paulforrester/horloge-astronomique/docs/decisions.md

# Decisions

Phase 0 deliverable. One record per decision Paul needs to make. Each record gives the options,
the trade-offs and a recommendation. Status is **Proposed** until Paul approves; then it becomes
**Accepted** with the date, and the record is kept, never deleted. Tags as in
`docs/reference-notes.md`.

**As of 31 Oct 2026 every decision D1–D11 is Accepted.** D2, D5 and D11 were decided point by point;
the rest were approved as recommended. **D12** (wooden case) was accepted on 1 Nov 2026.
**D13** (steel springs) was accepted on 3 Nov 2026. **D14** (the shows on legal time) and **D15**
(the procession: astronomy and time, with Urania) were accepted on 4 Nov 2026. **D16** (motors plug in
from behind) was accepted on 5 Nov 2026.

## Summary

| ID | Decision | Recommendation / decision | Status | Needed before |
|---|---|---|---|---|
| D1 | CAD toolchain | **build123d** (Python, pinned), own gear library; OpenSCAD + BOSL2 as fallback | **Accepted** 31 Oct 2026 | Phase 2 |
| D2 | Strasbourg-faithful vs Bordeaux-localized | **Accepted: Strasbourg time** (noon show at 12:29 CET / 13:29 CEST) **plus Bordeaux sky** (horizon 44.83° N, globe on Bordeaux sidereal time). One sub-question on the horizon offset. | **Accepted** 31 Oct 2026 | v1.5 (sky parts) |
| D3 | Controller, drivers, RTC, event motors | **ESP32-S3 + TMC2209 (UART)** for the clock *and* the test rig, all bought new; DC gearmotors for events | **Accepted** 31 Oct 2026 | Phase 2 test rig / Phase 3 |
| D4 | Tooth profile, module, arbors, tubes, bearings | **Involute 20°**, module 1.0 / 0.8 as parameters; Ø3/5/8 ground rod; 0.45 mm-wall brass tubes in 1 mm steps; small standard bearing set | **Accepted** 31 Oct 2026 | Phase 1 |
| D5 | Scope of v1 vs deferred | **Accepted (b)**: v1 has steady-speed Sun and Moon, full Gregorian calendar, planets, Moon globe, sidereal globe and all automata; **v1.5** equations, eclipses, sunrise/sunset; **v2** computus. **Upgrade path required** (architecture §13). | **Accepted** 31 Oct 2026 | Phase 1 |
| D6 | Case construction and mounting | **Aluminium-extrusion module rack inside a birch-ply/MDF case**, printed ornament, hinged glazing; **floor-bearing plinth plus wall restraint** | **Accepted** 31 Oct 2026 | Phase 2 |
| D7 | Computus: faithful vs own design | Defer to v2. **Faithful now looks feasible**: Ungerer (ELS i4–i5) describes the epact snail and the great rack | **Accepted** 31 Oct 2026 | v2 |
| D8 | Sound | **Real small bells struck mechanically**; **rooster: copy Schwilgué's bellows and paper-reed crow** (fully described by Ungerer), with a speaker as fallback | **Accepted** 31 Oct 2026 | Phase 2 (E-modules) |
| D9 | Legal-time hands and summer time | **Separately driven legal-time hands that follow CET/CEST** (M1b) | **Accepted** 31 Oct 2026 | Phase 2 (M1) |
| D10 | Night silence | **Quiet hours in firmware** (skip sound shows). The original already silences the four ages at night [S: DA]. | **Accepted** 31 Oct 2026 | Phase 3 |
| D12 | Case and frame in wood (fine woodworking); revises D6's structure | **Option B**: plywood carcass + hardwood framing; joinery for the table saw, track saw and drill press (no router); MDF for painted surfaces; one species from the low or moderate class (tulipier, sapelli or sipo preferred); metal hidden except the computus frame | **Accepted** 1 Nov 2026 | Phase 2 (case) |
| D11 | Case width (7.70 vs 8.60 m) and wall space | **1:8 accepted (PR #1)**. **Width resolved: 7.70 m → 962.5 mm** [S: ELS, Ungerer 1920]. Wall dimensions to follow from Paul | **Accepted** 31 Oct 2026 | Phase 2 (case) |
| D13 | Springs: steel or printed; catalogue springs in inch-based sizes | **Steel for every spring**; Sodemann's stainless catalogue springs accepted although their sizes are inch-based | **Accepted** 3 Nov 2026 (PR #8) | Phase 2 (M2 purchase) |
| D14 | When the shows run: mean time or legal time (revises D2 item 2) | **Legal time**: the quarters at :15, :30, :45 and :00 of CET/CEST, the noon show at 12:00 | **Accepted** 4 Nov 2026 (Paul, PR #11) | Phase 2 (M1) |
| D15 | The noon procession: Christ and the Apostles, or a personal set | **Astronomy and time**: twelve figures from Pythagoras to Einstein pass **Urania**, on the original's mechanism | **Accepted** 4 Nov 2026 (Paul, PR #11) | Phase 2 (E3) |
| D16 | How a stepper is reached for service | **Plug-in from behind**: each motor on a printed adapter plate, held by 2 × M3 into heat-set inserts; its drive part slides on the D-shaft and is held by stops | **Accepted** 5 Nov 2026 (Paul, PR #13) | every stepper module (M1 and M2 done) |
| D-next (firmware) | Controller and firmware, Phase 3 gate (F1–F10 in `docs/firmware-design.md` §14) | **F2–F10 as recommended**: PCA9685 + DRV8833 event drive (E2 walk on native PWM), RV-3028-C7, phase restored at power-up, separate 6 V motor rail, quiet hours 22:00–07:00 (ages, genie, Death), Arduino IDE / `arduino-cli`, faulted shows off until acknowledged, `sensors:`/`events:` in `spec/clock.yaml`, the simulator plan. F1: a carrier PCB drawn in KiCad, after a bench prototype | **Accepted** 8 Nov 2026 (Paul, PR #19 and chat) | Phase 3 |
| D-next (E1) | The genies: motors, selector, link | **One forward-only gearmotor with a count wheel** (10 strokes, then 10 silent turns that turn the glass); a rigid cross shaft behind M1; the sceptre arm strikes the hand bell; a Scotch yoke, rack and pinion turn the forearms and glass; make-up strokes alone before the next show after a fault | **Accepted** 8 Nov 2026 (Paul, PR #18 and chat) | Phase 2 (E1) |
| D-next (M5–M7) | Mean time: Strasbourg or Bordeaux (revises D2 items 1 and 5) | **Bordeaux mean time**, "the sky over this house"; the shows stay on legal time (D14) | **Accepted** 8 Nov 2026 (Paul, PR #20) | Phase 3 (firmware constant) |

Plus **Blockers** at the end: the network allowlist and the documents to obtain.

---

## D1 — CAD toolchain

**Status: Accepted** (Paul, chat, 31 Oct 2026: "I approve D1, D3, D4 and D6–D10"). The recommendation below is the decision.

**Context.** CAD must be code-based and parametric, run headless in the cloud, export STL/3MF for
Bambu Studio, and produce something SketchUp can open (Paul's trimesh/pycollada → `.dae`
pipeline). Each was verified in this environment on 31 Oct 2026; full results are in
`tools/toolchain-check/README.md`.

| Criterion | A. OpenSCAD + BOSL2 | B. CadQuery | C. build123d |
|---|---|---|---|
| Installs and runs headless here | ✔ apt 2021.01; BOSL2 via git | ✔ pip (CadQuery 2.8) | ✔ pip (0.13, OCP 8.0.1) |
| Installs on an Apple Silicon Mac | ✔ (official macOS builds) | probably: `cadquery-ocp` 8.0.1 has arm64 wheels, but the OCP version CadQuery 2.8 pins was not checked | ✔: `cadquery-ocp-novtk` arm64 wheels on PyPI for Python 3.11–3.14 (checked) |
| STL / 3MF | ✔ / ✔ | ✔ / single shape only | ✔ / ✔ (several named parts) |
| STEP (for CNC or laser-cut case parts, sharing) | ✘ | ✔ | ✔ |
| Exact interference check (rule: "report intersecting volumes") | mesh only | ✔ B-rep | ✔ B-rep: 0.0000 mm³ when correct, 19.78 mm³ when the centre distance is 1 mm short |
| `.dae` with named nodes | via STL + Python | ✔ Python | ✔ Python (verified) |
| Gear library | **BOSL2 gears: mature; backlash, profile shift, racks, worms, bevels, ring gears** | none in core (`cq_gears` is not on PyPI) | `bd_warehouse` spur gears, **no backlash parameter**, so we write our own |
| Speed (60/15 gear pair) | 7.8 s (CGAL) | — | 1.6 s |
| Speed (269 teeth + 6 holes) | 16 s | — | 27 s |
| Same language as the ratio tool, simulator and DAE pipeline | ✘ | ✔ | ✔ |
| Paul's experience | ✔ (word clock) | Python ✔ | Python ✔ |
| Maturity | stable but slow release cycle | stable | active; 0.x API still changes, so pin versions |

**Recommendation: C (build123d)**, pinned in `requirements.txt`, Python 3.12+.

- **Why.** One Python codebase reads `spec/clock.yaml`, generates the parts, runs the exact
  interference and bed-fit checks, and writes STL, 3MF, STEP and DAE. The ratio tool and simulator
  live in the same language.
- **The cost.** We write `cad/lib/gears.py`: involute with backlash as tooth thinning, profile
  shift, internal and rack forms; about a day's work in Phase 2. It is validated tooth-by-tooth
  against BOSL2's output, which is installed here for exactly that.
- **Never install CadQuery and build123d in the same environment.** Their OCP builds conflict
  (`ImportError: TColgp_HArray1OfPnt`, verified).
- **Fallback: A.** OpenSCAD + BOSL2 is the quickest route to good gears and Paul knows it. It loses
  STEP and exact interference volumes and splits the codebase in two languages.

---

## D2 — Strasbourg-faithful vs Bordeaux-localized

**Context.** The gear trains are identical either way. Localization changes only:

1. **The mean-time offset.** A firmware constant (the stepper phase). Strasbourg: LMT = UT +
   31.00 min, so mean noon is 12:29 CET. Bordeaux: UT − 2.28 min, so mean noon is 13:02 CET /
   14:02 CEST [D].
2. **When the automata run.** They follow mean time, so this follows (1). The original runs on
   Strasbourg mean time [Sn: CATH].
3. **The sunrise/sunset cam profile.** A printed part made from latitude φ: Strasbourg about
   48.58° N, Bordeaux 44.83° N.
4. **The celestial globe's horizon ring tilt.** A printed part, or an adjustable one.
5. **The legal-time offset.** Mean time to CET is 29.0 min for Strasbourg, 62.3 min for Bordeaux
   [D].

| Option | For | Against |
|---|---|---|
| A. Faithful Strasbourg | The famous "12:30" noon show; replica in the strict sense | Sunrise/sunset and globe are wrong for the room; the local sky is the point of the instrument |
| **B. Bordeaux-localized** | Shows the truth where it hangs. Precedent: R. B. Smith localized his 1:5 model to Sydney [S: WIKI, PH]. | Noon show at 13:02 CET / 14:02 CEST, not 12:30 |
| C. Mixed (Strasbourg times, Bordeaux sky) | — | Inconsistent; not recommended |

**Recommendation: B.**

**Revised by D14 (4 Nov 2026):** item 2 no longer applies. The automata follow legal time, and the
noon show is at 12:00 CET/CEST.

- The dial lettering and appearance follow the original.
- Items 3 and 4 are swappable printed parts generated from φ, so a Strasbourg set can be printed
  later.
- Item 1 is a single firmware constant.

**Question for Paul:** is the 12:30-ish noon show important to you? If so, choose A for time and
consider B for the sky (which is C).

**Paul's input (PR #1 comment, 31 Oct 2026):** "The noon show is important."

Read as: keep the show at Strasbourg's time. **Items 1, 2 and 5 are therefore Strasbourg.**

- Mean time = UT + 31.00 min.
- Noon show at 12:29 CET / 13:29 CEST.
- Legal-time offset 29.0 min [D].

**Revised recommendation for items 3 and 4: A (fully Strasbourg).** Once the dials run on
Strasbourg mean time, sunrise/sunset times and a globe horizon for Bordeaux on those dials would be
a mixture (option C). That is harder to read and to validate.

**Paul's decision (chat, 31 Oct 2026):** "I'd prefer to use the Bordeaux sky as the reference
point."

**Status: Accepted, option C.** Time is Strasbourg (items 1, 2, 5); the sky is Bordeaux (items 3, 4).

**What "Bordeaux sky" means in the design:**

- **Sunrise/sunset (I7).** The mobile horizon (Schwilgué's own device [S: DA p. 31]) is computed for
  φ = 44.83° N, with refraction, as the original does for Strasbourg.
- **Celestial globe (I16).** The horizon ring is tilted for 44.83° N. The globe's rotation phase is
  set to **Bordeaux local sidereal time**, which is Strasbourg's minus 33.3 min [D: longitude
  difference 8.32°]. This is only M6's setting offset: no gear changes. The globe then shows the
  sky actually above the house.
- **Sub-question for Paul.** The main dial runs on Strasbourg apparent time. Do you want the mobile
  horizon:
  - **(i)** symmetric about the dial's noon, so it reads Bordeaux day length in local solar time;
    or
  - **(ii)** turned by the 33.3 min longitude difference, so the Sun hand crosses it at the moment
    the Sun really rises and sets in Bordeaux?

  **Recommendation: (ii)**, because the Sun hand above the horizon then means "the Sun is up
  outside". It is one fixed angle in the linkage, so the choice can wait until v1.5.

  **Paul's decision (chat, 31 Oct 2026): (ii).** The horizon is offset by the longitude
  difference of 33.3 min [D]. **Accepted.**

---

## D3 — Controller platform, stepper drivers, RTC, event motors

**Status: Accepted** (Paul, chat, 31 Oct 2026: "I approve D1, D3, D4 and D6–D10"). The recommendation below is the decision.

**Context.**

- 4 steppers in v1, up to 6 later (architecture §3).
- 5–6 one-direction event motors.
- About 27 digital inputs.
- RTC, FRAM, Wi-Fi/NTP, and MQTT for Home Assistant.

Step rates are very low (about 1 Hz running, a few kHz catching up).

| Option | For | Against |
|---|---|---|
| **A. ESP32-S3 + TMC2209 stepsticks (UART) on a carrier**, with 2 × MCP23017 I/O expanders | One MCU; Wi-Fi, NTP and MQTT built in; Paul knows ESP32; plenty of capacity; low power | Needs a carrier board: off-the-shelf or a custom PCB (Phase 3). TMC2209 UART has 4 addresses per bus, so 6 drivers need 2 buses. |
| B. Raspberry Pi + motion board (BTT SKR Pico: RP2040, 4 × TMC2209; or Octopus: 8 drivers) with custom firmware | Robust 24 V power stages, connectors, MOSFET outputs; Linux for UI and logging | Two computers to maintain; SD-card wear; STM32duino has no stock Octopus variant, so a custom one is needed [Sn] |
| C. Arduino Mega + RAMPS 1.4 + TMC2209 | 5 driver sockets; endstop inputs; 3 MOSFETs | No network (no NTP or Home Assistant); 8-bit; awkward TMC2209 UART wiring on RAMPS; only 5 drivers. Its only advantage, reusing parts Paul already owns, is dropped: the BOM buys everything new (PR #1). |
| D. Printer board standalone (Octopus / Spider / Manta, 8 drivers) + ESP32 for the network | 8 drivers and a power stage on one board | Same two-MCU complexity as B; firmware support for a non-printer use is DIY |

**Recommendation.**

- **A for the clock.** Firmware has a board-independent motion core (P1 time law, events, FRAM
  state) plus a thin board layer.
- **The Phase 2 test rig uses the same platform.** An ESP32-S3 dev board and one or two TMC2209s
  from Batch 1 of the BOM. Those parts later move into the clock, so the firmware is exercised on
  the real target from the first print.
  - The earlier "Mega + RAMPS for the test rig" recommendation is withdrawn after Paul's PR #1
    comment: no parts from other projects.
- **Drivers:** TMC2209 in StealthChop, with low hold current (quiet in a living space).
- **RTC:** RV-3028-C7 with a supercapacitor (about ±1 ppm [Sn]), or a DS3231 (±2 ppm [Sn]). If a
  DS3231 module is used, remove or disable its charging diode when fitting a non-rechargeable
  CR2032 [Sn].
- **FRAM:** I²C, 32–256 kbit.
- **Event motors:** small DC gearmotors (Pololu micro-metal class, e.g. 100:1 [Sn]), each with a
  locking-cam microswitch and a DRV8833-class H-bridge. This is the electrical analogue of a
  striking train.
  - Alternative: 28BYJ-48 steppers on TMC2209. They are smoother and quieter but use 6 more
    drivers.
  - Decide per show in Phase 2 after a noise test.

---

## D4 — Gear tooth profile, default module, arbors, coaxial tubes, bearings

**Status: Accepted** (Paul, chat, 31 Oct 2026: "I approve D1, D3, D4 and D6–D10"). The recommendation below is the decision.

**Tooth profile.**

| Option | For | Against |
|---|---|---|
| **Involute 20° (ISO 53 basic rack)** | Tolerant to centre-distance error (printed plates); standard; BOSL2 reference for validation; works in both driving directions | Undercut below 17 teeth without profile shift |
| Cycloidal (horological, e.g. NIHS / BS 978) | Traditional; good for wheel-drives-pinion step-ups with low-count pinions | Sensitive to centre distance; little printed-gear precedent; harder to validate |

**Faithfulness note:** Schwilgué's teeth are **epicycloidal**. He built "une machine servant à
déterminer automatiquement la forme épicycloïdale des courbes des dents" [S: ELS i5]. The replica
still uses involute, for the printing and centre-distance reasons above. This is a deliberate
deviation, invisible behind the dials.

**Recommendation: involute 20°**, with these parameters:

- profile shift for z < 17;
- minimum pinion 10–12 teeth (shifted);
- backlash 0.15 mm as a parameter, applied as tooth thinning split between the mates;
- face width 4 mm by default and 6 mm in the motor stages, as parameters.

**Default module.** Use `CLAUDE.md`'s working defaults as parameters: **1.0** with the 0.4 mm nozzle,
**0.8** with the 0.2 mm nozzle.

- Use 0.8 where density demands it (main dial, planetary coaxials) and 1.0–1.25 in the motor
  reductions.
- The real minimum comes from the local tolerance test.
- Largest wheel that fits the bed [D], before brim margin:

| Bed axis | Module 1.0 | Module 0.8 |
|---|---|---|
| 320 mm (single nozzle) | 318 teeth | 398 teeth |
| 300 mm (dual nozzle) | 298 teeth | 373 teeth |

- Schwilgué's 269- and 270-tooth wheels fit at 1.0: 271–272 mm tip.
- 382- and 420-tooth wheels need module ≤ 0.8 or a segmented rim.

**Arbors** (metric ground rod; few sizes, to consolidate purchases).

- **Ø3** for light and dial trains, **Ø5** general, **Ø8** for motor reductions and large outputs.
- Silver steel to DIN 175 is ground to **h9** [Sn: DIN]; that is fine for plain bearings and
  printed hubs.
- Where a tighter fit is needed, use linear shafting: g6 below 6 mm, h6 from 6 mm [Sn: MISUMI].
- EU source: Ameco (CZ) [Sn]. The UK sellers (Thomas Graham) add post-Brexit customs.

**Coaxial tubes.** Brass tube with **0.45 mm wall in 1 mm OD steps** (e.g. Albion Alloys BT3M…BT10M
[Sn]; Conrad 6, 7 and 9 mm [Sn]). Each tube's ID is n − 0.9 mm, so the next size down slides inside
with **0.10 mm diametral clearance** [D].

- So a Ø3 arbor carries up to 7 coaxial tubes, out to Ø10 mm.
- Brass on brass with clock oil at these speeds is the traditional clockmaking practice.
- Larger coaxial groups (calendar ring, planet arms beyond 7) run on thin-section bearings with
  printed hubs.
- Albion has no French stockist yet, only UK and one DE eBay seller [Sn]. Confirm EU supply before
  Phase 2.

**Bearings** (standard set).

| Use | Bearings |
|---|---|
| Ø3 arbors | MR63ZZ, 3×6×2.5 |
| Ø5 arbors | MR85ZZ (5×8×2.5) or 685ZZ (5×11×5) |
| Ø8 arbors | 688ZZ, 8×16×5 |
| Large coaxial outputs | 6700-series (10×15×4 … 20×27×4) or thin-section 61806 (30×42×7) and 61808 (40×52×7) [Sn] |
| Slow arbors | Plain bearings: sintered bronze to ISO 2795 [Sn], igus iglidur sleeves [Sn], or brass tube on steel |

- Design bearing seats from **measured** parts: cheap MR85s have measured 7.93 mm OD rather than
  8.00 [Sn]. This goes into the local tolerance phase.

**Fasteners.**

- Stainless A2, M3 by default; M2 and M2.5 for small parts; M4 and M5 for structure.
- Screws to ISO 4762, 14580 and 7380.
- Brass heat-set inserts (ruthex M2–M5 [Sn]).
- Hubs on rods: clamping hubs with an insert and screw. Press-fit and retaining-compound variants
  go into the tolerance test.

---

## D5 — Scope: v1 vs deferred

| Version | Contents | Why |
|---|---|---|
| **v1** | M1 time and releases (I1, I2); M2 main dial with **mean** Sun and Moon, shadow disc, calendar ring with automatic leap day (4-year rule), weekday carousel; M5 planets and Moon globe; M6 sidereal globe; all automata E1–E4 | A complete, running clock with every visible motion |
| **v1.5** | M3 equations vitrine → apparent Sun and true Moon; eclipse arm (I5); sunrise/sunset (I7) | They depend on M3 and the main-dial feasibility study. The v1 main dial *provisions* them: differentials locked, tubes reserved, cam positions free. |
| **v2** | M4 computus + E5; movable feasts arc (I9); dominical-letter drive (I10); Gregorian century leap exception (next one in 2100); precession drive (I17) | The computus mechanism is undocumented (D7) and is the biggest single design task. The precession is nearly static (about 1.4° per century [D]). |

**Recommendation:** as above, with one change after research pass 3. **The Gregorian century
rule moves into v1.** Schwilgué's calendar applies it with a small, self-contained wheel C (1/100 turn
per year, 24 projections, plus a satellite wheel for the 400-year case) [S: ELS i4]. It costs little
and keeps the calendar correct beyond 2100 without the computus.

- The **main-dial feasibility study** (Phase 2) must still include every v1.5 and v2 element, so
  nothing is designed out.
- **Question for Paul (rephrased after PR #1):**

  **Background.** The real Sun and Moon do not move across the sky at a steady speed. A sundial
  runs up to about 16 minutes fast or 14 minutes slow over the year (the "equation of time"). The
  real Moon can be about 6° ahead of or behind its average position. Schwilgué corrects both with
  the cams in the "equations" vitrine, so his main dial shows the *true* Sun and Moon.

  **The choice:**
  - **(a) Corrections in the first working version.** The main dial is right from day one, but
    the first working clock arrives later, because the equations vitrine (M3) must be designed and
    printed first.
  - **(b) Steady (average) speeds first.** The first working version has the Sun and Moon hands
    moving at steady speeds. The main dial is built from the start with the slots for the
    corrections, and the equations vitrine is added in v1.5 without rebuilding anything. The
    first working clock comes sooner.

  **Recommendation: (b).** Which do you prefer?

**Paul's decision (chat, 31 Oct 2026): (b), steady speeds first,** "but ensure that the design
allows for the module to be adapted without scrapping too much to add more precision later".

**Status: Accepted, with a binding upgrade-path requirement.** The v1 design must meet the
provisions in `architecture.md` §13. In short:

1. Both main-dial hands are driven through their **differentials from day one**. In v1 the
   correction input is locked at zero by a removable key.
2. The **correction-input interface is fixed now**: shaft size, coupling, location and gain. M3 can
   then be designed or redesigned later without touching M2.
3. The **space, rails, wiring and driver channel for M3 are reserved** in the case and the
   electronics.
4. M3 is designed as **stacks with spare cam positions**, so more terms can be added later without
   rebuilding.
5. **Internal gear trains are swappable cassettes** behind fixed module interfaces, so any train
   can later be replaced by a more precise one without rebuilding the module.

---

## D6 — Case construction and mounting

**Status: Accepted** (Paul, chat, 31 Oct 2026: "I approve D1, D3, D4 and D6–D10"). The recommendation below is the decision. Wall material and dimensions are still to come from Paul; the fixing design follows them.

**Revision proposed (1 Nov 2026):** Paul wants the frame built in wood (fine woodworking), so the
*structure* part of this decision (option B, the aluminium-extrusion rack) is reopened in **D12**.
The *mounting* part (floor plinth plus wall restraint) and the glazing stand until D12 is decided.

**Context.**

- Estimated envelope 2.25 × ~1.0 × ~0.25 m. Depth TBD: at least 200 mm interior planned
  (envelope §1).
- Mass about 78–103 kg [E, envelope §5].
- Stone wall; enclosed, climate-controlled room; glazed front.

**Structure.**

| Option | For | Against |
|---|---|---|
| A. Birch-ply box, modules screwed to shelves | Cheap, classic woodwork | Module alignment depends on the woodwork; less serviceable |
| **B. Aluminium-extrusion module rack (20 × 20 / 20 × 40 metric profile) inside a birch-ply / MDF case**, with printed ornament | Precise, square, adjustable mounting for modules (P4); the wood is decorative and can be built later; wiring clips onto the slots | Two structures; extrusion cost |
| C. Fully printed case tiles | All in-house | Hundreds of print-hours, weaker, joint lines; wasteful for flat panels |

**Mounting.**

| Option | For | Against |
|---|---|---|
| (i) Wall-hung on a French cleat with chemical anchors in stone | "Wall art"; floor free | About 100 kg in shear and pull-out on anchors in stone of unknown quality; needs a fixing-design check |
| **(ii) Floor-bearing plinth + wall restraint brackets** | The floor carries the weight; the anchors only prevent tipping; easy to level | Uses floor space (a plinth about the case footprint) |

**Recommendation: B + (ii).**

- MDF for painted flat surfaces, birch ply for structure.
- Printed PLA ornament; PETG for clamped or structural printed parts.
- Hinged glazed doors per stage. Acrylic (about 8 kg) rather than glass (about 22.5 kg) for the
  front [D], with brush or foam dust seals.
- **Question for Paul:** what is the wall made of (e.g. Bordeaux limestone, rubble), and is a
  plinth acceptable?

---

## D7 — Computus: faithful reconstruction vs our own mechanical design

**Status: Accepted** (Paul, chat, 31 Oct 2026: "I approve D1, D3, D4 and D6–D10"). The recommendation below is the decision.

**Context.**

- Schwilgué's computus is an enlarged version of his 1821 prototype [S: RGL]. The prototype is
  about 300 parts [Sn: EXO].
- Its full study is unpublished [S: RGL].
- How it makes the Gregorian corrections and finds Easter is undocumented in every source reached
  so far.

| Option | For | Against |
|---|---|---|
| A. Faithful reconstruction | Authentic | Needs sources not yet available (Roegel's study, Flores 2007, Bach/Rieb); may never be complete |
| B. Our own mechanical Gregorian computus (count wheels, century wheels, rack-and-snail Easter finder), same displays | Can start any time; validated against a standard algorithm over 400 years in the simulator; still fully mechanical (rule 2) | Not Schwilgué's mechanism |

**Recommendation:** defer to v2 (D5) and buy or borrow the Flores 2007 book in the meantime.

**Update (research pass 3):** Ungerer's 1920 lecture (ELS i4–i5) describes the computus in some
depth:

- the epact disc with a stepped snail, 4 mm per step, covering 21 March–18 April;
- piece N and cam x, on the golden-number arbor, for the epact XXV/25 rule;
- the great rack R that reads the snail;
- the Easter-dependent feasts carried on an iron circle on rollers.

So **option A (faithful) is now realistic for v2**, filling any gaps from Flores (2007) and Bach/Rieb.

- If, when v2 starts, the mechanism is still undocumented, choose **B**, with the same displays
  and the same once-a-year New Year's Eve operation.
- In both cases, design the v1 calendar ring with the feasts-arc groove and the leap gate
  (inventory I8, I9).

---

## D8 — Sound

**Status: Accepted** (Paul, chat, 31 Oct 2026: "I approve D1, D3, D4 and D6–D10"). The recommendation below is the decision.

**Context.** The original strikes real bells, and the rooster is mechanical and pneumatic
[S: CLEA]. The replica is in a living space.

| Option | For | Against |
|---|---|---|
| **Real small bells, cam-lifted hammers (bell angel, ages, Death)** | Faithful; mechanical; pleasant | Bell sourcing and tuning; volume set by the hammer |
| Bells via solenoids | Simple | Not a mechanical event train; clicky |
| Rooster: bellows and reed driven by the E4 train | Faithful in spirit | Hard to make sound like a rooster; development time |
| **Rooster: speaker plus a recording (DFPlayer-class), cued by the E4 train switch** | Convincing, volume-controllable | Not mechanical |
| No sound | Silent | Loses much of the charm |

**Update (research pass 3):** the original crow is fully described [S: ELS i5]. It sits under the
crown:

- a weighted bellows, inflated by a wire and released suddenly;
- a **paper-strip reed**, kept taut by a spring;
- a trumpet aimed at the rooster;
- a cam-controlled exhaust valve that makes the crow fall from strident to low.

All of it is mechanical and small.

**Revised recommendation:** mechanical bells; **build Schwilgué's bellows-and-reed crow** in v1,
driven by the E4 event train (a good local-phase prototype). Keep a speaker only as a fallback if
the 1:8 bellows cannot make a convincing sound.
Quiet hours apply to both (D10).

---

## D9 — Legal-time hands and summer time

**Status: Accepted** (Paul, chat, 31 Oct 2026: "I approve D1, D3, D4 and D6–D10"). The recommendation below is the decision.

**Context.** The original's silver hands show CET [S: WIKI]. Whether they follow summer time is
unresolved [?]. A forward-only drive can still follow summer time: +1 h in spring, +11 h in autumn
on a 12 h dial, run at catch-up speed in seconds.

| Option | For | Against |
|---|---|---|
| A. Fixed CET (offset hands on M1) | Simplest; no extra motor | Wrong by 1 h for 7 months a year |
| **B. Own stepper M1b following CET/CEST** | Always right; useful as the house clock | One more stepper and a coaxial drive on the mean-time dial |
| C. No legal-time hands | Simplest | Less useful; less faithful |

**Recommendation: B.** The automata stay on mean time regardless.

**Faithfulness note:** the original's legal-time (silver) hands were "ajoutées en Mars 1919"
[S: ELS i1]. They are not Schwilgué's, so adding a summer-time drive does not depart from his
design.

---

## D10 — Night silence

**Status: Accepted** (Paul, chat, 31 Oct 2026: "I approve D1, D3, D4 and D6–D10"). The recommendation below is the decision.

| Option | For | Against |
|---|---|---|
| A. Always strike | Faithful | Quarter strikes all night in a living space |
| **B. Configurable quiet hours: the controller skips sound shows** | Simple. P2 (state lives in the trains) makes skipping safe. | Figures do not move at night |
| C. Mechanical strike/silent levers (figures move, hammers held off) | Figures still move | One actuator per bell train |

**Recommendation: B**, configurable from Home Assistant, with C as a later option.

**Supporting evidence:** this is original behaviour. Schwilgué's central motor produces "la
suspension des fonctions des quatre âges pendant la nuit et la reprise de leur marche durant le
jour", while Death strikes the hours day and night [S: DA p. 58, 65]. So the minimal faithful setting
is to silence the four ages at night. The firmware option extends that to the other bells.

---

## D11 — Case width and wall space

**Context.** `CLAUDE.md` targets 0.96 m (7.70 m ÷ 8). New evidence [Sn: WIKI] suggests 7.70 m may
be the *first* clock's width. ODY's 8.60 m is given for the second clock, whose case is the
current one (reference-notes, Phase 0 additions).

| Option | Size |
|---|---|
| A. 1:8, 7.70 m | 2250 × 962.5 mm |
| B. 1:8, 8.60 m | 2250 × 1075 mm |
| C. Keep the width at 0.96 m by changing the scale to 1:9 (if 8.60 m is right) | 2000 × 956 mm; main dial 255.6 mm |

**Recommendation.**

1. Resolve the source first: read ELS and check Bach/Rieb.
2. Make **scale a parameter** in `spec/clock.yaml`, so no module design depends on it.
3. **Paul gives the available wall width, height and ceiling height.**

The choice can then wait until case design (Phase 2) without blocking anything.

**Paul's input (PR #1 comment, 31 Oct 2026):** "1:8th scale is not a problem." Wall dimensions
to follow.

**Source resolved (research pass 3):** "l'ancien édifice, construit en pierres de taille, de 7m,70
de largeur à la base, et de 18 mètres de hauteur, le couronnement gothique compris" [S: ELS i1,
Ungerer]. **The width is 962.5 mm at 1:8**, as `CLAUDE.md` assumed.

- **Status: Accepted. The scale is fixed at 1:8.** Option C (1:9) is dropped.
- The case width will be 962.5 mm or 1075 mm, whichever the primary source supports.
- Scale stays a parameter in `spec/clock.yaml` for tidiness, but no module needs to allow for
  another scale.

---

## D12 — Case and frame in wood (fine woodworking)

**Status: Accepted, option B** (Paul, PR #2 comment, 1 Nov 2026). It revises the structure part of D6. The answers to the questions and the resulting refinements are in "Decision and refinements" at the end of this record.

**Context.**

- Paul (1 Nov 2026): "I like the idea of 3d printing parts internally and for some visible parts,
  but I'd like to also look at building the frame out of wood (both sheet goods and hardwood are
  acceptable materials for this)."
- The original case is dressed stone: "l'ancien édifice, construit en pierres de taille"
  [S: ELS i1]. It is decorated with Tobias Stimmer's paintings and carved figures [S: DA p. 29,
  48, 61]. A wooden case is therefore an interpretation, chosen for the room and the maker.
- The gear meshes must stay precise. The wood must never set gear centre distances.

**Options.**

| Option | For | Against |
|---|---|---|
| A. Keep D6 as accepted: aluminium-extrusion module rack inside a decorative wooden case | Most precise and adjustable; wood purely decorative | Two structures; metal where Paul wants wood; least "fine woodworking" |
| **B. Plywood carcass as the structure, with hardwood framing, mouldings and doors** | Birch plywood is cross-laminated and stays flat and square, so it carries the modules. Hardwood goes where it shows: face frame, pilasters, cornices, frame-and-panel sides, door frames. A real woodworking project with predictable behaviour. | Module mounts must be adjustable (see design rules). More design work than A. |
| C. Solid-hardwood post-and-beam frame and panels throughout | The most "fine furniture" | Solid wood moves with humidity across its width. The most work and the most care needed to keep module mounts true. Heavier. |

**Recommendation: B.** Design rules:

1. **Precision stays inside the modules** (P4, P6). Each module is self-contained between its own
   printed or metal plates. The wood only *holds* modules; it never forms part of a gear train.
2. **Three-point adjustable mounts.** Each module sits on two locating pins, one round and one
   slotted, plus a third clamped fixing in a slot. The fixings go into threaded inserts set in the
   plywood shelves. So:
   - a module drops back into exactly the same place after servicing;
   - seasonal wood movement cannot strain it.
3. **Couplings between modules tolerate misalignment.** The shafts that cross module boundaries
   (M3→M2, M2→M7, M1→E2; architecture §4) use keyed, single-position couplings that also allow
   radial and angular float. Phase 2 sets the float, with a design target of about ±1 mm.
4. **Wood-movement rules for the hardwood parts.**
   - Frame-and-panel construction for every wide surface, with the panels floating in grooves.
   - No hardwood glued cross-grain to plywood over a wide span.
   - Quarter-sawn or rift-sawn stock where width matters.
   - The climate-controlled room helps, but these rules still apply.
5. **Sheet goods.** Birch plywood for the carcass, shelves and torsion-box plinth; MDF only for
   painted flat parts or routed profiles.
6. **Serviceability** (`CLAUDE.md`):
   - removable back panels on every stage;
   - hinged glazed front doors;
   - the wiring riser in the staircase tower, with channels routed in the carcass;
   - the electronics bay in the weight tower, ventilated, with a removable door.
7. **Ornament.**
   - **Routed or moulded hardwood** for cornices, pilasters and mouldings.
   - **3D-printed** (then painted or gilded) for Gothic tracery, pinnacles, finials, crockets and
     small figures.
   - Carved or CNC wood is optional for larger ornaments, depending on the tools available (see
     questions).
8. **Mounting.** D6 (ii) stands: a floor-bearing plinth plus a wall restraint. The mass will be
   re-estimated from the case model, since hardwood is heavier than the earlier ply-only estimate.
9. **Deliverables (cloud sessions).** A parametric case model in build123d (`cad/case/`), with:
   - joinery details;
   - cut lists and plywood sheet layouts;
   - DXF/SVG profiles for templates or CNC;
   - STEP files.

   The physical woodworking is done locally.

**Questions for Paul.**

1. **Workshop.** Which tools do you have? For example: table saw or track saw, router and router
   table, planer-thicknesser, jointer, bandsaw, CNC router, lathe for finials. The answer sets the
   joinery, and how much ornament is wood versus printed.
2. **Finish.** Natural hardwood (a cabinetmaker's interpretation), or painted to evoke the
   original's stone and painted panels, or a mix such as a natural frame with painted panels?
3. **Species.** Any preference among hardwoods readily found in France? For example oak (chêne),
   walnut (noyer), cherry (merisier), beech (hêtre), ash (frêne). The answer affects colour,
   weight and how well fine detail can be routed.
4. Under B the aluminium rack disappears entirely. Is that what you want, or would you keep a
   hidden metal sub-frame behind the main dial only?

### Decision and refinements (Paul, PR #2 comment, 1 Nov 2026)

Paul's answers (quoted, with typos corrected):

1. "I accept the D12 recommendation for option B."
2. Workshop: "tablesaw, tracksaw, drill press, planer, drum sander, miter saw and hand tools and
   chisels".
3. Finish: "painted and finished to resemble original".
4. Species: "any of the species are acceptable so long as they have similar expansion qualities.
   I'll be sourcing hardwoods in Bordeaux, so species should be available from local vendors."
5. Metal: "keep the metal frame elements hidden where possible. The exception being the Easter
   calculator."

**Revised rules.** They replace rules 4 and 7 above where the two differ; the other rules stand.

**R1 — Joinery for the workshop as it is.** There is no router, jointer, bandsaw, CNC or lathe.

| Task | How |
|---|---|
| Stock | Buy planed all round ("raboté 4 faces"), or straighten edges with a track-saw or table-saw jig and then thickness on the planer. The drum sander handles stock thinner than the planer allows. |
| Carcass | Birch plywood broken down with the track saw; dadoes and rabbets cut on the table saw in several passes. Check whether the saw takes a dado stack (many European saws do not). Glue and screw. |
| Frames | Mortise-and-tenon: tenons on the table saw; mortises bored on the drill press with Forstner bits and squared with chisels. Dowelled joints using printed drilling jigs are an alternative. Bridle joints on the table saw. Mitres on the mitre saw. |
| Frame-and-panel | Grooves on the table saw. Panels are flat MDF or plywood (painted), or table-saw-bevelled raised panels where one is wanted. |
| Mouldings (no router) | Built up from simple table-saw profiles (rips, bevels, coves cut by passing across the blade at an angle), laminated and stacked. Supplemented by stock mouldings from the merchant. Complex Gothic profiles are 3D-printed and painted. |
| Ornament | 3D-printed and painted or gilded: tracery, crockets, pinnacles, finials (no lathe), figures. Chisel carving is optional for a few details, in lime (see R3). |
| Precision holes | The module mounts (rule 2) are drilled on the drill press through **3D-printed drilling templates generated from the case CAD**, so every insert and locating pin lands where the model says. |

**R2 — Finish: painted to resemble the original.** The original case is dressed stone with painted
panels [S: ELS i1; DA].

- Use **MDF for most flat painted surfaces**: it is stable and paints well.
- Use hardwood where edges and joints need strength, and where moving parts or doors bear on the
  wood.
- Prime every surface. Open-grained or tannin-rich woods such as oak need grain filling and a
  stain-blocking primer before a smooth painted finish.
- The decorative painting itself (faux stone, Stimmer-style panels) is local work and outside the
  cloud sessions (`CLAUDE.md`).

**R3 — Species: one movement class, from local stock.** Movement across the width is driven
mostly by tangential shrinkage (T), and distortion by the T/R ratio.

Sourced values, green to oven-dry, from The Wood Database, which compiles them from cited
references [S, secondary]. Retrieved 1 Nov 2026 from `https://www.wood-database.com/<species>/`.

| Class | Species (French name) | Radial % | Tangential % | T/R | Density at 12 % MC, kg/m³ |
|---|---|---|---|---|---|
| **Low movement** | utile / sipo (*Entandrophragma utile*) | 4.9 | 6.9 | 1.4 | 635 |
| | sapele / sapelli (*E. cylindricum*) | 5.2 | 7.2 | 1.4 | 665 |
| | lime / tilleul (*Tilia* spp.) | 5.0 | 7.5 | 1.5 | 535 |
| | walnut / noyer (*Juglans regia*) | 5.5 | 7.5 | 1.4 | 640 |
| **Moderate** | yellow-poplar / tulipier (*Liriodendron tulipifera*) | 4.6 | 8.2 | 1.8 | 455 |
| | aspen / tremble (*Populus tremula*) | 4.8 | 8.3 | 1.7 | 450 |
| | pedunculate oak / chêne pédonculé (*Quercus robur*) | 4.7 | 8.4 | 1.8 | 675 |
| **Higher, or uneven** | black poplar / peuplier noir (*Populus nigra*) | 4.0 | 9.3 | 2.3 | 385 |
| | ash / frêne (*Fraxinus excelsior*) | 5.7 | 9.6 | 1.7 | 680 |
| | sessile oak / chêne rouvre (*Quercus petraea*) | 4.5 | 9.7 | 2.2 | 710 |
| | hornbeam / charme (*Carpinus betulus*) | 6.8 | 11.5 | 1.7 | 735 |
| | beech / hêtre (*Fagus sylvatica*) | 5.8 | 11.7 | 2.0 | 710 |

**Rule.**

- Use **one species** for all structural hardwood. If two species are glued together, take both
  from the same class.
- **First choice (paint-grade, low or moderate movement, machines well): tulipier, sapelli or sipo,
  whichever a Bordeaux merchant stocks planed.**
- Oak (chêne) is acceptable if that is what is available, but needs the grain and tannin
  preparation in R2.
- **Avoid beech, hornbeam, ash and black poplar** for frames and wide parts.
- Lime is the carving wood, for any chisel-carved details.
- Local availability is **TBD** (Paul sourcing in Bordeaux). An initial search found Gironde
  merchants but no confirmed stock list for any species [Sn].

**In-service movement estimate [E].** Width change ≈ W × T × ΔMC / FSP, where FSP ≈ 28 % is the
fibre saturation point. This is the standard linear approximation; verify against the Wood
Handbook (USDA FPL GTR-282, ch. 4).

- Assume moisture content varies by ±2 % in the climate-controlled room (an estimate, to be
  confirmed with a hygrometer in the room).
- Then a 100 mm flat-sawn board moves about ±0.5 mm in sapelli, ±0.6 mm in tulipier or pedunculate
  oak, and ±0.8 mm in beech.
- Hence the floating panels, and the slotted third fixing on every module mount (rule 2).

**R4 — Metal: hidden where possible; the computus is the exception.**

- Hidden metal is allowed where wood or print is not enough: for example a flat-bar stiffener
  behind the main dial, inserts, pins and brackets.
- **The computus (M4) gets a visible metal frame**, brass or steel plates and pillars, displayed in
  its vitrine. The original's computus train is on view: "Dans celle de gauche, on aperçoit le
  rouage du comput ecclésiastique" [S: ELS i1].
- Its gears remain printed (rule 1 in `CLAUDE.md`). Their finish, for example brass-toned, is a v2
  choice.
- The aluminium-extrusion rack of D6 option B is **not used**.

### Refinement R5: the clock works are printed and independent of the case (Paul, PR #5, 3 Nov 2026)

Paul: "I'd prefer to have the clock works printed where possible, even if that means connecting
multiple plastic pieces. I'm okay using model grade plywood internally as well if size and/or
strength would prohibit the use of 3d printed parts. The point is that I want the clock works to be
independent of the external decorative case. Bottom line. Print if possible, otherwise use model
grade plywood."

- **The works form their own structure.** That covers every module's plates, carriers, brackets and
  the internal frame that holds the modules together. It is printed, from several pieces bolted or
  spliced where one print is too large.
- **Model-grade plywood is only the fallback**, where size or strength rules out a print. Each such
  part is named, with the reason, in its module's design note.
- **The decorative case surrounds the works and never carries them.** Rules 1–3 still apply between
  the works and whatever finally bears the load (the plinth and wall restraint of rule 8): located,
  three-point, slotted.
- **First use: M2.** Its calendar carrier is a printed frame of 4 PETG segments with an L-section
  rim, bolted to the M2 front plate. It has mounting tabs for the works' frame and needs no plywood
  (`docs/m2-design.md` §6).
- **Files.** Every printed part gets an STL or 3MF that Bambu Studio imports, in its print pose
  (`cad/export_print.py`, `export/print/`). Every SketchUp model also gets an exploded copy where
  that is meaningful (`cad/export_sketchup.py`).

## D13 — Springs: steel, and an exception to the metric rule for catalogue springs

**Status: Accepted, 3 Nov 2026** (Paul, PR #8).

**Context.** The M2 setter and year counter need several small springs (`docs/m2-design.md` §6,
*Steel springs*). The first design printed some of them as plastic leaves: the rocker detent, wheel
C's jumper and the ring jumper. Printed plastic relaxes under a constant load over the years.

**Decision 1: every spring is steel.** Paul: "I'd rather go with steel springs. Please source and
spec the springs that you recommend."
- Catalogue springs where a coil spring fits: the set-ramp plunger and the counting-lever return.
- Straight spring wire (EN 10270-1 DH, Ø0.4 and Ø0.5) for the detents and the click, glued into
  printed blocks.
- A flexure that is unloaded at rest may stay printed: the counting lever's hook flexes once a
  year and is free the rest of the time.

**Decision 2: inch-based catalogue springs accepted.** Paul: "accept the sodemann springs".
- The two catalogue springs are Sodemann stock (Denmark, sold and shipped to France). They are
  listed in mm, but their sizes are inch-based (for example De 4.57 mm = 0.180").
- `CLAUDE.md` asks for metric sizes. Paul accepts this exception because no standard part mates
  with a spring, so nothing else in the design depends on its size.
- The metric alternatives, Gutekunst VD-011Y and RZ-020I, could not be verified from the cloud
  session.
- **Scope:** springs only. Rods, tubes, bearings and fasteners stay metric.

---

## D14 — When the shows run: legal time

**Status: Accepted, 4 Nov 2026** (Paul, PR #11). It revises D2 item 2.

**Context.**
- In D2 the automata follow the dial's Strasbourg mean time, so the noon show runs at 12:29 CET
  (13:29 CEST), as in Strasbourg today.
- Paul: "I'd like the show to happen at noon, not 12:30. Lets set P1 = 15 minutes past the hour,
  P2 to the 30 minutes past, P3 to 45 minutes past, and P4 to be on the hour. I think that's closer
  to the original design intent."
- In 1842 local mean time was the town's civil time, so Schwilgué's shows ran at civil noon.

**Decision.**
- Every show follows **legal time (CET/CEST)**:
  - the four quarters at :15, :30, :45 and :00;
  - Death's count is the legal hour;
  - the noon show is at 12:00.
- The gold hands still show Strasbourg mean time, and the silver hands legal time (D9).

**Consequences.**
- The quarter, hour and noon releases sit on the legal-time train, M1b, not on M1
  (`docs/m1-design.md`; architecture §5).
- Whatever holds E2's state (M1 concept gate, decision 1) follows legal time too.
- **The autumn change runs +23 h, not +11 h.**
  - The 24 h noon wheel is on the legal train. +11 h would leave it 12 h out.
  - +23 h is −1 h on the 24 h wheel and on the 12 h dial.
  - The spring change stays +1 h. Both are forward-only, at catch-up speed, with the shows
    suppressed.
- Quiet hours (D10) are in legal time, the house's time.

## D15 — The noon procession: a personal set of figures

**Status: Accepted, 4 Nov 2026** (Paul, PR #11): "I like your suggestion of astronomy and time, with
Urania in the centre. Time and the stars have a nice synergy with this clock. I also agree that
death and the ages still belong, as do the angels." So theme A below, with Urania. The twelve are
the recommended list; any can be swapped from the alternates before E3 is designed. Death, the
four ages and the genies stay as on the original.

**Context.**
- The original's noon show is the twelve Apostles passing Christ, who blesses each
  (`docs/mechanism-inventory.md` A5).
- Paul: "I'd like to change Jesus and the Apostles. I'm not religious and I think we can do
  something here to personalize the clock … famous figures through history (Plato, Copernicus,
  Newton, Pythagoras, Einstein, etc.). Or famous composers … I think we can remove the Jesus figure
  completely unless you can think of something to insert there."

**What stays.**
- E3's mechanism is unchanged: twelve figures on a track, each turning to the central figure and
  facing forward again, and the central figure's arm gesture.
- The rooster crows after the 4th, 8th and 12th figure, so the twelve fall naturally into three
  groups of four.

**Options** (for the PR #11 discussion; the figures need no numbers, so no tags):

| Theme | Central figure | The twelve, in three groups of four |
|---|---|---|
| **A. Astronomy and time** (recommended) | **Urania**, muse of astronomy, already painted on the original's weight tower; she lowers a star or laurel to each figure | *Antiquity:* Pythagoras, Plato, Hipparchus (precession, the globe's slowest motion), Hypatia. *The new astronomy:* Copernicus (the planetary dial is Copernican; his portrait is on the original), Tycho Brahe, Kepler (the equation of centre the cams compute), Galileo. *Time and the modern era:* Huygens (the pendulum clock), Newton, Schwilgué (the clock's maker), Einstein. |
| B. Composers | Euterpe, muse of music; or none | Paul's Mozart, Beethoven and Saint-Saëns, with others in three periods of four |
| C. No central figure | — | Either set; each figure turns to the audience instead |

**Recommendation: A, with Urania.** It suits an astronomical clock: most of its figures stand for
something the clock itself shows. It keeps the original's gesture, and both Urania and Copernicus
already appear on the original's painted panels. Alternates for any slot include Ptolemy, Ulugh
Beg, Harrison (the marine chronometer), Caroline Herschel and Hubble. Each figure carries an
attribute (a telescope, a pendulum, an armillary sphere), so it reads at 57 mm.

## D16 — Motors plug in from behind

**Status: Accepted, 5 Nov 2026** (Paul, PR #13: "Lets go with option A for the motors").

**Context.**
- Architecture §11: "Motors are reachable without removing gears".
- The first M1 model did not meet that. Each motor was screwed to the back plate from inside the
  cassette, and its drive gear was pressed on its shaft between the plates. M2 is built the same
  way. Changing a motor meant pulling the hands, lifting the dial and opening the cassette.
- The options are in `docs/m1-design.md` §10:
  - A, plug-in motor (+4 mm depth);
  - B, arbor and coupling (≈ +30 mm);
  - C, keep as modelled.

**Decision: A.**
- **Adapter.** Each stepper is screwed to a small printed adapter plate at the bench (4 × M3 × 6,
  heads in counterbores).
  - A boss on the adapter's face locates it in a pocket in the back plate.
  - Two M3 × 8 screws from behind hold it, into heat-set inserts in the plate.
- **Drive part.** It slides on the motor's D-shaft and stays in the cassette when the motor is out.
  - Its spigot passes through the back plate and stops on the adapter's boss.
  - A post on the front plate stops it from the front.
  - Both stops have the endshake `E` (0.3 mm [E]).
- **To change a motor:** undo two screws from behind and draw the motor and adapter straight out.
  To refit it, turn the shaft until its flat finds the drive part's D-bore.

**Consequences.**
- The motors sit 4 mm further back.
- The drive is a slip fit on the D-flat, so it has a little backlash. It stays taken up, because
  the steppers turn forwards only (CLAUDE.md rule 3).
- M1 has this from PR #13.
- M2 has it too. Its 12-tooth motor pinion is small enough to come back through the back plate's
  Ø22.5 hole, so it stays pressed on the shaft and leaves with the motor. M2 needs no stops in the
  module (`docs/m2-design.md` §2, `cad/lib/motor_mount.py`).
- New modules (E2's state stepper, M5, M6) start with it.

## D-next (firmware) — Controller and firmware: the Phase 3 gate

**Status: Accepted, 8 Nov 2026** (Paul, PR #19: "F2-F10. approve your recommendations."; F1 in chat: "Lets plan for your approach of you drawing the board in KiCad").
The options and trade-offs are in `docs/firmware-design.md` §14; this record lists the outcome.

| # | Decision | Outcome |
|---|---|---|
| F1 | How the controller is built | A bench prototype first, then a carrier PCB with plug-in modules, drawn in KiCad in the cloud. Hobby perfboard stays the fallback. Maker to choose at order time (Aisler recommended) |
| F2 | Event-motor drive | One PCA9685 switching DRV8833 bridges, one channel per motor (on or brake, no audible PWM); E2's walk on a native PWM pin at ≥ 20 kHz |
| F3 | RTC | RV-3028-C7 with a supercapacitor, trimmed from NTP |
| F4 | Motor phase through a power cut | Restore it at power-up (TMC2209 datasheet method: step with ENN high until MSCNT matches), confirmed on the rig; hold-up capacitor footprint kept as a fallback |
| F5 | Power rails | 24 → 5 V for logic; a separate 24 → 6 V rail for the event motors |
| F6 | Quiet hours | 22:00–07:00 legal time; the ages, the genie and Death silent; settable from Home Assistant. Since E2's racks are released by the walk train (PR #21), Death is silent whenever the ages are |
| F7 | Toolchain | Arduino IDE 2 with the Arduino-ESP32 core; `arduino-cli` for headless builds. This supersedes "PlatformIO project" in architecture §12 |
| F8 | Faults and the door | A faulted show stays off until acknowledged; an open door skips the shows (E5 and E6 still run) |
| F9 | Sensor and event data | New `sensors:` and `events:` sections in `spec/clock.yaml`, append-only |
| F10 | Simulator | The plan and error budgets of `docs/firmware-design.md` §11, with Skyfield and DE440s as the reference |
## D-next (M5–M7) — Mean time: Strasbourg or Bordeaux (revises D2)

**Status: Accepted, 8 Nov 2026** (Paul, PR #20: "We are basing the localtime on Bordeaux, not
Strasbourg", then "I'd prefer to use the 'the sky over this house' approach"). The number is
assigned when the PR merges.

**Context.**
- D2 set the dials' time to **Strasbourg** mean time (items 1, 2 and 5) because "the noon show is
  important", and only the sky (sunrise/sunset, the globe) to Bordeaux.
- D14 has since moved every show to legal time, so the noon show no longer depends on mean time.
- The mean-time offset is one firmware constant (architecture P1). No gear, cam or printed part
  depends on it [D: a search of `cad/`, `spec/`, `firmware/` and `sim/` finds it only in a
  comment in `cad/modules/m1_time/mechanism.py`].

**Decision: Bordeaux mean time for the whole clock.**
- Mean time = **UT − 2.28 min** [D: D2, Bordeaux longitude]. Mean noon is 13:02 CET / 14:02 CEST.
- So the gilt mean-time hands (M1), the main dial's apparent time, Sun and Moon hands (M2), the
  calendar ring's midnight and the weekday carousel (M7) all refer to Bordeaux.
- The globe (M6) was already on Bordeaux sidereal time; unchanged.
- **D2's sub-question (ii) falls away.** The mobile horizon no longer needs the fixed 33.3 min
  longitude offset: dial and sky are now on the same meridian, so it is symmetric about the dial's
  noon and still means "the Sun is up outside".
- The shows stay on legal time (D14): quarters on the quarter, noon show at 12:00 CET/CEST.

**Consequences.**
- The gilt hands read 1 h 02 min behind legal time in winter and 2 h 02 min in summer
  (Strasbourg's would be 29 min and 1 h 29 min). The silver legal-time hands (M1b) are unchanged.
- The calendar ring and the carousel change over at Bordeaux mean midnight: 01:02 CET, 02:02 CEST.
- The replica's gilt hands read 33.3 min behind the cathedral's. Accepted for consistency.
- Documents that still say "Strasbourg mean time" or "12:29" (D2, `docs/m1-design.md`,
  `docs/e2-design.md`, the inventory, the reference notes) are left as their owners wrote them;
  this record supersedes them. The firmware's mean-time constant is set from this record in
  Phase 3. M7's 33.3 min setting offset becomes zero (`docs/m7-design.md` §9).
- **Firmware (merged from PR #19 after this record was drafted).** `docs/firmware-design.md` sets
  the mean-time modules to τ = UTC + 1860 s (Strasbourg). Under this decision it becomes
  **τ = UTC − 137 s** [D: −0.57° × 240 s/° = −136.8 s; Bordeaux house at 0.57° W,
  `docs/reference-notes.md` and `tools/phase0/derivations.py`]. The longitude should be refined to
  the house's own coordinates. That edit belongs to the firmware track; it is flagged on PR #20.

## D-next (E1) — The genies: one motor and a count wheel

**Status: Accepted, 8 Nov 2026** (Paul, PR #18 and chat). The options and trade-offs are in `docs/e1-design.md`
§5–8 and §13–15; this record lists the outcome.

| # | Decision | Outcome |
|---|---|---|
| 1 | Motors | One event motor for both genies ("truer to the original design") |
| 2 | Selector | A count wheel, 1:20 on the bell shaft: ten strokes, then ten silent turns (a silencing cam) in which a mutilated gear turns the glass. The motor runs forward only |
| 3 | Link to the glass | A rigid Ø5 cross shaft behind M1, below M1's motor adapters |
| 4 | The strike | The genie's arm holding the striker moves and strikes the real bell in its hand |
| 5 | The glass | Scotch yoke, rack and pinion; the forearms turn with the glass, in the facade plane, in about 3 s |
| 6 | Sizes and parts | Figures 78 mm; E1's bell a little lower than E2's (sized or chosen by ear); a bought miniature hourglass |
| 7 | Night | The glass turns when Death strikes; since PR #21 that is when the ages run |
| 8 | After a fault in mid-cycle | The missing strokes run alone a minute before the next quarter (at E2's resync) |

**Consequences.** The event-motor count drops to 7 + 1 (BOM). Quiet hours must skip whole cycles (:15 … :00) to
keep E1's count; the firmware's F6 window should start after a :00 show and end before a :15 show.

## Blockers (not decisions, but they need Paul)

**1. Network access for research.** This session could reach only package registries and GitHub.
Only Paul can change this, in the environment settings; a PR comment or chat message cannot.

**Update, 31 Oct 2026:** Paul widened access. The shell can now reach most hosts. Read in full
since then: Schwilgué's *Description abrégée* (1844, archive.org). Still not obtainable
automatically:

| Host | Problem |
|---|---|
| `bibnum.publimath.fr` (LEF) | Answers 403 to automated clients |
| `clea-astro.eu` (CLEA) | Does not resolve |
| `www.elsolieltemps.com` (ELS), `gallica.bnf.fr`, `www.cathedrale-strasbourg.fr` | Bot protection (403) |
| `upload.wikimedia.org` (photos) | Rate-limited (429) during this session; retry later |

Circumventing bot protection is not acceptable, so **Paul, please download LEF, CLEA and ELS by
hand** (links in reference-notes, Sources).
The fix is in the cloud environment settings: environment menu → Edit → Network access, either a
broader level or these hosts added under *Allowed domains*, with "Allow package managers" left
ticked. Docs: https://code.claude.com/docs/en/cloud-environments#network-access.

| Purpose | Hosts |
|---|---|
| Key PDFs | `clea-astro.eu`, `bibnum.publimath.fr`, `www.elsolieltemps.com` |
| Primary books and prints | `books.google.com`, `play.google.com`, `gallica.bnf.fr`, `numistral.fr`, `archive.org`, `web.archive.org`, `babel.hathitrust.org`, `www.digitale-sammlungen.de` |
| Photos for envelope scaling | `commons.wikimedia.org`, `upload.wikimedia.org`, `en.wikipedia.org`, `fr.wikipedia.org`, `de.wikipedia.org` |
| Official data | `www.cathedrale-strasbourg.fr`, `pop.culture.gouv.fr` (Palissy PM67000355) |
| Computus study | `comput1821.github.io`, `roegeld.github.io` |
| Purchasing checks | `fr.rs-online.com`, `www.gotronic.fr`, `www.3djake.fr`, `fr.misumi-ec.com`, `www.123roulement.com`, `www.chronos.ltd.uk`, `eshop.ameco.cz` |

**2. Documents to obtain, in priority order.**

1. Ch. Schwilgué, *Description abrégée…* (public domain; Google Books id `LGYEyPW9ZWQC`).
2. The full ELS, CLEA and LEF PDFs. Paul could download them on the Mac and commit them under
   `docs/sources/`, if their licences allow.
3. Flores 2007 (Klinghammer computus).
4. Bach, Rieb & Wilhelm 1992.
5. Ungerer (1920s–1954 editions).
