paulforrester/horloge-astronomique/docs/reference-notes.md

# Reference notes — Schwilgué's Strasbourg astronomical clock

Facts gathered before the repo existed (31 Oct 2026). Each entry gives a source. Tags:
**[S]** sourced, **[D]** derived (calculation shown), **[E]** estimate, **[?]** conflicting or
unclear. Add to this file as research continues; never remove a source.

**[Sn]** (added in Phase 0) means *search-snippet only*. The wording came back from a web-search
tool, but the page itself could not be opened because the cloud session's network policy blocked
the host. Treat [Sn] facts as leads: confirm them on the page before any design depends on them.
Phase 0 additions are in the section "Phase 0 additions" at the end of this file.

## Sources

| Key | Source |
|---|---|
| ELS | Description of the current clock, early 1920s lecture to the Société astronomique de France — https://www.elsolieltemps.com/pdf/gnomonica/157.pdf (site blocks automated fetch; facts below are from search snippets only — **read the full PDF**) |
| CLEA | Paturel & Dubois, "L'horloge astronomique de la cathédrale de Strasbourg revisitée", Cahiers Clairaut n°102 (2003), based on Bach & Rieb — http://clea-astro.eu/archives/cahiers-clairaut/CLEA_CahiersClairaut_102_02.pdf |
| LEF | Jean Lefort, "L'horloge astronomique de la cathédrale de Strasbourg" (gear mathematics, after Ungerer 1922) — https://bibnum.publimath.fr/IST/IST93039.pdf |
| WIKI | https://en.wikipedia.org/wiki/Strasbourg_astronomical_clock |
| TS | https://www.techno-science.net/fr/definitions/horloge-astronomique-de-strasbourg (mirror of French Wikipedia) |
| LOC | https://local-fr-public.s3.eu-west-3.amazonaws.com/prod/webtool/userfiles/27520/Horloge_astronomique.pdf |
| ENS | https://www.ens-lyon.fr/RELIE/Cadrans/Musee/HorlogesAstro/General/PagesGr/StrasbourgGr.htm |
| AMIS | https://www.amis-cathedrale-strasbourg.eu/2023/03/04/gunther-oestmann-lhorloge-astronomique-de-la-cathedrale-de-strasbourg/ |
| ODY | https://odysseum.eduscol.education.fr/lhorloge-de-strasbourg-decrite-par-frischlin |
| MERP | https://aulavirtual.cui.edu.ar/blog/merpmonde/754105609878700032-the-best-timepiece-in-the-world-imo-strasbourg (visitor blog) |
| PH | Powerhouse Museum Strasburg Clock model — https://artsandculture.google.com/story/EQVhvcQV07ffKQ |
| TELL | Fully printed tellurium — https://www.printables.com/model/288152-mechanical-orrery |
| H2D | https://bambulab.com/es/h2d/tech-specs |

## Overall dimensions

- Case kept from the 16th-century clock: **18 m tall, 7.70 m wide at the base** [S: ELS]. The case
  is three storeys with a spiral staircase, 18 m tall [S: AMIS].
- **[?]** ODY gives 18 m × **8.60 m** for the second clock. Using 7.70 m (ELS describes the current
  clock specifically). Resolve with Bach/Rieb if possible.
- Main apparent-time dial: the Sun hand travels on a dial **2.30 m** in diameter [S: ELS].
- Apostle figures about **18 inches** (~46 cm) tall [S: WIKI, citing an 1896 source].
- Second clock's celestial globe (now in a museum, *not* the current one): 83 cm [S: ODY]. The
  current globe's diameter is **unknown**.
- At 1:8 [D]: height 2.25 m; width 0.9625 m; main dial 287.5 mm; Apostles 57 mm. Day-of-year ring
  on the main dial ≈ π × 287.5 / 365 ≈ 2.5 mm per day.

## Layout, bottom to top [S: CLEA unless noted]

- **Left tower:** contains the drive weights — five weights of 50 kg each. Topped by the rooster
  automaton, which crows at noon while flapping its wings, using a mechanical and pneumatic system.
  It crows and flaps at the passage of the 4th, 8th and 12th Apostles [S: LOC].
- **Celestial globe**, at floor level in front of the case: positions of constellations and main
  stars; includes precession of the equinoxes (one turn in about 26,000 years); sidereal time is
  shown [S: CLEA].
- **Computus** mechanism at the bottom left of the clock [S: TS]; the **solar and lunar equations**
  vitrine is on the other side of the base [S: MERP says the two modules are on either side of the
  base; CLEA names the "Equations solaires et lunaires" vitrine].
- **Main (lower) dial:** apparent motion of the Sun and Moon around the Earth at the centre; sunrise
  and sunset times; solar and lunar eclipses; days of the week; the date of Easter. A black disc
  opposite the Sun represents Earth's shadow. The Moon's rod has variable length so the Moon can
  eclipse the Sun or enter the shadow only when appropriate. Around the edge: every day of the
  year, each preceded by its dominical letter. A dial on the left shows the current year's
  dominical letter. A mechanism behind the dial inserts the day marked "Pâques" in the right place
  and adds a day in leap years.
- **Computus displays:** epact, dominical letter, indiction, solar cycle (28 years), golden number
  (19 years).
- **Weekday carousel** above the main dial: Apollo (Sunday), Diana (Monday), Mars, Mercury,
  Jupiter, Venus, Saturn (Saturday).
- **Mean solar time dial** for Strasbourg (about 30 min different from legal time). Beside it, one
  cherub turns an hourglass **[?]** "every hour (or every quarter)", and the other rings a bell
  every quarter. TS: one angel rings a bell while the second turns an hourglass.
- **Heliocentric planetary dial:** Mercury, Venus, Earth (with Moon), Mars, Jupiter, Saturn.
- **Moon-phase globe** above the planetary dial.
- **Top stages:** the four ages (child, adolescent, adult, old man) pass before Death every quarter
  hour; ENS assigns quarter→child, half→adolescent, three-quarters→man, hour→old man. At noon the
  twelve Apostles pass before Christ and the rooster crows three times.
- Gold hands show mean solar time; silver hands show Central European Time [S: WIKI]. The automata
  run on the clock's own (local mean) time, so the noon show happens at 12:30 legal winter time
  [S: TS, LOC]. Strasbourg mean time is about 31 min ahead of Greenwich [S: ELS snippet].
- A meridian line inside the cathedral, lit through an opening in a side door, is used to check the
  clock against true solar noon [S: CLEA].

## Drive and regulation [S: CLEA]

- Seconds-beating pendulum; drift claimed not to exceed 40 s per year.
- Temperature-compensated pendulum; a compensating spring mechanism keeps torque at the escape
  wheel almost constant.
- Tooth profiles designed to roll rather than rub.

## Schwilgué's gear data

### Yearly motion and planets [S: CLEA; D: arithmetic verified in Python]

- Year: P = (156 × 188 × 269) / (9 × 10 × 10) — source states 365.2422.
  **Note [D]:** as printed, the expression evaluates to 8,765.813, which is 365.2422 × 24. So it
  appears to count turns of an arbor turning once per hour, or a factor of 24 is missing in the
  source. Verify.
- Planet periods = P × factor:

| Planet | Factor | Period [D] | Accepted (CLEA) |
|---|---|---|---|
| Mercury | (44×134)/(240×102) | 87.97 d | 87.97 d |
| Venus | (17×221)/(197×31) | 224.70 d | 224.70 d |
| Mars | (95×213)/(203×53) | 686.93 d | 686.98 d |
| Jupiter | (157×232)/(96×32) | 11.857 yr | 11.86 yr |
| Saturn | (161×212)/(58×20) | 29.424 yr | 29.46 yr |

### Moon [S: CLEA; D: verified]

- Lunar turns per year = (312/24) × [1 − (83×14)/(122×196)] = 12.368267, via a differential.
  Synodic month = P / 12.368267 = 29.53059 d.
- The tilt of the lunar orbit is handled by an inclined toothed wheel [S: CLEA].

### Sidereal motion [S: LEF; D: verified]

- Schwilgué's tropical year: 365 d 5 h 48 min 48 s = 31,556,928 s. Required ratio
  R = 164,359 / 164,809 (164,359 = 13 × 47 × 269; 164,809 is prime-heavy and awkward).
- **Exact method (celestial sphere):** epicyclic train with a/A = 45/72, b/B = 18/270,
  c/C = 18/269, d/D = 26/100, e/E = 18/94. Output per turn of B =
  1 + (100/26)(18/94)[(270/18)(18/269) − 1] = 1 + 450/164,359 = 1/R exactly.
  (Reconstructed from garbled PDF text; arithmetic checks exactly.)
- **Approximate method (Moon motion):** 271,375 / 272,118 ≈ R (error ~1 s per century per LEF),
  realised ×12 because the driving arbor turns once in 2 h:
  (334/28) × (65/341) × (300/57) = 11.96723 = 12 × 271,375/272,118 (verified exactly).

### Solar and lunar equations [S: LEF, CLEA]

- Each periodic correction is a cylinder carrying its curve traced over two periods; a horizontal
  crossbar rides on it. The cylinders are stacked, each resting on the crossbar below, so the top
  crossbar's height equals the sum of all corrections. Largest corrections at the top. Pinions get
  longer the higher their cylinder sits, to allow for the vertical movement [S: LEF].
- The summed movement reaches the Sun or Moon motion through pulleys/rods to a pivoting frame
  (a differential arrangement) [S: LEF], or by raising/lowering a pinion with oblique teeth that
  speeds up or slows the wheel [S: CLEA].
- The Sun needs three corrections; the Moon uses five [S: LEF]. Lunar terms, driven by an arbor
  turning once per mean day (86,400 s):

| Term | Target period | Ratio used | Period obtained [D verified] |
|---|---|---|---|
| Anomaly | 27 d 13 h 18 m 34 s | 70209/2548 | 27 d 13 h 18 m 33.3 s |
| Evection | 31 d 19 h 29 m 11.453 s | 74090/2329 | 31 d 19 h 29 m 11.3 s |
| Variation | 29 d 12 h 44 m 3 s | 51649/1749 | 29 d 12 h 44 m 2.9 s |
| Annual equation | 365 d 6 h 13 m 57 s | 226461/620 | 365 d 6 h 13 m 56.1 s |
| Nodes (draconitic) | 27 d 5 h 5 m 35.8 s | 49880/1833 | 27 d 5 h 5 m 35.8 s |

- **Eclipses:** a cam turning in about 18.6 years lengthens or shortens the Moon hand so it passes
  in front of the Sun disc or not; a similar mechanism handles lunar eclipses [S: LEF].

### Tooth-count practice [S: LEF]

- Wheels limited to about 500 teeth for weight and strength; largest found 420. Largest prime tooth
  count 281 (also 269); composites such as 382, 341, 334, 327, 318. Minimum 6 teeth; smallest prime
  used alone 17.
- Schwilgué chose rational approximations whose factors are small primes (≤ 269), using continued
  fractions and Farey sequences.

## Computus [S: TS, LEF, WIKI]

- Probably the first mechanical Gregorian computus: designed 1816, model presented 1821.
- At the end of each year it determines the movable feasts for the coming year.
- Frédéric Klinghammer built a reduced replica of the computus in the 1970s.
- **Detailed mechanism not yet documented here** — research needed.

## Precedents

- Richard Bartholomew Smith built a working 1:5 model (1887–1889), now at the Powerhouse Museum,
  Sydney; he worked from a postcard and a book and localized dials to Sydney [S: WIKI, PH].
- A fully printed, crank-driven tellurium on Printables shows date with a mechanical year counter,
  Moon phases, apogee/perigee and the lunar nodes. Synodic month 29.5313 d vs 29.5306 d; nodal and
  apsidal cycles (18.5 and 8.8 yr modelled) from near-equal tooth pairs 39/37 and 39/44. Its
  instructions say to approach any date from the same direction to cancel play [S: TELL].

## Printing constraints

- H2D build volume 325×320×325 mm single nozzle; 300×320×325 dual; nozzles 0.2–0.8 mm [S: H2D].
- FDM with 0.4 mm nozzle struggles below module 1.0
  [S: https://www.sovol3d.com/blogs/news/3d-printing-gears-that-actually-work-backlash-orientation-and-material-tips].
- Rule of thumb: module ≈ 4 × nozzle diameter; backlash 0.1–0.3 mm, 0.15 mm a good first guess
  [S: https://makerworld.com/en/models/3276583-parametric-internal-ring-gear-generator].
- Gear tolerance test card, modules 0.5–1.5, 0.4 and 0.2 mm nozzle versions
  [S: https://makerworld.com/models/2221699].
- PLA clock gears reported running ~10 months (~40 M ticks) without noticeable wear
  [S: https://forum.prusa3d.com/forum/original-prusa-i3-mk3s-mk3-how-do-i-print-this-printing-help/printing-tiny-gears-3mm-1cm-from-nylon].

## Location data

- Bordeaux house ≈ 44.83° N, 0.57° W. Local mean time ≈ 2.3 min behind UTC [D], so local mean noon
  is about 13:02 CET in winter and 14:02 CEST in summer.

## Open items / unknowns (research before designing the related module)

- Current celestial globe diameter; planetary dial diameter; Moon-phase globe diameter; diameters
  of the mean-time and other dials.
- Size and layout of the computus and equations vitrines.
- Case depth and the globe's projection in front of it.
- Heights of the other figures (Christ, Death, the four ages, angels, weekday deities); rooster
  size.
- How sunrise and sunset are displayed mechanically on the main dial.
- How the day-of-year ring, Easter insertion and leap-year day work mechanically.
- The computus mechanism in detail.
- Rooster mechanism (mechanical + pneumatic) in detail.
- Resolve: hourglass turned hourly or quarter-hourly.
- Resolve: case width 7.70 m vs 8.60 m.
- Whether the full ELS PDF and the Ungerer / Bach-Rieb books are obtainable (BnF lists the Ungerer
  work; editions of 1949 and 1954 exist).

---

## Phase 0 additions (31 Oct 2026)

### How this research was done (read first)

The cloud session's network policy allowed only package registries and GitHub. Every other
source host was refused, both from the shell and from the fetch tool:

- the three key PDFs (`clea-astro.eu`, `bibnum.publimath.fr`, `www.elsolieltemps.com`);
- Wikipedia and Wikimedia Commons;
- `gallica.bnf.fr`, `archive.org`, `books.google.com`, `numistral.fr`;
- `pop.culture.gouv.fr`, `cathedrale-strasbourg.fr`;
- retailer sites.

So, apart from **RGL** below (read in full through its GitHub repository), every new fact in this
section is **[Sn]**. The hosts to allow for a follow-up research session are listed in
`docs/decisions.md` → "Blockers".

### New sources

| Key | Source |
|---|---|
| RGL | Denis Roegel, "Le comput ecclésiastique de Schwilgué (1821) — Étude et description complète", web page dated 21 Mar 2025 — https://comput1821.github.io/ (read in full from its source repo https://github.com/comput1821/comput1821.github.io, commit `45171af`) |
| CATH | Cathedral official site — https://www.cathedrale-strasbourg.fr/horloge-astronomique [Sn] |
| WCC | Wikipedia "Computus clock" — https://en.wikipedia.org/wiki/Computus_clock [Sn] |
| WSC | Wikipedia FR "Modèle de comput de Schwilgué" — https://fr.wikipedia.org/wiki/Mod%C3%A8le_de_comput_de_Schwilgu%C3%A9 [Sn] |
| KLH | Wikipedia "Klinghammer's computus" — https://en.wikipedia.org/wiki/Klinghammer's_computus [Sn] |
| EXO | Page on the 1821 computus model — https://exopuce.fr/comput/ [Sn] |
| BDM | Travel description — http://www.bouts-du-monde.com/1eu/htm/france/grand-est/horloge-astro.htm [Sn] |
| VDK | VdK Bayern trip programme (German) — https://bayern.vdk.de/uploads/user_uploads/events/5/2/698c35f53cd29-1770796533/Programm%204%20Tage%20Schwarzwald.pdf [Sn] |
| BFA | *Das Buch für Alle*, 1867, "Die astronomische Uhr in Straßburg" — https://epilog.de/die-astronomische-uhr-in-strassburg.buch-fuer-alle.1867 [Sn] |
| EQX | Review of G. Oestmann, *The Astronomical Clock of Strasbourg Cathedral*, J. Skyscape Archaeology 7(1), 2021, pp. 157–160 — https://journal.equinoxpub.com/JSA/article/view/19440 [Sn] |
| AHN | Astronomical Heritage entry — https://web.astronomicalheritage.net/show-entity?identity=33&idsubentity=1 [Sn] |
| PH-H | patrimoine-horloge.fr — https://www.patrimoine-horloge.fr/as-strasbourgcathedrale.html [Sn] |
| ASP | astroaspach PDF "Les trois horloges astronomiques de la Cathédrale de Strasbourg" — http://astroaspach.fr/astroaspachV2/wp-content/uploads/2015/12/les-trois-horloges-astronomiques-de-la-Cathedrale-de-Strasbourg.pdf [Sn] |
| MEEUS | J. Meeus, *Astronomical Algorithms*, 2nd ed., Willmann-Bell, 1998, ISBN 0-943396-61-1. Standard reference, used only for textbook formulae (equation of time, eq. 28.3). |

Bibliographic leads to obtain (not yet read):

- **Charles Schwilgué (son), *Description abrégée de l'horloge astronomique de la cathédrale de
  Strasbourg*.** This is the primary description.
  - First edition 1842; German edition 1844 [Sn: https://www.deutsche-biographie.de/sfz79786.html].
  - 5th edition 1852, held by the History of Science Museum, Oxford [Sn].
  - 7th edition, Dannbach 1854, 66 pp, on Google Books:
    https://books.google.com/books/about/Description_abr%C3%A9g%C3%A9e_de_l_horloge_astro.html?id=LGYEyPW9ZWQC [Sn].
  - 1844 edition: https://play.google.com/store/books/details?id=moADAAAAQAAJ [Sn].
  - **Highest-value document to read next. The 19th-century editions are public domain.**
- Th. Schweighaeuser, *Historische Notizen über die Astronomische Münsteruhr zu Strassburg nebst
  einer ausführlichen Beschreibung des mechanischen Werkes*, Strassburg, Hubert & Haberer, 1876,
  64 pp [Sn: antiquarian listing]. Its title promises a detailed description of the mechanism.
- F.-G. Edel, *Die astronomische Münsteruhr in Strassburg*, 1843 [Sn].
- Ungerer, *L'horloge astronomique de la cathédrale de Strasbourg*: BnF lists 1920 and 1926
  [Sn: https://data.bnf.fr/10380008/alfred_ungerer/de.pdf]. Oxford holds a 1949 printing and a 7th
  edition of 1954, revised by Ch. Ungerer and L. Leclerc
  [Sn: https://www.mhs.ox.ac.uk/collections/library/catalogue-simple/titles/?id=1937257].
  **[?]** The "1922" date in this file is so far supported only by a Scribd upload.
- Bach, Rieb & Wilhelm (1992), on Google Books (probably snippet view only):
  https://books.google.com/books/about/Les_trois_horloges_astronomiques_de_la_C.html?id=uu4fAQAAIAAJ [Sn].
- J. Flores, *Le comput ecclésiastique de Frédéric Klinghammer*, AFAHA, Besançon, 2007, 160 pp
  plus a CD, with contributions by D. Kleinknecht and M. Augereau (gear ratios). Reviewed by
  D. Roegel, *NAWCC Bulletin* 50/4, no. 375, Aug 2008 [Sn: KLH].
- Lefort's article (LEF) appeared in *L'Ouvert* n°70 (1993), pp. 27–47
  [Sn: https://wp.publimath.fr/auteur/lefort-jean].
- 1842 lithograph by Grieshaber from the Schwilgué workshop, 52 × 34.5 cm, Nancy municipal
  archives (Bach collection): https://recherche-archives.nancy.fr/printDoc/FRAC054395_2-3-102-103Fi_de-310 [Sn].
  - Michel Grieshaber reportedly made the detailed drawings for Schwilgué's clock
    [Sn: Roegel 2025, https://roegeld.github.io/stimmer/roegel2025stimmer-astronomy.pdf]. Archive lead.
- Period frontal prints: https://gallica.bnf.fr/ark:/12148/btv1b10202446r ("construite par J.B.
  Schwilgué. 1838 à 1842"), https://www.numistral.fr/ark:/12148/btv1b10202448n.item (1845) [Sn].
- Notes from a 2008 visit guided by J.-P. Rieb:
  https://association-philomathique.u-strasbg.fr/utilisateur/pages/references/sorties%202008/Horloge%20astronomique.pdf [Sn].
- https://cadranssolaires.com/wp-content/uploads/2025/10/horloge-astronomique-strasbourg.pdf (2025) [Sn].

### Dimensions

- **[?] The 7.70 m width may belong to the first clock, not the current case.** English Wikipedia
  (snippet), on the first clock (1352–54): "on the wall opposite the current clock … Supports for
  former balconies can still be seen today, and suggest that the height of the clock was about
  18 m (59'), with a width of about 7.70 m (25') at the base" [Sn: WIKI].
  - The current case is the second (Dasypodius, 1547–74) clock's case, which Schwilgué reused
    [S: ELS, per the "Overall dimensions" entry above].
  - ODY gives 18 m × **8.60 m** for that second clock.
  - So 8.60 m may be the relevant width for the current case. At 1:8 that is 1075 mm, not 962.5 mm [D].
  - **Unresolved.** Read ELS in full and check against Bach/Rieb.
  - Consequence: the 0.96 m envelope width in `CLAUDE.md` is at risk.
- LEF (snippet), on the early clock: "D'une hauteur totale de 11,70 m, l'horloge était installée
  dans une grande cage en bois scellée au mur. La partie inférieure présentait une façade carrée
  d'environ 4 m. de côté" [Sn: LEF]. This conflicts with Wikipedia's 18 m for the first clock [?].
- Wikidata Q2716513 gives the height as 28 m [Sn]. Probably an error. The same record gives the
  clock's Palissy ID **PM67000355**; that Monuments Historiques record may hold official
  dimensions (not yet opened).
- Second clock's globe:
  - 86 cm [Sn: WIKI];
  - "860 mm in diameter and set for the meridian of Strasbourg" [Sn: EQX];
  - enlarged to 83 cm [Sn: Roegel 2025].
  - **The current (Schwilgué) globe's diameter is still unknown.**
- Precession: "one of its gears completes a turn in 25,806 years" [Sn: CATH, tool paraphrase].
  CLEA says about 26,000 years.
- Celestial globe: "more than 5000 stars, extending down to faint sixth magnitude ones" [Sn: AHN].
- Figures: "18-inch high figures of Christ and Apostles process; a life-size rooster crows three
  times" [Sn: WIKI]. So Christ is also about 18 in, which is about 57 mm at 1:8 [D].
- **Old calendar ring (probably the second clock).**
  - About 2.92 m outer diameter, 30 cm wide, 366 sectors; the leap-year sector was moved by hand
    every four years [Sn: PH-H].
  - A "secular disc" about 2.32 m across, with 100 annual sectors [Sn: ASP].
  - The current ring's diameter is unknown. If it is as large as 2.92 m, its 1:8 size is 365 mm,
    which exceeds the H2D bed [D].
- 1821 computus model: "La cage du comput fait 15 cm de large sur 20 cm de haut pour une épaisseur
  de 6 cm. Il comporte environ 300 pièces dont la plupart sont des rouages dentés et des cames aux
  découpes complexes" (the frame is 15 × 20 × 6 cm, with about 300 parts, mostly toothed wheels
  and complex cams) [Sn: EXO].
- **Still not found:**
  - case depth and how far the globe projects;
  - diameters of the planetary dial, the Moon-phase globe, the mean-time dial and the computus and
    equation displays;
  - size of the weekday carousel;
  - heights of Death, the four ages, the angels and the weekday deities;
  - rooster size in centimetres.

### Automata

- **Hourglass: hourly (provisionally resolved).**
  - "L'un, avec un sceptre et une clochette, sonne le premier coup des quarts de l'heure ;
    l'autre, son vis-à-vis, retourne le sablier au dernier coup du quatrième quart" (one angel,
    with a sceptre and a hand bell, strikes the first stroke of each quarter; the other turns the
    hourglass at the last stroke of the fourth quarter) [Sn: BDM].
  - Agrees: "Jede Viertelstunde wird von einem Engel angeläutet, zur vollen Stunde dreht der
    Engel rechts neben ihm ein Stundenglas um" [Sn: VDK]; also [Sn: BFA].
  - Only tourist pages say "every quarter".
  - Confirm in Schwilgué's *Description abrégée*.
- **Four ages:** "un enfant au 1er quart d'heure, un jeune homme à la demi, un adulte au 3e quart
  d'heure et un vieillard à l'heure juste" (child at the first quarter, youth at the half, adult at
  the third quarter, old man on the hour) [Sn: TS]. This agrees with ENS.
  - Strokes per age of 1, 2, 3 and 4 are documented only for the 16th-century clock [Sn: Cambridge
    print PR-M-00005-00049-00014].
  - **TBD for the current clock:** strokes per age and which bells are used.
- **Death strikes the hours with a bone** [Sn: low-grade blog, https://ljgolden.substack.com/p/strasbourgs-astronomical-clock].
  Confirm.
- **Noon show.**
  - "le chant du coq rappelle, par trois fois le reniement de l'apôtre saint Pierre" (the cock
    crows three times, recalling St Peter's denial); the Apostles pass before Christ, who blesses
    them [Sn: CATH].
  - **[?]** The rooster crows at the 4th, 8th and 12th Apostle [S: LOC; Sn: TS], but one blog says
    "au passage de St Pierre" [Sn].
  - The rooster's pneumatic mechanism is not found. The only rooster mechanism described is the
    *medieval* rooster's, now in the Musée des Arts décoratifs. A hollow wooden body; one rod
    lifts the head, opens the beak, pushes out the tongue and lowers the tail; a second rod spreads
    the wings [Sn: https://www.fg-art.org/users_uploads/oeuvre_oeuvre_documents/60a630522eebc.pdf].
  - Show duration: no authoritative figure. The Commons video
    `File:Animation_of_the_astronomical_clock_of_Strasbourg.ogv` could be timed.
- **Weekday carousel [?, unconfirmed]:** "le carrousel tourne de façon continue et laisse
  apparaître devant, à midi, le char de la planète du jour courant" (the carousel turns
  continuously, bringing the current day's chariot to the front at noon) [Sn: source not
  identified].
- **Local mean time vs legal time.**
  - "All astronomical indications and chimes are set to local time"; in 1842 the dial showed only
    Strasbourg mean time [Sn: CATH, tool paraphrase].
  - **[?] Summer-time behaviour unresolved.** French Wikipedia says the noon show is "12 h 30 en
    heure d'hiver", but CATH says "tous les jours, à 12 h 30 précises".

### Computus

- **[S: RGL, read]** "l'horloge astronomique de la cathédrale de Strasbourg comporte aussi un
  comput ecclésiastique construit par Jean-Baptiste Schwilgué entre 1838 et 1842. Ce mécanisme
  ingénieux permet de déterminer les éléments du comput ecclésiastique (nombre d'or, cycle solaire,
  indiction, lettre dominicale et épacte) ainsi que la date de Pâques d'année en année. Ce mécanisme
  est en fait une version agrandie d'un prototype que Schwilgué avait construit en 1821". In
  English: the clock's computus (1838–42) determines the golden number, solar cycle, indiction,
  dominical letter, epact and the Easter date year by year, and is an enlarged version of
  Schwilgué's 1821 prototype.
- **[S: RGL] The 1821 prototype and its study.**
  - It was lost about 1945 and given to the cathedral's Fabrique at the end of 2021.
  - It was dismantled, measured, drawn, photographed and XRF-surveyed between December 2022 and
    April 2023 (Roegel, with J.-P. Rieb and L. Faullimmel).
  - Roegel's full documentation is **unfinished and unpublished**.
  - The page shows a 3D-model excerpt of one part, a large rack ("grand râteau"; repo files
    `xxx.gltf` and `img/comput1821-grand-rateau.jpg`).
- **When it runs: 31 December.**
  - The central calendar is perpetual, "automatically incorporating the leap day and all moveable
    feasts, including the complex calculation of Easter's date, which is performed on New Year's
    Eve by the ecclesiastical computus on the left" [Sn: CATH, tool translation].
  - "chaque année au 31 décembre, ... les dates de Pâques et des autres fêtes qui lui sont liées
    (Ascension, Pentecôte...) se placent sur le calendrier" (each 31 December, Easter and its
    dependent feasts take their places on the calendar) [Sn: AFP-type press story, attribution
    unclear].
- **What it shows.** Five ecclesiastical functions plus a four-digit year indicator [Sn: WCC]. The
  indiction is the Roman indiction [Sn: CATH].
- **The 1821 model** is advanced one year per turn of a hand crank at the back. Its seven dials
  are: Easter date (22 March–25 April), year, solar cycle 1–28, golden number 1–19, indiction 1–15,
  dominical letter and epact [Sn: EXO].
- The 1821 model lacks the parts that transfer the result to the clock's calendar. On the clock
  the Easter date is transferred to the central calendar ring [Sn: WSC]. This gives a natural
  split: core computus plus transfer train.
- **Klinghammer replica (1970s):** "nearly a reduced model of the computus found on the Strasbourg
  cathedral astronomical clock", restored by J. Flores in 2006–07 [Sn: KLH].
- **Not found:**
  - how the Gregorian solar and lunar equations (metemptosis, proemptosis) and the century
    leap-year rule are made mechanically;
  - the Easter-finding logic;
  - gear counts;
  - the drive from the computus to the calendar ring;
  - how the dominical-letter dial is set.

### Main dial

- **Calendar ring [?].** "Le calendrier est un anneau extérieur doré qui fait un tour par an.
  Apollon pointe avec sa lance le jour en cours … gradué en 366 secteurs" (a gilded outer ring
  turning once a year; Apollo points to the current day with his spear; 366 sectors) [Sn,
  attribution unclear].
  - Some sources have Diana pointing instead [?].
  - Unknown: whether the ring moves continuously or jumps at midnight.
- **Sunrise and sunset.** A photo record's metadata reads "Apparent Time; Sunrise; Sunset" and
  shows a pointer labelled "COUCHER DU SOLEIL" (sunset) [Sn: https://sourcelibrary.org/book/cathedrale-de-strasbourg-img-1241].
  This suggests labelled hands or sectors.
  - **Mechanism unknown.** Also unknown: which latitude it is set for.
- **Equations.** They "parfois accélèrent, ou parfois ralentissent la marche des aiguilles du
  soleil et de la lune" (sometimes speed up, sometimes slow down the Sun and Moon hands); they are
  in the right-hand case [Sn: ASP].
- **[?] An eclipse the clock reportedly showed.** "a, par exemple, indiqué clairement une éclipse
  de lune le 28 mars 2006" (the clock clearly showed a lunar eclipse on 28 March 2006) [Sn].
  Check this against the NASA/Espenak eclipse catalogue before using it as a validation case:
  there was a total *solar* eclipse on 29 Mar 2006 and a penumbral *lunar* eclipse on
  14 Mar 2006, so the snippet may be garbled.

### Location

- **Strasbourg Cathedral: about 48°34′55″ N, 7°45′02″ E (48.582° N, 7.7506° E).** These are the
  standard published coordinates (Wikipedia infobox), recalled rather than re-opened in this
  session, so verify them.
  - They give LMT − UT = +31.00 min [D], which agrees with ELS's "about 31 min" [S: ELS, snippet].
  - Used in `tools/phase0/derivations.py`.

### Open items — status after Phase 0

Status of each item in "Open items / unknowns" above, in the same order:

| Item | Status |
|---|---|
| Globe, planetary dial, Moon-globe and other dial diameters | Open. The 83/86 cm figure is the second clock's globe. Needs photo scaling (hosts blocked) or a primary source. |
| Computus and equations vitrine size and layout | Open. |
| Case depth; how far the globe projects | Open. |
| Figure heights; rooster size | Partly answered: Christ is also 18 in [Sn]; the rooster is "life-size" [Sn], no number found. |
| Sunrise/sunset display mechanism | Open. Labelled hands are likely [Sn]. |
| Day-of-year ring, Easter insertion, leap day | Partly answered: 366 sectors, one turn a year [Sn]; set by the computus on 31 Dec [Sn]. Mechanism open. |
| Computus mechanism in detail | Open. Best lead is RGL (unpublished), then the Klinghammer book and Bach/Rieb. |
| Rooster mechanism | Open. |
| Hourglass hourly or quarter-hourly | **Provisionally hourly** [Sn ×4]. |
| Case width 7.70 vs 8.60 m | **Worse than thought**: 7.70 m may be the first clock's width [Sn: WIKI]. Open. |
| ELS PDF and the Ungerer / Bach-Rieb books | ELS host blocked. Schwilgué's *Description abrégée* (public domain, Google Books) is now the top target. |

---

## Phase 0 research pass 2 (31 Oct 2026, after Paul widened network access)

### New primary sources

| Key | Source |
|---|---|
| **DA** | Charles Schwilgué (the builder's son), *Description abrégée de l'horloge astronomique de la cathédrale de Strasbourg*, 2nd edition, Strasbourg, Ph.-Alb. Dannbach, 1844, 70 pp. Public domain (archive.org: NOT_IN_COPYRIGHT; Google scan). https://archive.org/details/descriptionabrg00schwgoog. **Read in full** from the OCR text. Numbers that matter were checked against the page images (PDF page = printed page + 11). Page numbers below are the printed ones. |
| SCH | Charles Schmidt, *Bericht über das astronomische Uhrwerk des Straßburger Münsters, verfaßt bei Gelegenheit das Hrn. Schwilgué, Vater, durch seine Mitbürger gegebenen Feste*, Strasbourg, Dannbach, 1842, 27 pp. https://archive.org/details/bub_gb_cSlBAAAAcAAJ. The Fraktur OCR is unreadable; it needs proper OCR or a human reader. **Not yet used.** |

DA announces "une description complète, qui sera enrichie de dix planches" (a complete
description with ten plates) [S: DA p. 5]. **Lead:** find it.

### Facts from DA (verbatim; page)

**Case and history**

- First clock (1352–54): in the south transept "en face de l'horloge actuelle; on voit encore
  aujourd'hui, dans le mur, les consoles en pierre, qui ont servi à la soutenir" [p. 7–8]. This
  agrees with WIKI on where the first clock stood. DA gives no dimensions.
- Second clock: in 1547 the stonecutters were finishing "le cabinet qui sert encore à l'horloge
  actuelle" [p. 9]. So the current case is the 16th-century stone cabinet. DA gives no case
  dimensions.
- New clock begun 24 June 1838; first ran Sunday 2 October 1842; inaugurated 31 December 1842
  [p. 22]. "Entièrement de l'invention de mon père", reusing only some statuettes [p. 23].
- **"Il n'entre dans la construction de l'horloge aucune pièce de bois"** (no wooden parts) [p. 67].

**Celestial sphere** [p. 24–26]

- Sidereal time on a dial; copper sphere on four metal columns; "disposée pour la latitude de
  Strasbourg".
- More than 5000 stars of the first six magnitudes in **110** constellations (page image; the OCR
  reads "1 1").
- Turns east to west in a sidereal day, about 3 min 56 s shorter than the mean solar day.
- Equator, ecliptic and colures turn with it. Meridian and horizon stay fixed.
- **Precession: "environ 25,804 années"** (page image; the OCR reads 26,804). Footnote: periods are
  given only to their main units.
- The second clock's globe: papier-mâché, about 50 kg, 1020 stars, 48 constellations [p. 14].

**Calendar** [p. 27–29]

- "Une bande métallique, en forme d'anneau, n'ayant que **25 centimètres** de largeur sur une
  circonférence de **passé 9 mètres**" (page image; the OCR reads 26).
- "Avance chaque jour d'une division, le passage d'un jour à un autre s'effectuant
  instantanément à minuit".
- "Une statue représentant Apollon se tient **à la droite du calendrier**, en montrant avec une flèche … le
  jour de l'année"; Diana "est placée de l'autre côté et seulement pour servir de pendant".
  - **Side (corrected 3 Nov 2026).** "À la droite du calendrier" is the calendar's own right, so it is on
    the **viewer's left**. DA says "à la droite du spectateur" when it means the viewer's right (the
    equations case, p. 44). ELS i4 confirms the day is read on the left (Calendar [i4] below).
    The earlier note "Apollo, on the right" was a misreading.
- Turns in 365 or 366 days and suppresses 3 days in 400 years by itself.
- "Commencement de l'année commune" between 31 Dec and 1 Jan; in leap years "commune" disappears
  and a day is inserted between 28 Feb and 1 Mar.
- Movable feasts placed at midnight on 31 Dec. Advent and St Arbogast have their own mechanisms.

**Apparent-time dial** [p. 30–36]

- Azure dial, silver ring with 1–12 twice.
- Shows: sunrise and sunset by a **"horizon mobile"**; true time; the Moon's true right ascension
  and meridian passage; the Moon's phases (Moon globe silver and black); eclipses.
- Sunrise and sunset in apparent time, for the Strasbourg meridian, with refraction.
- Northern hemisphere at the centre.
- Lunar eclipses shown by a disc representing a section of the Earth's shadow cone.
- The Moon's latitude is shown by its radial position relative to the Sun.

**Computus** [p. 36–43]

- Shows: millésime (four digit circles), solar cycle, golden number, Roman indiction, dominical
  letter, epacts, Easter.
- Contains all the Gregorian modifications and the lunar equations.
- Released by the clock at midnight on 31 Dec. It first determines the cycles, which then set "le
  mécanisme principal" to fix Easter. Easter is transmitted to the calendar as the "véhicule" of
  the dependent feasts.

**Equations** [p. 43–46]

- Sun: mean time to true time, "par l'anomalie pour obtenir la longitude vraie, laquelle à son tour
  est convertie en ascension droite vraie".
- Moon: centre, evection, variation, annual equation, reduction, plus the equation of the nodes
  (for latitude).
- Visible behind glass. The Moon's longitude-to-right-ascension converter is inside the clock.

**Weekday** [p. 46–48]

- Chariots "roulent sur un chemin de fer circulaire, en suivant un mouvement continu".

**Mean time** [p. 49–50]

- Small dial in the "galerie aux lions" (the two lions are from the old clock and never moved).
- Driven directly by the single central motor, which is wound every 8 days.

**Genies** [p. 50–51]

- The left genie (sceptre and bell) strikes the first stroke of each quarter and signals the ages.
- The right genie turns the red-sand glass **each hour**, alternately half a turn right and half a
  turn left, at the last stroke of the four quarters, just before Death strikes.

**Planetary** [p. 51–53]

- Copernican, on a large azure dial. The Sun disc has no visible support; twelve rays lead to the
  zodiac.
- Seven small gilded spheres.
- Periods: ~88 d, ~225 d, Earth 365 d 5 h 48 min 48 s, ~687 d, ~4330 d, 10747 d.
- The Moon goes round the Earth in a lunar month.

**Moon globe** [p. 53–55]

- An inclined globe turning on its axis.

**Automata** [p. 56–60]

- Two halls with ogival arcades: ages and Death below, Christ above.
- The ages strike only the second stroke of each quarter: child (thyrsus), youth (hunter, arrow),
  man (warrior, sword), old man (crutch).
- Each steps two paces out of its lodge to a bell.
- **The ages work only by day.**
- Death with a scythe on a central pedestal drops a bone on the bell to its right, day and night.
- At Death's last stroke of noon the twelve Apostles pass (named, in order). Each turns, bows and
  receives the blessing. After the last, Christ blesses with the sign of the cross.
- Rooster: during the Apostles' march it flaps its wings, moves its head and tail and swells its
  neck. It is "d'après nature", the same size as the earlier clocks' rooster, and crows three times
  daily at noon.

**Motors** [p. 64–66]

- One central motor, with a seconds regulator, compensated pendulum and jewelled escapement, wound
  weekly. It drives:
  - the mean-time dial;
  - the exterior dial;
  - the planetary dial;
  - the Moon phases;
  - the weekday figures;
  - the apparent-time dial;
  - the equations;
  - the sphere.
- It also suspends the ages at night.
- "Les autres moteurs, au nombre de cinq" drive the automata and striking, chained in order: ages
  → quarters → ages → hours; at noon, Apostles and rooster from the hour train. **[?]** Five
  motors are counted but only four trains are named.

**Other** [p. 62–64]

- Exterior Gothic dial over the portal, circumference about 16 m, showing mean time and the
  weekday.
- A meridian line inside the church, lit through a gnomon over the door, for checking the clock.

### Resolved by DA (supersedes the [Sn] entries above)

| Item | Resolution |
|---|---|
| Hourglass hourly or quarter-hourly | **Hourly**, alternating direction [S: DA p. 51] |
| Apollo or Diana points to the day | **Apollo**, on the viewer's left [S: DA p. 27, "à la droite du calendrier"; ELS i4, "sur la gauche de l'anneau"] |
| Calendar ring continuous or jumping | **Jumps at midnight** [S: DA p. 27] |
| Calendar ring size | **25 cm wide, circumference over 9 m** [S: DA p. 27] |
| Sunrise/sunset display | **Mobile horizon** [S: DA p. 31]. Its drive is still TBD. |
| Weekday carousel motion | **Continuous**, on a circular rail [S: DA p. 47] |
| Precession period | **25,804 years** [S: DA p. 26] (CATH's 25,806 [Sn] is close) |
| Rooster size | **Life-size** [S: DA p. 59–60]. Still no number. |
| Night behaviour | **The ages are silent at night; Death strikes day and night** [S: DA p. 58, 65] |

### Still open after pass 2

- Case width (7.70 vs 8.60 m) and depth, and every dial diameter except the calendar ring. DA gives
  none.
- The drive of the mobile horizon; the mechanisms for leap-day insertion and Easter transfer; the
  computus internals.
- LEF, CLEA and ELS: not downloadable automatically (403 or no DNS). **Paul to download them.**
- Photos: Wikimedia rate-limited this session.

---

## Phase 0 research pass 3 (31 Oct 2026): the documents Paul shared privately via Google Drive

These are copyrighted (LEF, CLEA) or of unknown status (ELS), so they are **not** in this public
repo. They were read in full from Paul's Drive. Key quotes were checked against the extracted text,
and the Lefort gear table against its page image.

### Sources identified

| Key | Identification |
|---|---|
| **ELS** | **Alfred Ungerer** ("Fabricant d'Horloges à Strasbourg, Successeur de SCHWILGUÉ"), with A. Danjon and G. Rougier [?] (Strasbourg Observatory), "L'horloge astronomique de la cathédrale de Strasbourg". Lecture to the Société astronomique de France, 15 Dec 1920, published in ***L'Astronomie*** 1921 in five instalments: **i1** March, pp. 89–102; **i2** April, from p. 147; **i3** May, from p. 196; **i4** June, from p. 250; **i5** later in 1921. The Drive text has no page breaks, so facts are cited by instalment. The instalment is inferred from each passage's position between the footnotes that open each instalment, so allow for an error of one either way. |
| **LEF** | J. Lefort, "L'horloge astronomique de la cathédrale de Strasbourg", 17 pp. Its single source is A. & Th. Ungerer, *L'horloge astronomique de la cathédrale de Strasbourg*, Imprimerie alsacienne, 1922. Its figures are reproduced from Ungerer (one carries Ungerer's caption "Fig. 49"). |
| **CLEA** | G. Paturel (Observatoire de Lyon) & P. Dubois (Observatoire de Strasbourg), *Cahiers Clairaut* n°102, summer 2003, pp. 6–11, "largement inspiré" of Bach & Rieb. **It gives no dimensions.** |
| DA 7th ed. | 1854, Veuve Dannbach. The same text as the 1844 edition; nothing new for the replica. It contains the same workshop lithograph of the clock (used in `envelope.md` §4a). |

### Corrections to earlier entries

- **Width resolved: 7.70 m is the current case.** "l'auteur s'est imposé de conserver l'ancien
  édifice, construit en pierres de taille, de 7m,70 de largeur à la base, et de 18 mètres de
  hauteur, le couronnement gothique compris" [S: ELS i1].
  - The [Sn: WIKI] reading that tied 7.70 m to the first clock is superseded.
  - ODY's 8.60 m is still unexplained [?].
- **Height [?].** DA says the clock's "élévation … n'est pas moindre de 20 mètres" [S: DA p. 62, page
  image; the 1844 OCR misreads it as 50]. ELS's explicit 18 m, crown included, is used.
- **Year formula explained.** LEF's gear table (Ungerer's fig. 49, page image checked) gives the
  planetarium's Earth train: "Terre: A = A′; b/B = 9/156; c/C = 10/188; d/D = 10/269" [S: LEF].
  - CLEA prints the product as "= 365,2422 tours" with no arbor named [S: CLEA p. 9].
  - The product is 8765.8133, which equals LEF's year of 31,556,928 s ÷ 3600. So **the planetarium
    input A turns once per hour** (inference [D]), and the "×24" puzzle is resolved.
- **The CLEA Moon train is the planetarium's Moon.** The same table gives "Lune: k/K = 83/122;
  l/L = 14/196; J/j = 312/24" [S: LEF]. These are exactly CLEA's differential numbers, so that train
  belongs to the planetarium and the Moon globe mechanism.
- **Lefort's 11.70 m is the 1354 clock** [S: LEF p. 2]: a wooden cage; lower front about 4 m square;
  calendar 2.80 m.
- **Precession.** "25 806 ans, période de la précession fournie par la constante de Bessel
  (50″,22)" [S: ELS i3]. DA (1844) says 25,804. Both are primary sources.
- **Apostle height [?].** On the workshop plate the figures are drawn about 0.70 m tall [E], against
  the 18 in of WIKI. Unresolved.

### Dimensions (ELS)

| Item | Value | Instalment |
|---|---|---|
| Main dial | "un cadran de 2m,30 de diamètre, divisé en 2 fois 12 heures, qui représente le plan de l'équateur" | i1 |
| Northern hemisphere, noon | "Au milieu et en avant du cadran … est disposé un **disque légèrement bombé** qui représente l'hémisphère terrestre boréal; **le méridien de Strasbourg est verticalement au-dessus du pôle Nord**, qui est figuré au centre. … **Lorsque le Soleil passe au méridien de Strasbourg, l'aiguille est verticale.**" So true noon is at the top, and the hemisphere is a shallow dome (PR #4 choice confirmed). | i1 |
| Sun hand | "exactement de 1 mètre, un degré équivaut à 17mm,45" | i2 |
| Sun / Moon / shadow discs | 9.3 / 9.1 / 24.3 mm (OCR "g" read as 9; consistent with 32′ × 17.45 mm/° [D]) | i2 |
| Eclipse (latitude) cam | mean radius 134 mm; "R = 154mm,2 et r = 113mm,8" | i2 |
| Planetary dial | "Autour d'un cercle de 2m,20 de diamètre sont peints les douze signes du Zodiaque". Planet arbors on a crown of 20 cm radius; each planet uses an intermediate wheel of at most 250 teeth [agent extraction; not re-checked]. | i2 |
| Moon globe | "un globe de 40 centimètres de diamètre, mi-partie doré, mi-partie noir"; axis tilted about 40° | i3 |
| Celestial sphere | "une sphère en cuivre de 0m,84 de diamètre, peinte en bleu"; polar axis "incliné de 48°35 sur l'horizon" | i3 |
| Calendar ring | "un anneau de 2m,73 de diamètre extérieur et de 21 centimètres de large, divisé en 368 fuseaux". The forged-iron rings are "2m,73" in diameter (i5). This conflicts with DA (1844): 25 cm × circumference > 9 m [?]. | i4 |

### Mechanisms (ELS, verbatim where quoted)

**Drive [i1].** "Le régulateur, à force constante, est muni d'un pendule compensateur à grille,
battant la seconde de temps moyen, avec échappement Graham-Schwilgué. Ce régulateur déclanche toutes
les cinq secondes un rouage moteur qui met en mouvement toute la partie astronomique de l'horloge".
(Constant-force regulator, gridiron seconds pendulum; it releases the astronomical train every 5 s.)

**Time [i1].**
- "Les aiguilles dorées donnent le temps moyen de Strasbourg; les aiguilles argentées, ajoutées en
  Mars 1919, donnent l'heure légale."
- "L'heure de Strasbourg avance d'environ 31 minutes sur celle du méridien de Greenwich".

**Sunrise and sunset [i1].** "Deux aiguilles (11) portant les inscriptions « Lever du Soleil » et
« Coucher du Soleil » sont actionnées symétriquement par une courbe décrivant un tour en une année".
(Two hands moved symmetrically by a cam turning once a year, in true time.) DA's "horizon mobile" is
this pair of hands.

**Solar equation [i1].**
- Cams use a scale of "6mm de déplacement vertical pour un degré de correction".
- The conversion to right ascension uses a helical pinion: "La pente de l'hélice … est de 12°13′",
  cut on a special machine Schwilgué built.

**Lunar equations [i2].**
- Five cams: reduction, annual equation, variation, evection, equation of the centre. "L'amplitude
  totale de la somme des cinq équations est de 102mm,7".
- Evection follows Burckhardt's tables.

**Calendar [i4].**
- The ring "est posé sur deux galets … Il avance chaque jour à minuit d'un fuseau, sous l'action d'un
  moteur spécial déclanché par le rouage de temps moyen, **le jour qui commence venant alors sur la
  gauche de l'anneau, en face de la flèche**" (it rests on two rollers and advances one division
  each midnight, driven by a special motor released by the mean-time train; the new day arrives on
  the **left** of the ring, facing the arrow).
- Letters A–G, with A on 1 January: "les lettres se succédant dans leur ordre naturel, et se
  répétant 52 fois dans l'année. Au 1er janvier correspond la lettre A."
- **29 February carries F** on the original (Paul, PR #6 comment, 3 Nov 2026). ELS does not say. It
  agrees with the traditional reckoning, in which the intercalated day is a doubled 24 February,
  letter F [D: 24 Feb is day 55 and (55 − 1) mod 7 = 5, which is F].

**Calendar ring as seen today** [S: Paul's photograph of the original, IMG_9952, taken about
1 November 2026, shared in PR #6; crop in `docs/img/m2/original_calendar_band.jpg`]
- **Direction.** Down the left side the dates run from late September (N.D. de la Merci, s. Cyprien,
  s. Michel) through OCTOBRE to mid-November (Toussaint, Les Trépassés, s. Martin, s. Elisabeth).
  Apollo's hand is at about 1 November, the day of the photograph.
  - So the year runs **counter-clockwise** round the ring, the ring **turns clockwise**, and
    tomorrow is **just below** the arrow.
  - This settles the question ELS and DA leave open.
- **Layout across the band, outside in:**
  1. the month name, along the outer edge, reading clockwise with its tops outward (OCTOBRE,
     SEPTEMBRE);
  2. the day number, reading inwards;
  3. the dominical letter, light letters in a dark column;
  4. the saint's name.
  Fixed and movable feasts are labelled in small black boxes (for example "Quatre Temps").
- **Dominical letters** read 15 Oct = A, 22 Oct = A, … This agrees with A on 1 January [ELS i4]
  [D: 15 Oct is day 288 of a common year, and (288 − 1) mod 7 = 0, which is A].
- **Main dial:** XII at the top, numerals rising clockwise; "TEMPS APPARENT" in gold near the top;
  the sunrise and sunset hands are labelled "LEVER DU SOLEIL" (left) and "COUCHER DU SOLEIL" (right).

**Leap day [i4]** (the most original part, per ELS):
- 1 January – 28 February are painted on a movable sector that can advance or retreat one division.
- Three divisions after 31 December read "COMMENCEMENT DE L'ANNÉE commune". In leap years the
  sector covers "commune" and uncovers 29 February, which is painted on the ring itself.
- The New Year advance is 4 divisions in common years and 3 in leap years.
- How the advance is extended:
  - A projection S behind the ring holds the motor's stop lever L up for the extra divisions.
  - A movable cam E lengthens S in common years.
  - E is controlled by wheel C, which "avance d'un centième de tour chaque année" through a
    6-point star struck by a fixed 3-tooth rake.
  - C carries 24 projections, for years 4, 8, … of each century.
  - "La 25e saillie … portée par une roue satellite, qui fait un quart de tour pour chaque tour de
    la roue C … vient en place seulement tous les 400 ans".
- The sector itself is moved by a connecting rod, driven by a second 6-point star meeting another
  fixed 3-tooth rake during the 31 December advance.

**Movable feasts [i4].**
- Each feast is on a strip covering one division.
- "Celles de ces fêtes qui dépendent de Pâques sont réunies par un cercle en fer qui peut glisser
  sur des galets sur le bord intérieur du calendrier" (the Easter-dependent feasts are joined by an
  iron circle sliding on rollers along the ring's inner edge).
- The two last Ember days, St Arbogast and the first Sunday of Advent are handled separately.

**Computus [i4–i5].**
- An epact disc carries "un limaçon à degrés … du 21 mars au 18 avril. D'un degré à l'autre, le
  rayon du limaçon augmente de la même quantité (4 millimètres)" (a stepped snail covering the
  possible dates of the Paschal 14th day, 21 March–18 April, with 4 mm per step).
- Piece N and cam x, on the golden-number arbor, apply the Gregorian rule for epact XXV/25: XXV is
  treated as XXIV if the golden number is ≤ 11, otherwise as XXVI.
- "Un grand rateau R … porte un bras R′ muni d'un talon qui vient s'appuyer sur le limaçon" (a great
  rack R whose heel rests on the snail). Each step moves the rack one day. In the small 1821 model
  this rack carries the Easter hand.
- Released at midnight between 31 December and 1 January [i1].
- Further details (a 14-tooth jumper wheel, a 10-tooth rack, discs turning in 2400 and 2500 years)
  are reported by the extraction agent and not re-checked.

**Rooster [i5].**
- It crows three times while flapping its wings, as Christ makes the sign of the cross.
- "L'appareil qui produit le chant du coq est placé sous le couronnement de l'horloge" (under the
  crown).
- How it works:
  - A bellows is inflated when wire a lifts weight b. When the crow is due the wire is "subitement
    lâché" (suddenly released), and the weight presses the air out.
  - The air "fait vibrer une anche g … constituée par une bandelette de papier tendu, quel que soit
    l'état hygrométrique de l'air, par le ressort l".
  - A trumpet f aimed at the rooster amplifies the sound.
  - Modulation: lever D opens the exhaust valve more or less, driven by cam d through pinion e on
    rack E, which is fixed to the bellows' moving wall. "Au début du chant, le son est clair et
    strident; mais à mesure que … la pression diminuant, le chant devient de plus en plus grave."

**Schwilgué's machine tools [i5].**
- A dividing and cutting engine for spur and bevel wheels.
- "une machine servant à déterminer automatiquement la forme épicycloïdale des courbes des dents"
  (the original's teeth are **epicycloidal**).
- A large lathe for the 2.73 m calendar rings.
- A planer for straight and helical pinions.

### Facts from LEF and CLEA beyond the above

- **LEF.** Lunar daily motion comes from "un arbre qui fait un tour en 2 h", through 334/28 × 65/341
  × 300/57 = 12 × 271,375/272,118.
  - The lunar equation cams are driven by "un arbre faisant un tour en un jour moyen".
  - Node period "587 371 310 secondes".
  - Wheels are "limitée à environ 500 dents", the largest found 420. The largest prime 281; minimum 6
    teeth; smallest prime used alone 17.
  - The three solar corrections are not named.
- **LEF sidereal train.**
  - The sphere is driven through B; the planet pinions d + e ride on B; C + D and E + F are free on
    Z.
  - The source's check line misprints 9/94 for 9/47; the result is still exactly 164,809/164,359.
- **CLEA.** Precession "un tour tous les 26000 ans ! Depuis la construction, la rotation a été de
  moins d'une dent d'engrenage" (less than one tooth since the clock was built).
  - The eclipse example: "l'éclipse du 15 Février 1961".
  - The pendulum drift claim is hedged: "Si on croit cette estimation".
  - Bach & Rieb cited as "éditions Ronald Hirlé", with no year.

### Still open after pass 3

- Case depth.
- Sizes of the computus and equations vitrines, the weekday carousel and the dominical-letter dial.
- Figure heights (18 in vs about 0.70 m [?]) and the rooster's size.
- The three solar equation terms by name.
- Positions measured from a photo, to cross-check the plate estimates (Wikimedia rate-limited).

## Phase 1 review additions (1 Nov 2026)

Added while answering Paul's PR #3 review. Used in `spec/clock.yaml` and `docs/gear-trains.md`
§4F and §5.

### Planet mean motions [S: JPL]

- **Source.** E. M. Standish, *Keplerian Elements for Approximate Positions of the Major
  Planets*, NASA/JPL Solar System Dynamics: https://ssd.jpl.nasa.gov/planets/approx_pos.html
  (retrieved 2026-11-01).
  - Table 1 is fitted to 1800–2050 AD; Table 2a to 3000 BC – 3000 AD.
  - Elements are referred to the mean ecliptic and equinox of J2000, so the mean-longitude rates
    L̇ are sidereal.
- **Table 2a L̇, degrees per Julian century:**

| Body | L̇ |
|---|---|
| Mercury | 149472.67486623 |
| Venus | 58517.81560260 |
| Earth–Moon barycentre | 35999.37306329 |
| Mars | 19140.29934243 |
| Jupiter | 3034.90371757 |
| Saturn | 1222.11494724 |

- **General precession in longitude:** 5028.796195″ per Julian century (Capitaine et al. 2003,
  adopted by the IAU in 2006), via https://en.wikipedia.org/wiki/Axial_precession
  (retrieved 2026-11-01).
- **Tropical period [D]:** P = 360 × 36525 / (L̇ + 5028.796195/3600) days.
  - Mercury 87.968434 d; Venus 224.695437 d; Mars 686.929718 d; Jupiter 4330.598880 d;
    Saturn 10746.933232 d.
  - The Earth–Moon rate gives 365.2421884 d, against the sourced mean tropical year 365.24219 d
    (a 2 × 10⁻⁶ d check).
- **Uncertainty [E]:** the difference between the Table 1 and Table 2a periods, in days.
  - Mercury 4 × 10⁻⁷; Venus 1 × 10⁻⁶; Mars 1.2 × 10⁻⁴; Jupiter 0.22; Saturn 3.3.
  - Jupiter and Saturn are large because their mutual perturbation (the "great inequality") makes
    the mean rate depend on the span fitted.

### Correction: NASA fact-sheet tropical period of Mars [?]

- The Phase 1 draft took planet targets from NASA's fact sheets and concluded that Schwilgué's Mars
  target was off by +1.18°/century. **That was wrong.**
- The Mars fact sheet gives a sidereal period of 686.980 d and a tropical period of 686.972 d. The
  tropical value is marked "\* Mean value - the tropical orbit period for Mars can vary from this
  by up to 0.004 days depending on the initial point of the orbit":
  https://nssdc.gsfc.nasa.gov/planetary/factsheet/marsfact.html (retrieved 2026-11-01).
- **Check [D].** A mean tropical period is shorter than the sidereal one by about
  P²/P_precession: 686.980² / (25,771.6 × 365.24219) = 0.050 d, giving 686.930 d.
  - The fact sheets' Mercury row passes: 87.969 → 87.968.
  - So does the Jupiter row: 4,332.589 → 4,330.595, a difference of 1.994 d.
  - The Mars row does not: its difference is 0.008 d.
- **Schwilgué's Mars** (LEF: 686 d 22 h 18 min 43.87 s = 686.929674 d) is within 0.001°/century of
  the JPL-derived 686.929718 d.

### Tooth strength and motor inputs

- **Lewis form factor Y** for 20° full-depth teeth: Shigley, *Mechanical Engineering Design*,
  Table 14-2, as reproduced in KSU lecture notes, ch. 14, p. 8:
  https://faculty.ksu.edu.sa/sites/default/files/chapter14-spur_and_helical-esam-revise-part1.pdf
  (retrieved 2026-11-01). Examples: 12 teeth 0.245, 17 teeth 0.303, 50 teeth 0.409, 150 teeth 0.460.
- **PLA strength.** Bambu Lab PLA Basic TDS v2.0, tensile strength 39 ± 2 MPa (X-Y):
  https://www.additive-x.com/shop/mpattachments/file/viewonline/id/494/product_id/2236 (retrieved
  2026-11-01).
  - The allowable root stress of 9.75 MPa is this divided by 4 [E].
  - The local strength test replaces it.
- **Motor.** 17HS19-2004S1 (NEMA 17): holding torque 0.59 N·m at 2.0 A rated current:
  https://static.maritex.eu/file/display/5sXxpHH1SP-JwnhJEZ0lhfX-xdYKZRi3/17HS19-2004S1_Full_Datasheet.pdf
  (retrieved 2026-11-01).

### Equation cylinders: rates and scale [S: ELS]

Ungerer, *L'Astronomie* 1921 (ELS; private copy). Quotes are from the OCR text, which has no page
numbers.

- **Every equation arbor makes a half turn per period**, so each cylinder carries two periods of
  its curve. This confirms LEF's "deux périodes … deux points diamétralement opposés soient à la
  même hauteur".

| Term | Arbor | Half turn in | Total travel |
|---|---|---|---|
| Sun's equation of centre | K | 365 d 6 h 13 min 56 s | 23 mm |
| Sun's reduction to the equator | L | 365 d 5 h 48 min 48 s ("répétée 4 fois sur le pourtour") | 29.6 mm |
| Moon's reduction to the ecliptic (max 7′) | R | 27 d 5 h 5 min 35.8 s | 1.4 mm |
| Moon's annual equation (max 11′) | EA | 365 d 6 h 13 min 56 s | 2.2 mm |
| Moon's variation, with the parallactic inequality | V | 29 d 12 h 44 min 2.9 s | 7.4 mm (full-Moon side), 6.8 mm (new-Moon side) |
| Moon's evection (max 1°20.5′) | Ev | 31 d 19 h 29 min 11 s | 16.1 mm |
| Moon's equation of centre, 6°18′ sin M′ + 13′ sin 2M′ | A | 27 d 13 h 18 min 33.3 s | 75.6 mm |

- **Scale:** "l'échelle adoptée par Schwilgué est de 6mm de déplacement vertical pour un degré de
  correction".
- **Slopes:** the steepest curve (the Moon's equation of centre) has a maximum slope of 30°12′,
  "notablement inférieure à 45°, limite qu'il s'était imposée".
- **Total:** the five lunar terms sum to 102.7 mm of travel.
- **Stack order:** the lunar stack runs from the bottom in increasing amplitude (reduction,
  annual equation, variation, evection, centre; the reduction's arbor R is "le mobile inférieur"), "pour que chacun des mobiles ait le plus petit
  déplacement vertical possible".

## Paul's photographs of 30 October 2026 (M1 concept gate, PR #11)

Five photographs taken by Paul in the cathedral on 30 October 2026, 10:10–10:11 CET (EXIF:
`DateTimeOriginal` with offset +01:00; iPhone 16 Pro). Files IMG_0767 to IMG_0771, shared in PR #11.
Crop of the gallery from IMG_0766 (below): `docs/img/m1/original_gallery.jpg`.

**Mean-time dial** [S: Paul's photographs IMG_0767 and IMG_0768]
- **12-hour face**, Roman numerals I–XII in gilt on a dark ground, a pearled minute ring and an
  inner pearled ring, in a gilt bezel. This settles the 12 h or 24 h question in
  `docs/mechanism-inventory.md` I1.
- **Four hands.** At 10:10 CET the dial shows one minute hand at about :10 and one at about :41,
  nearly opposite each other, and two ornate hour hands together near X.
  - That fits legal time 10:10 CET and Strasbourg mean time 9:41 [D: LMT = UT + 31 min, CET =
    UT + 60 min, so mean time = CET − 29 min, and 29 min is 174° of the minute circle].
  - So the silver hands show CET and the gold hands mean time, as ELS says.
  - A winter photograph cannot show whether the silver hands follow summer time.
  - At this resolution the hands' colours and their front-to-back order cannot be read.
- **Size** [E]. Scaled on the calendar ring's outer diameter (2.73 m [S: ELS]), the pearled minute
  ring is about 0.83 m across and the bezel about 0.98 m. Method: widths measured on IMG_0768 and
  corrected by about 1.11 for the dial's greater distance from the camera, from a ≈ 6 m stand-off
  and a ≈ 2.9 m height difference [E]. Uncertainty about ±15 % (wide-angle lens, upward view). That
  agrees with envelope §3's 0.78 m [E], so about 98–104 mm at 1:8.
- **The genies** sit either side of the dial, at about its height [E: same photographs].

**Lower hall** [S: Paul's photographs IMG_0769 and IMG_0770]
- Death stands on a pedestal holding a bone in its right hand and the scythe in its left, with
  **a bell on each side**. DA mentions "le timbre à sa droite" [S: DA p. 57–58]. Which bell the ages
  strike is for E2's design.
- These two photographs frame only the centre of the hall, so they do not show the doorways where
  the ages wait. (An earlier note here said "no age is in view"; the 2011 photograph below shows
  that two ages are in view at rest, at the doorways.)

**The lower hall at rest, 7 Dec 2011** [S: Tangopaso, Wikimedia Commons,
https://commons.wikimedia.org/wiki/File:Death_and_old_man_of_the_astronomical_clock_of_Strasbourg.jpg,
released into the public domain; original 4416 × 3312, taken 7 Dec 2011 12:24:24. Found by Paul,
6 Nov 2026. Crop: `docs/img/e2/original_lower_hall_2011.jpg`]
- 12:24 CET is 11:55 Strasbourg mean time [D: mean = CET − 29 min], between the 11:45 and 12:00
  shows. The ages' positions agree with that:
  - **the man** (third quarter) stands at the left doorway, back turned, going out;
  - **the old man** (fourth quarter, next) waits at the right, facing Death, crutch in hand.
- So **two ages are in view at rest**, and they walk **from right to left**: in from the right
  doorway, strike the bell at the viewer's right of Death, on in front of Death, out by the left
  doorway. This agrees with Paul's observation.
- **The hall.**
  - Death stands on a low pedestal in the middle.
  - The two bells hang mouth down from curved brackets on posts, either side of Death at waist
    height.
  - The back wall is arcaded, with a doorway at each end. The front is convex, a shallow bay.
- **Measured** [E] in the 2000 × 1500 copy, as fractions of the hall's width W at the vault's
  front edge (1433 px), with W = 1.46 m ±11 % (envelope §3):
  - Death: 0.349 W tall as seen. Corrected for the upward view by 1/cos θ, with θ = 30–40° from the
    bells' rim ellipses (axis ratio 0.58–0.64), that gives **≈ 0.62 m (0.52–0.74 m), ≈ 78 mm at
    1:8**.
  - Old man: as tall as Death, though stooped. The man appears about 0.8 of Death, but he is
    turned away in the doorway.
  - Bells: **0.113 W across, ≈ 0.17 m, ≈ 21 mm at 1:8**. Their centres are ±0.133 W from Death's
    axis (≈ 24 mm at 1:8).
  - Doorways at ±0.42–0.51 W. Waiting ages at +0.41 W and −0.46 W.
- This replaces the bell estimate above (25–40 mm), which had assumed Death's height.

**Upper hall** [S: Paul's photograph IMG_0771]
- Christ holds the banner of the redemption in his left hand and blesses with his right, as DA
  describes [S: DA p. 58–59].

### The second set: IMG_0759 to IMG_0766 (30 October 2026, 10:08–10:10 CET)

**Lion gallery** [S: IMG_0766, 35 mm-equivalent, the sharpest view of the dial]
- **Lettering.** The dial reads "TEMPS MOYEN" on an arc above the centre and "HEURE PUBLIQUE" below.
  A few small letters beside them are not legible.
- **Numerals and track.** Four is written IIII. A minute track carries small figures 5 … 60 outside
  the chapter ring.
- **Hands, by colour.** The **silver** minute and hour hands show 10:10, the legal time. The **gilt**
  ones show 9:41, the mean time.
  - The gilt minute hand has an ornate tip, and the gilt hour hand an openwork fleur.
  - Both silver hands are plain spears.
  - A gilt cap covers the centre.
  - **The silver hour hand lies over the gilt hour hand.** The minute hands' order is hidden by the
    cap.
- **Frame.** The dial sits in an arched, moulded stone-coloured frame on green marbling, between the
  two genies' ledges. Its top reaches the planetary dial's band.
- **Genies.** Winged children seated on the cornice: on the left one holds a bell and a striker, on
  the right one an hourglass. Seated height ≈ 0.63 of the bezel's diameter [E: scaled on the
  photograph], so ≈ 0.6 m on the original and ≈ 78 mm at 1:8.

**Main dial and its surroundings** [S: IMG_0761–0764]
- "TEMPS APPARENT" in gilt capitals on the dark field, above the centre. The chapter ring is a light
  band with black Roman numerals I–XII twice, XII at the top, and four-pointed stars between the
  numerals.
- The sunrise and sunset hands are black bars lettered in gilt: "LEVER DU SOLEIL" and "COUCHER DU
  SOLEIL".
- **The Earth hemisphere** is a coloured map disc, the northern hemisphere centred on the pole,
  lettered AFRIQUE, EUROPE, ASIE, AMÉRIQUE, OCÉAN ATLANTIQUE, GRAND OCÉAN, Tropique du Cancer.
  - **It stands on its own black iron stand in front of the dial.** The hands' hubs and the
    sunrise and sunset hands pass behind it.
  - **Its size is ≈ 0.75 m ±20 %** [E]: ≈ 0.40 of the dark field's width in IMG_0761, corrected a
    little for the disc being nearer the camera. The field is ≈ 1.97 m if the chapter ring's outer
    edge is ELS's 2.30 m.
  - That is ≈ 85–105 mm at 1:8, **about twice the 46.5 mm dome in the M2 model**, which was sized
    only to hide the latitude cam (`docs/main-dial-feasibility.md` §2).
  - **Paul chose to match it** (4 Nov 2026, option B): Ø 94 mm on the same fixed arbor
    (`docs/m2-design.md` §7). The stand is not copied.
- Weekday figures on either side of the main dial: Apollo (sun crown, arrow pointing at the
  calendar ring) on the left, Diana (crescent) on the right.

**Main dial's colours today** [S: IMG_0761–0764]
- The field is dark slate blue. The chapter ring is a light gilt band with **black** Roman numerals
  and black four-pointed stars between them. "TEMPS APPARENT" is in gilt.
- DA (1844) describes "peint en azur … cercle en argent", which the M2 dial print follows: an azure
  field, a silver ring, azure numerals (`docs/m2-design.md` §7). So today's colours differ from
  DA's.
  - **Paul (4 Nov 2026): keep DA's 1844 scheme for now.**

**Weekday chariots (M7)** [S: IMG_0766; D: 30 Oct 2026 was a Friday]
- On Friday the centre opening below the gallery shows **Venus's chariot, lettered "VENUS" and
  "VENDREDI"**, with Cupid. Saturn's (with a child) is in the left niche and Jupiter's (drawn by an
  eagle) in the right.
- The wheels face the viewer, so the chariots run across the opening, parallel to the facade.
  They follow DA's "chemin de fer circulaire" in a horizontal plane: **the carousel turns about a
  vertical axis.** This settles the open point in `docs/m2-design.md` §3 item 2 for M7. M7 needs the
  right-angle pair the architecture allowed for (§4).

**Celestial globe (M6)** [S: IMG_0762–0764]
- A dark blue globe with gilt stars and constellation lines, on four columns.
- It has a horizon ring, a graduated brass meridian ring (POLE BORÉAL, ZENITH), and a small hour
  ring at the pole. The silvered rings are graduated in degrees: 0–90 on the meridian, 0–360 around.

**Equations vitrine (M3)** [S: IMG_0762]
- Lettered "ÉQUATIONS SOLAIRES & LUNAIRES": vertical cam stacks with their followers behind glass,
  to the right of the main dial.

**Computus (M4, v2)** [S: IMG_0759, IMG_0760]
- Lettered "COMPUT ECCLÉSIASTIQUE", with an arched window "POUR L'AN DE GRÂCE" showing **2026**.
- Five dials: cycle solaire (1–28), nombre d'or, indiction (1–15), lettre dominicale and épacte.
- The indiction hand points at **4**, which is right for 2026 [D: (2026 + 3) mod 15 = 4].
- Open brass wheels and steel racks are visible behind the dials. This is a reference for M4's
  design.

## Paul's observations of the clock in action (30 October 2026)

From Paul's own video and his review of YouTube videos of the shows. Tagged [S: Paul's observation of the clock in action, 30 Oct 2026, his video and YouTube videos]
where used elsewhere.

- **Who strikes which bell.**
  - The genie left of the mean-time dial strikes his hand bell.
  - The ages strike the bell at the viewer's right of Death.
  - Death strikes the bell at the viewer's left, its own right (DA: "le timbre à sa droite").
- **The quarters.** At the n-th quarter the genie and the age strike n pairs: genie, age, and so on,
  one pair at :15 up to four pairs on the hour. The age walks out in front of Death, strikes, and
  walks on past Death.
- **The hour (the noon show).** After the fourth quarter's four pairs, Death strikes the hour on its
  bell: 12 times at noon.
- **The cadence of a pair** [S: Paul, PR #15, 6 Nov 2026]. The genie's bell sounds first. One second
  later the age beside Death strikes its bell: the old man, at the noon show. Then there is a
  two-second pause, and the pair repeats, four times for the old man.
- **Death's cadence** [S: Paul, PR #21, 8 Nov 2026]: one stroke on its bell every 3 seconds.
- **The walk and the hour** [S: Paul, PR #15, 6 Nov 2026, from his video].
  - After the old man's fourth stroke he starts walking. It takes about 10 seconds to reach the
    other side of Death, and then the next age comes into view.
  - Death starts tolling the hour immediately.
  - The next age to come into view is **the child**, who strikes at :15. That is the quarter order
    (Paul confirmed, 6 Nov 2026, after first naming the youth).
- **The ages' sizes** [E: Paul, from his video, 6 Nov 2026].
  - The child is about ¾ the height of the old man.
  - Otherwise the figures are not very different in size. They are told apart by their
    appearance.
- **The hourglass.** The right-hand genie turned it during the noon show. DA says hourly, after the
  fourth quarter and before Death [S: DA p. 51].
- **The Apostles.**
  - They pass Christ after Death's last stroke.
  - Each turns to Christ, faces forward again and moves on.
  - As each passes beneath Christ's outstretched arm, Christ lowers it slightly in blessing.
  - DA's final cross blessing after the last Apostle is not in this account [?].
- **The rooster** crows once after the 4th, 8th and 12th Apostle.
- **Timing.** The noon show runs at about 12:30 CET, because the clock shows Strasbourg mean time.
  This is already in D2: mean noon is 12:29 CET [D: LMT = UT + 31 min].

## Paul's photographs IMG_0762–0764 and IMG_0766, full resolution (added 8 Nov 2026)

Committed by Paul to `docs/img/photos/` (PR #20). Measured in `docs/m5-design.md` §14,
`docs/m6-design.md` §14 and `docs/m7-design.md` §12; the main results:

- **Planetary dial** [S: IMG_0766; E: sizes]. The six spheres stand at the planets' mean
  heliocentric longitudes for 30 Oct 2026, 09:08 UT, within 6° [D], so the dial shows mean
  motions. The zodiac is graduated 0–360 counter-clockwise, Bélier (0°) at the right. Orbit radii
  at 1:8 ≈ 15, 25, 42.5, 62, 85 and 132 mm. A raised dark central disc ≈ 0.76 m (≈ Ø 95 mm at
  1:8); the gilt Sun only ≈ 0.15 m. The field is dark slate today (DA: azure).
- **Moon globe** [S: IMG_0766]. Gilt with a dark crescent on the right, on a starry blue ground;
  the Moon was waning gibbous (19.2 days [D]).
- **Weekday chariots** [S: IMG_0766; E: sizes]. The day's chariot stands in the open between two
  arched niches in the cavity's back wall; its neighbours show through the niches. Chariot ≈
  0.50 m long, ≈ 0.48 m tall with its figure; the niche chariots ≈ 0.61 m either side; carousel
  radius ≈ 0.8 m (≈ 100 mm at 1:8).
- **Celestial globe** [S: IMG_0762–0764; E: sizes]. Four columns on a round stone plinth carry a
  wide horizon ring (≈ 1.4 m). A brass meridian ring lettered "PÔLE BORÉAL" and "ZÉNITH"; a large
  hour ring at the pole (≈ half the globe); silvered graduated circles that turn with the globe.
  Constellation figures are drawn in outline. The meridian ring runs square to the facade, the
  north pole apparently raised towards the case [E: two oblique views].
