paulforrester/horloge-astronomique/sim/report.md

# Simulator report

Generated by `python -m sim validate --write`. Do not edit by hand.
Design: `docs/firmware-design.md` §11. Train checks: set at 2027-01-01, run 100 years.

## Checks (pass or fail)

| Row | Check | Worst | Budget | When | Samples | Result | Note |
|---|---|---|---|---|---|---|---|
| 1 | Mean-time hour hand (I1), Strasbourg mean time | -0.625 s | ±1.13 s | 2090-09-21 21:28:25 UTC | 37125 | pass | drift 0.0000°/century; 1 µstep = 9.37e-03° |
| 2 | Legal-time hour hand (I2), every summer-time change | -1 s | ±1.13 s | 2027-05-13 19:36:19 UTC | 37125 | pass | drift 0.0000°/century; 1 µstep = 9.37e-03° |
| 2b | Legal 24 h wheel on M1b (noon release), every change | -1 s | ±1.13 s | 2027-02-27 18:29:07 UTC | 37125 | pass | drift 0.0000°/century; 1 µstep = 4.69e-03° |
| 3 | Calendar ring date, every day 2026-2099 | 0 wrong days | 0 |  | 27028 | pass |  |
| 3 | Calendar ring in 2100 (v1 limit; the computus fixes it in v2) | 365 wrong days | 0 | 2100-01-01 | 366 | pass | expected: v1 counts 2100 as leap |
| 4 | E6 divisions per night: 1, or 4 / 3 into 1 January | 0 wrong nights | 0 |  | 27027 | pass | 26954 × 1, 55 × 4, 18 × 3 |
| 5 | Weekday carousel drive (I11) | -0.000372 ° | ±0.000671 ° | 2102-03-08 09:52:34 UTC | 37125 | pass | drift 0.0000°/century; 1 µstep = 6.70e-04° |
| 6 | Sun hand (I3), mean | -0.625 s | ±1.13 s | 2090-09-21 21:28:25 UTC | 37125 | pass | drift 0.0000°/century; 1 µstep = 4.69e-03° |
| 7 | Year arbor (M2.year): the Sun's mean longitude | -0.0121 ° | ±0.0131 ° | 2126-12-31 05:47:28 UTC | 37125 | pass | drift 0.0116°/century; 1 µstep = 1.28e-05°; reference ±0.0015°/century |
| 8 | Moon hand (I4), mean | -0.948 ° | ±0.972 ° | 2126-12-31 05:47:28 UTC | 37125 | pass | drift 0.9429°/century; 1 µstep = 4.53e-03°; reference ±0.025°/century |
| 9 | Moon-phase globe (I15): mean elongation | +0.946 ° | ±0.968 ° | 2127-01-01 21:33:27 UTC | 37125 | pass | drift 0.9429°/century; 1 µstep = 1.59e-04°; reference ±0.025°/century |
| 10 | Planetarium Earth arm (M5.earth) | -0.0121 ° | ±0.0131 ° | 2126-12-31 05:47:28 UTC | 37125 | pass | drift 0.0116°/century; 1 µstep = 1.28e-05°; reference ±0.0015°/century |
| 10 | Mercury (I14) | -0.0961 ° | ±0.0961 ° | 2126-12-31 05:47:28 UTC | 37125 | pass | drift 0.0961°/century; 1 µstep = 5.33e-05° |
| 10 | Venus (I14) | +0.538 ° | ±0.538 ° | 2127-01-01 21:33:27 UTC | 37125 | pass | drift 0.5385°/century; 1 µstep = 2.09e-05° |
| 10 | Mars (I14) | -0.668 ° | ±0.668 ° | 2127-01-01 21:33:27 UTC | 37125 | pass | drift 0.6681°/century; 1 µstep = 6.82e-06° |
| 10 | Jupiter (I14) | -0.522 ° | ±0.522 ° | 2127-01-01 21:33:27 UTC | 37125 | pass | drift 0.5224°/century; 1 µstep = 1.08e-06° |
| 10 | Saturn (I14) | +0.514 ° | ±0.514 ° | 2127-01-01 21:33:27 UTC | 37125 | pass | drift 0.5139°/century; 1 µstep = 4.36e-07° |
| 11 | Planetarium Moon arm (M5.moon_arm): mean elongation | +0.581 ° | ±0.603 ° | 2126-12-29 16:58:42 UTC | 37125 | pass | drift 0.5780°/century; 1 µstep = 1.59e-04°; reference ±0.025°/century |
| 12 | Celestial globe (I16): mean sidereal time | +36.2 s | ±37.4 s | 2126-12-29 16:58:42 UTC | 37125 | pass | drift 0.1504°/century; 1 µstep = 4.70e-03°; reference ±0.001°/century |
| 14 | Catch-up: E6 runs = mean midnights passed; J follows the changes | 0 bad scenarios | 0 |  | 7 | pass | 1 h, 1 day, 30 days, across New Year 2028, across the autumn change 2027, across the spring change 2028, a year, 2027-2028 |

Rows 13 (the show schedule) and 1-2's law are also covered by the firmware host tests
(`firmware/tests/test_host.py`): the C++ law equals `sim/timelaw.py`, and every scheduled
quarter falls on :00/:15/:30/:45 of Europe/Paris time.

## Sky gaps (v1's mean motion against the true sky; reported, not failed)

Skyfield with JPL DE440s; 2026 onward, 6-hour steps.

| Quantity | Min | Max | Unit |
|---|---|---|---|
| Sun hand: true apparent time − mean time (equation of time) | -14.2 | +16.5 | min |
| Moon: true − mean longitude | -7.98 | +8.01 | ° |
| Moon phase: true − mean elongation | -19.4 | +19.4 | h of phase |
| Mercury: true heliocentric − mean (best-fit phase) | -23.5 | +23.9 | ° |
| Venus: true heliocentric − mean (best-fit phase) | -0.771 | +0.884 | ° |
| Earth: true heliocentric − mean (best-fit phase) | -1.92 | +1.92 | ° |
| Mars: true heliocentric − mean (best-fit phase) | -11.1 | +10.5 | ° |
| Jupiter: true heliocentric − mean (best-fit phase) | -5.05 | +6 | ° |
| Saturn: true heliocentric − mean (best-fit phase) | -7.71 | +4.76 | ° |
| Globe: apparent − mean sidereal time (nutation) | -1.16 | +1.15 | s |

## Not yet checked

- v1.5 (rows 15-18): equation of time and Moon equations with M3, sunrise/sunset for Bordeaux,
  eclipses. Their budgets wait for M3 and the mobile horizon (firmware-design §11.4).
- v2 (rows 19-20): Easter, dominical letter and epact; precession.
