paulforrester/horloge-astronomique/export/print/e1_angels/silencing_cam.stl

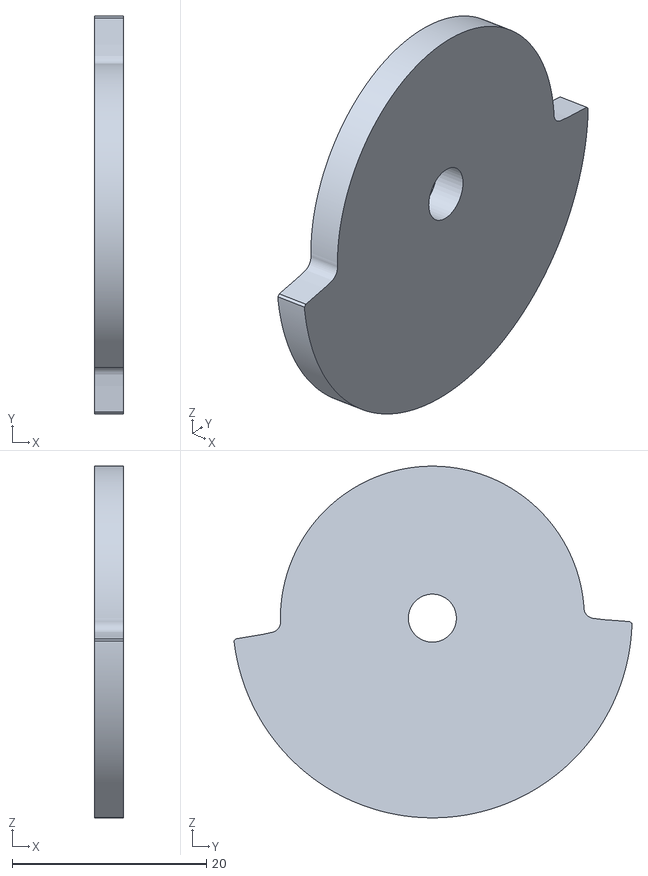
[picture p49: CAD file, 2026-11-08]
export/print/e1_angels/silencing_cam.stl
3.00 x 41.0 x 36.2
