paulforrester/horloge-astronomique/export/print/e2_ages/quarter_release_follower.stl

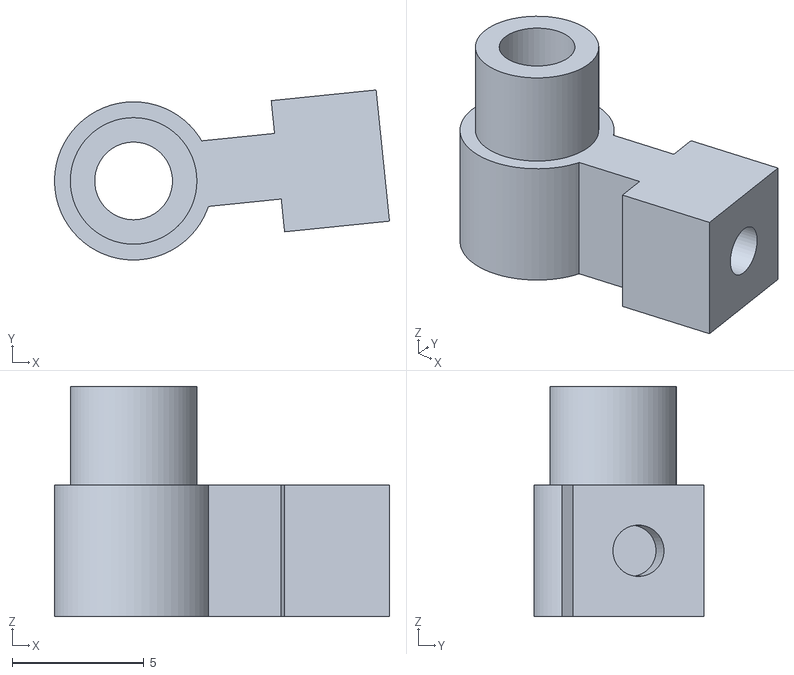
[picture p50: CAD file, 2026-11-08]
export/print/e2_ages/quarter_release_follower.stl
12.7 x 6.45 x 8.74
