paulforrester/horloge-astronomique/export/print/m1_time/hand_silver_minute.stl

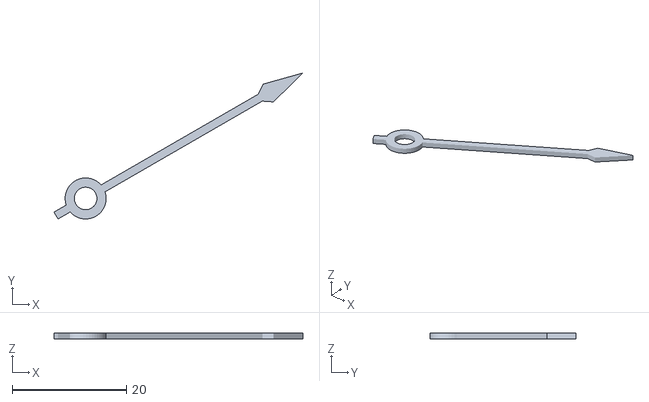
[picture p51: CAD file, 2026-11-05]
export/print/m1_time/hand_silver_minute.stl
43.7 x 25.6 x 1.00
