paulforrester/horloge-astronomique/export/print/m2_e6_fallback_pawl/e6_bracket.stl

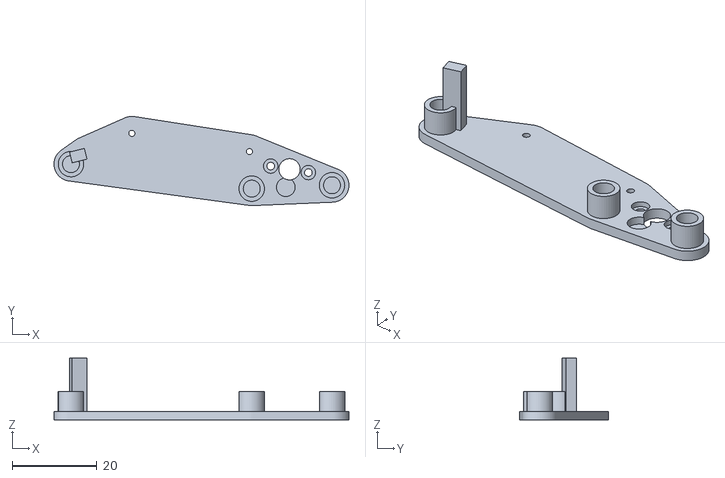
[picture p52: CAD file, 2026-11-04]
export/print/m2_e6_fallback_pawl/e6_bracket.stl
69.5 x 21.0 x 14.5
