paulforrester/horloge-astronomique/export/print/m2_main_dial/motor_adapter.stl

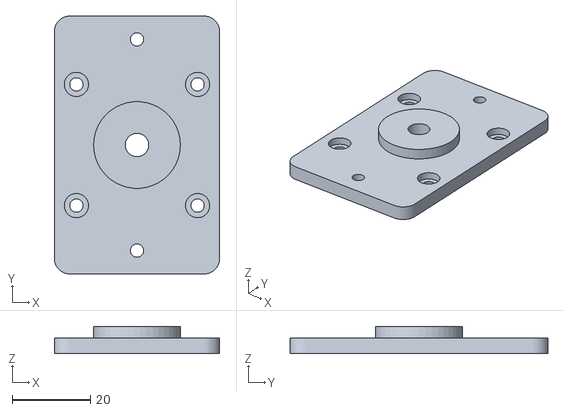
[picture p53: CAD file, 2026-11-05]
export/print/m2_main_dial/motor_adapter.stl
42.3 x 66.0 x 7.00
