paulforrester/horloge-astronomique/export/print/test_rig/sun_drive_48_B.stl

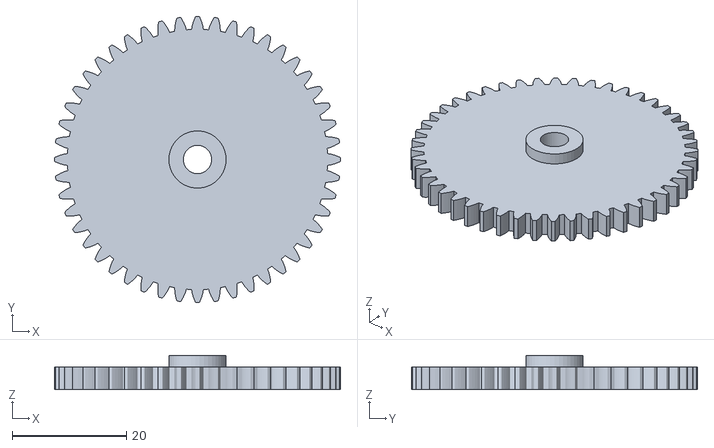
[picture p54: CAD file, 2026-11-03]
export/print/test_rig/sun_drive_48_B.stl
50.0 x 50.0 x 6.00
