paulforrester/horloge-astronomique/export/print/tolerance_coupons/gear_m0p8_b0p20_30.stl

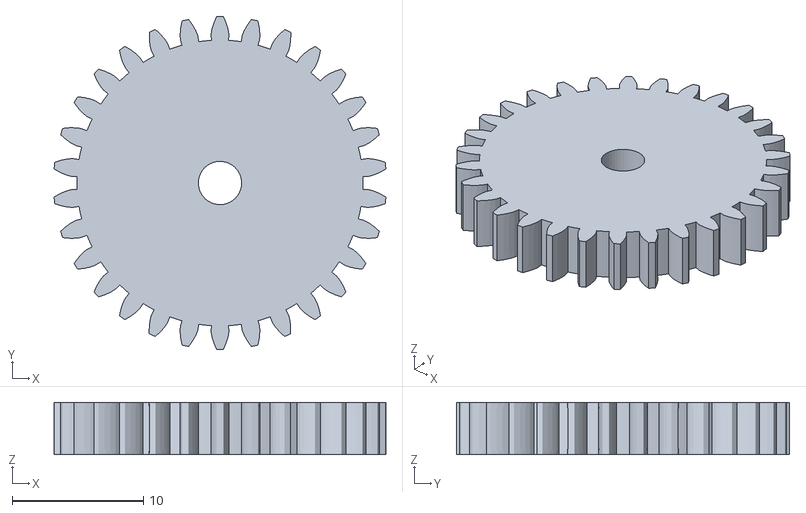
[picture p55: CAD file, 2026-11-03]
export/print/tolerance_coupons/gear_m0p8_b0p20_30.stl
25.3 x 25.4 x 4.00
