paulforrester/horloge-astronomique/export/print/e1_angels/shoulder_lever.stl

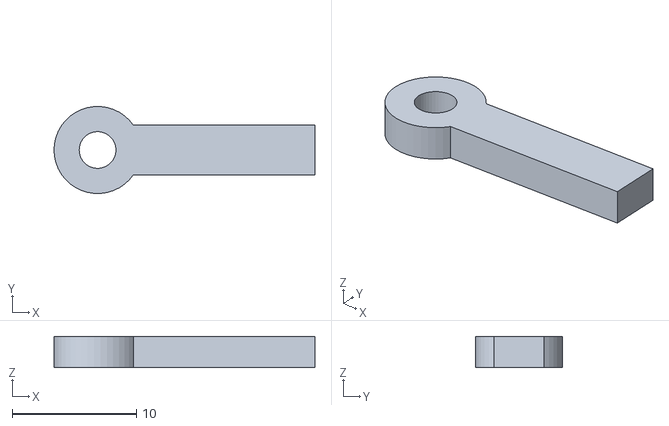
[picture p56: CAD file, 2026-11-08]
export/print/e1_angels/shoulder_lever.stl
21.0 x 6.98 x 2.50
