paulforrester/horloge-astronomique/export/print/e2_ages/hour_motor_plate.stl

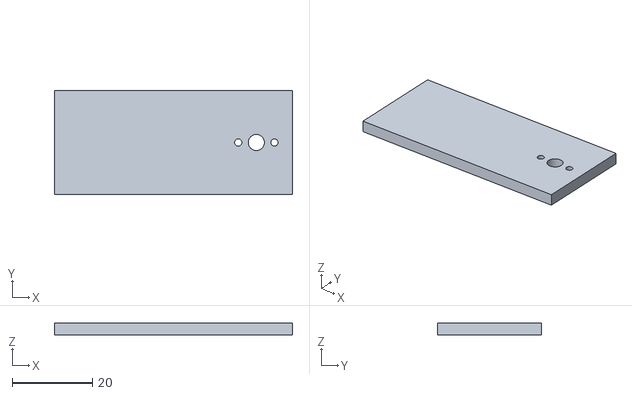
[picture p57: CAD file, 2026-11-08]
export/print/e2_ages/hour_motor_plate.stl
59.2 x 26.0 x 3.00
