paulforrester/horloge-astronomique/export/print/m1_time/stop_post_TB.stl

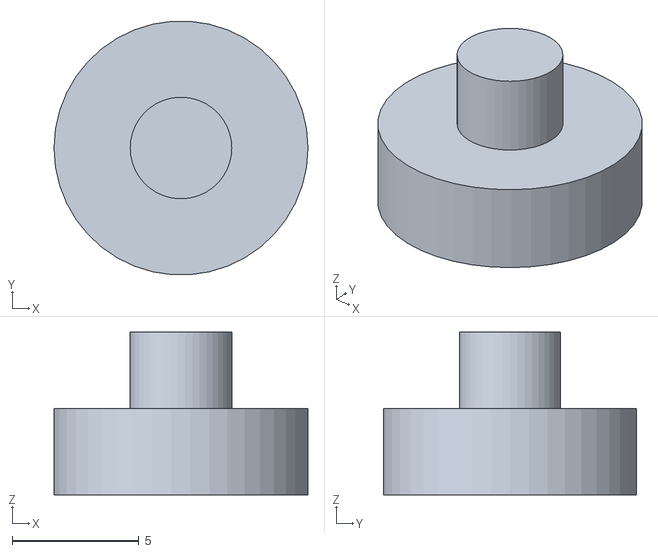
[picture p58: CAD file, 2026-11-05]
export/print/m1_time/stop_post_TB.stl
10.0 x 9.97 x 6.40
