paulforrester/horloge-astronomique/export/print/m2_e6_fallback_pawl/e6_pawl.stl

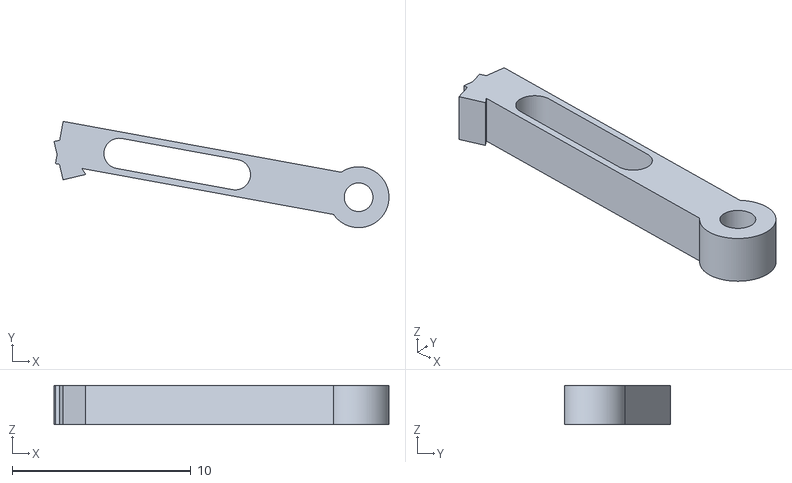
[picture p59: CAD file, 2026-11-04]
export/print/m2_e6_fallback_pawl/e6_pawl.stl
18.7 x 5.94 x 2.20
