paulforrester/horloge-astronomique/export/print/m2_main_dial/motor_pinion_12.stl

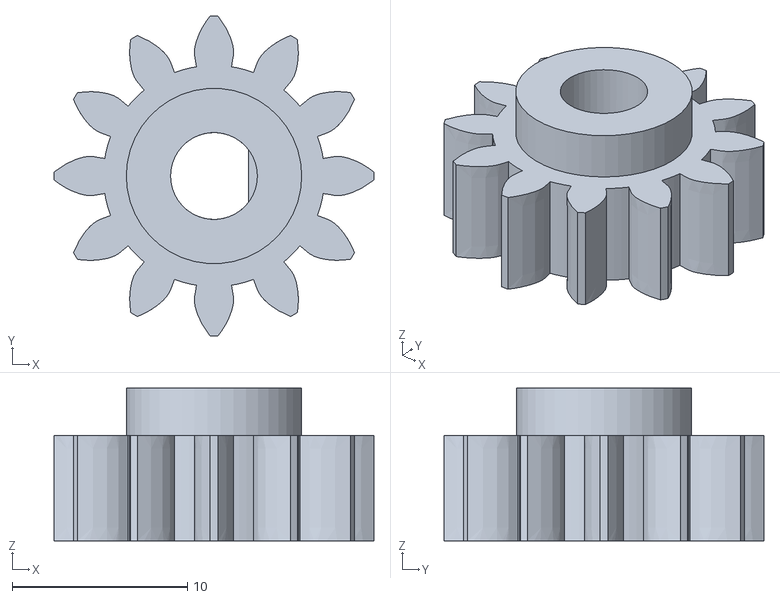
[picture p60: CAD file, 2026-11-05]
export/print/m2_main_dial/motor_pinion_12.stl
18.2 x 18.2 x 8.70
