paulforrester/horloge-astronomique/export/print/test_rig/index_flag_A.stl

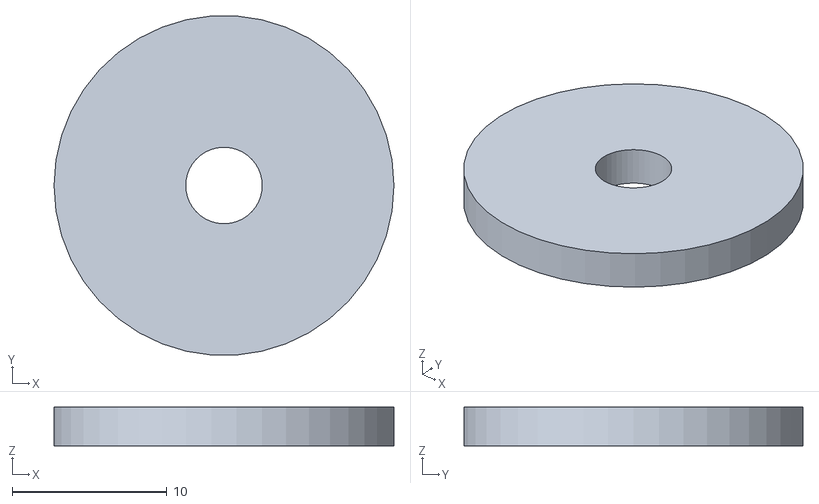
[picture p61: CAD file, 2026-11-03]
export/print/test_rig/index_flag_A.stl
22.0 x 21.9 x 2.50
