paulforrester/horloge-astronomique/export/print/tolerance_coupons/gear_m0p6_b0p15_30.stl

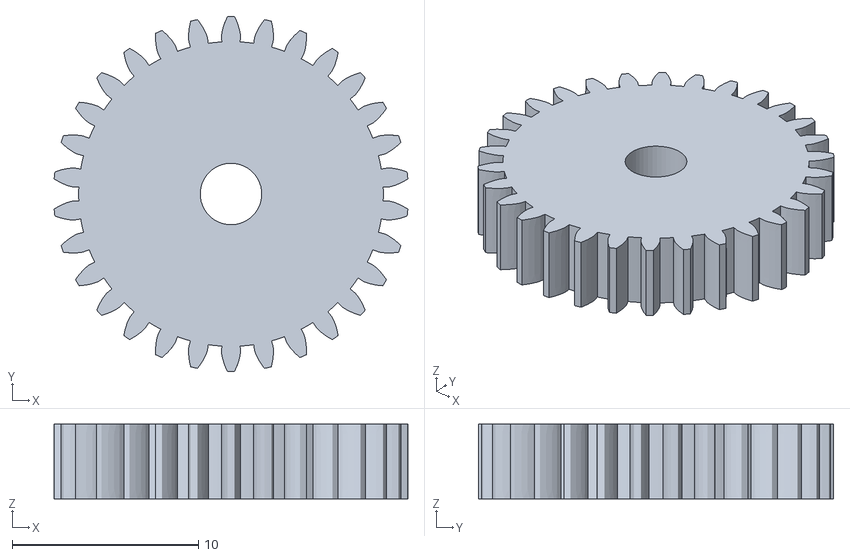
[picture p62: CAD file, 2026-11-03]
export/print/tolerance_coupons/gear_m0p6_b0p15_30.stl
19.0 x 19.1 x 4.00
