paulforrester/horloge-astronomique/export/print/e1_angels/tower_inner_plate.stl

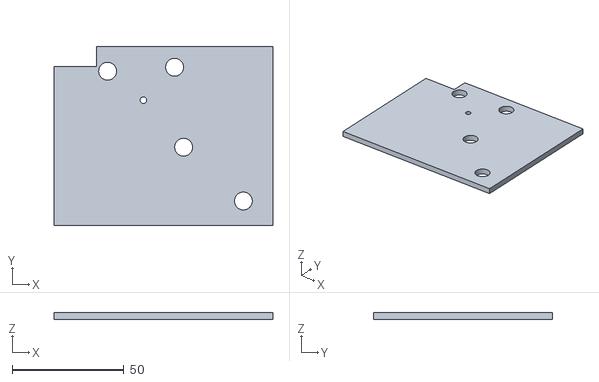
[picture p63: CAD file, 2026-11-08]
export/print/e1_angels/tower_inner_plate.stl
98.0 x 80.0 x 3.00
