paulforrester/horloge-astronomique/export/print/e2_ages/index_disc.stl

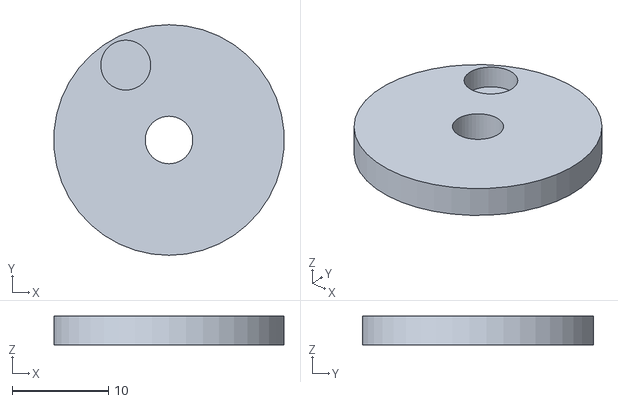
[picture p64: CAD file, 2026-11-08]
export/print/e2_ages/index_disc.stl
23.9 x 24.0 x 3.00
