paulforrester/horloge-astronomique/export/print/m1_time/M1_index_disc.stl

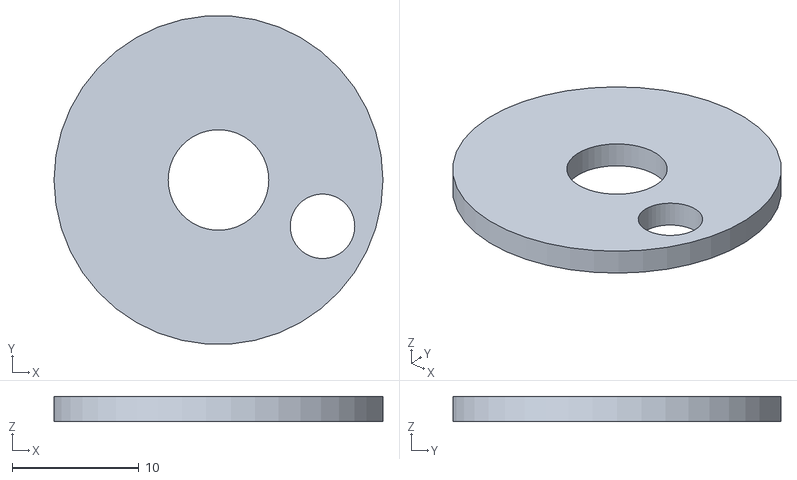
[picture p65: CAD file, 2026-11-05]
export/print/m1_time/M1_index_disc.stl
26.0 x 25.9 x 2.00
