paulforrester/horloge-astronomique/export/print/m2_e6_fallback_pawl/ring_jumper.stl

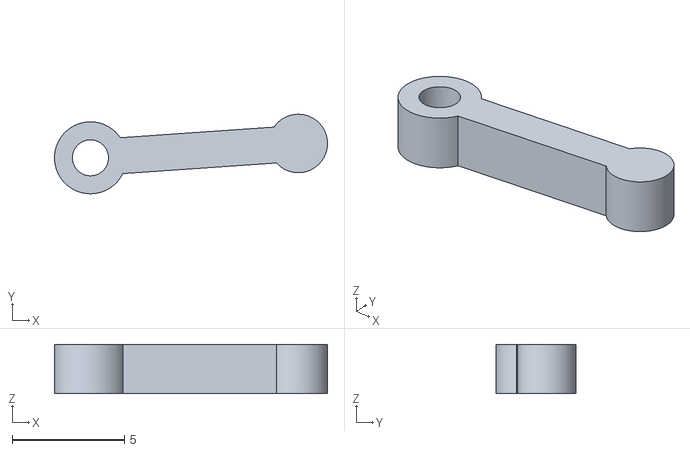
[picture p66: CAD file, 2026-11-04]
export/print/m2_e6_fallback_pawl/ring_jumper.stl
12.1 x 3.54 x 2.20
