paulforrester/horloge-astronomique/export/print/m2_main_dial/back_plate.stl

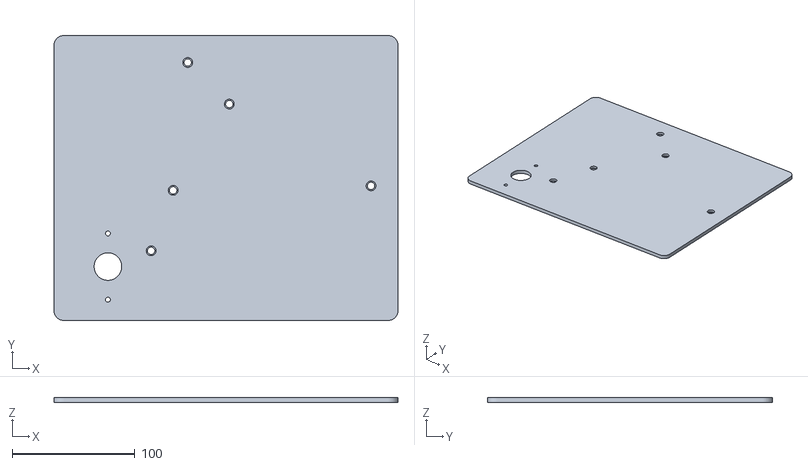
[picture p67: CAD file, 2026-11-05]
export/print/m2_main_dial/back_plate.stl
280.7 x 232.5 x 4.00
