paulforrester/horloge-astronomique/export/print/test_rig/dial_24h.stl

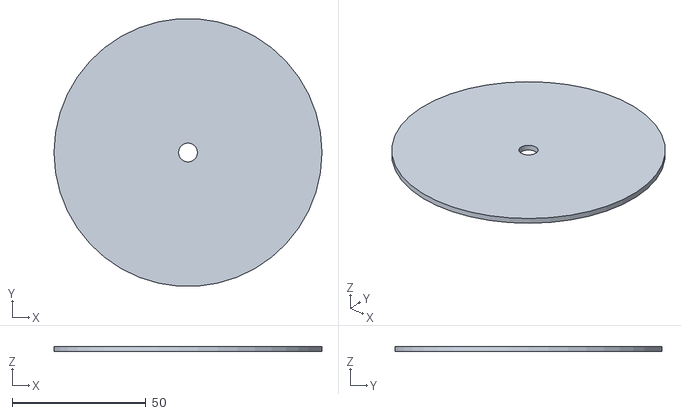
[picture p68: CAD file, 2026-11-03]
export/print/test_rig/dial_24h.stl
100.0 x 99.7 x 2.00
