paulforrester/horloge-astronomique/export/print/tolerance_coupons/gear_m1_b0p20_30.stl

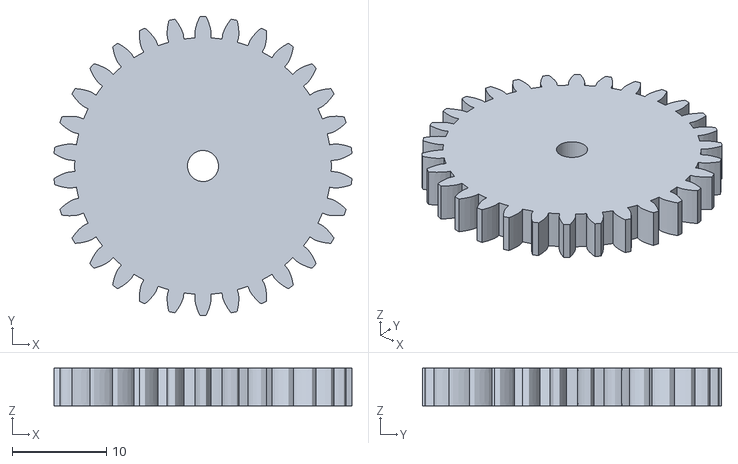
[picture p69: CAD file, 2026-11-03]
export/print/tolerance_coupons/gear_m1_b0p20_30.stl
31.6 x 31.8 x 4.00
