paulforrester/horloge-astronomique/export/print/e1_angels/guide_low.stl

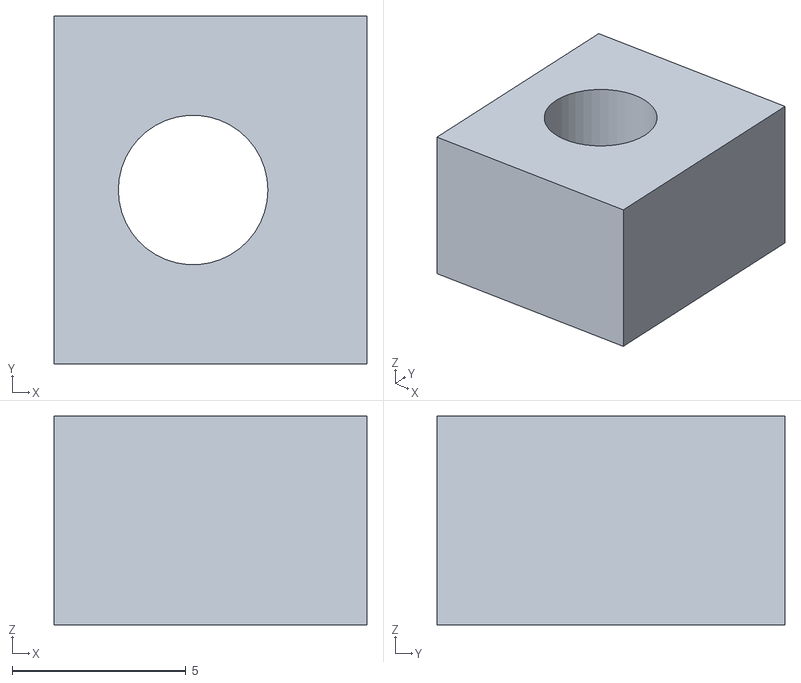
[picture p70: CAD file, 2026-11-08]
export/print/e1_angels/guide_low.stl
9.00 x 10.0 x 6.00
