paulforrester/horloge-astronomique/export/print/e2_ages/quarter_rack.stl

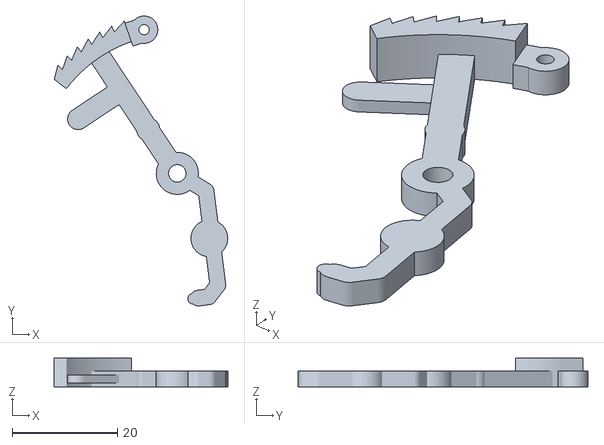
[picture p71: CAD file, 2026-11-08]
export/print/e2_ages/quarter_rack.stl
33.0 x 55.1 x 5.50
