paulforrester/horloge-astronomique/export/print/m1_time/gilt_drive_45.stl

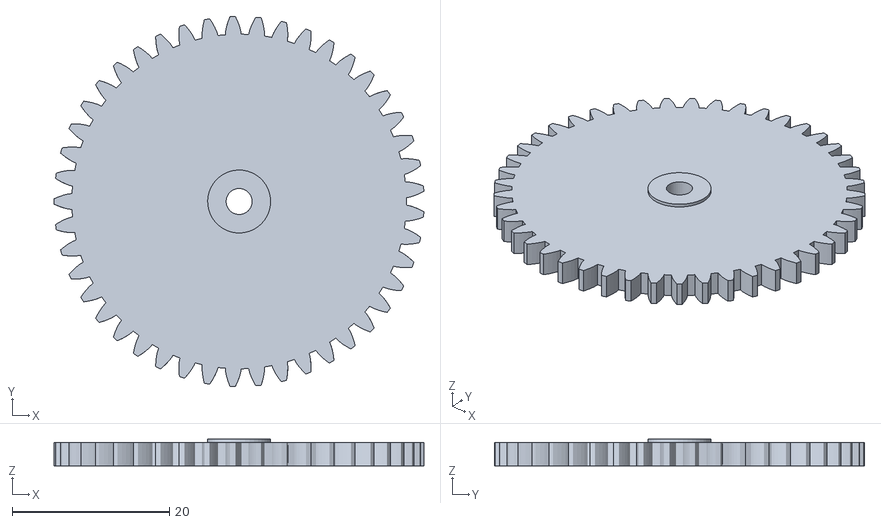
[picture p72: CAD file, 2026-11-05]
export/print/m1_time/gilt_drive_45.stl
47.0 x 47.0 x 3.40
