paulforrester/horloge-astronomique/export/print/m2_e6_fallback_pawl/e6_crank.stl

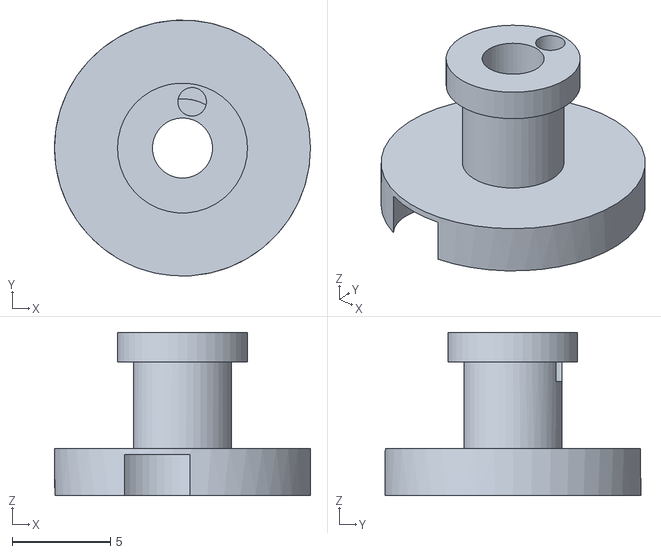
[picture p73: CAD file, 2026-11-04]
export/print/m2_e6_fallback_pawl/e6_crank.stl
13.0 x 13.0 x 8.30
