paulforrester/horloge-astronomique/export/print/m2_main_dial/hemisphere_dome.stl

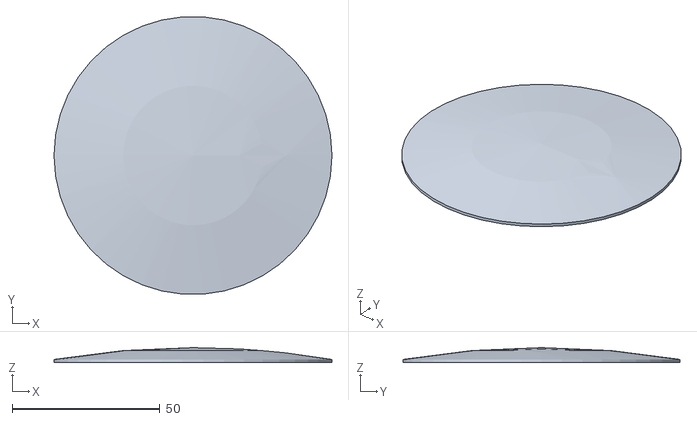
[picture p74: CAD file, 2026-11-04]
export/print/m2_main_dial/hemisphere_dome.stl
94.0 x 93.7 x 5.00
