paulforrester/horloge-astronomique/export/print/test_rig/hand_middle.stl

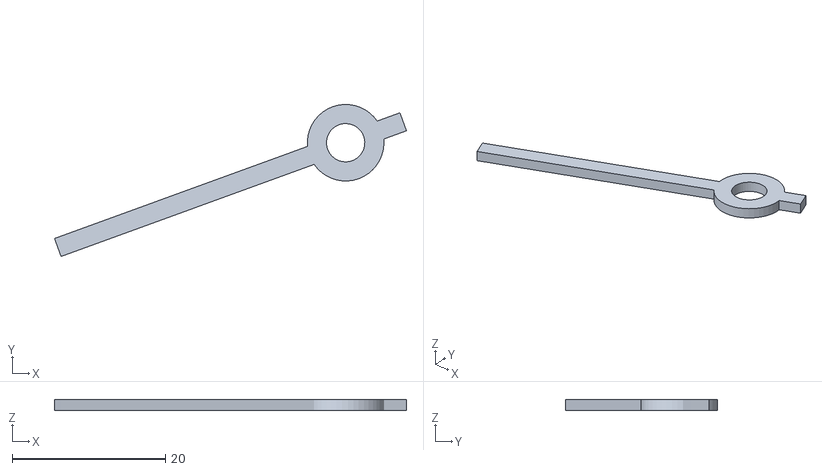
[picture p75: CAD file, 2026-11-03]
export/print/test_rig/hand_middle.stl
46.0 x 19.8 x 1.50
