paulforrester/horloge-astronomique/export/print/tolerance_coupons/gear_board.stl

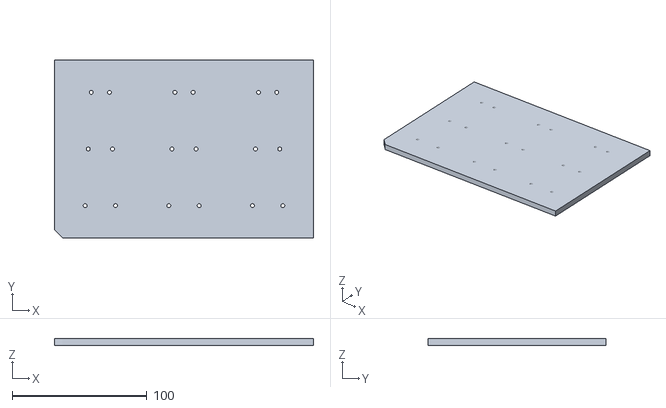
[picture p76: CAD file, 2026-11-03]
export/print/tolerance_coupons/gear_board.stl
192.0 x 132.0 x 5.00
