paulforrester/horloge-astronomique/export/print/e1_angels/follower_roller.stl

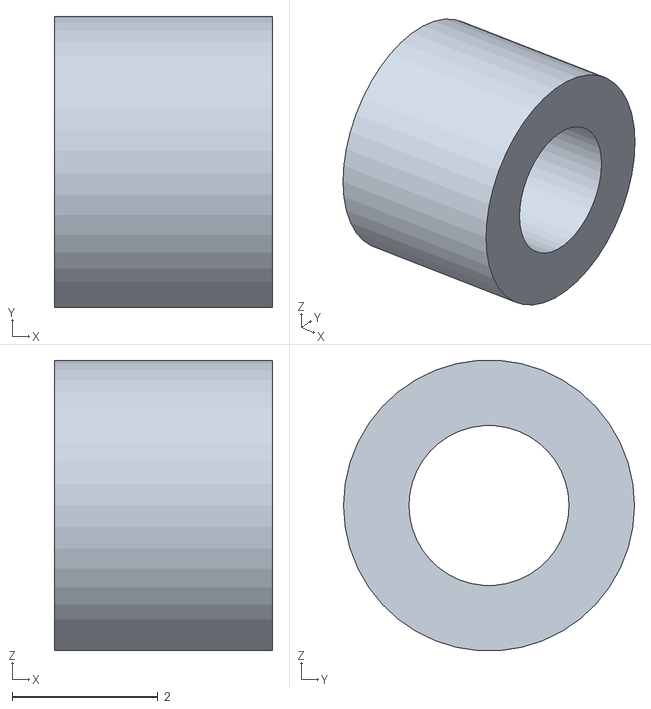
[picture p77: CAD file, 2026-11-08]
export/print/e1_angels/follower_roller.stl
3.00 x 4.00 x 3.99
