paulforrester/horloge-astronomique/export/print/e2_ages/strike_plate_right.stl

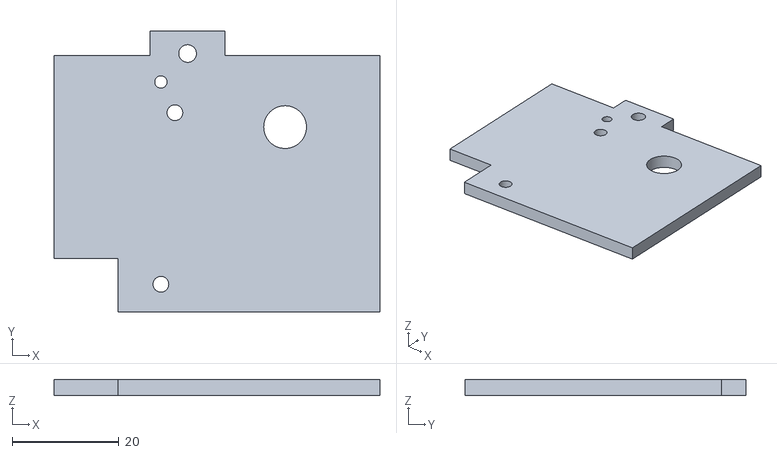
[picture p78: CAD file, 2026-11-08]
export/print/e2_ages/strike_plate_right.stl
61.0 x 52.5 x 3.00
