paulforrester/horloge-astronomique/export/print/m1_time/bezel.stl

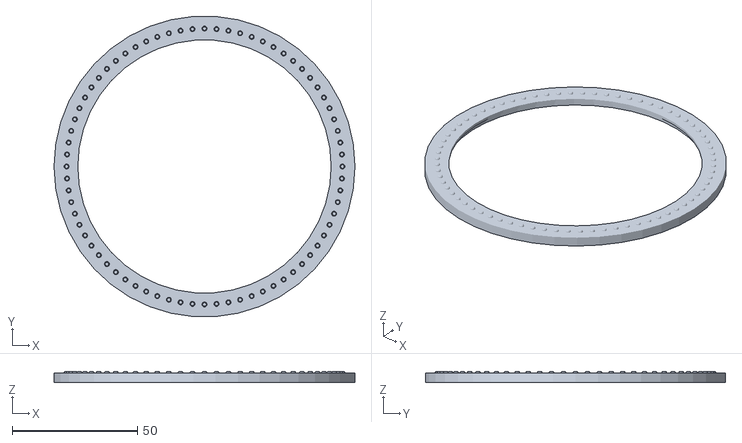
[picture p79: CAD file, 2026-11-05]
export/print/m1_time/bezel.stl
120.0 x 119.7 x 4.50
