paulforrester/horloge-astronomique/export/print/m2_main_dial/wheel_C_100.stl

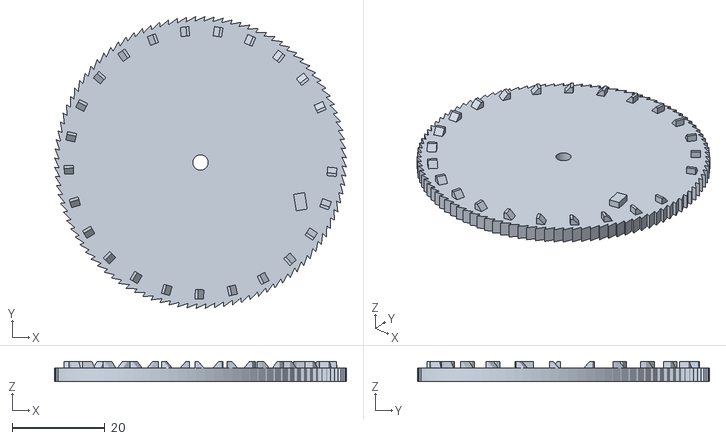
[picture p80: CAD file, 2026-11-04]
export/print/m2_main_dial/wheel_C_100.stl
63.0 x 63.0 x 4.40
