paulforrester/horloge-astronomique/export/print/test_rig/noon_pinion_12_A.stl

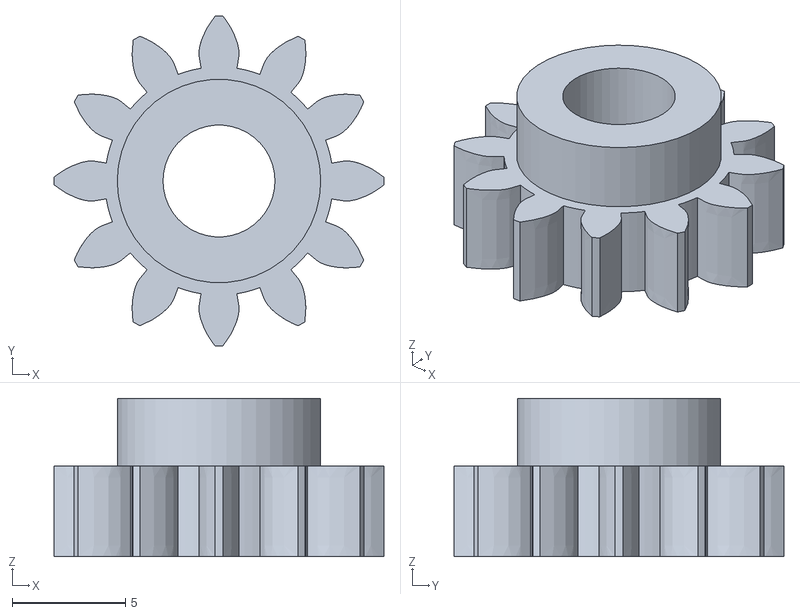
[picture p81: CAD file, 2026-11-03]
export/print/test_rig/noon_pinion_12_A.stl
14.6 x 14.6 x 7.00
