paulforrester/horloge-astronomique/export/print/tolerance_coupons/worm_test.stl

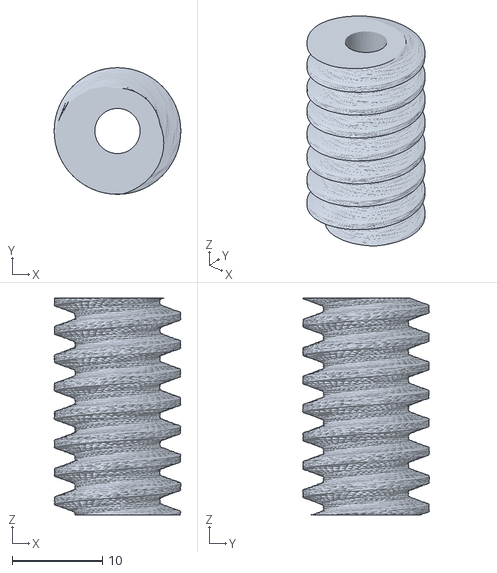
[picture p82: CAD file, 2026-11-03]
export/print/tolerance_coupons/worm_test.stl
14.0 x 14.0 x 24.0
