paulforrester/horloge-astronomique/export/print/e1_angels/intermediate_48_12.stl

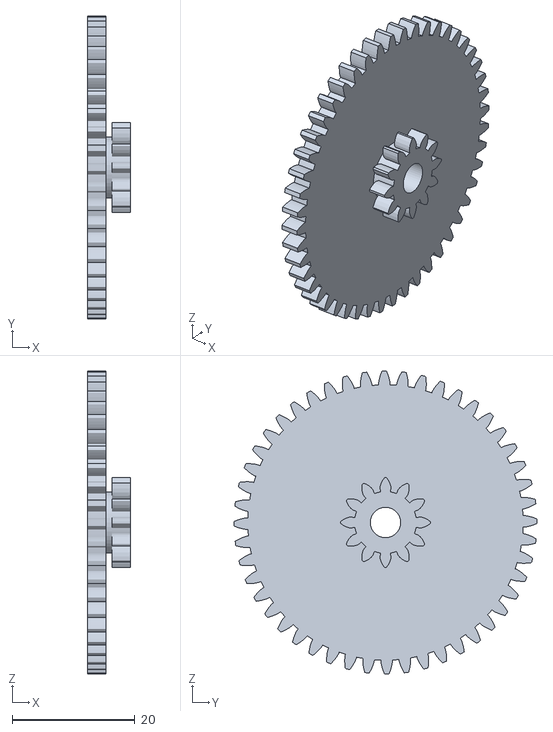
[picture p83: CAD file, 2026-11-08]
export/print/e1_angels/intermediate_48_12.stl
7.00 x 49.4 x 49.4
