paulforrester/horloge-astronomique/export/print/e2_ages/state_pinion_12.stl

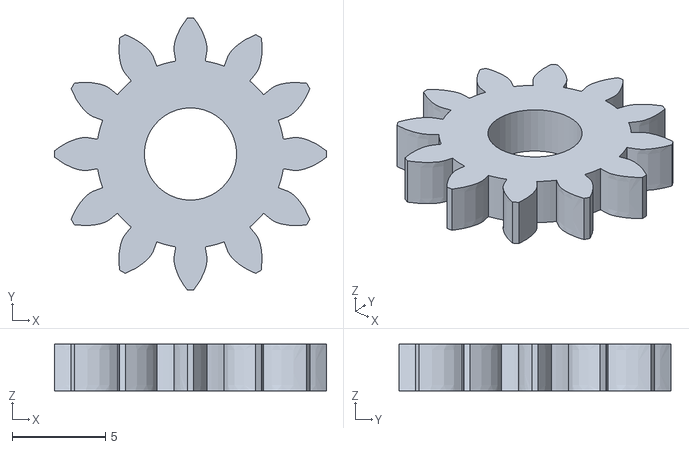
[picture p84: CAD file, 2026-11-08]
export/print/e2_ages/state_pinion_12.stl
14.6 x 14.6 x 2.50
