paulforrester/horloge-astronomique/export/print/m1_time/dial.3mf

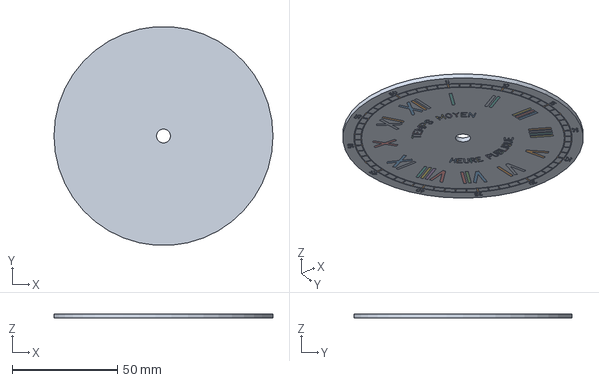
[picture p85: CAD file, 2026-11-05]
export/print/m1_time/dial.3mf
104.0 x 103.7 x 2.00 mm
