paulforrester/horloge-astronomique/export/print/m2_main_dial/e6_bracket.stl

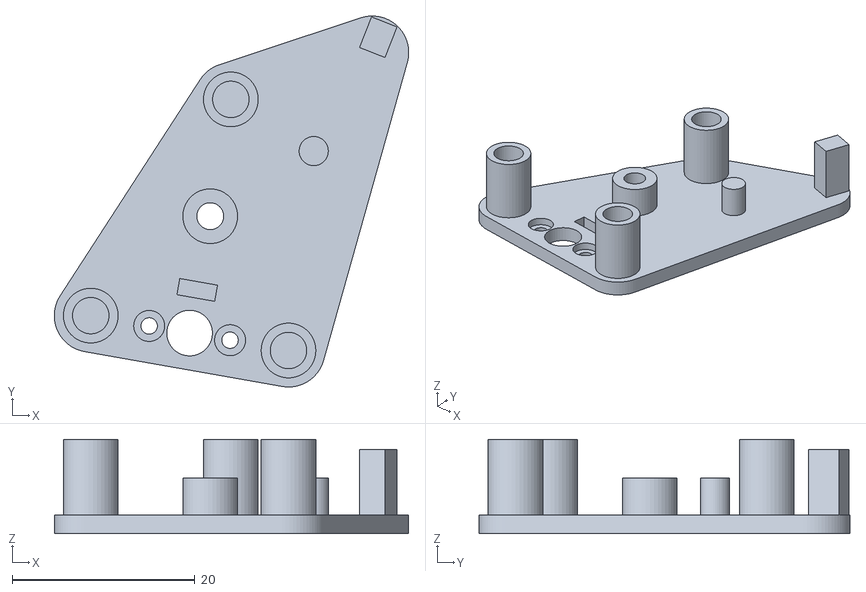
[picture p86: CAD file, 2026-11-04]
export/print/m2_main_dial/e6_bracket.stl
38.8 x 40.6 x 10.3
