paulforrester/horloge-astronomique/export/print/test_rig/minute_wheel_48_15.stl

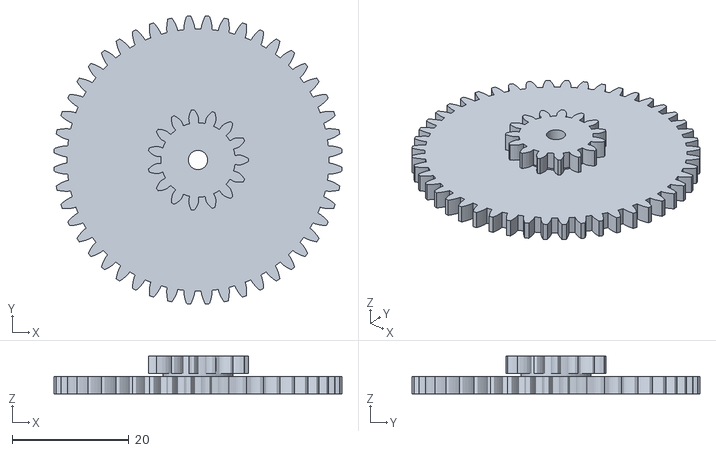
[picture p87: CAD file, 2026-11-03]
export/print/test_rig/minute_wheel_48_15.stl
49.3 x 49.3 x 6.50
