paulforrester/horloge-astronomique/export/print/tolerance_coupons/gear_m0p8_b0p20_15.stl

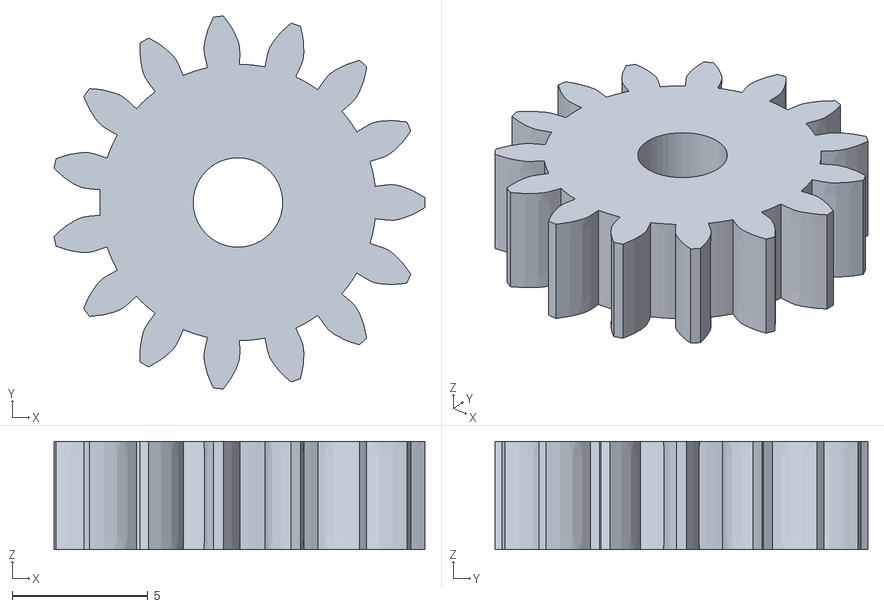
[picture p88: CAD file, 2026-11-03]
export/print/tolerance_coupons/gear_m0p8_b0p20_15.stl
13.7 x 13.8 x 4.00
