paulforrester/horloge-astronomique/export/print/e1_angels/crank.stl

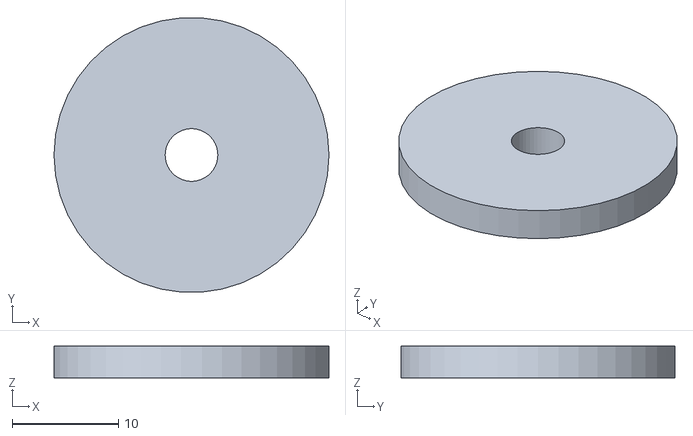
[picture p89: CAD file, 2026-11-08]
export/print/e1_angels/crank.stl
25.8 x 25.8 x 3.00
