paulforrester/horloge-astronomique/export/print/e2_ages/quarter_strap.stl

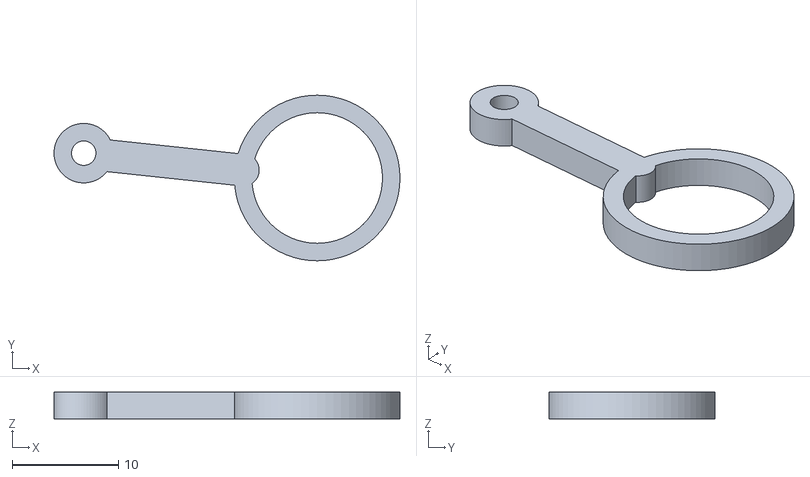
[picture p90: CAD file, 2026-11-08]
export/print/e2_ages/quarter_strap.stl
32.6 x 15.6 x 2.50
