paulforrester/horloge-astronomique/export/print/m1_time/hand_gilt_minute.stl

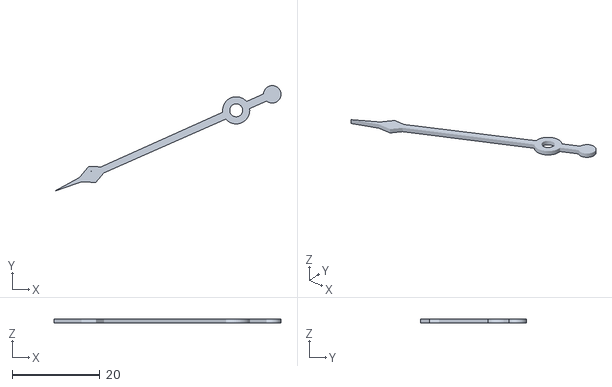
[picture p91: CAD file, 2026-11-05]
export/print/m1_time/hand_gilt_minute.stl
51.8 x 24.2 x 1.00
