paulforrester/horloge-astronomique/export/print/test_rig/dial_12h.stl

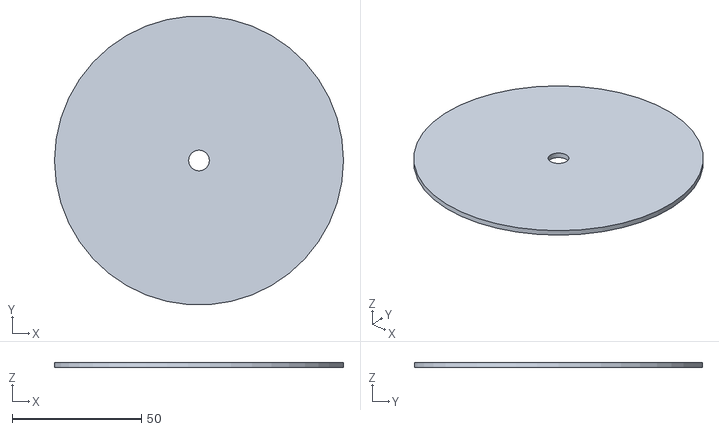
[picture p92: CAD file, 2026-11-03]
export/print/test_rig/dial_12h.stl
112.0 x 111.7 x 2.00
