paulforrester/horloge-astronomique/export/print/tolerance_coupons/worm_wheel_20.stl

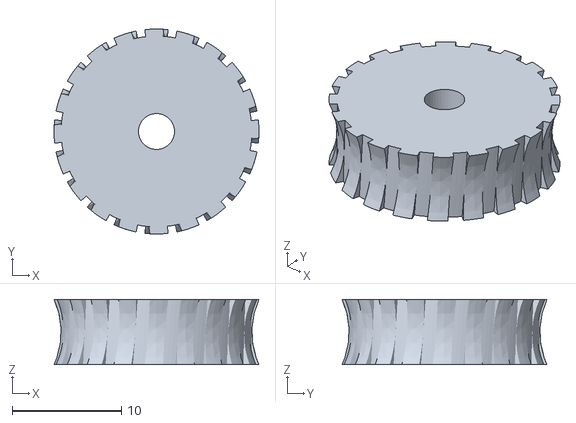
[picture p93: CAD file, 2026-11-03]
export/print/tolerance_coupons/worm_wheel_20.stl
18.8 x 18.8 x 6.00
