paulforrester/horloge-astronomique/export/print/e1_angels/bell_pinion_12.stl

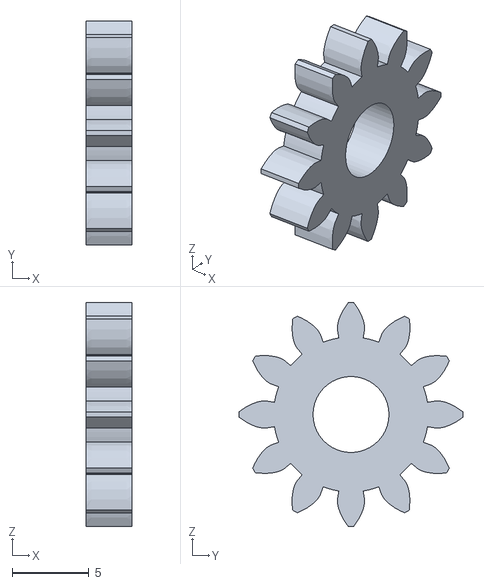
[picture p94: CAD file, 2026-11-08]
export/print/e1_angels/bell_pinion_12.stl
3.00 x 14.6 x 14.6
