paulforrester/horloge-astronomique/export/print/e2_ages/hour_trip_arm_a.stl

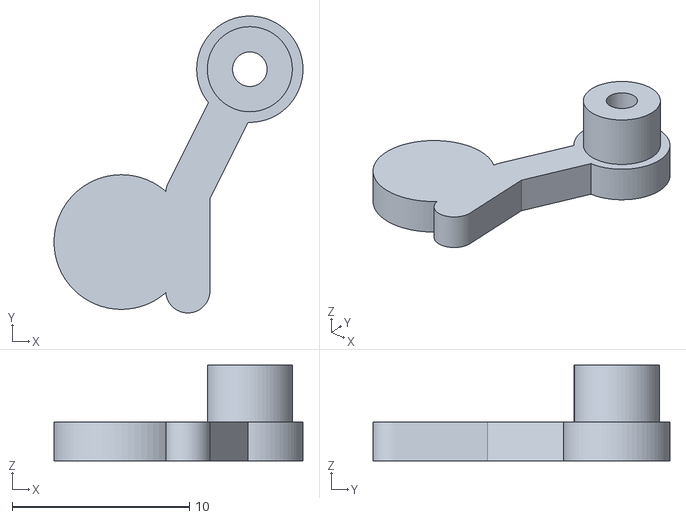
[picture p95: CAD file, 2026-11-08]
export/print/e2_ages/hour_trip_arm_a.stl
14.0 x 16.8 x 5.40
