paulforrester/horloge-astronomique/export/print/m1_time/adapter_M1.stl

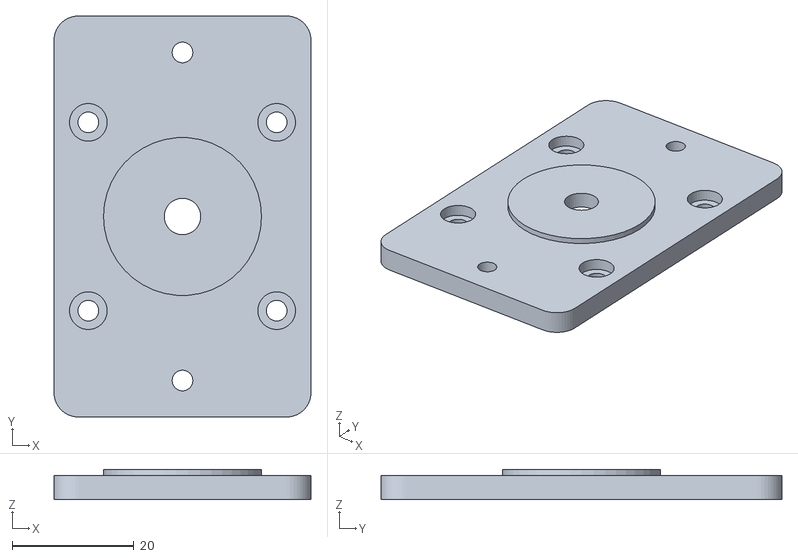
[picture p96: CAD file, 2026-11-05]
export/print/m1_time/adapter_M1.stl
42.3 x 66.0 x 5.00
