paulforrester/horloge-astronomique/export/print/m2_main_dial/stop_lever.stl

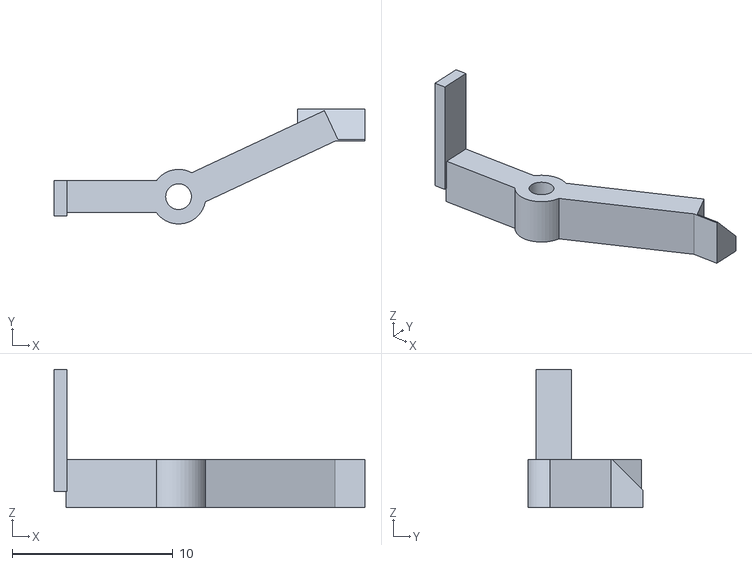
[picture p97: CAD file, 2026-11-04]
export/print/m2_main_dial/stop_lever.stl
19.4 x 7.15 x 8.60
