paulforrester/horloge-astronomique/export/print/test_rig/pillar_0.stl

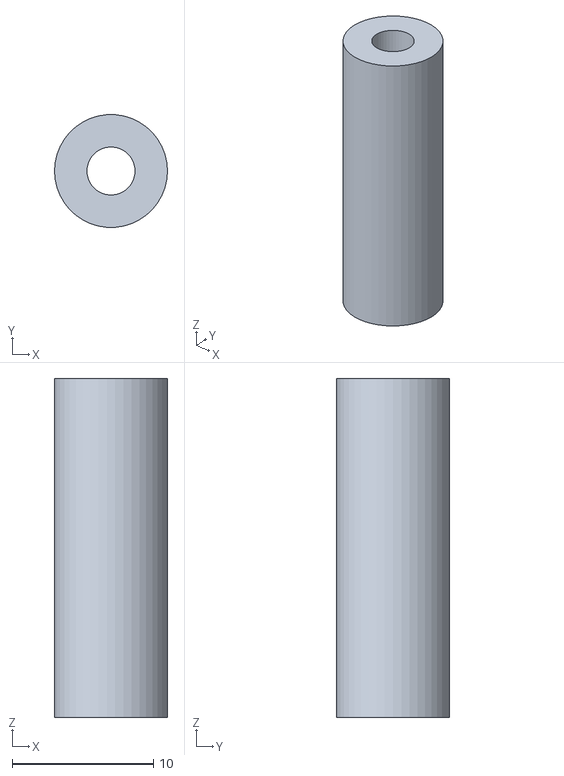
[picture p98: CAD file, 2026-11-03]
export/print/test_rig/pillar_0.stl
8.00 x 7.98 x 24.0
