paulforrester/horloge-astronomique/export/print/tolerance_coupons/gear_m0p6_b0p20_15.stl

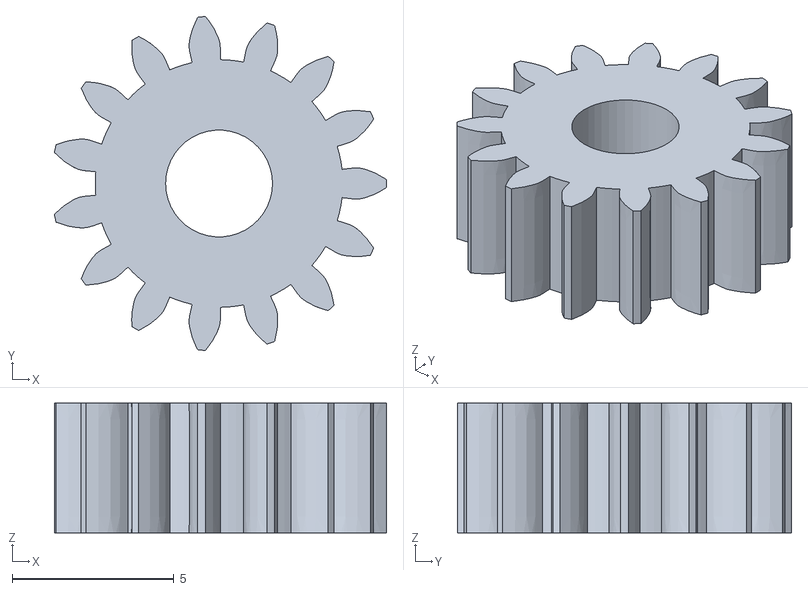
[picture p99: CAD file, 2026-11-03]
export/print/tolerance_coupons/gear_m0p6_b0p20_15.stl
10.3 x 10.3 x 4.00
