paulforrester/horloge-astronomique/export/print/e1_angels/forearms_and_frame.stl

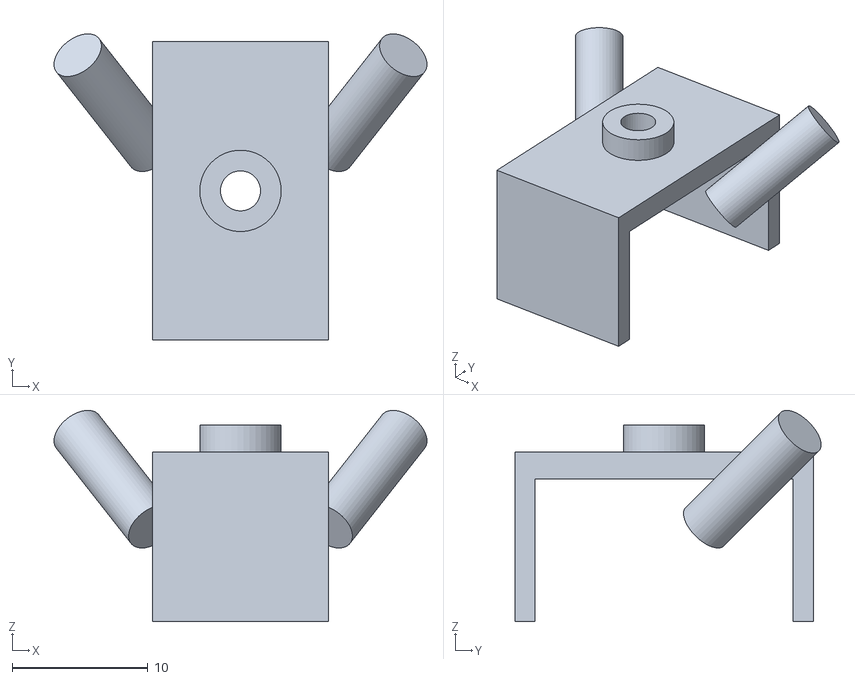
[picture p100: CAD file, 2026-11-08]
export/print/e1_angels/forearms_and_frame.stl
27.5 x 22.6 x 15.6
