paulforrester/horloge-astronomique/export/print/e2_ages/quarter_snail.stl

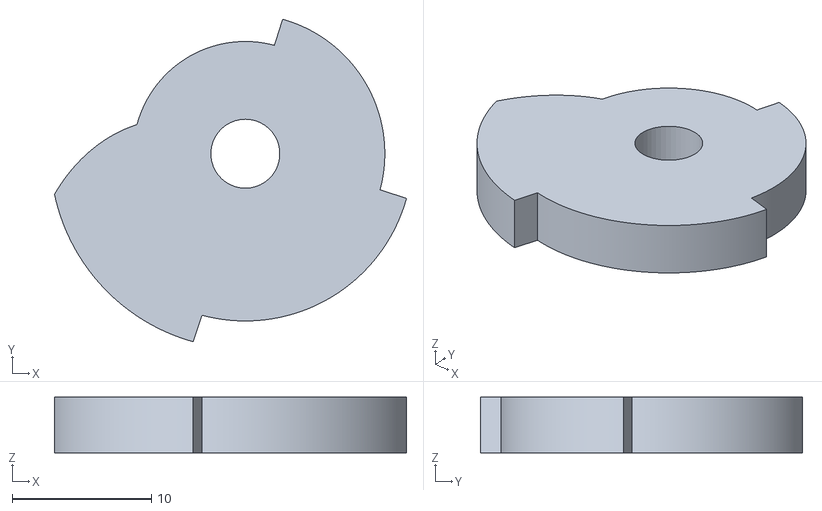
[picture p101: CAD file, 2026-11-08]
export/print/e2_ages/quarter_snail.stl
25.3 x 23.1 x 4.00
