paulforrester/horloge-astronomique/export/print/m1_time/M1b_flag_disc.stl

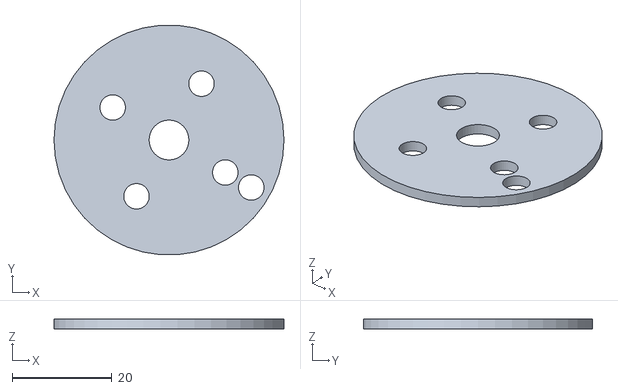
[picture p102: CAD file, 2026-11-05]
export/print/m1_time/M1b_flag_disc.stl
46.0 x 45.9 x 2.00
