paulforrester/horloge-astronomique/export/print/m2_main_dial/setter_detent_anchor.stl

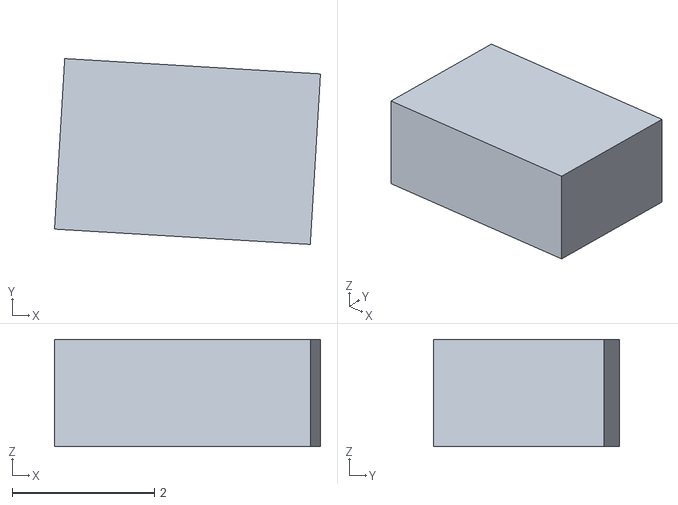
[picture p103: CAD file, 2026-11-04]
export/print/m2_main_dial/setter_detent_anchor.stl
3.74 x 2.61 x 1.51
