paulforrester/horloge-astronomique/export/print/test_rig/hand_minute.stl

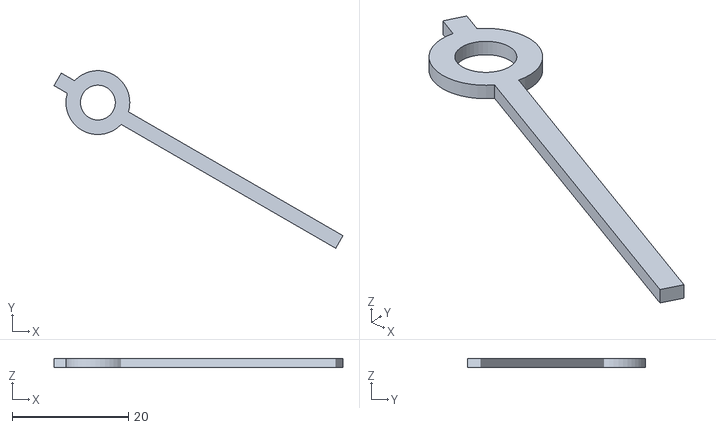
[picture p104: CAD file, 2026-11-03]
export/print/test_rig/hand_minute.stl
49.7 x 30.6 x 1.50
