paulforrester/horloge-astronomique/export/print/e1_angels/shoulder_bracket.stl

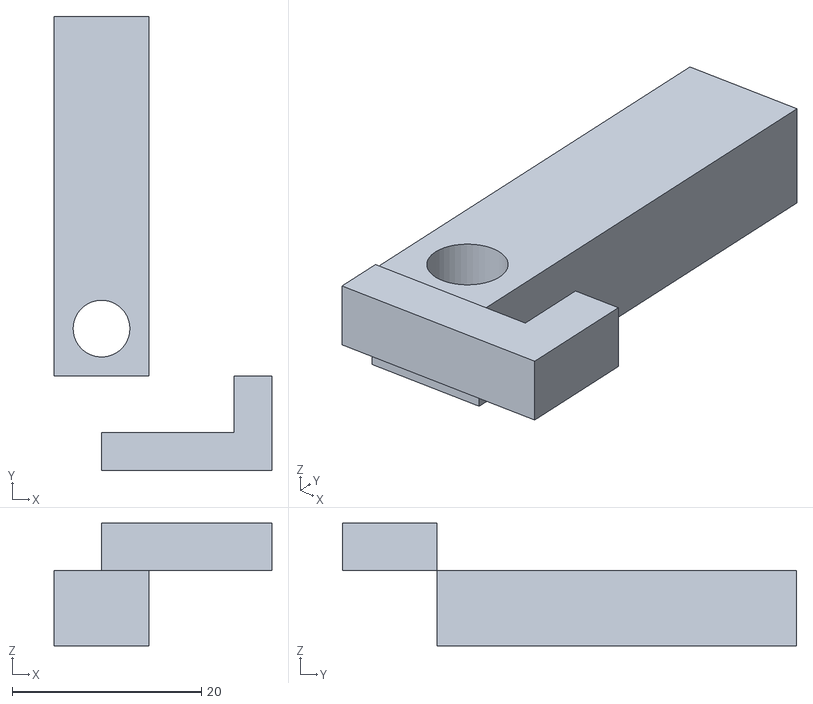
[picture p105: CAD file, 2026-11-08]
export/print/e1_angels/shoulder_bracket.stl
23.0 x 48.0 x 13.0
