paulforrester/horloge-astronomique/export/print/e2_ages/hour_hook.stl

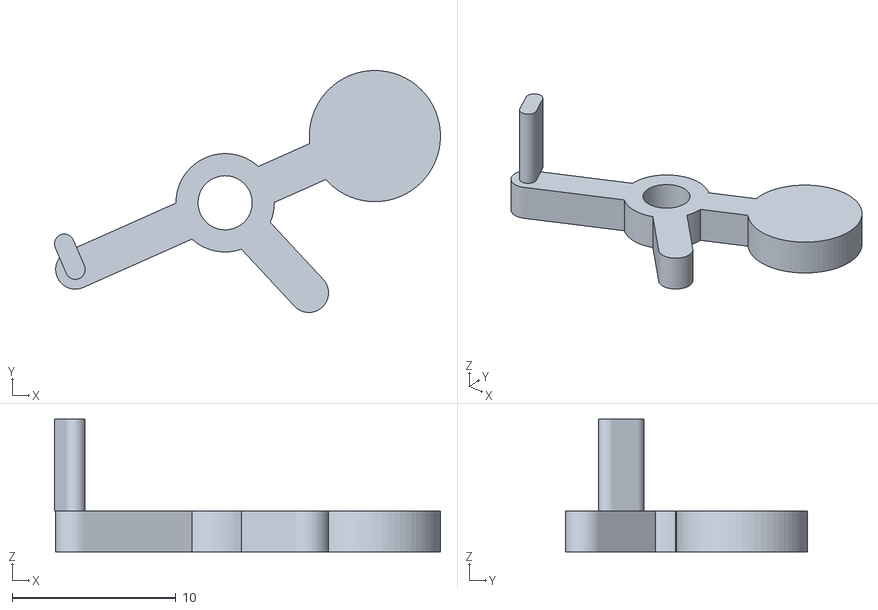
[picture p106: CAD file, 2026-11-08]
export/print/e2_ages/hour_hook.stl
23.5 x 14.8 x 8.10
