paulforrester/horloge-astronomique/export/print/m1_time/centre_cap.stl

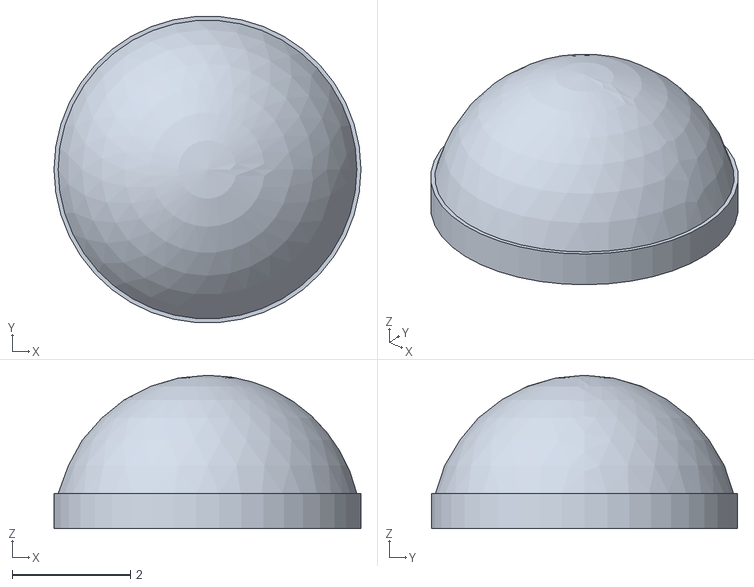
[picture p107: CAD file, 2026-11-05]
export/print/m1_time/centre_cap.stl
5.20 x 5.19 x 2.60
