paulforrester/horloge-astronomique/export/print/m2_main_dial/stop_bridge.stl

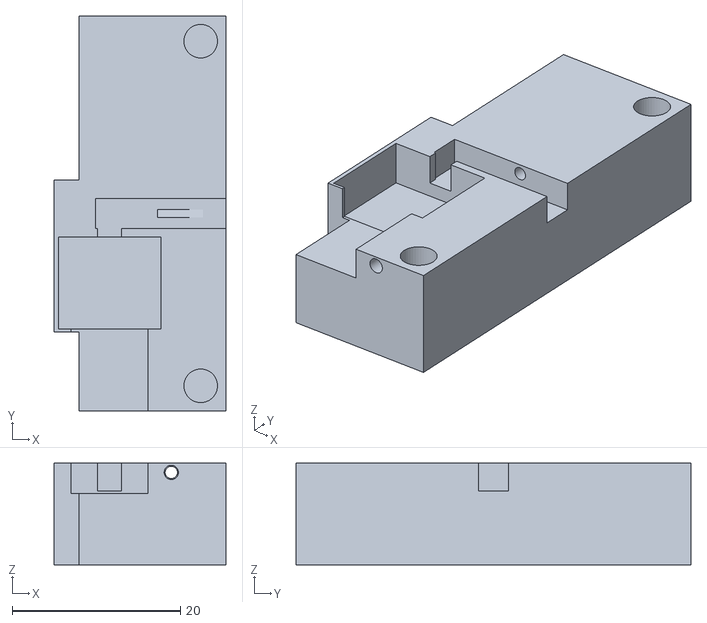
[picture p108: CAD file, 2026-11-04]
export/print/m2_main_dial/stop_bridge.stl
20.5 x 47.0 x 12.1
