paulforrester/horloge-astronomique/export/print/test_rig/hand_sun.stl

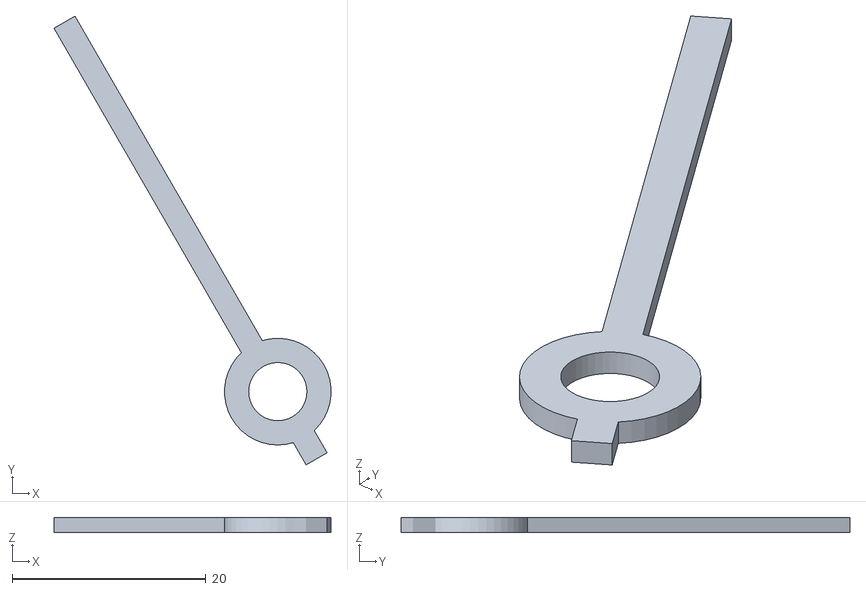
[picture p109: CAD file, 2026-11-03]
export/print/test_rig/hand_sun.stl
28.6 x 46.3 x 1.50
