paulforrester/horloge-astronomique/export/print/e1_angels/rack.stl

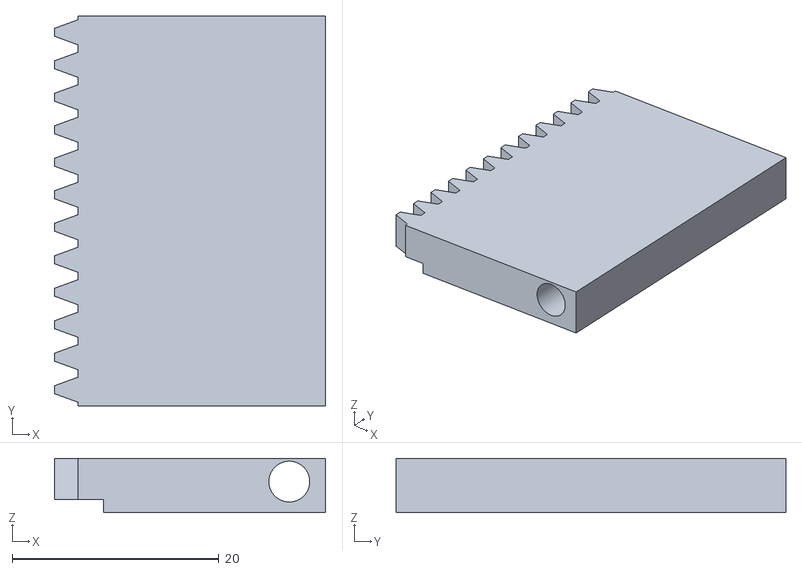
[picture p110: CAD file, 2026-11-08]
export/print/e1_angels/rack.stl
26.2 x 37.7 x 5.25
