paulforrester/horloge-astronomique/export/print/e2_ages/lay_compound.stl

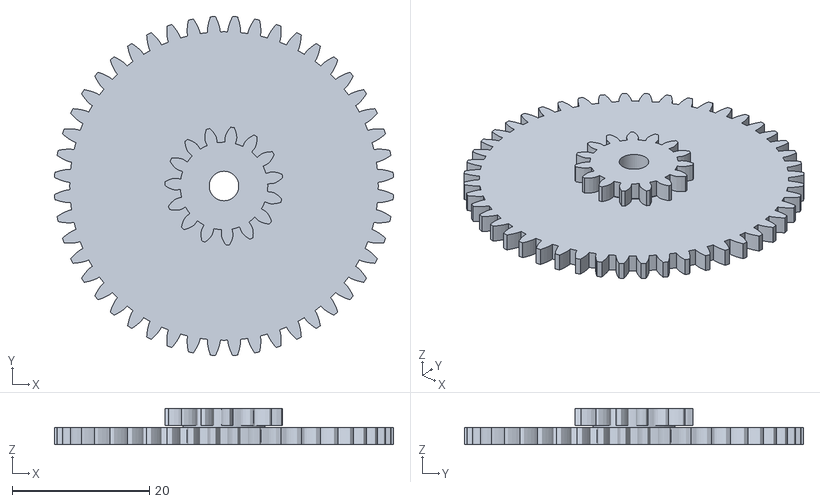
[picture p111: CAD file, 2026-11-08]
export/print/e2_ages/lay_compound.stl
49.3 x 49.3 x 5.30
