paulforrester/horloge-astronomique/export/print/m1_time/noon_wheel_64_N.stl

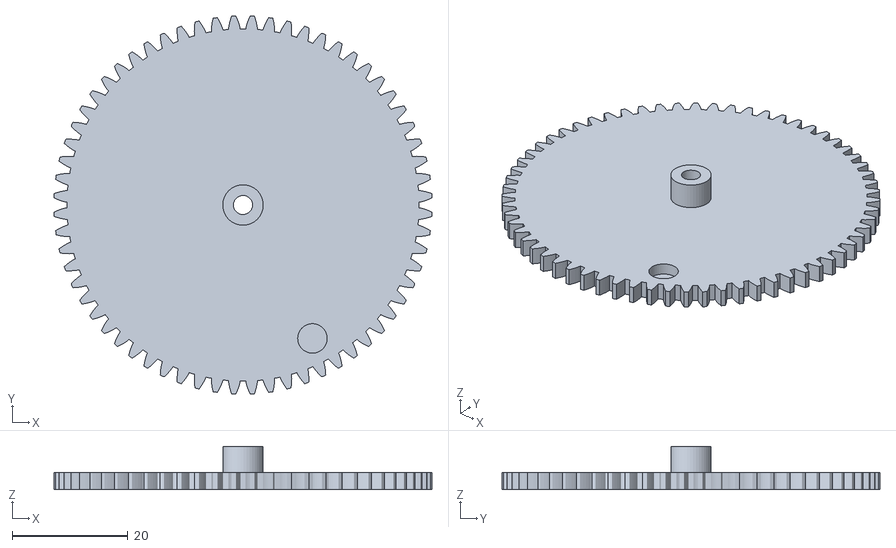
[picture p112: CAD file, 2026-11-05]
export/print/m1_time/noon_wheel_64_N.stl
65.4 x 65.4 x 7.50
