paulforrester/horloge-astronomique/export/print/m2_main_dial/station_bracket.stl

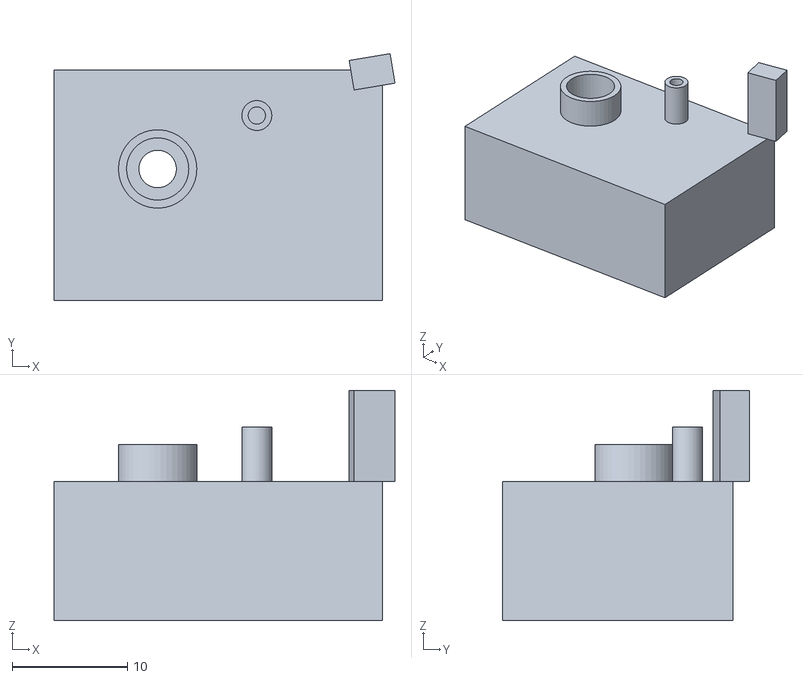
[picture p113: CAD file, 2026-11-04]
export/print/m2_main_dial/station_bracket.stl
29.6 x 21.4 x 20.0
