paulforrester/horloge-astronomique/export/print/test_rig/foot_0.stl

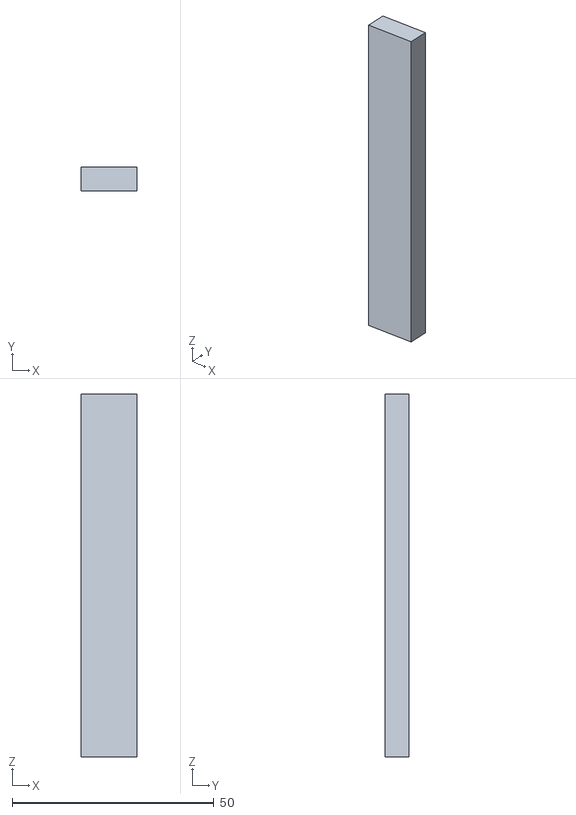
[picture p114: CAD file, 2026-11-03]
export/print/test_rig/foot_0.stl
14.0 x 6.00 x 90.0
