paulforrester/horloge-astronomique/export/print/tolerance_coupons/gear_m1_b0p15_15.stl

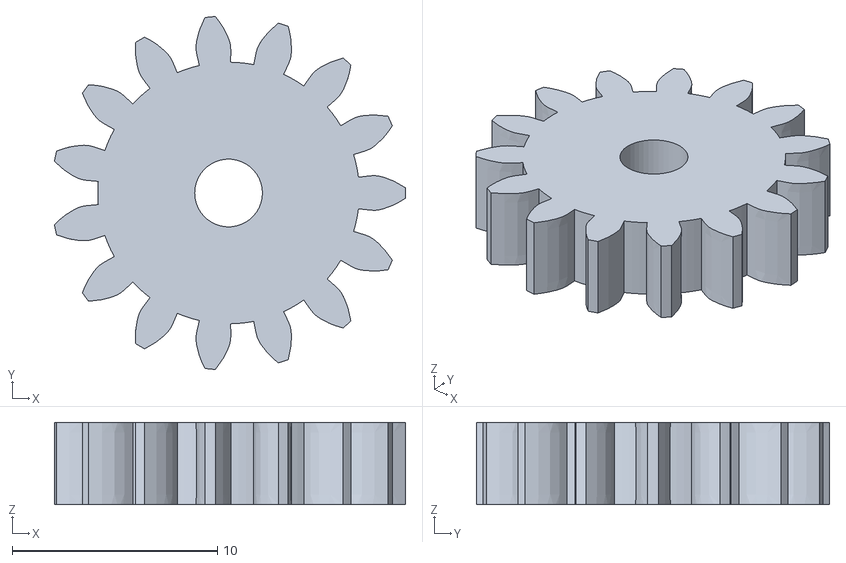
[picture p115: CAD file, 2026-11-03]
export/print/tolerance_coupons/gear_m1_b0p15_15.stl
17.1 x 17.2 x 4.00
