paulforrester/horloge-astronomique/export/print/e1_angels/glass_crank_block.stl

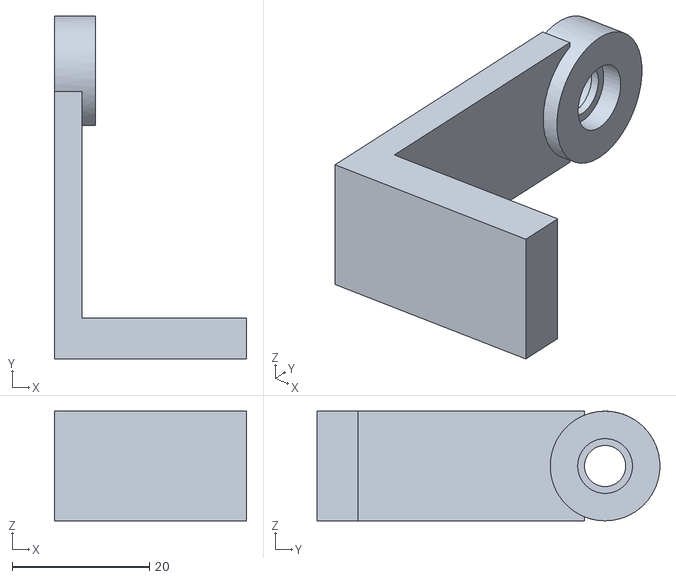
[picture p116: CAD file, 2026-11-08]
export/print/e1_angels/glass_crank_block.stl
28.0 x 50.0 x 16.0
