paulforrester/horloge-astronomique/export/print/e2_ages/witness_bracket.stl

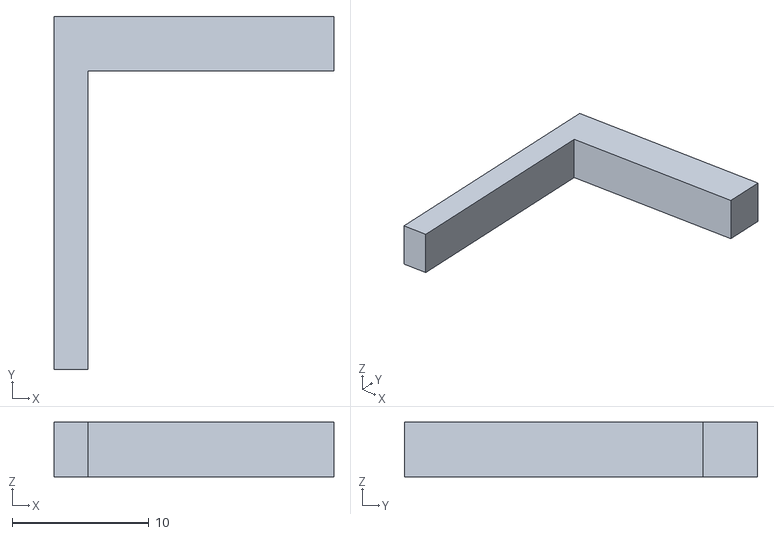
[picture p117: CAD file, 2026-11-08]
export/print/e2_ages/witness_bracket.stl
20.5 x 25.8 x 4.00
