paulforrester/horloge-astronomique/export/print/m1_time/stop_post_TA.stl

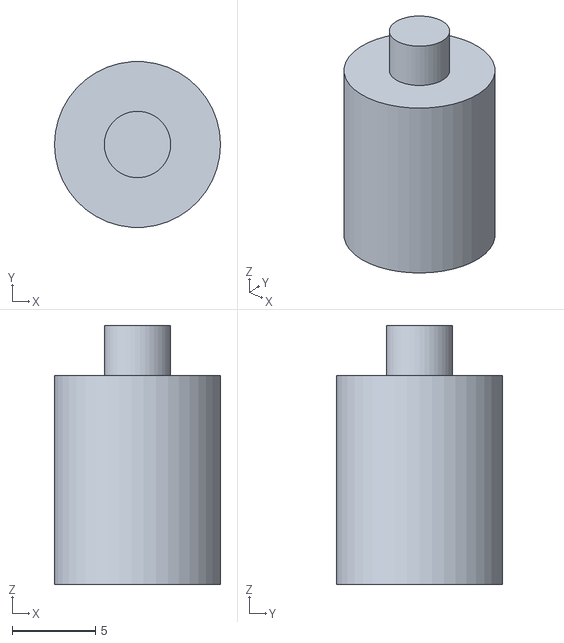
[picture p118: CAD file, 2026-11-05]
export/print/m1_time/stop_post_TA.stl
10.0 x 9.97 x 15.6
