paulforrester/horloge-astronomique/export/print/m2_main_dial/e6_finger.stl

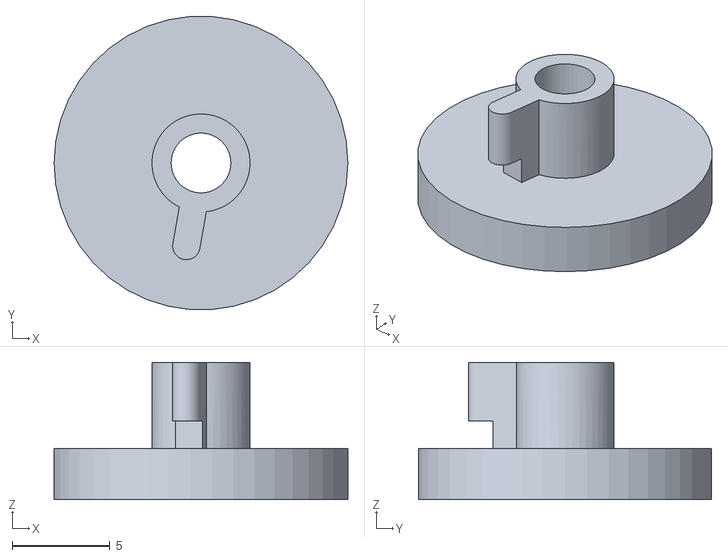
[picture p119: CAD file, 2026-11-04]
export/print/m2_main_dial/e6_finger.stl
15.0 x 15.0 x 7.00
