paulforrester/horloge-astronomique/export/print/test_rig/hand_hour.stl

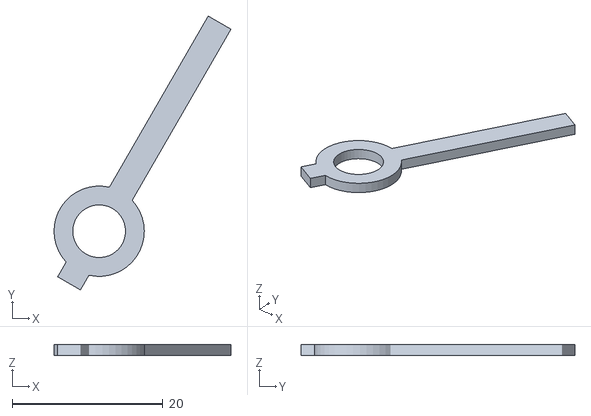
[picture p120: CAD file, 2026-11-03]
export/print/test_rig/hand_hour.stl
23.5 x 36.4 x 1.50
