paulforrester/horloge-astronomique/export/print/e1_angels/glass_tower_plate.stl

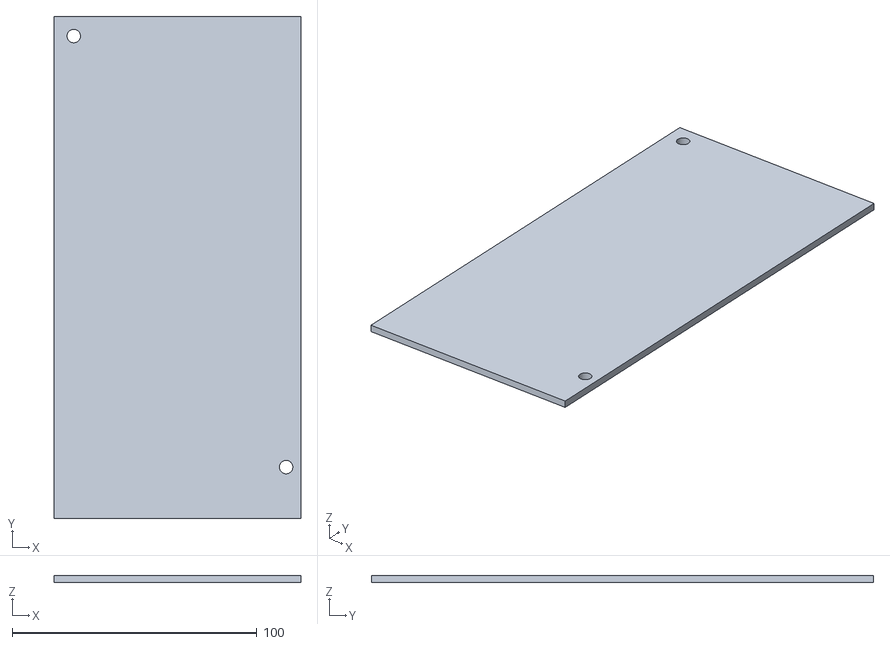
[picture p121: CAD file, 2026-11-08]
export/print/e1_angels/glass_tower_plate.stl
100.8 x 205.1 x 3.00
