paulforrester/horloge-astronomique/export/print/e2_ages/quarter_strike_gear.stl

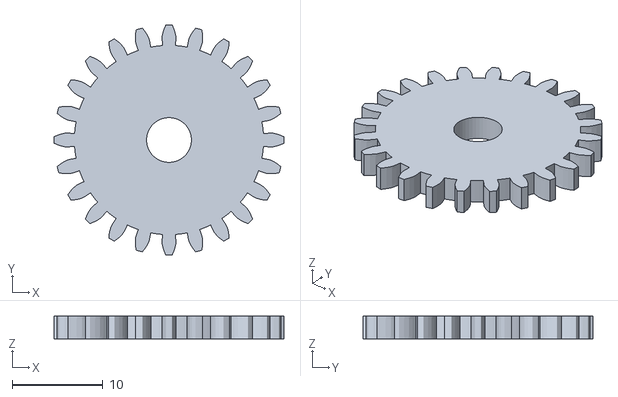
[picture p122: CAD file, 2026-11-08]
export/print/e2_ages/quarter_strike_gear.stl
25.4 x 25.4 x 2.50
