paulforrester/horloge-astronomique/export/print/m1_time/gilt_witness_disc.stl

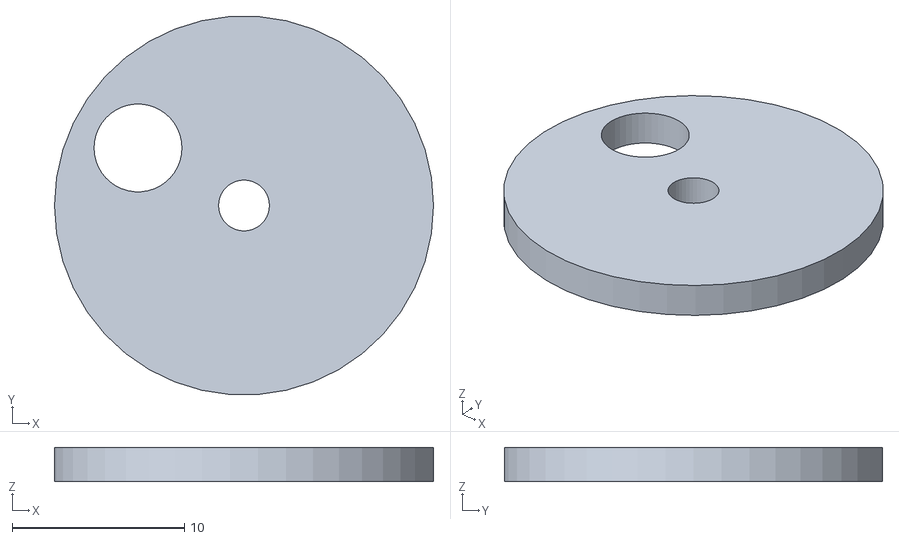
[picture p123: CAD file, 2026-11-05]
export/print/m1_time/gilt_witness_disc.stl
22.0 x 21.9 x 2.00
