paulforrester/horloge-astronomique/export/print/m2_main_dial/ring_3.3mf

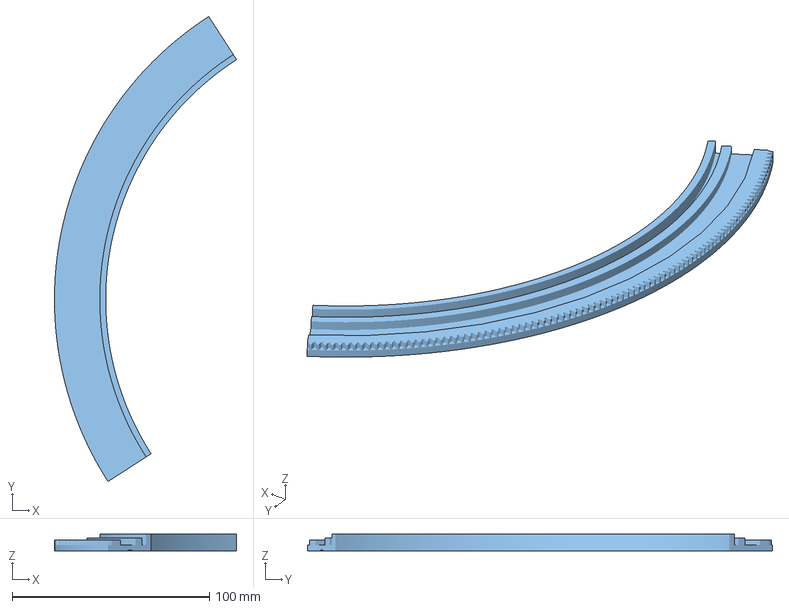
[picture p124: CAD file, 2026-11-04]
export/print/m2_main_dial/ring_3.3mf
92.3 x 235.6 x 8.50 mm
