paulforrester/horloge-astronomique/export/print/test_rig/day_wheel_64_B.stl

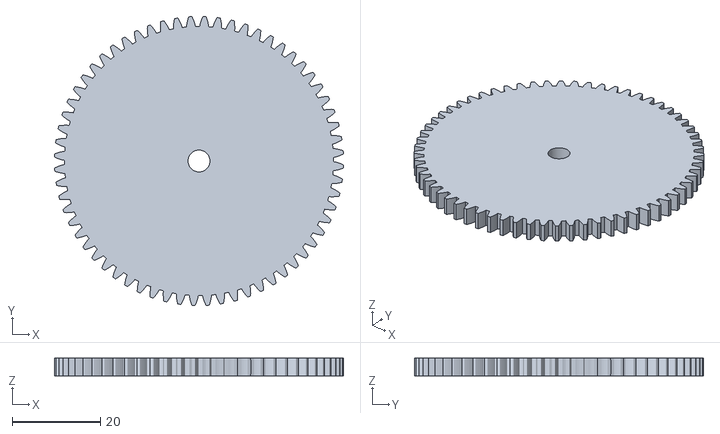
[picture p125: CAD file, 2026-11-03]
export/print/test_rig/day_wheel_64_B.stl
65.4 x 65.4 x 4.00
