paulforrester/horloge-astronomique/export/print/e1_angels/glass_pinion_12.stl

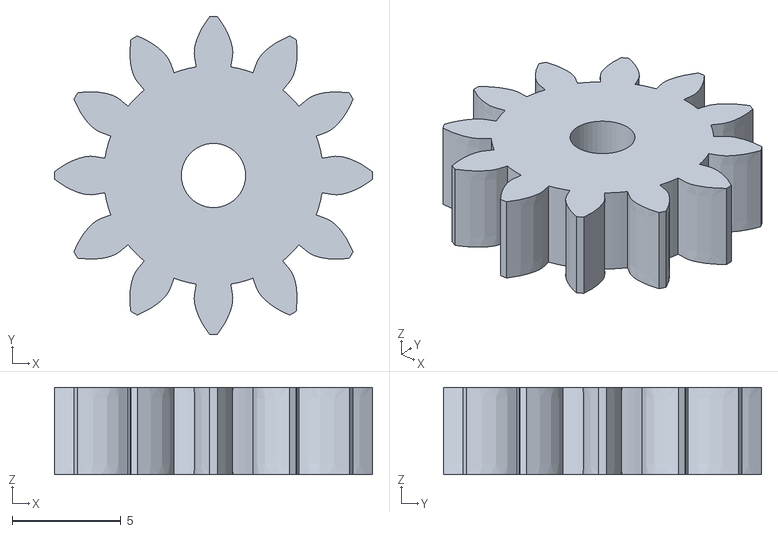
[picture p126: CAD file, 2026-11-08]
export/print/e1_angels/glass_pinion_12.stl
14.6 x 14.6 x 4.00
