paulforrester/horloge-astronomique/export/print/e2_ages/hour_trip_arm_b.stl

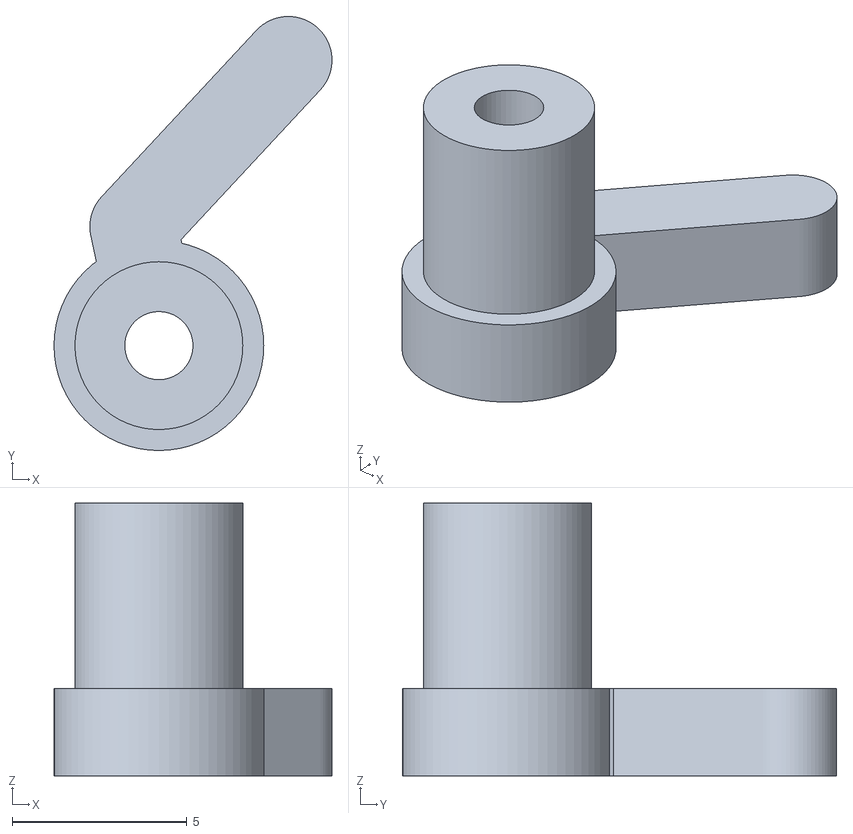
[picture p127: CAD file, 2026-11-08]
export/print/e2_ages/hour_trip_arm_b.stl
7.95 x 12.4 x 7.80
