paulforrester/horloge-astronomique/export/print/m1_time/pillar_0.stl

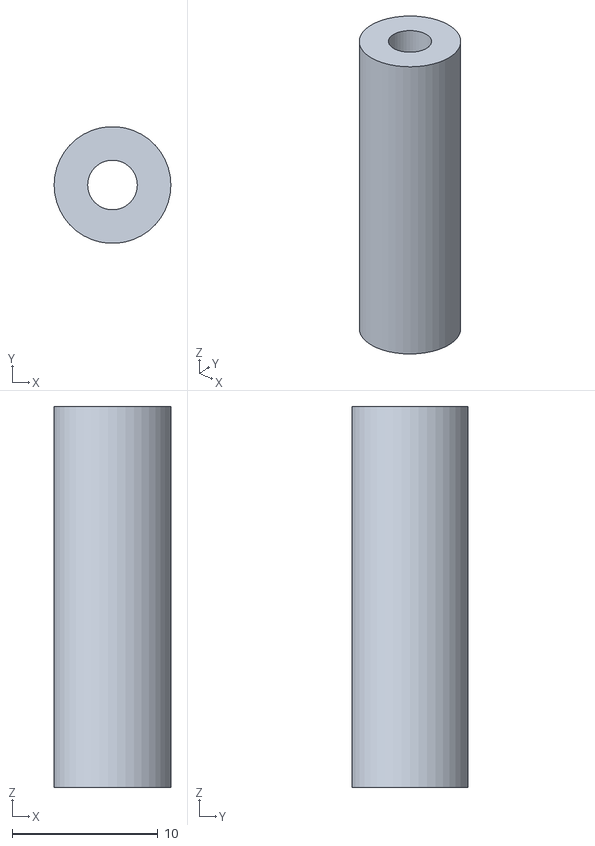
[picture p128: CAD file, 2026-11-05]
export/print/m1_time/pillar_0.stl
8.00 x 7.98 x 26.1
