paulforrester/horloge-astronomique/export/print/m2_main_dial/ring_0.3mf

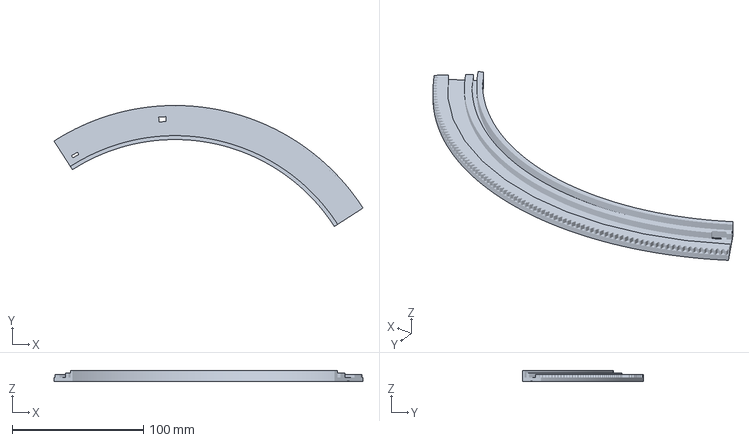
[picture p129: CAD file, 2026-11-04]
export/print/m2_main_dial/ring_0.3mf
235.6 x 92.3 x 8.50 mm
