paulforrester/horloge-astronomique/export/print/test_rig/shadow_wheel_48_C.stl

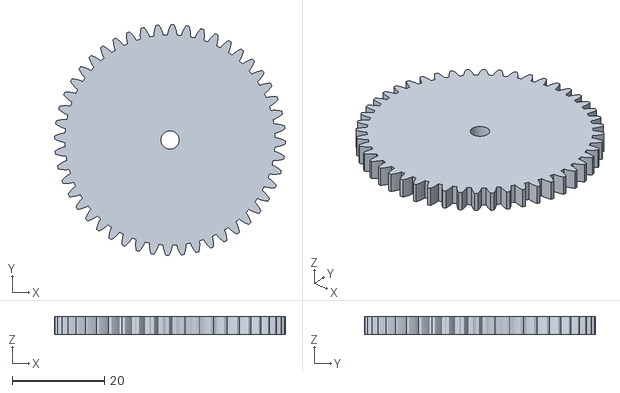
[picture p130: CAD file, 2026-11-03]
export/print/test_rig/shadow_wheel_48_C.stl
50.0 x 50.0 x 4.00
