paulforrester/horloge-astronomique/export/print/tolerance_coupons/fit_coupon.stl

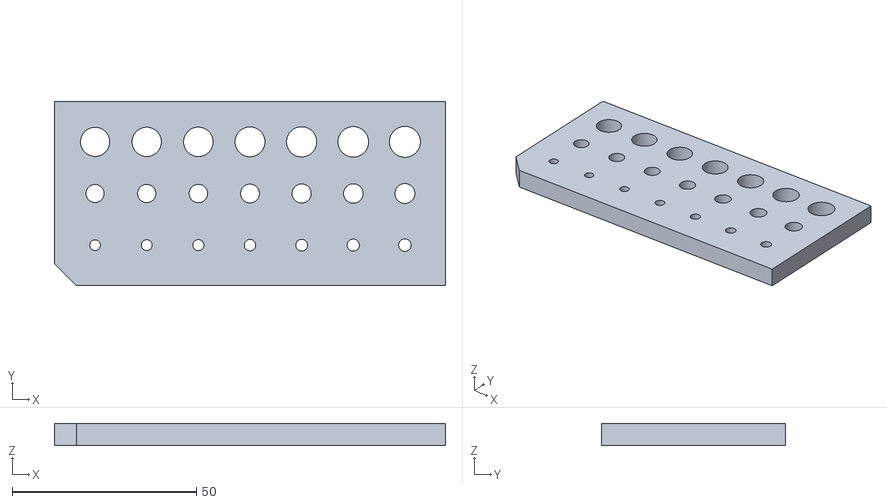
[picture p131: CAD file, 2026-11-03]
export/print/tolerance_coupons/fit_coupon.stl
106.0 x 50.0 x 6.00
