paulforrester/horloge-astronomique/export/print/e1_angels/tower_pillars.stl

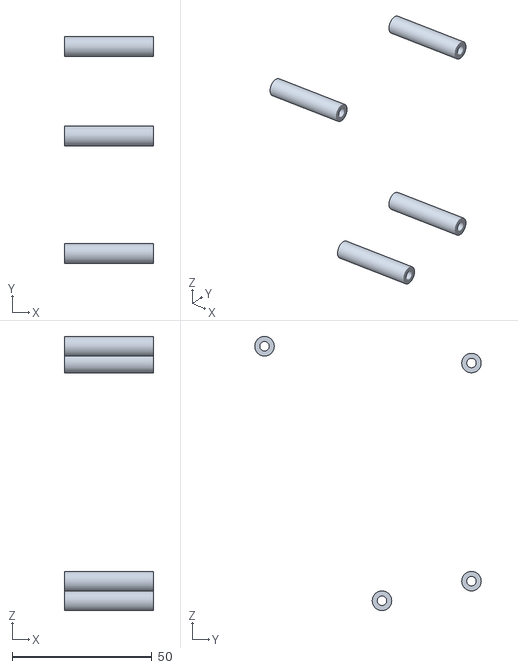
[picture p132: CAD file, 2026-11-08]
export/print/e1_angels/tower_pillars.stl
32.0 x 81.0 x 98.0
