paulforrester/horloge-astronomique/export/print/e2_ages/quarter_lock_cam.stl

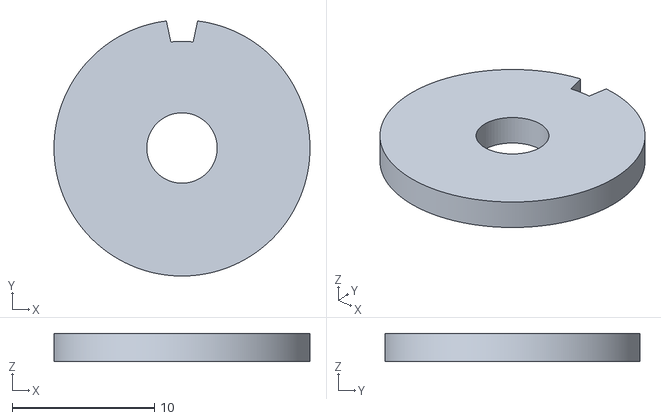
[picture p133: CAD file, 2026-11-08]
export/print/e2_ages/quarter_lock_cam.stl
18.0 x 17.9 x 2.00
