paulforrester/horloge-astronomique/export/print/m1_time/gilt_minute_wheel_48.stl

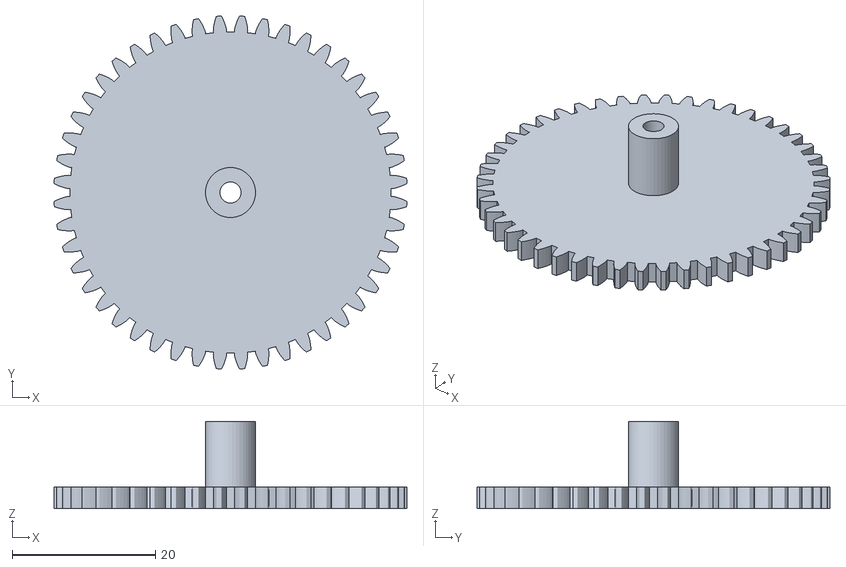
[picture p134: CAD file, 2026-11-05]
export/print/m1_time/gilt_minute_wheel_48.stl
49.3 x 49.3 x 12.2
