paulforrester/horloge-astronomique/export/print/m2_main_dial/e6_star.stl

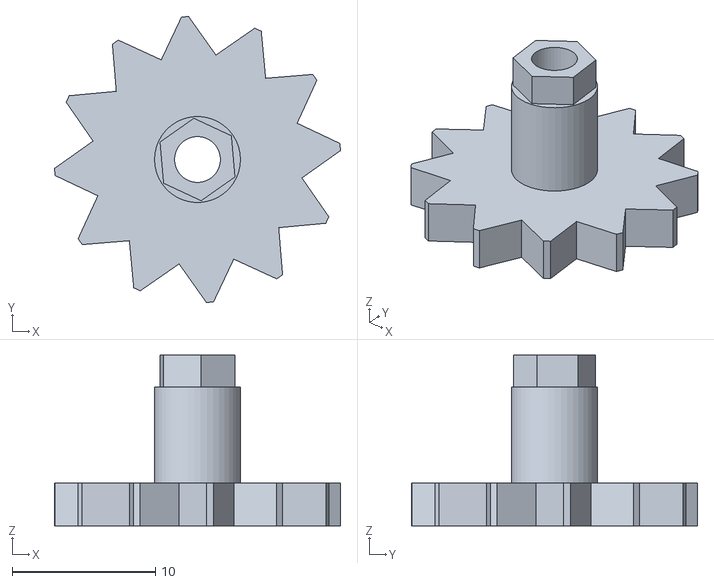
[picture p135: CAD file, 2026-11-04]
export/print/m2_main_dial/e6_star.stl
20.0 x 20.0 x 11.9
