paulforrester/horloge-astronomique/export/print/test_rig/front_plate.stl

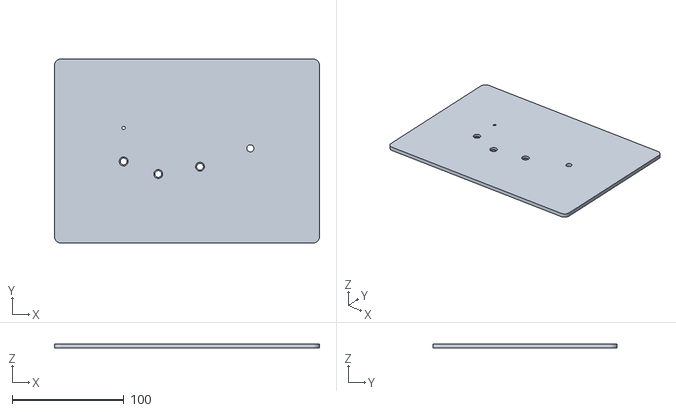
[picture p136: CAD file, 2026-11-03]
export/print/test_rig/front_plate.stl
237.5 x 165.3 x 4.00
