paulforrester/horloge-astronomique/export/print/e1_angels/bell_lock_cam.stl

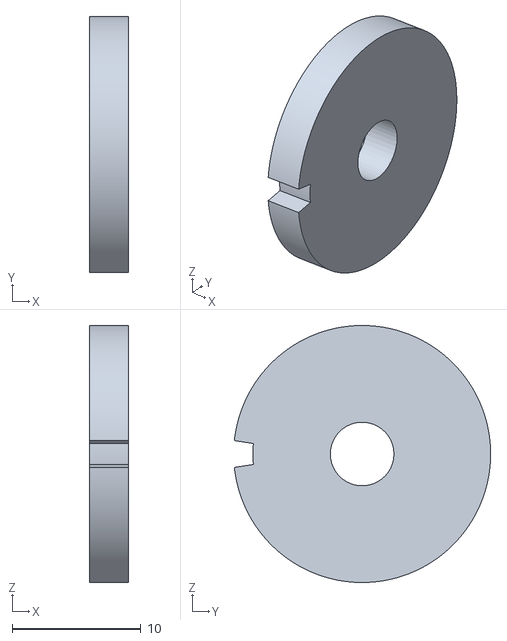
[picture p137: CAD file, 2026-11-08]
export/print/e1_angels/bell_lock_cam.stl
3.00 x 19.9 x 20.0
