paulforrester/horloge-astronomique/export/print/e2_ages/hour_wheel_45.stl

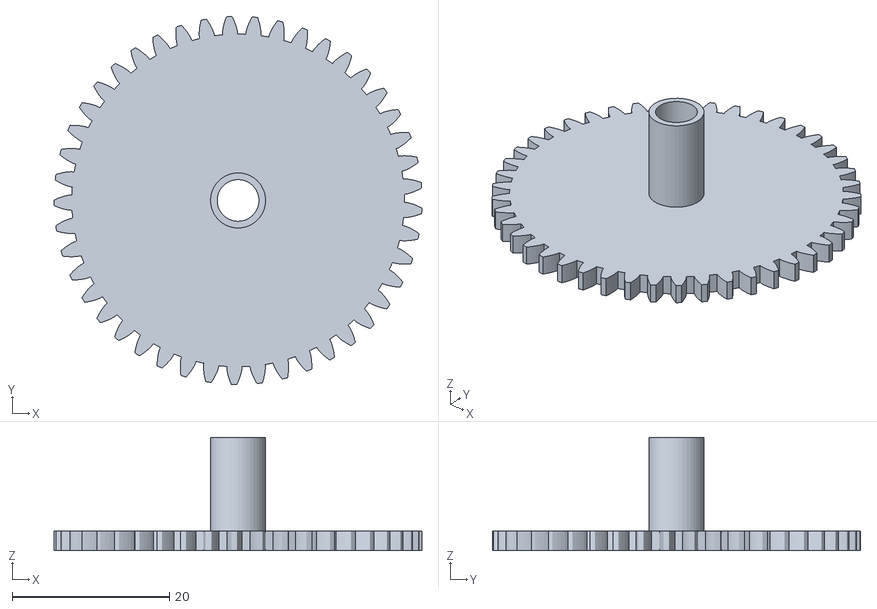
[picture p138: CAD file, 2026-11-08]
export/print/e2_ages/hour_wheel_45.stl
46.7 x 46.7 x 14.4
