paulforrester/horloge-astronomique/export/print/m2_main_dial/sector.3mf

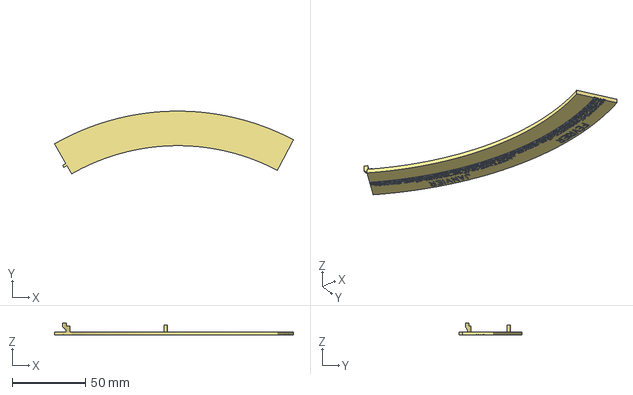
[picture p139: CAD file, 2026-11-04]
export/print/m2_main_dial/sector.3mf
163.1 x 42.8 x 8.20 mm
