paulforrester/horloge-astronomique/export/print/test_rig/clutch_front_collet.stl

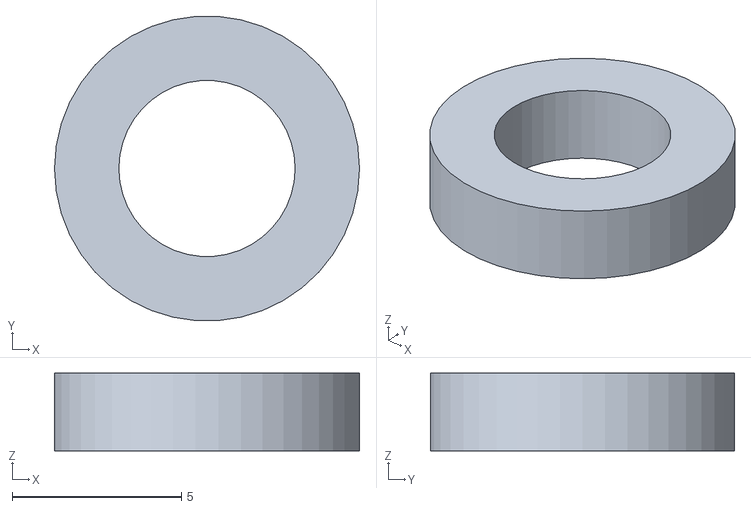
[picture p140: CAD file, 2026-11-03]
export/print/test_rig/clutch_front_collet.stl
9.00 x 8.97 x 2.30
