paulforrester/horloge-astronomique/export/print/e1_angels/count_wheel_60.stl

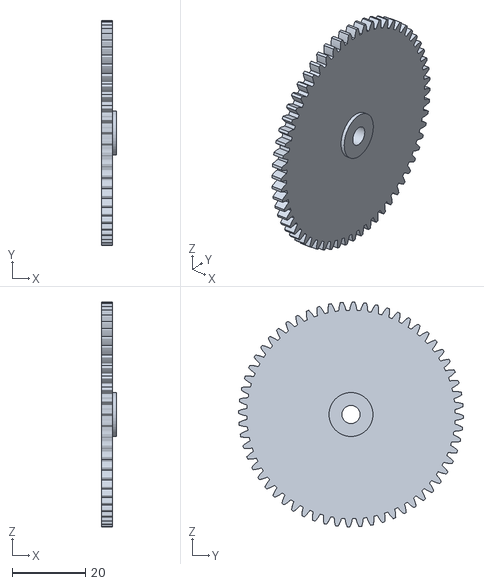
[picture p141: CAD file, 2026-11-08]
export/print/e1_angels/count_wheel_60.stl
4.00 x 61.4 x 61.4
