paulforrester/horloge-astronomique/export/print/e2_ages/quarter_release_arm.stl

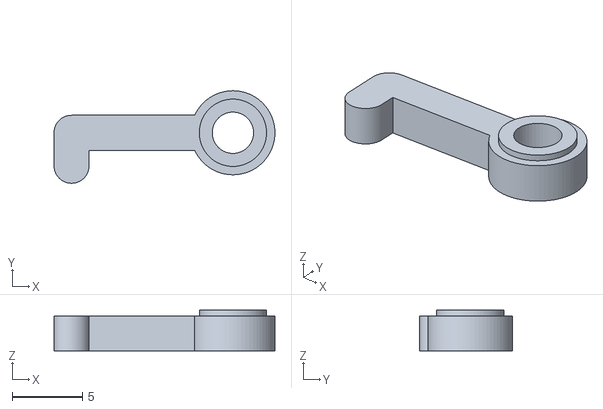
[picture p142: CAD file, 2026-11-08]
export/print/e2_ages/quarter_release_arm.stl
15.8 x 6.60 x 2.90
