paulforrester/horloge-astronomique/export/print/m2_main_dial/e6_pinion.stl

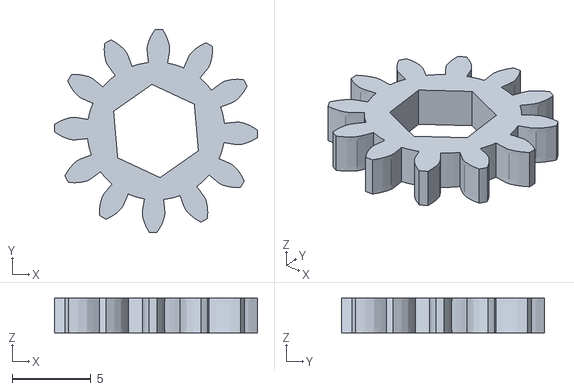
[picture p144: CAD file, 2026-11-04]
export/print/m2_main_dial/e6_pinion.stl
12.9 x 12.9 x 2.20
