paulforrester/horloge-astronomique/export/print/test_rig/cannon_pinion_12.stl

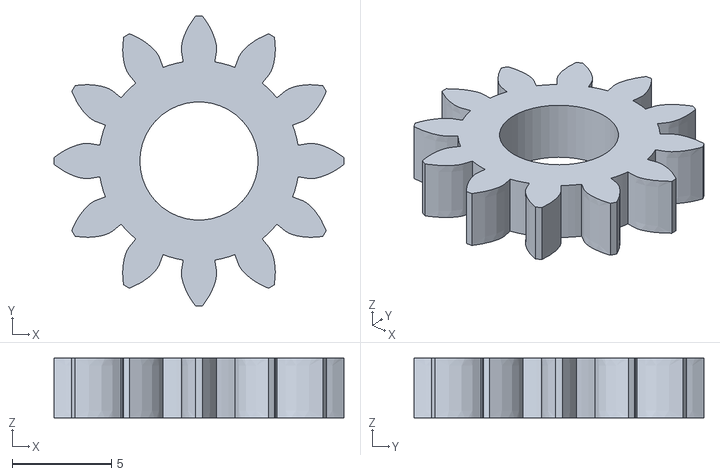
[picture p145: CAD file, 2026-11-03]
export/print/test_rig/cannon_pinion_12.stl
14.6 x 14.6 x 3.00
