paulforrester/horloge-astronomique/export/print/e1_angels/home_cam.stl

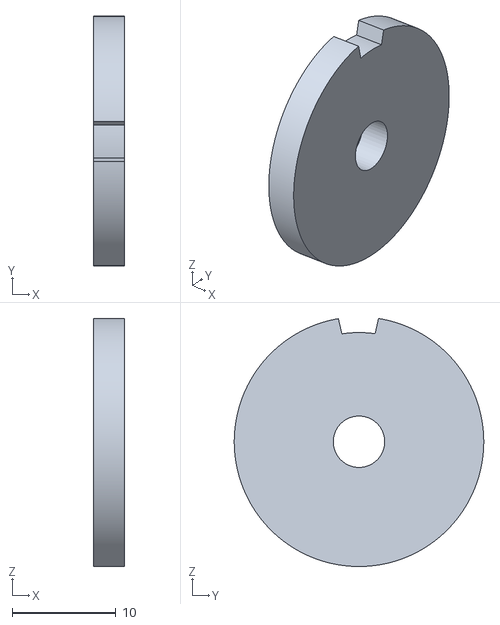
[picture p146: CAD file, 2026-11-08]
export/print/e1_angels/home_cam.stl
3.00 x 24.0 x 23.9
