paulforrester/horloge-astronomique/export/print/e2_ages/hour_rack.stl

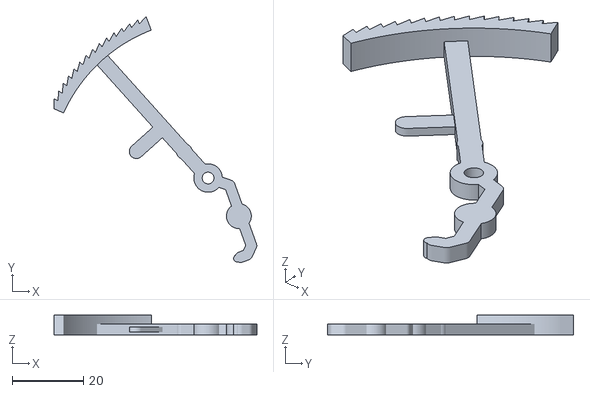
[picture p147: CAD file, 2026-11-08]
export/print/e2_ages/hour_rack.stl
56.9 x 69.1 x 5.50
