paulforrester/horloge-astronomique/export/print/e1_angels/coupling_left.stl

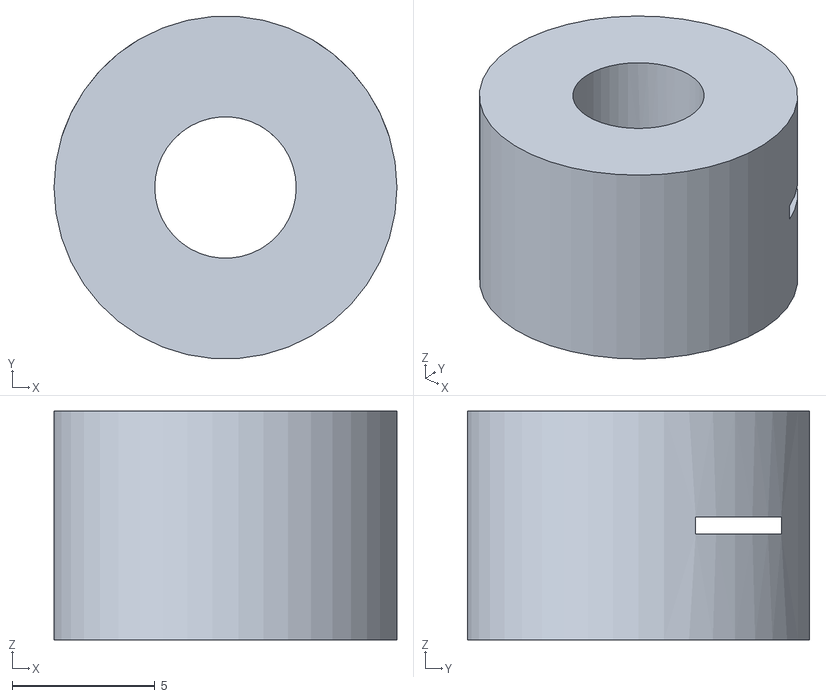
[picture p149: CAD file, 2026-11-08]
export/print/e1_angels/coupling_left.stl
12.0 x 12.0 x 8.00
