paulforrester/horloge-astronomique/export/print/e2_ages/quarter_lifter_cam.stl

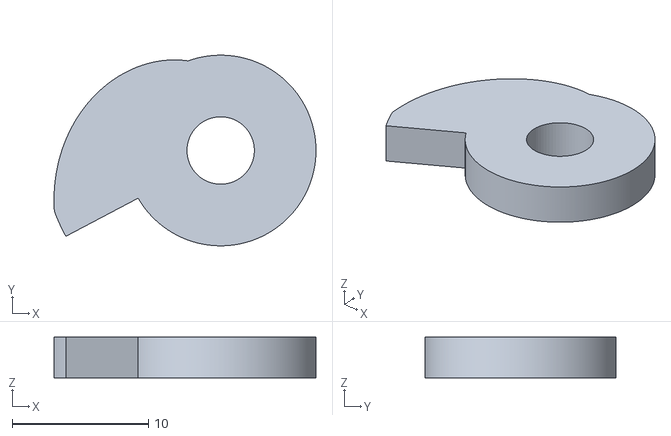
[picture p150: CAD file, 2026-11-08]
export/print/e2_ages/quarter_lifter_cam.stl
19.2 x 14.0 x 3.00
