paulforrester/horloge-astronomique/export/print/m1_time/silver_hour_wheel_45.stl

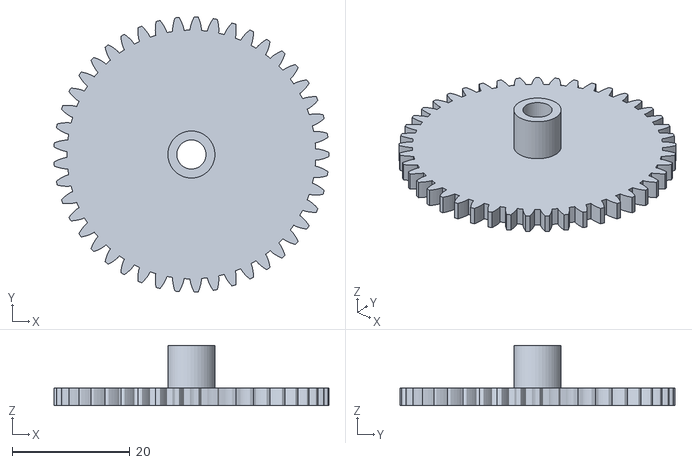
[picture p151: CAD file, 2026-11-05]
export/print/m1_time/silver_hour_wheel_45.stl
46.7 x 46.7 x 10.2
