paulforrester/horloge-astronomique/export/print/m2_main_dial/carrier_segment_2.stl

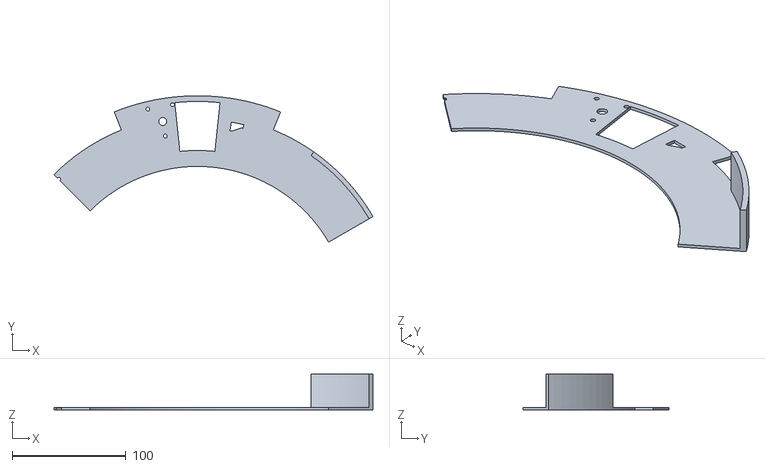
[picture p152: CAD file, 2026-11-04]
export/print/m2_main_dial/carrier_segment_2.stl
280.0 x 128.5 x 31.2
