paulforrester/horloge-astronomique/export/print/test_rig/arm_shadow.stl

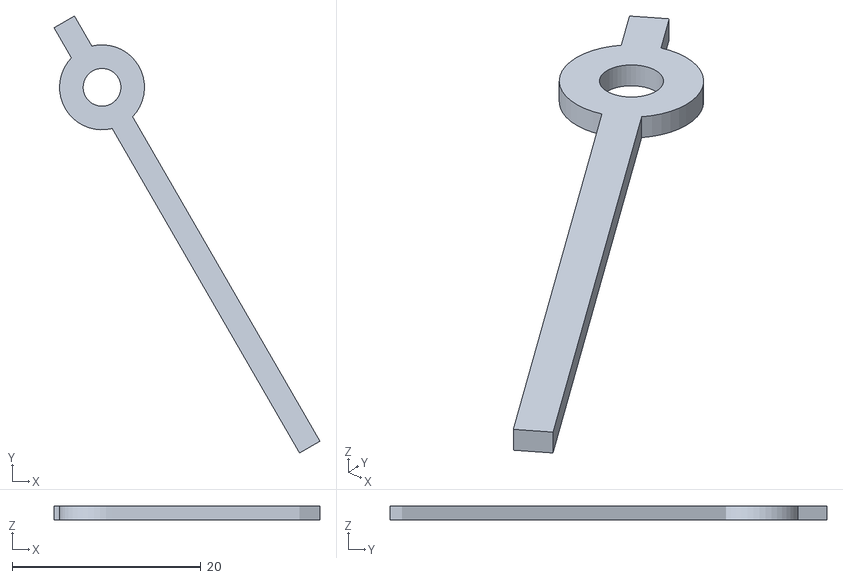
[picture p153: CAD file, 2026-11-03]
export/print/test_rig/arm_shadow.stl
28.2 x 46.3 x 1.50
