paulforrester/horloge-astronomique/export/print/e1_angels/motor_pinion_20.stl

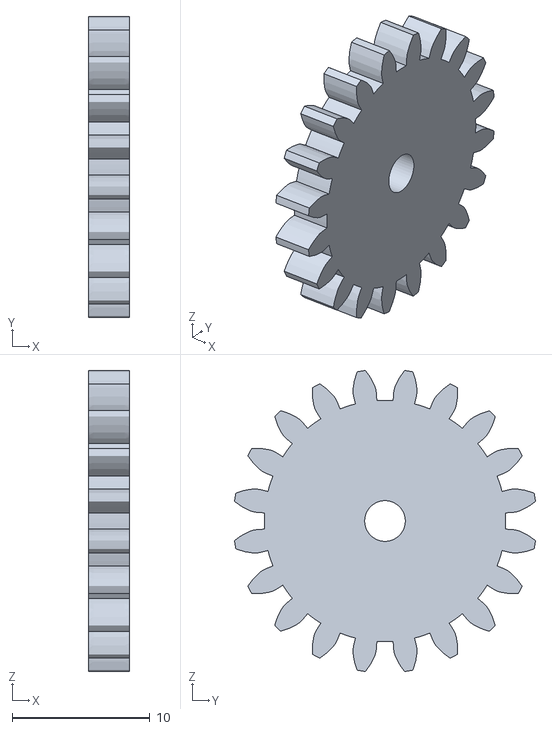
[picture p154: CAD file, 2026-11-08]
export/print/e1_angels/motor_pinion_20.stl
3.00 x 21.8 x 21.8
