paulforrester/horloge-astronomique/export/print/e2_ages/quarter_hook.stl

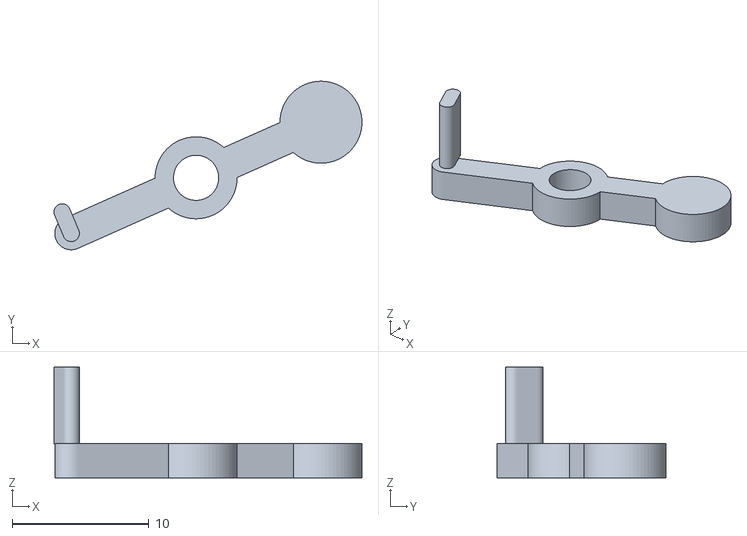
[picture p155: CAD file, 2026-11-08]
export/print/e2_ages/quarter_hook.stl
22.5 x 12.3 x 8.10
