paulforrester/horloge-astronomique/export/print/m1_time/hand_gilt_hour.stl

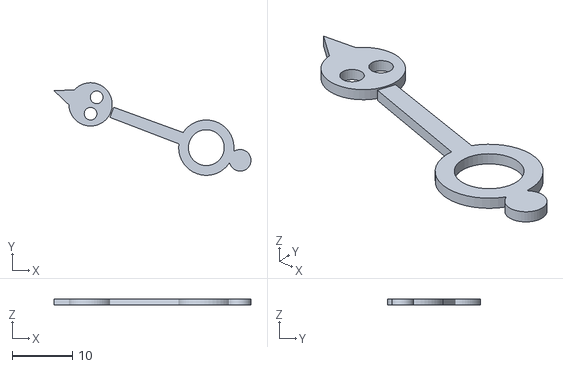
[picture p156: CAD file, 2026-11-05]
export/print/m1_time/hand_gilt_hour.stl
32.7 x 15.4 x 1.00
