paulforrester/horloge-astronomique/export/print/m2_main_dial/e6_jumper.stl

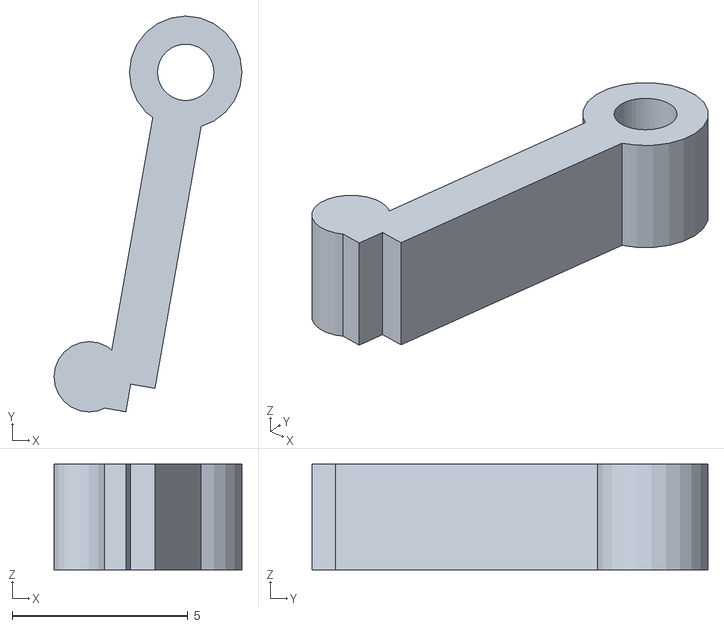
[picture p157: CAD file, 2026-11-04]
export/print/m2_main_dial/e6_jumper.stl
5.34 x 11.3 x 3.00
