paulforrester/horloge-astronomique/export/print/test_rig/electronics_tray.stl

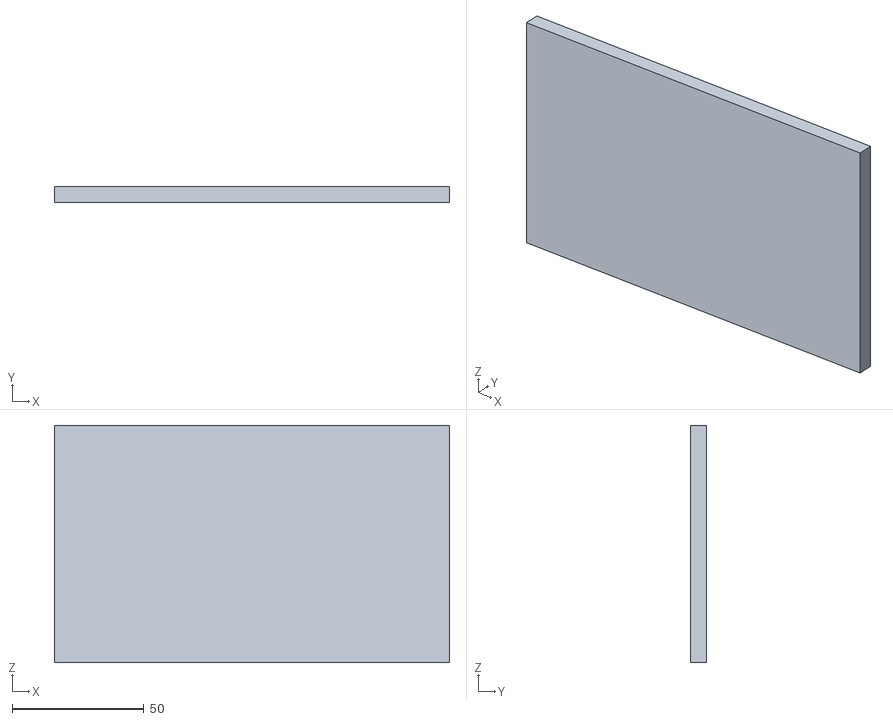
[picture p158: CAD file, 2026-11-03]
export/print/test_rig/electronics_tray.stl
150.0 x 6.00 x 90.0
