paulforrester/horloge-astronomique/export/print/tolerance_coupons/bearing_coupon.stl

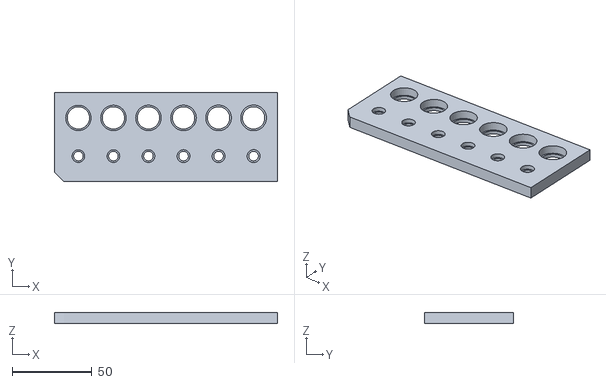
[picture p159: CAD file, 2026-11-03]
export/print/tolerance_coupons/bearing_coupon.stl
140.0 x 56.0 x 7.00
