paulforrester/horloge-astronomique/export/print/e1_angels/snail.stl

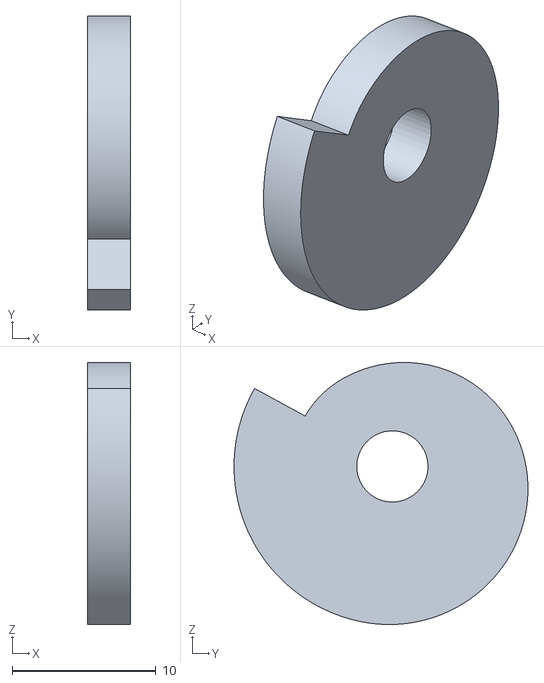
[picture p160: CAD file, 2026-11-08]
export/print/e1_angels/snail.stl
3.00 x 20.4 x 18.2
