paulforrester/horloge-astronomique/export/print/e2_ages/hour_spring_anchor.stl

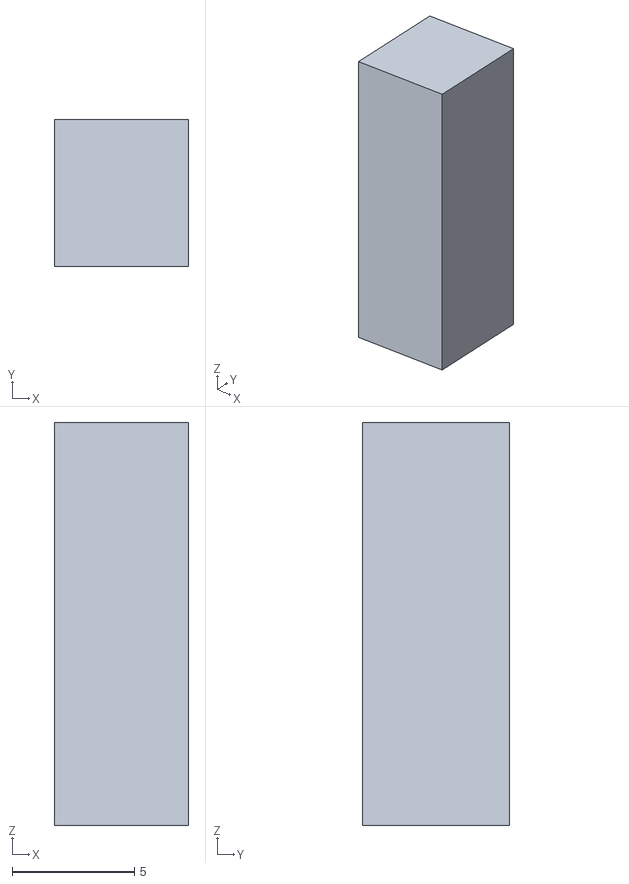
[picture p161: CAD file, 2026-11-08]
export/print/e2_ages/hour_spring_anchor.stl
5.50 x 6.00 x 16.5
