paulforrester/horloge-astronomique/export/print/m1_time/M1b_drive_45_noon_12.stl

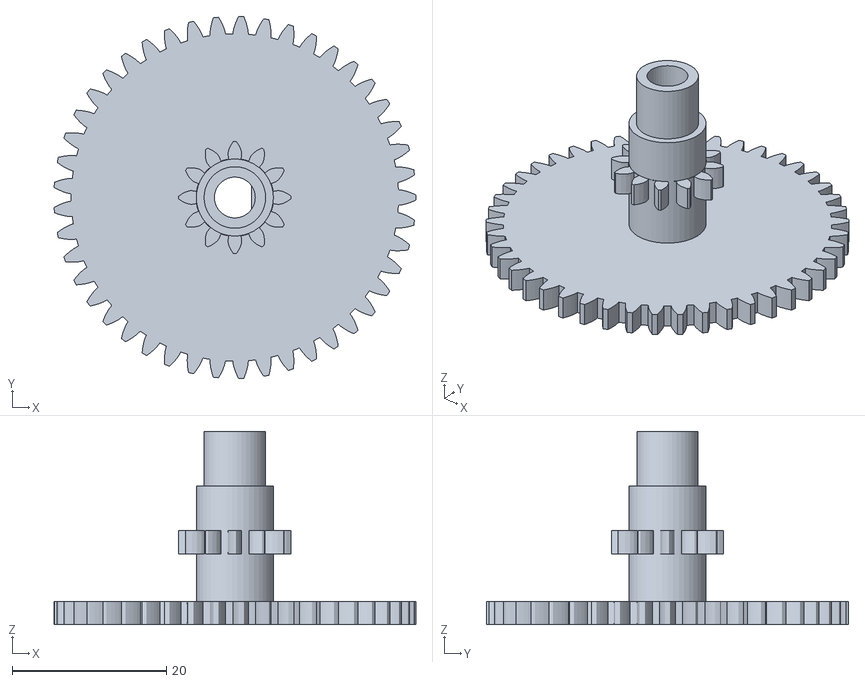
[picture p162: CAD file, 2026-11-05]
export/print/m1_time/M1b_drive_45_noon_12.stl
47.0 x 47.0 x 25.1
