paulforrester/horloge-astronomique/export/print/m2_main_dial/dial.3mf

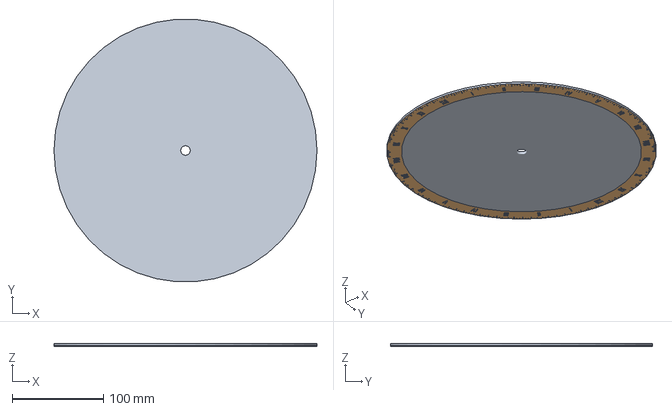
[picture p163: CAD file, 2026-11-04]
export/print/m2_main_dial/dial.3mf
287.5 x 286.7 x 3.00 mm
