paulforrester/horloge-astronomique/export/print/e1_angels/cross_gear_36.stl

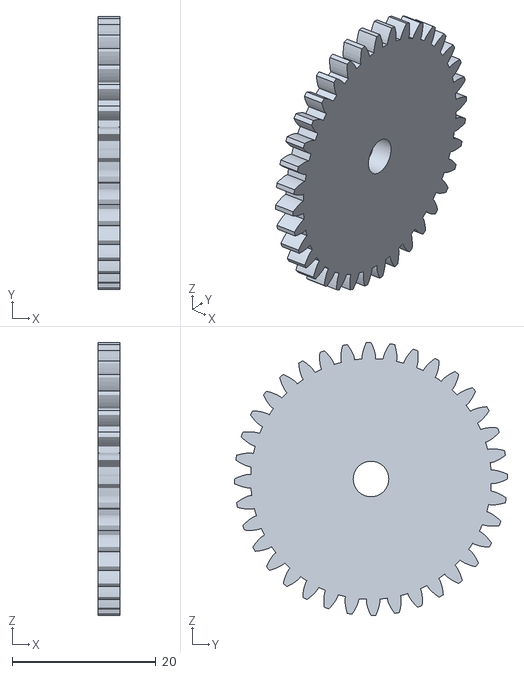
[picture p164: CAD file, 2026-11-08]
export/print/e1_angels/cross_gear_36.stl
3.00 x 38.0 x 38.0
