paulforrester/horloge-astronomique/export/print/e2_ages/quarter_feed_lever.stl

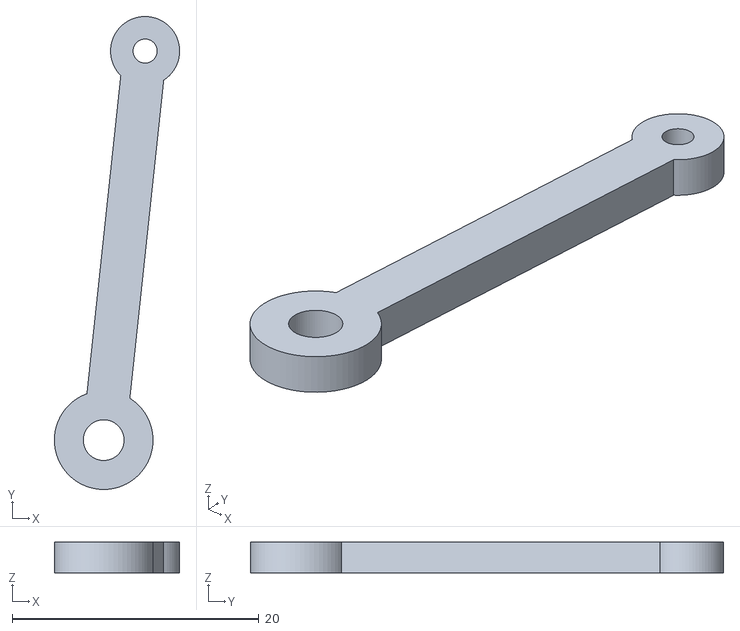
[picture p165: CAD file, 2026-11-08]
export/print/e2_ages/quarter_feed_lever.stl
10.2 x 38.3 x 2.50
