paulforrester/horloge-astronomique/export/print/m1_time/noon_wheel_54_12_X.stl

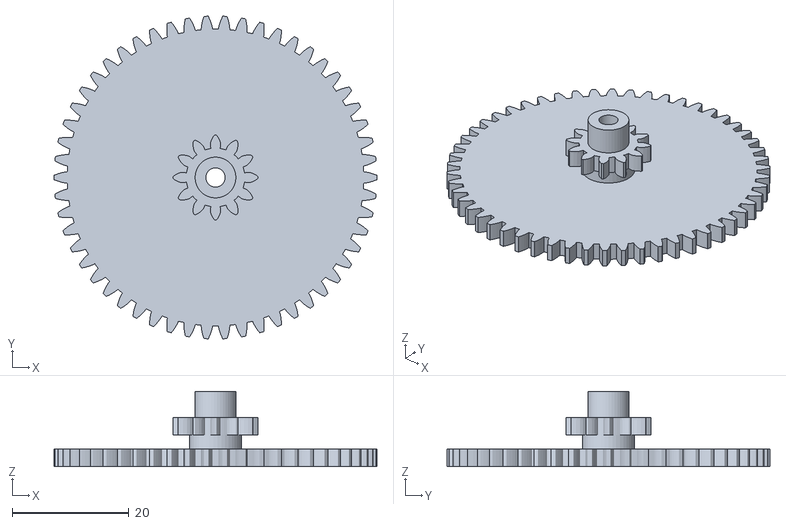
[picture p166: CAD file, 2026-11-05]
export/print/m1_time/noon_wheel_54_12_X.stl
55.4 x 55.3 x 12.9
