paulforrester/horloge-astronomique/export/print/test_rig/hour_wheel_45.stl

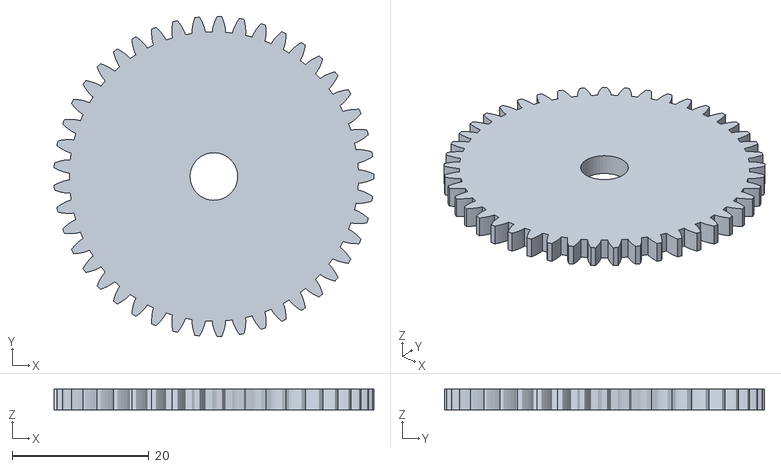
[picture p167: CAD file, 2026-11-03]
export/print/test_rig/hour_wheel_45.stl
46.7 x 46.7 x 3.00
