paulforrester/horloge-astronomique/export/print/e1_angels/detent_disc.stl

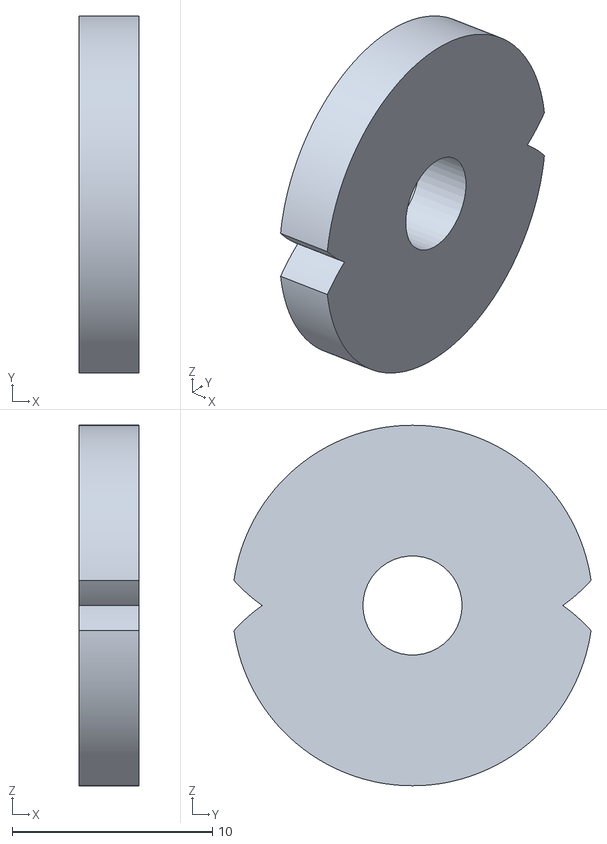
[picture p168: CAD file, 2026-11-08]
export/print/e1_angels/detent_disc.stl
3.00 x 17.8 x 18.0
