paulforrester/horloge-astronomique/export/print/e2_ages/quarter_pawl.stl

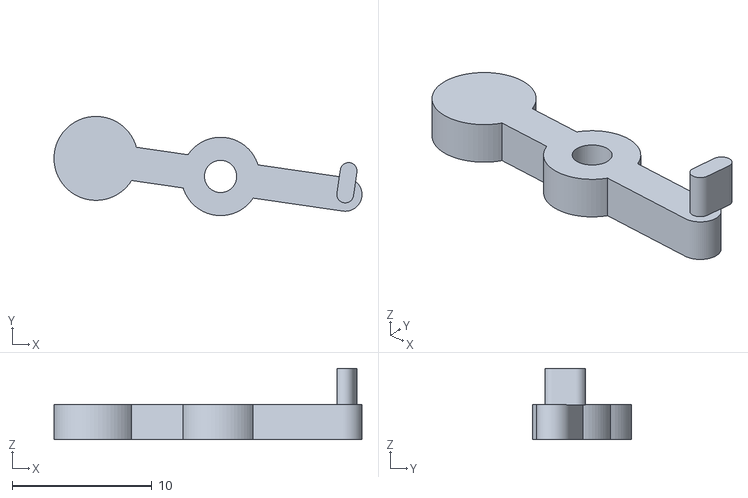
[picture p169: CAD file, 2026-11-08]
export/print/e2_ages/quarter_pawl.stl
22.0 x 7.08 x 5.10
