paulforrester/horloge-astronomique/export/print/m1_time/silver_cannon_12.stl

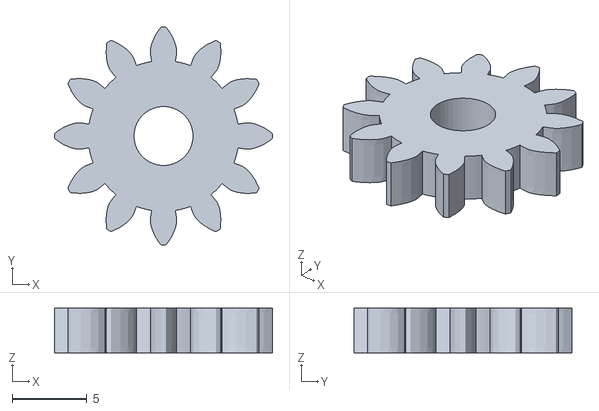
[picture p170: CAD file, 2026-11-05]
export/print/m1_time/silver_cannon_12.stl
14.6 x 14.6 x 3.00
