paulforrester/horloge-astronomique/export/print/m2_main_dial/wheel_C_click.stl

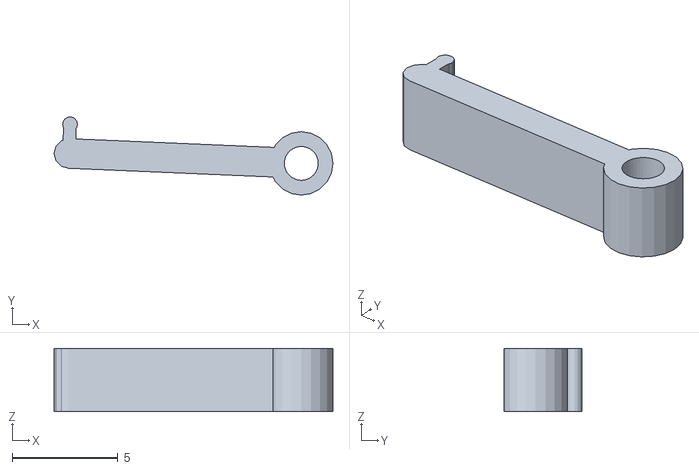
[picture p171: CAD file, 2026-11-03]
export/print/m2_main_dial/wheel_C_click.stl
13.2 x 3.70 x 3.00
