paulforrester/horloge-astronomique/export/print/test_rig/noon_wheel_54_12_X.stl

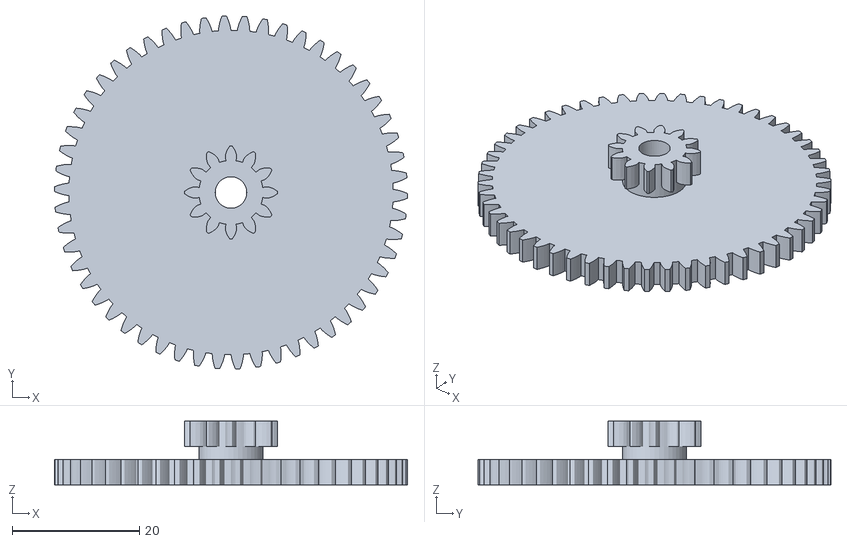
[picture p172: CAD file, 2026-11-03]
export/print/test_rig/noon_wheel_54_12_X.stl
55.4 x 55.4 x 10.00
