paulforrester/horloge-astronomique/export/print/e1_angels/sceptre_arm.stl

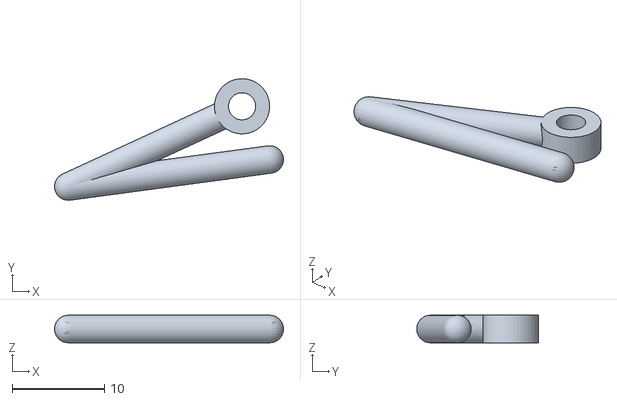
[picture p174: CAD file, 2026-11-08]
export/print/e1_angels/sceptre_arm.stl
24.9 x 13.2 x 3.00
