paulforrester/horloge-astronomique/export/print/e2_ages/quarter_cue_cam.stl

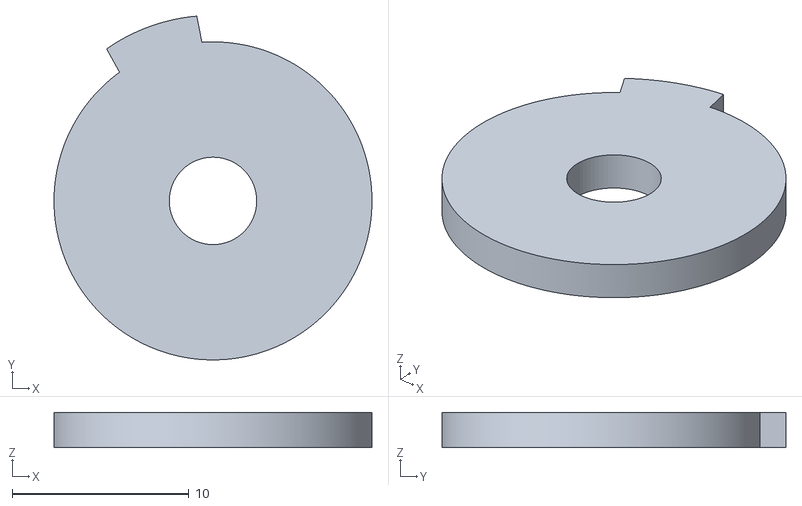
[picture p175: CAD file, 2026-11-08]
export/print/e2_ages/quarter_cue_cam.stl
18.0 x 19.5 x 2.00
