paulforrester/horloge-astronomique/export/print/m2_main_dial/satellite_4.stl

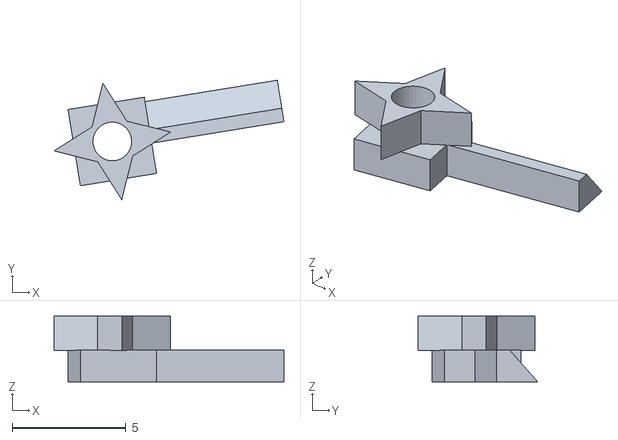
[picture p176: CAD file, 2026-11-03]
export/print/m2_main_dial/satellite_4.stl
10.1 x 5.26 x 2.90
