paulforrester/horloge-astronomique/export/print/tolerance_coupons/worm_cradle.stl

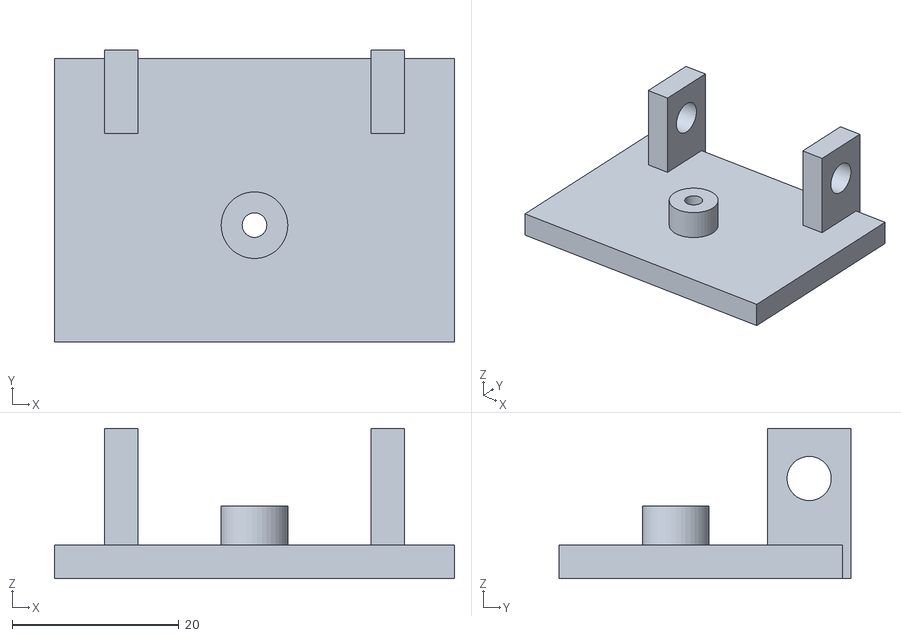
[picture p177: CAD file, 2026-11-03]
export/print/tolerance_coupons/worm_cradle.stl
48.0 x 35.0 x 18.0
