paulforrester/horloge-astronomique/export/print/e1_angels/plinth_glass.stl

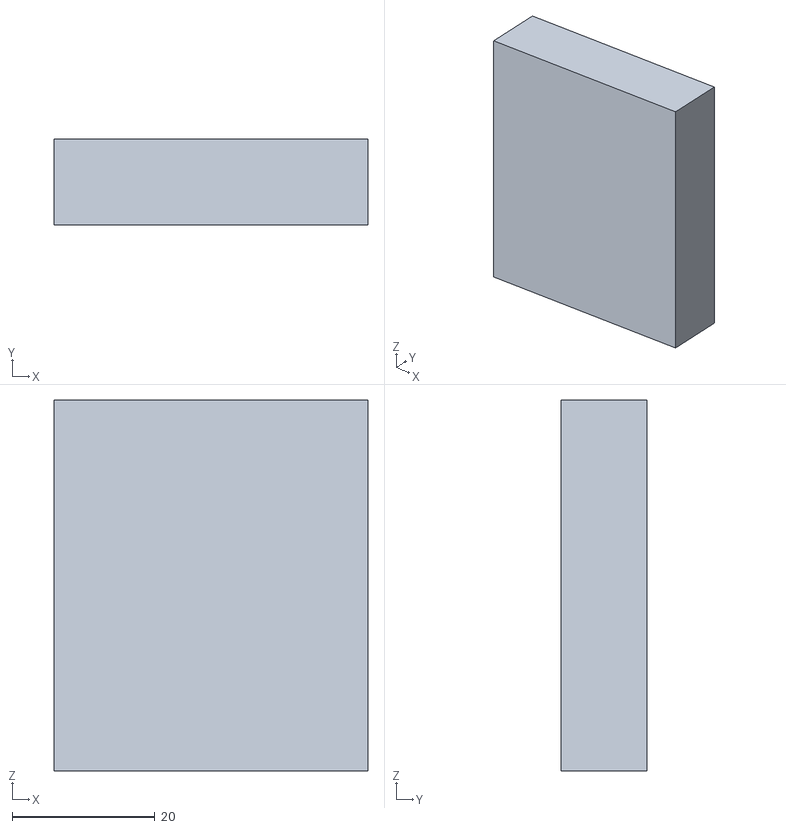
[picture p178: CAD file, 2026-11-08]
export/print/e1_angels/plinth_glass.stl
44.0 x 12.0 x 52.0
