paulforrester/horloge-astronomique/export/print/e2_ages/hour_snail.stl

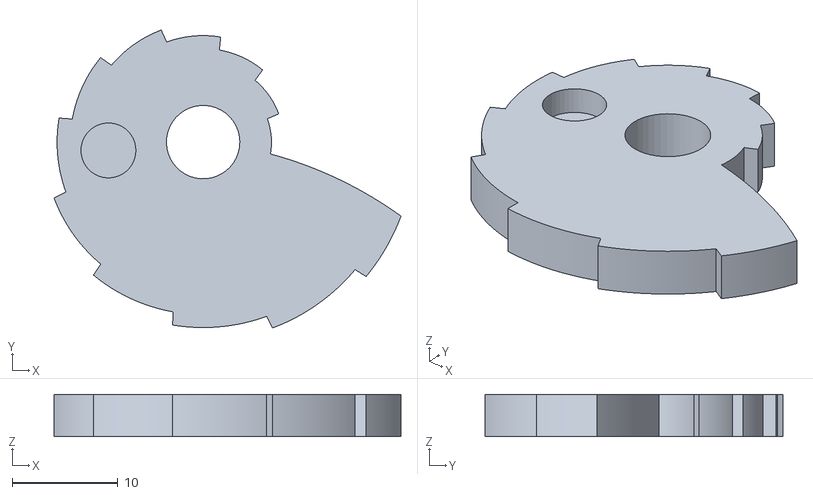
[picture p179: CAD file, 2026-11-08]
export/print/e2_ages/hour_snail.stl
32.9 x 28.2 x 4.00
