paulforrester/horloge-astronomique/export/print/m1_time/gilt_minute_pinion_15.stl

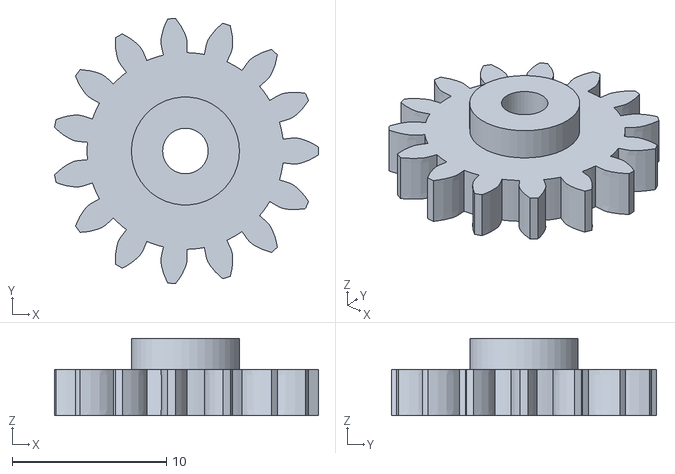
[picture p180: CAD file, 2026-11-05]
export/print/m1_time/gilt_minute_pinion_15.stl
17.1 x 17.2 x 5.00
