paulforrester/horloge-astronomique/(list of files, cad)

Other CAD files:
export/print/m2_main_dial/front_plate.stl
export/print/tolerance_coupons/gear_m1_b0p15_30.stl
export/print/tolerance_coupons/gear_m0p8_b0p10_15.stl
export/print/tolerance_coupons/gear_m1_b0p10_15.stl
export/print/tolerance_coupons/gear_m1_b0p10_30.stl
export/print/tolerance_coupons/gear_m0p8_b0p15_15.stl
export/print/m1_time/silver_drive_45.stl
export/print/tolerance_coupons/gear_m0p8_b0p15_30.stl
export/print/tolerance_coupons/gear_m0p6_b0p10_15.stl
export/print/m2_main_dial/ring_1.3mf
export/print/test_rig/sun_wheel_48_C.stl
export/print/tolerance_coupons/gear_m0p6_b0p20_30.stl
export/print/tolerance_coupons/gear_m0p6_b0p15_15.stl
export/print/test_rig/back_plate.stl
export/print/tolerance_coupons/gear_m1_b0p20_15.stl
export/print/m2_main_dial/ring_2.3mf
export/print/tolerance_coupons/gear_m0p8_b0p10_30.stl
export/print/m1_time/gilt_cannon_12.stl
export/print/e1_angels/bell_drive_gear_20.stl
export/print/e1_angels/follower_lever.stl
export/print/e1_angels/gearmotor_bracket.stl
export/print/e1_angels/glass_arm_rear.stl
export/print/e1_angels/plinth_bell.stl
export/print/e1_angels/sector_36.stl
export/print/e1_angels/tower_outer_plate.stl
export/print/e1_angels/yoke.stl
export/print/e2_ages/age_cam.stl
export/print/e2_ages/ages_bell_bracket.stl
export/print/e2_ages/back_wall.stl
export/print/e2_ages/bell_arm.stl
export/print/e2_ages/bell_collar.stl
export/print/e2_ages/bell_hall_post.stl
export/print/e2_ages/bell_sleeve.stl
export/print/e2_ages/deck.stl
export/print/e2_ages/floor_front.stl
export/print/e2_ages/floor_island.stl
export/print/e2_ages/floor_post_0.stl
export/print/e2_ages/hour_feed_lever.stl
export/print/e2_ages/hour_lifter_cam.stl
export/print/e2_ages/hour_strap.stl
export/print/e2_ages/island_post_0.stl
export/print/e2_ages/lock_cam.stl
export/print/e2_ages/lock_switch_bracket.stl
export/print/e2_ages/pedestal.stl
export/print/e2_ages/pier_left.stl
export/print/e2_ages/program_bearing_block.stl
export/print/e2_ages/program_cam.stl
export/print/e2_ages/program_gear_72.stl
export/print/e2_ages/push_rod.stl
export/print/e2_ages/quarter_eccentric.stl
export/print/e2_ages/quarter_motor_plate.stl
export/print/e2_ages/quarter_spring_anchor.stl
export/print/e2_ages/release_cam.stl
export/print/e2_ages/ring.stl
export/print/e2_ages/rod_guide_0.stl
export/print/e2_ages/state_block.stl
export/print/e2_ages/state_coupling.stl
export/print/e2_ages/state_motor_adapter.stl
export/print/e2_ages/state_motor_plate.stl
export/print/e2_ages/state_plate_left.stl
export/print/e2_ages/strike_plate_middle.stl
export/print/e2_ages/support_post_0.stl
export/print/e2_ages/wait_arm.stl
export/print/e2_ages/wait_gear_crank.stl
export/print/e2_ages/walk_bearing_block.stl
export/print/e2_ages/walk_compound.stl
export/print/e2_ages/walk_hub.stl
export/print/e2_ages/walk_motor_bracket.stl
export/print/e2_ages/walk_motor_pinion_12.stl
export/print/e2_ages/walk_pinion_16.stl
export/print/e2_ages/walk_spacer.stl
export/print/m1_time/M1_drive_45.stl
export/print/m1_time/back_plate.stl
export/print/m1_time/front_plate.stl
export/print/m1_time/hand_silver_hour.stl
export/print/m2_main_dial/I_154.stl
export/print/m2_main_dial/I_72.stl
export/print/m2_main_dial/I_84.stl
export/print/m2_main_dial/J_169.stl
export/print/m2_main_dial/J_sleeve_88.stl
export/print/m2_main_dial/R1_12.stl
export/print/m2_main_dial/R1_48.stl
export/print/m2_main_dial/S_12_weekday.stl
export/print/m2_main_dial/S_bump_0.stl
export/print/m2_main_dial/S_carrier_plate.stl
export/print/m2_main_dial/S_carrier_worm_wheel.stl
export/print/m2_main_dial/S_planet_0_1.stl
export/print/m2_main_dial/S_sleeve_sun_48.stl
export/print/m2_main_dial/S_sun_A.stl
export/print/m2_main_dial/S_worm.stl
export/print/m2_main_dial/S_worm_block_0.stl
export/print/m2_main_dial/W_84.stl
export/print/m2_main_dial/apollo_arrow.stl
export/print/m2_main_dial/arm_shadow.stl
export/print/m2_main_dial/bridge.stl
export/print/m2_main_dial/bridge_pillar_0.stl
export/print/m2_main_dial/carrier_joint_0.stl
export/print/m2_main_dial/carrier_segment_0.stl
export/print/m2_main_dial/carrier_segment_1.stl
export/print/m2_main_dial/carrier_segment_3.stl
export/print/m2_main_dial/counting_lever.stl
export/print/m2_main_dial/dial_foot_0.stl
export/print/m2_main_dial/hand_moon.stl
export/print/m2_main_dial/hand_sun.stl
export/print/m2_main_dial/moon_ball.stl
export/print/m2_main_dial/pillar_0.stl
export/print/m2_main_dial/setter_plunger.stl
export/print/m2_main_dial/setter_reset_ramp.stl
export/print/m2_main_dial/setter_rocker.stl
export/print/m2_main_dial/setter_set_ramp.stl
export/print/m2_main_dial/shadow_disc.stl
export/print/m2_main_dial/sun_disc.stl
export/print/m2_main_dial/wheel_moon.stl
export/print/m2_main_dial/wheel_shadow.stl
export/print/m2_main_dial/wheel_sun.stl
export/print/m2_main_dial/wheel_sunrise.stl
export/print/m2_main_dial/wheel_sunset.stl
export/print/m2_main_dial/witness_flag_1_March.stl
