paulforrester/horloge-astronomique/export/print/e1_angels/README.md

# Print files: e1_angels

Generated by `python -m cad.export_print`; do not edit by hand.

33 distinct parts, 36 prints in all. Each STL is already in its print pose, centred and standing on the bed (z = 0): drag it into Bambu Studio and it lands on the plate.

- **Down-facing** is the area (mm²) facing down more steeply than 45° and not on the bed: overhangs *and* bridges. Under about 100 mm² it is bridged holes, seats and slots that print without support; larger values are explained in the notes. Each part is posed to keep it small.
- **Fit** is checked against the H2D build volume, single nozzle (325 × 320 × 325) and dual nozzle (300 × 320 × 325).
- **Nozzle 0.2** marks parts with module 0.8 teeth or 2 mm lettering.
- **Mesh** is lib3mf's check that the part meshes closed and manifold, as Bambu Studio expects.
- **Fits not final.** The press, slide and bearing fits wait for the tolerance coupons, so print `tolerance_coupons` first and regenerate after `FITS` is updated.

| File | Qty | Also used as | Material | Nozzle | Size on bed (mm) | Fits | Down-facing (mm²) | Mesh | Notes |
|---|---|---|---|---|---|---|---|---|---|
| `tower_inner_plate.stl` | 1 | — | PETG | 0.4 | 98 × 80 × 3.0 | both | 0 | ok | carries the bell shaft, the intermediate, the count wheel and the cross shaft (MR85ZZ seats) |
| `tower_outer_plate.stl` | 1 | — | PETG | 0.4 | 98 × 80 × 3.0 | both | 0 | ok | carries the bell shaft, the intermediate, the count wheel and the cross shaft (MR85ZZ seats) |
| `tower_pillars.stl` | 1 | — | PETG | 0.4 | 32 × 81 × 98.0 | both | 1011 | ok | four pillars between the plates (M3 through) |
| `bell_pinion_12.stl` | 1 | — | PLA | 0.4 | 3 × 15 × 14.6 | both | 67 | ok | pressed on the bell shaft |
| `intermediate_48_12.stl` | 1 | — | PLA | 0.4 | 7 × 49 × 49.4 | both | 325 | ok | 48 + 12 in one print, pressed on the intermediate arbor |
| `count_wheel_60.stl` | 1 | — | PLA | 0.4 | 4 × 61 × 61.4 | both | 312 | ok | the count wheel: one turn per hour's work (1:20) |
| `sector_36.stl` | 1 | — | PLA | 0.4 | 36 × 36 × 3.0 | both | 0 | ok | mutilated gear: 18 teeth over 180° turn the cross shaft half a turn while the count wheel makes its silent half |
| `cross_gear_36.stl` | 1 | — | PLA | 0.4 | 3 × 38 × 38.0 | both | 185 | ok | pressed on the cross shaft's stub |
| `snail.stl` | 1 | — | PLA | 0.4 | 3 × 20 × 18.2 | both | 52 | ok | one stroke per turn: rest in the high dwell, the drop 30° on, the rise 60–280° (pressure angle ≤ 9°) |
| `silencing_cam.stl` | 1 | — | PLA | 0.4 | 3 × 41 × 36.2 | both | 96 | ok | holds the follower lever off the snail for the ten silent turns (count wheel 180–360°) |
| `follower_lever.stl` | 1 | — | PLA | 0.4 | 60 × 8 × 6.5 | both | 247 | ok | pivots on a Ø3 pin in the inner plate: roller on the snail, pin on the silencing cam, wire at the tip |
| `follower_roller.stl` | 1 | — | PLA | 0.4 | 3 × 4 × 4.0 | both | 11 | ok | printed sleeve, free on the lever's axle |
| `bell_lock_cam.stl` | 1 | — | PLA | 0.4 | 3 × 20 × 20.0 | both | 55 | ok | one notch: the bell lock (the switch opens at rest) |
| `home_cam.stl` | 1 | — | PLA | 0.4 | 3 × 24 × 23.9 | both | 59 | ok | one notch 18° wide: only the twentieth turn's lock falls in it (home) |
| `detent_disc.stl` | 1 | — | PLA | 0.4 | 3 × 18 × 18.0 | both | 55 | ok | two notches 180° apart: holds the cross shaft at a dead centre between hours |
| `bell_drive_gear_20.stl` | 1 | — | PLA | 0.4 | 3 × 22 × 22.0 | both | 109 | ok | pressed on the bell shaft |
| `motor_pinion_20.stl` | 1 | — | PLA | 0.4 | 3 × 22 × 21.8 | both | 102 | ok | pressed on the gearmotor's Ø3 D-shaft; 1:1 with the bell shaft |
| `gearmotor_bracket.stl` | 1 | — | PETG | 0.4 | 42 × 16 × 15.0 | both | 431 | ok | a saddle on the plates' top edges (4 × M2): its cheeks hold the gearmotor; lift it out upwards |
| `plinth_bell.stl` | 1 | — | PLA | 0.4 | 46 × 10 × 52.0 | both | 60 | ok | printed, painted: the ledge the genie sits on; it belongs to E1, the wooden cornice fits round it with a gap (D12 R5) |
| `plinth_glass.stl` | 1 | — | PLA | 0.4 | 44 × 12 × 52.0 | both | 0 | ok | printed, painted: the ledge the genie sits on; it belongs to E1, the wooden cornice fits round it with a gap (D12 R5) |
| `shoulder_bracket.stl` | 1 | — | PETG | 0.4 | 23 × 48 × 13.0 | both | 96 | ok | on the plinth: the shoulder arbor's two MR63ZZ, the spring's post and the banking stop |
| `shoulder_lever.stl` | 1 | — | PLA | 0.4 | 21 × 7 × 2.5 | both | 0 | ok | 15.5 mm lever: the wire's 8.1 mm pull cocks the arm 30° |
| `sceptre_arm.stl` | 1 | — | PLA | 0.4 | 25 × 13 × 3.0 | both | 30 | ok | the arm and the striker in one print, pressed on the shoulder arbor; painted with the figure |
| `coupling_left.stl` | 2 | coupling_right | PLA | 0.4 | 12 × 12 × 8.0 | both | 28 | ok | single-dog coupling (two halves; one way round only: the glass's phase) |
| `glass_crank_block.stl` | 1 | — | PETG | 0.4 | 28 × 50 × 16.0 | both | 70 | ok | two MR85ZZ for the crank's stub; screwed to the glass tower's plate |
| `crank.stl` | 1 | — | PLA | 0.4 | 26 × 26 × 3.0 | both | 0 | ok | r 9.425 = π·r_p / 2 [D]: its 2r stroke is half a turn of the pinion |
| `yoke.stl` | 1 | — | PLA | 0.4 | 15 × 31 × 9.0 | both | 219 | ok | Scotch yoke: the crank pin runs in its slot |
| `rack.stl` | 1 | — | PLA | 0.4 | 26 × 38 × 5.2 | both | 260 | ok | 12 teeth, module 1.0: pressed on the slider rod; turns the glass's pinion |
| `glass_pinion_12.stl` | 1 | — | PLA | 0.4 | 15 × 15 × 4.0 | both | 0 | ok | pressed on the glass arbor |
| `glass_tower_plate.stl` | 1 | — | PETG | 0.4 | 101 × 205 × 3.0 | both | 0 | ok | the glass tower's plate: guides, arms and the crank block screw to it; M5 tabs to the internal frame |
| `guide_low.stl` | 2 | guide_high | PETG | 0.4 | 9 × 10 × 6.0 | both | 0 | ok | the slider rod's guide |
| `glass_arm_rear.stl` | 2 | glass_arm_front | PETG | 0.4 | 39 × 10 × 5.0 | both | 18 | ok | carries one MR63ZZ of the glass arbor |
| `forearms_and_frame.stl` | 1 | — | PLA | 0.4 | 28 × 23 × 15.6 | both | 281 | ok | the forearms and the glass's frame in one print (Paul: the forearms turn the glass) |
