paulforrester/horloge-astronomique/export/print/e2_ages/README.md

# Print files: e2_ages

Generated by `python -m cad.export_print`; do not edit by hand.

70 distinct parts, 87 prints in all. Each STL is already in its print pose, centred and standing on the bed (z = 0): drag it into Bambu Studio and it lands on the plate.

- **Down-facing** is the area (mm²) facing down more steeply than 45° and not on the bed: overhangs *and* bridges. Under about 100 mm² it is bridged holes, seats and slots that print without support; larger values are explained in the notes. Each part is posed to keep it small.
- **Fit** is checked against the H2D build volume, single nozzle (325 × 320 × 325) and dual nozzle (300 × 320 × 325).
- **Nozzle 0.2** marks parts with module 0.8 teeth or 2 mm lettering.
- **Mesh** is lib3mf's check that the part meshes closed and manifold, as Bambu Studio expects.
- **Fits not final.** The press, slide and bearing fits wait for the tolerance coupons, so print `tolerance_coupons` first and regenerate after `FITS` is updated.

| File | Qty | Also used as | Material | Nozzle | Size on bed (mm) | Fits | Down-facing (mm²) | Mesh | Notes |
|---|---|---|---|---|---|---|---|---|---|
| `floor_island.stl` | 1 | — | PETG | 0.4 | 215 × 215 × 3.0 | both | 0 | ok | the static floor inside the ring: Death, the bells and the back wall stand on it |
| `floor_front.stl` | 1 | — | PETG | 0.4 | 203 × 51 × 3.0 | both | 0 | ok | the static floor in front of the ring |
| `back_wall.stl` | 1 | — | PETG | 0.4 | 128 × 4 × 72.0 | both | 0 | ok | the back wall; the doorways are the gaps at its ends [E: h 72] |
| `pier_left.stl` | 2 | pier_right | PETG | 0.4 | 10 × 40 × 100.0 | both | 0 | ok |  |
| `island_post_0.stl` | 3 | island_post_1, island_post_2 | PETG | 0.4 | 8 × 8 × 40.0 | both | 0 | ok |  |
| `floor_post_0.stl` | 4 | floor_post_1, floor_post_2, floor_post_3 | PETG | 0.4 | 5 × 5 × 40.0 | both | 0 | ok |  |
| `pedestal.stl` | 1 | — | PETG | 0.4 | 24 × 18 × 6.0 | both | 0 | ok |  |
| `ages_bell_bracket.stl` | 2 | deaths_bell_bracket | PETG | 0.4 | 4 × 12 × 35.0 | both | 7 | ok | bell bracket on the island floor |
| `ring.stl` | 1 | — | PLA | 0.4 | 268 × 268 × 30.0 | both | 62 | ok | turntable Ø268: walking surface flush with the floor, 264 teeth; per age a selection peg at its own height and a waiting peg below them all |
| `support_post_0.stl` | 4 | support_post_1, support_post_2, support_post_3 | PETG | 0.4 | 6 × 8 × 36.0 | both | 0 | ok |  |
| `walk_pinion_16.stl` | 1 | — | PLA | 0.4 | 18 × 18 × 4.6 | both | 0 | ok | pressed on the top of the walk shaft: turns the ring |
| `bell_arm.stl` | 1 | — | PLA | 0.4 | 12 × 7 × 2.5 | both | 0 | ok | pressed on the square rod: catches only the selected age's peg |
| `bell_collar.stl` | 1 | — | PLA | 0.4 | 10 × 10 × 1.2 | both | 0 | ok | pressed on the sleeve above the deck: it rests on the deck |
| `wait_arm.stl` | 1 | — | PLA | 0.4 | 6 × 12 × 16.7 | both | 0 | ok | pressed on its shaft: catches any waiting peg; its hub rests on the deck |
| `wait_gear_crank.stl` | 1 | — | PLA | 0.4 | 14 × 14 × 4.0 | both | 6 | ok | 12 teeth and the crank (r 5) in one print, pressed on the waiting shaft |
| `bell_sleeve.stl` | 1 | — | PLA | 0.4 | 14 × 14 × 21.5 | both | 0 | ok | 12 teeth and the keyed sleeve in one print: turns in the deck, opposite to the waiting shaft; the square rod slides in it |
| `push_rod.stl` | 1 | — | PETG | 0.4 | 38 × 51 × 2.2 | both | 0 | ok | the program cam's follower: slides in two guides; its yoke turns the crank |
| `rod_guide_0.stl` | 2 | rod_guide_1 | PETG | 0.4 | 14 × 13 × 10.0 | both | 42 | ok | hangs from the deck (two M2 into inserts) |
| `walk_bearing_block.stl` | 1 | — | PETG | 0.4 | 18 × 18 × 4.0 | both | 0 | ok | the walk shaft's lower bearing: screwed under the deck (2 x M2) |
| `walk_spacer.stl` | 1 | — | PLA | 0.4 | 8 × 8 × 1.0 | both | 0 | ok | on the top bearing's inner race |
| `walk_compound.stl` | 1 | — | PLA | 0.4 | 25 × 25 × 6.0 | both | 39 | ok | 24 + 12' in one print, free on the walk shaft: the clutch's driven member |
| `walk_hub.stl` | 1 | — | PLA | 0.4 | 12 × 12 × 2.0 | both | 0 | ok | pressed on the walk shaft: the clutch's friction face |
| `walk_motor_pinion_12.stl` | 3 | quarter_motor_pinion, hour_motor_pinion | PLA | 0.4 | 14 × 14 × 2.5 | both | 0 | ok | pressed on the gearmotor's Ø3 D-shaft |
| `walk_motor_bracket.stl` | 1 | — | PETG | 0.4 | 28 × 29 × 37.5 | both | 66 | ok | holds the gearmotor; two M2 screws under the deck: undo them and the motor drops out with its pinion |
| `program_gear_72.stl` | 1 | — | PLA | 0.4 | 73 × 73 × 2.5 | both | 0 | ok | pressed on the program shaft: one turn per show |
| `program_bearing_block.stl` | 1 | — | PETG | 0.4 | 18 × 18 × 4.2 | both | 0 | ok | the program shaft's upper bearing: screwed on the deck (2 x M2) |
| `program_cam.stl` | 1 | — | PLA | 0.4 | 47 × 47 × 4.3 | both | 0 | ok | grooved underneath: the push rod's follower runs in it (pressure angle ≤ 36° [D]) |
| `lock_cam.stl` | 1 | — | PLA | 0.4 | 24 × 24 × 2.0 | both | 0 | ok | two notches (end of phase A, end of the show): the microswitch stops the walk motor |
| `release_cam.stl` | 1 | — | PLA | 0.4 | 32 × 32 × 3.0 | both | 0 | ok | grooved underneath: in phase A it rocks the quarter release shaft, whose arm turns the quarter hook out (part 2b) |
| `lock_switch_bracket.stl` | 1 | — | PETG | 0.4 | 13 × 12 × 6.8 | both | 0 | ok | hangs from the deck; the switch screws to it (2 x M2) |
| `bell_hall_post.stl` | 1 | — | PETG | 0.4 | 6 × 6 × 36.5 | both | 0 | ok |  |
| `age_cam.stl` | 1 | — | PLA | 0.4 | 35 × 31 × 5.0 | both | 0 | ok | sets the bell rod's height: 4 steps of 4 mm, a ramp back from the old man to the child |
| `quarter_snail.stl` | 1 | — | PLA | 0.4 | 25 × 23 × 4.0 | both | 0 | ok | part 2b's quarter rack falls on it: 1 to 4 pairs |
| `index_disc.stl` | 1 | — | PLA | 0.4 | 24 × 24 × 3.0 | both | 0 | ok | its magnet passes the index Hall at minute 0 |
| `state_pinion_12.stl` | 1 | — | PLA | 0.4 | 15 × 15 × 2.5 | both | 0 | ok | pressed on the state arbor: the 12:1 motion work's input |
| `lay_compound.stl` | 1 | — | PLA | 0.4 | 49 × 49 × 5.3 | both | 61 | ok | 48 + 15 in one print, free on its stud |
| `hour_wheel_45.stl` | 1 | — | PLA | 0.4 | 47 × 47 × 14.4 | both | 0 | ok | the hour wheel on its tube, free on the state arbor (1 turn in 12 h) |
| `hour_snail.stl` | 1 | — | PLA | 0.4 | 33 × 28 × 4.0 | both | 0 | ok | pressed on the hour wheel's tube; the hour rack falls on it: 1 to 12 strokes |
| `state_plate_left.stl` | 1 | — | PETG | 0.4 | 10 × 88 × 60.2 | both | 62 | ok | carries the arbor's left bearing and the lay stud |
| `state_block.stl` | 1 | — | PETG | 0.4 | 10 × 20 × 43.0 | both | 24 | ok | the arbor's right bearing and the index Hall |
| `state_coupling.stl` | 1 | — | PLA | 0.4 | 12 × 12 × 38.9 | both | 19 | ok | pressed on the arbor; the NEMA 17's D-shaft slides into its D socket (D16: plugs in from the right) |
| `state_motor_adapter.stl` | 1 | — | PLA | 0.4 | 66 × 42 × 7.0 | both | 361 | ok | D16 adapter: screwed to the motor at the bench |
| `state_motor_plate.stl` | 1 | — | PETG | 0.4 | 11 × 42 × 64.5 | both | 106 | ok | the motor's plate: its adapter's boss locates in it; two M3 heat-set inserts |
| `quarter_rack.stl` | 1 | — | PLA | 0.2 | 33 × 55 × 5.5 | both | 38 | ok | quarter rack, gathered: its tail falls onto the quarter snail; 4 teeth of pitch 2.5 |
| `quarter_feed_lever.stl` | 1 | — | PLA | 0.4 | 10 × 38 × 2.5 | both | 0 | ok | rocked by the eccentric: gathers one tooth per turn of the strike shaft |
| `quarter_pawl.stl` | 2 | hour_pawl | PLA | 0.2 | 22 × 7 × 5.1 | both | 1 | ok | gathering pawl, on the feed lever's pin |
| `quarter_hook.stl` | 1 | — | PLA | 0.2 | 22 × 12 × 8.1 | both | 1 | ok | rack hook: holds each gathered tooth |
| `quarter_strap.stl` | 1 | — | PLA | 0.4 | 33 × 16 × 2.5 | both | 0 | ok | strap from the eccentric to the feed lever's pin |
| `quarter_eccentric.stl` | 2 | hour_eccentric | PLA | 0.4 | 12 × 12 × 2.5 | both | 0 | ok | throw 2.11 mm |
| `hour_rack.stl` | 1 | — | PLA | 0.2 | 57 × 69 × 5.5 | both | 38 | ok | hour rack, gathered: its tail falls onto the hour snail; 12 teeth of pitch 2.5 |
| `hour_feed_lever.stl` | 1 | — | PLA | 0.4 | 18 × 55 × 2.5 | both | 0 | ok | rocked by the eccentric: gathers one tooth per turn of the strike shaft |
| `hour_hook.stl` | 1 | — | PLA | 0.2 | 24 × 15 × 8.1 | both | 1 | ok | rack hook: holds each gathered tooth |
| `hour_strap.stl` | 1 | — | PLA | 0.4 | 32 × 16 × 2.5 | both | 0 | ok | strap from the eccentric to the feed lever's pin |
| `quarter_spring_anchor.stl` | 1 | — | PETG | 0.4 | 6 × 6 × 11.6 | both | 0 | ok | the spring's upper hook catches its pin; screwed to the strike plate |
| `hour_spring_anchor.stl` | 1 | — | PETG | 0.4 | 6 × 6 × 16.5 | both | 0 | ok | the spring's upper hook catches its pin; screwed to the strike plate |
| `quarter_lock_cam.stl` | 2 | hour_lock_cam | PLA | 0.4 | 18 × 18 × 2.0 | both | 0 | ok | its notch lets the lock switch's roller drop at the rest angle |
| `quarter_lifter_cam.stl` | 1 | — | PLA | 0.4 | 19 × 14 × 3.0 | both | 0 | ok | lifts the striking figure and drops it at 1 s (part 2c takes the lift on) |
| `quarter_cue_cam.stl` | 1 | — | PLA | 0.4 | 18 × 20 × 2.0 | both | 0 | ok | closes E1's cue switch at the start of each pair: the genie strikes first |
| `quarter_strike_gear.stl` | 2 | hour_strike_gear | PLA | 0.4 | 25 × 25 × 2.5 | both | 0 | ok | 24 teeth, pressed on the strike shaft |
| `quarter_motor_plate.stl` | 1 | — | PETG | 0.4 | 52 × 26 × 3.0 | both | 0 | ok | the gearmotor's face screws to it (2 × M1.6); it hangs from the deck |
| `hour_lifter_cam.stl` | 1 | — | PLA | 0.4 | 19 × 14 × 2.5 | both | 0 | ok | lifts the striking figure and drops it at 1 s (part 2c takes the lift on) |
| `hour_motor_plate.stl` | 1 | — | PETG | 0.4 | 59 × 26 × 3.0 | both | 0 | ok | the gearmotor's face screws to it (2 × M1.6); it hangs from the deck |
| `strike_plate_middle.stl` | 1 | — | PETG | 0.4 | 61 × 61 × 3.0 | both | 0 | ok | hangs from the deck: the shafts' bearings, the hour train's studs, the hour trip shaft and its stop |
| `strike_plate_right.stl` | 1 | — | PETG | 0.4 | 61 × 52 × 3.0 | both | 0 | ok | hangs from the deck: the quarter shaft's bearing, the quarter studs and both release shafts |
| `witness_bracket.stl` | 1 | — | PETG | 0.4 | 20 × 26 × 4.0 | both | 0 | ok | carries the witness Hall beside the hour snail |
| `quarter_release_arm.stl` | 1 | — | PLA | 0.4 | 16 × 7 × 2.9 | both | 0 | ok | pressed on the release shaft: in phase A it pushes the quarter hook's weighted tail, and the hook turns out |
| `quarter_release_follower.stl` | 1 | — | PLA | 0.4 | 13 × 6 × 8.7 | both | 4 | ok | pressed on the release shaft: its Ø2 pin runs in the release disc's groove |
| `hour_trip_arm_a.stl` | 1 | — | PLA | 0.4 | 14 × 17 × 5.4 | both | 0 | ok | pressed on the trip shaft: the quarter rack's pin lifts its shoe past three pairs |
| `hour_trip_arm_b.stl` | 1 | — | PLA | 0.4 | 8 × 12 × 7.8 | both | 0 | ok | pressed on the trip shaft: pushes the hour hook's tab, and the hook turns out |
| `deck.stl` | 1 | — | PETG | 0.4 | 295 × 297 × 4.0 | both | 17 | ok | the module's deck: rollers, posts, stops and drives stand on it; the state module hangs under it |
