paulforrester/horloge-astronomique/export/print/m2_main_dial/README.md

# Print files: m2_main_dial

Generated by `python -m cad.export_print`; do not edit by hand.

73 distinct parts, 103 prints in all. Each STL is already in its print pose, centred and standing on the bed (z = 0): drag it into Bambu Studio and it lands on the plate.

- **Down-facing** is the area (mm²) facing down more steeply than 45° and not on the bed: overhangs *and* bridges. Under about 100 mm² it is bridged holes, seats and slots that print without support; larger values are explained in the notes. Each part is posed to keep it small.
- **Fit** is checked against the H2D build volume, single nozzle (325 × 320 × 325) and dual nozzle (300 × 320 × 325).
- **Nozzle 0.2** marks parts with module 0.8 teeth or 2 mm lettering.
- **Mesh** is lib3mf's check that the part meshes closed and manifold, as Bambu Studio expects.
- **Fits not final.** The press, slide and bearing fits wait for the tolerance coupons, so print `tolerance_coupons` first and regenerate after `FITS` is updated.

**Multi-colour print `dial.3mf`**: dial_field, dial_hour_ring. Open it, answer *Yes* to loading it as one object with several parts, then give each part its filament.

**Multi-colour print `ring_0.3mf`**: ring_text_0, ring_segment_0. Open it, answer *Yes* to loading it as one object with several parts, then give each part its filament.

**Multi-colour print `ring_1.3mf`**: ring_text_1, ring_segment_1. Open it, answer *Yes* to loading it as one object with several parts, then give each part its filament.

**Multi-colour print `ring_2.3mf`**: ring_text_2, ring_segment_2. Open it, answer *Yes* to loading it as one object with several parts, then give each part its filament.

**Multi-colour print `ring_3.3mf`**: ring_text_3, ring_segment_3. Open it, answer *Yes* to loading it as one object with several parts, then give each part its filament.

**Multi-colour print `sector.3mf`**: sector_text, sector_jan_feb. Open it, answer *Yes* to loading it as one object with several parts, then give each part its filament.

| File | Qty | Also used as | Material | Nozzle | Size on bed (mm) | Fits | Down-facing (mm²) | Mesh | Notes |
|---|---|---|---|---|---|---|---|---|---|
| `hemisphere_dome.stl` | 1 | — | silver | 0.4 | 94 × 94 × 5.0 | both | 0 | ok | Ø94 Earth hemisphere, the original's size; a map of the northern hemisphere (finish TBD) |
| `wheel_sun.stl` | 1 | — | PLA | 0.4 | 50 × 50 × 4.0 | both | 0 | ok |  |
| `S_sleeve_sun_48.stl` | 3 | S_sleeve_shadow_48, wheel_cam | PLA | 0.4 | 50 × 50 × 4.0 | both | 0 | ok |  |
| `wheel_shadow.stl` | 1 | — | PLA | 0.4 | 50 × 50 × 4.0 | both | 0 | ok |  |
| `wheel_moon.stl` | 1 | — | PLA | 0.4 | 85 × 85 × 4.0 | both | 0 | ok |  |
| `J_sleeve_88.stl` | 1 | — | PLA | 0.4 | 90 × 90 × 4.0 | both | 0 | ok |  |
| `I_154.stl` | 1 | — | PLA | 0.4 | 156 × 156 × 4.0 | both | 0 | ok |  |
| `J_169.stl` | 1 | — | PLA | 0.4 | 171 × 171 × 4.0 | both | 0 | ok |  |
| `I_84.stl` | 2 | S_84 | PLA | 0.4 | 86 × 86 × 4.0 | both | 0 | ok |  |
| `wheel_sunrise.stl` | 1 | — | PLA | 0.4 | 50 × 50 × 4.0 | both | 0 | ok | v1: locked by a pin; v1.5: driven |
| `wheel_sunset.stl` | 1 | — | PLA | 0.4 | 50 × 50 × 4.0 | both | 0 | ok | v1: locked by a pin; v1.5: driven |
| `S_sun_A.stl` | 4 | S_sun_B, J_sun_A, J_sun_B | PLA | 0.4 | 22 × 22 × 4.0 | both | 0 | ok |  |
| `S_planet_0_1.stl` | 8 | S_planet_0_2, S_planet_1_1, S_planet_1_2, J_planet_0_1, J_planet_0_2, J_planet_1_1, J_planet_1_2 | PLA | 0.4 | 20 × 20 × 8.4 | both | 0 | ok |  |
| `S_carrier_plate.stl` | 2 | J_carrier_plate | PLA | 0.4 | 60 × 60 × 3.0 | both | 0 | ok |  |
| `S_carrier_worm_wheel.stl` | 2 | J_carrier_worm_wheel | PLA | 0.4 | 59 × 59 × 6.0 | both | 0 | ok | 60 T worm wheel = carrier (correction input) |
| `S_worm.stl` | 2 | J_worm | PLA | 0.2 | 14 × 14 × 24.0 | both | 952 | ok | 60:1, self-locking: the v1 lock. Prints axis vertical; the thread's lower flank is a 70° overhang 2 mm deep, so use fine layers (0.1 mm) and check it on a test print |
| `S_worm_block_0.stl` | 4 | S_worm_block_1, J_worm_block_0, J_worm_block_1 | PETG | 0.4 | 12 × 12 × 10.0 | both | 0 | ok | pillow block with an MR85ZZ, bolted to a standoff from the back plate |
| `I_72.stl` | 1 | — | PLA | 0.4 | 92 × 92 × 6.0 | both | 0 | ok |  |
| `R1_12.stl` | 1 | — | PLA | 0.4 | 18 × 18 × 6.0 | both | 0 | ok |  |
| `R1_48.stl` | 1 | — | PLA | 0.4 | 62 × 62 × 6.0 | both | 0 | ok |  |
| `motor_pinion_12.stl` | 1 | — | PLA | 0.4 | 18 × 18 × 8.7 | both | 0 | ok | pressed on the motor's D-shaft, its hub 0.3 mm clear of the adapter's boss (set with a shim); it comes out with the motor, back through the plate's hole (D16) |
| `motor_adapter.stl` | 1 | — | PETG | 0.4 | 42 × 66 × 7.0 | both | 361 | ok | motor adapter (D16): screwed to the motor at the bench; plugs into the back plate from behind, 2 x M3 x 8 into heat-set inserts |
| `S_12_weekday.stl` | 1 | — | PLA | 0.4 | 15 × 15 × 4.0 | both | 0 | ok |  |
| `W_84.stl` | 1 | — | PLA | 0.4 | 85 × 85 × 4.0 | both | 0 | ok |  |
| `hand_sun.stl` | 1 | — | dial | 0.4 | 71 × 120 × 1.5 | both | 0 | ok | split-collet hub: friction clutch on the tube (architecture §7) |
| `sun_disc.stl` | 1 | — | PLA | 0.4 | 5 × 5 × 1.5 | both | 0 | ok |  |
| `hand_moon.stl` | 1 | — | silver | 0.4 | 126 × 75 × 2.0 | both | 0 | ok | split-collet hub: friction clutch on the tube (architecture §7) |
| `moon_ball.stl` | 1 | — | silver | 0.4 | 4 × 4 × 4.6 | both | 8 | ok |  |
| `arm_shadow.stl` | 1 | — | black | 0.4 | 71 × 120 × 1.5 | both | 0 | ok | split-collet hub: friction clutch on the tube (architecture §7) |
| `shadow_disc.stl` | 1 | — | black | 0.4 | 12 × 12 × 1.5 | both | 0 | ok |  |
| `front_plate.stl` | 1 | — | PETG | 0.4 | 281 × 232 × 4.0 | both | 0 | ok |  |
| `back_plate.stl` | 1 | — | PETG | 0.4 | 281 × 232 × 4.0 | both | 0 | ok |  |
| `bridge.stl` | 1 | — | PETG | 0.4 | 146 × 64 × 3.0 | both | 0 | ok |  |
| `bridge_pillar_0.stl` | 2 | bridge_pillar_1 | PETG | 0.4 | 8 × 8 × 38.0 | both | 0 | ok |  |
| `pillar_0.stl` | 6 | pillar_1, pillar_2, pillar_3, pillar_4, pillar_5 | PETG | 0.4 | 9 × 9 × 94.6 | both | 0 | ok |  |
| `dial.3mf` | 1 | — | dial | 0.2 | 288 × 288 × 3.0 | both | 0 | ok | two-colour print, body 1 (azure); face down |
| `dial.3mf` | 1 | — | silver | 0.2 | 288 × 288 × 0.8 | both | 0 | ok | two-colour print, body 2 (silver); face down |
| `ring_0.3mf` | 1 | — | black | 0.2 | 227 × 61 × 2.8 | both | 3841 | ok | dates, second filament of ring_0.3mf |
| `ring_0.3mf` | 1 | — | PLA | 0.2 | 236 × 92 × 8.5 | both | 3841 | ok | gold, face down: the dates are a flush black inlay on the bed side (0.2 mm nozzle); the Jan-Feb sector's seat is a pocket open to the bed: support from the bed inside it, ideally with a support-interface filament on the second nozzle |
| `ring_1.3mf` | 1 | — | black | 0.2 | 80 × 223 × 0.4 | both | 0 | ok | dates, second filament of ring_1.3mf |
| `ring_1.3mf` | 1 | — | PLA | 0.2 | 92 × 236 × 8.5 | both | 0 | ok | gold, face down: the dates are a flush black inlay on the bed side (0.2 mm nozzle) |
| `ring_2.3mf` | 1 | — | black | 0.2 | 222 × 81 × 0.4 | both | 0 | ok | dates, second filament of ring_2.3mf |
| `ring_2.3mf` | 1 | — | PLA | 0.2 | 236 × 92 × 8.5 | both | 0 | ok | gold, face down: the dates are a flush black inlay on the bed side (0.2 mm nozzle) |
| `ring_3.3mf` | 1 | — | black | 0.2 | 82 × 222 × 0.4 | both | 0 | ok | dates, second filament of ring_3.3mf |
| `ring_3.3mf` | 1 | — | PLA | 0.2 | 92 × 236 × 8.5 | both | 0 | ok | gold, face down: the dates are a flush black inlay on the bed side (0.2 mm nozzle) |
| `sector.3mf` | 1 | — | black | 0.2 | 155 × 30 × 0.4 | both | 5 | ok | 1 Jan … 28 Feb, second filament of sector.3mf |
| `sector.3mf` | 1 | — | PLA | 0.2 | 163 × 43 × 8.2 | both | 5 | ok | slides one division: leap / common; foot, arm and lug grow up from the face-down plate on a chamfer, no support |
| `S_bump_0.stl` | 2 | S_bump_1 | PLA | 0.4 | 3 × 3 × 1.8 | both | 0 | ok |  |
| `witness_flag_1_March.stl` | 1 | — | PLA | 0.4 | 2 × 2 × 5.3 | both | 0 | ok |  |
| `carrier_segment_0.stl` | 1 | — | PETG | 0.4 | 252 × 98 × 31.2 | both | 473 | ok | printed frame segment, face down; L-section rim where it overhangs the front plate |
| `carrier_segment_1.stl` | 1 | — | PETG | 0.4 | 83 × 252 × 31.2 | both | 58 | ok | printed frame segment, face down; L-section rim where it overhangs the front plate |
| `carrier_segment_2.stl` | 1 | — | PETG | 0.4 | 280 × 128 × 31.2 | both | 12 | ok | printed frame segment, face down; L-section rim where it overhangs the front plate |
| `carrier_segment_3.stl` | 1 | — | PETG | 0.4 | 90 × 215 × 31.2 | both | 220 | ok | printed frame segment, face down; L-section rim where it overhangs the front plate |
| `carrier_joint_0.stl` | 3 | carrier_joint_1, carrier_joint_2 | PETG | 0.4 | 52 × 52 × 2.5 | both | 0 | ok | splice plate, 2 x M3 each side |
| `setter_rocker.stl` | 1 | — | PLA | 0.4 | 12 × 12 × 2.7 | both | 0 | ok | flip-flop: holds the sector's tab pin; its tip pins meet the station's ramps |
| `setter_detent_anchor.stl` | 1 | — | PETG | 0.4 | 4 × 3 × 1.5 | both | 0 | ok | glued under the lip: clamps the detent wire |
| `setter_reset_ramp.stl` | 1 | — | PETG | 0.4 | 10 × 9 × 1.4 | both | 0 | ok | fixed: puts the sector in its common position |
| `setter_set_ramp.stl` | 1 | — | PETG | 0.4 | 12 × 7 × 1.7 | both | 4 | ok | glued on the plunger's peg; the carrier window keeps it square |
| `setter_plunger.stl` | 1 | — | PETG | 0.2 | 19 × 5 × 5.0 | both | 38 | ok | follower: ball tip on wheel C; printed lying down |
| `station_bracket.stl` | 1 | — | PETG | 0.4 | 30 × 21 × 20.0 | both | 5 | ok | screwed under the carrier's station extension |
| `wheel_C_100.stl` | 1 | — | PLA | 0.2 | 63 × 63 × 4.4 | both | 0 | ok | year in the century: 100-tooth ratchet, 24 leap bumps |
| `satellite_4.stl` | 1 | — | PLA | 0.2 | 10 × 5 × 2.9 | both | 1 | ok | Ungerer's satellite: ¼ turn per turn of C, one bump in 400 years |
| `counting_lever.stl` | 1 | — | PETG | 0.2 | 16 × 21 × 3.0 | both | 0 | ok | pin arm, hook on a flexible finger, spring tail; flat print |
| `wheel_C_click.stl` | 1 | — | PETG | 0.2 | 13 × 4 × 3.0 | both | 0 | ok | click: lets C turn forward, stops it turning back, sets each yearly step |
| `e6_star.stl` | 1 | — | PLA | 0.2 | 20 × 20 × 11.9 | both | 0 | ok | 12-point star with its tube; one finger turn = one point |
| `e6_pinion.stl` | 1 | — | PLA | 0.2 | 13 × 13 × 2.2 | both | 0 | ok | 12 teeth, module 0.922, meshed with the ring; pressed on the star's hex, glued |
| `e6_finger.stl` | 1 | — | PETG | 0.2 | 15 × 15 × 7.0 | both | 23 | ok | on the gearmotor's D-shaft; flange with the home magnet |
| `e6_bracket.stl` | 1 | — | PETG | 0.4 | 39 × 41 × 10.3 | both | 0 | ok | holds the gearmotor (2 x M1.6), the star's stud, the jumper, the Hall sensor; 3 x M3 to the carrier |
| `e6_jumper.stl` | 1 | — | PETG | 0.2 | 5 × 11 × 3.0 | both | 0 | ok | holds the star (so the ring) between steps; settles each step |
| `stop_lever.stl` | 1 | — | PETG | 0.2 | 19 × 7 × 8.6 | both | 2 | ok | held back by S and the sector's lug: keeps E6 running; its vane blocks the opto's beam at rest |
| `stop_bridge.stl` | 1 | — | PETG | 0.4 | 20 × 47 × 12.1 | both | 69 | ok | bridges the carrier's pointer opening; holds the lever's pin, its wire spring and the TCST1202; 2 x M3 into the carrier |
| `apollo_arrow.stl` | 1 | — | silver | 0.4 | 20 × 10 × 2.0 | both | 0 | ok | Apollo's arrow, viewer's left (figure in E-module design) |
| `dial_foot_0.stl` | 3 | dial_foot_1, dial_foot_2 | PETG | 0.4 | 7 × 7 × 8.0 | both | 0 | ok |  |
