paulforrester/horloge-astronomique/export/print/m1_time/README.md

# Print files: m1_time

Generated by `python -m cad.export_print`; do not edit by hand.

30 distinct parts, 35 prints in all. Each STL is already in its print pose, centred and standing on the bed (z = 0): drag it into Bambu Studio and it lands on the plate.

- **Down-facing** is the area (mm²) facing down more steeply than 45° and not on the bed: overhangs *and* bridges. Under about 100 mm² it is bridged holes, seats and slots that print without support; larger values are explained in the notes. Each part is posed to keep it small.
- **Fit** is checked against the H2D build volume, single nozzle (325 × 320 × 325) and dual nozzle (300 × 320 × 325).
- **Nozzle 0.2** marks parts with module 0.8 teeth or 2 mm lettering.
- **Mesh** is lib3mf's check that the part meshes closed and manifold, as Bambu Studio expects.
- **Fits not final.** The press, slide and bearing fits wait for the tolerance coupons, so print `tolerance_coupons` first and regenerate after `FITS` is updated.

**Multi-colour print `dial.3mf`**: dial_field, dial_gilt. Open it, answer *Yes* to loading it as one object with several parts, then give each part its filament.

| File | Qty | Also used as | Material | Nozzle | Size on bed (mm) | Fits | Down-facing (mm²) | Mesh | Notes |
|---|---|---|---|---|---|---|---|---|---|
| `silver_cannon_12.stl` | 1 | — | PLA | 0.4 | 15 × 15 × 3.0 | both | 0 | ok | pressed on the OD 4 tube; the clutch's front face |
| `silver_drive_45.stl` | 1 | — | PLA | 0.4 | 47 × 47 × 3.4 | both | 0 | ok | free on the OD 4 tube: M1b drives the silver hands through it |
| `gilt_cannon_12.stl` | 1 | — | PLA | 0.4 | 15 × 15 × 3.0 | both | 0 | ok | pressed on the Ø3 arbor; the clutch's front face |
| `gilt_drive_45.stl` | 1 | — | PLA | 0.4 | 47 × 47 × 3.4 | both | 0 | ok | free on the Ø3 arbor: M1 drives the gilt hands through it |
| `gilt_minute_wheel_48.stl` | 1 | — | PLA | 0.4 | 49 × 49 × 12.2 | both | 0 | ok |  |
| `gilt_minute_pinion_15.stl` | 2 | silver_minute_pinion_15 | PLA | 0.4 | 17 × 17 × 5.0 | both | 0 | ok |  |
| `gilt_hour_wheel_45.stl` | 1 | — | PLA | 0.4 | 47 × 47 × 3.9 | both | 0 | ok |  |
| `silver_minute_wheel_48.stl` | 1 | — | PLA | 0.4 | 49 × 49 × 3.0 | both | 0 | ok |  |
| `silver_hour_wheel_45.stl` | 1 | — | PLA | 0.4 | 47 × 47 × 10.2 | both | 0 | ok |  |
| `M1_drive_45.stl` | 1 | — | PLA | 0.4 | 47 × 47 × 15.9 | both | 0 | ok | slides on M1's D-shaft; held between the adapter's boss and a front-plate post; the index disc is pressed on its spigot |
| `M1_index_disc.stl` | 1 | — | PLA | 0.4 | 26 × 26 × 2.0 | both | 0 | ok | M1's hourly index: one magnet; pressed on the drive's spigot in any phase |
| `M1b_drive_45_noon_12.stl` | 1 | — | PLA | 0.4 | 47 × 47 × 25.1 | both | 39 | ok | slides on M1b's D-shaft: drive 45 and noon pinion 12; held between the adapter's boss and a front-plate post; the flag disc is pressed on its spigot |
| `M1b_flag_disc.stl` | 1 | — | PLA | 0.4 | 46 × 46 × 2.0 | both | 0 | ok | the release flags: four quarter magnets and the hour magnet (M1b's index); pressed on the drive's spigot in any phase |
| `adapter_M1.stl` | 2 | adapter_M1b | PETG | 0.4 | 42 × 66 × 5.0 | both | 361 | ok | motor adapter: screwed to the motor at the bench, it plugs into the back plate from behind (2 x M3 x 8 into heat-set inserts); its boss locates it and stops the drive part |
| `stop_post_TA.stl` | 1 | — | PETG | 0.4 | 10 × 10 × 15.6 | both | 28 | ok | the drive part's front stop; its Ø4 peg is pressed into the front plate |
| `stop_post_TB.stl` | 1 | — | PETG | 0.4 | 10 × 10 × 6.4 | both | 0 | ok | the drive part's front stop; its Ø4 peg is pressed into the front plate |
| `noon_wheel_54_12_X.stl` | 1 | — | PLA | 0.4 | 55 × 55 × 12.9 | both | 54 | ok |  |
| `noon_wheel_64_N.stl` | 1 | — | PLA | 0.4 | 65 × 65 × 7.5 | both | 0 | ok | 24 h wheel: its magnet marks the noon window; set by meshing it to its mark (±½ tooth = ±11 min) |
| `gilt_witness_disc.stl` | 1 | — | PLA | 0.4 | 22 × 22 × 2.0 | both | 0 | ok | pressed on the gilt motion-work arbor: 1 turn in 4 h |
| `pillar_0.stl` | 4 | pillar_1, pillar_2, pillar_3 | PETG | 0.4 | 8 × 8 × 26.1 | both | 0 | ok |  |
| `front_plate.stl` | 1 | — | PETG | 0.4 | 136 × 112 × 18.4 | both | 72 | ok | the four dial feet (a magnet in each top) and the two arbor bosses print upwards, without support |
| `back_plate.stl` | 1 | — | PETG | 0.4 | 164 × 112 × 11.4 | both | 975 | ok | printed rear face down: the two Ø 22 motor pilot pockets are bridged (the down-facing area) |
| `dial.3mf` | 1 | — | black | 0.2 | 104 × 104 × 2.0 | both | 0 | ok | two-colour print with dial_gilt, face down, 0.2 mm nozzle |
| `dial.3mf` | 1 | — | gold | 0.2 | 101 × 101 × 0.6 | both | 0 | ok |  |
| `bezel.stl` | 1 | — | gold | 0.4 | 120 × 120 × 4.5 | both | 628 | ok | pearled gilt bezel; the dial is glued in its seat; four magnets hold it on the dial feet, so it pulls straight off once the hands are off. Printed face up: the lip's 1.7 mm ledge over the dial seat is most of the down-facing area and prints without support |
| `hand_gilt_hour.stl` | 1 | — | gold | 0.2 | 33 × 15 × 1.0 | both | 0 | ok | gilt hour hand, flat print, pressed on its tube |
| `hand_silver_hour.stl` | 1 | — | silver | 0.2 | 28 × 20 × 1.0 | both | 0 | ok | silver hour hand, flat print, pressed on its tube |
| `hand_silver_minute.stl` | 1 | — | silver | 0.2 | 44 × 26 × 1.0 | both | 0 | ok | silver minute hand, flat print, pressed on its tube |
| `hand_gilt_minute.stl` | 1 | — | gold | 0.2 | 52 × 24 × 1.0 | both | 0 | ok | gilt minute hand, flat print, pressed on its arbor |
| `centre_cap.stl` | 1 | — | gold | 0.2 | 5 × 5 × 2.6 | both | 7 | ok |  |
