paulforrester/horloge-astronomique/export/print/m2_e6_fallback_pawl/README.md

# Print files: m2_e6_fallback_pawl

Generated by `python -m cad.export_print`; do not edit by hand.

4 distinct parts, 4 prints in all. Each STL is already in its print pose, centred and standing on the bed (z = 0): drag it into Bambu Studio and it lands on the plate.

- **Down-facing** is the area (mm²) facing down more steeply than 45° and not on the bed: overhangs *and* bridges. Under about 100 mm² it is bridged holes, seats and slots that print without support; larger values are explained in the notes. Each part is posed to keep it small.
- **Fit** is checked against the H2D build volume, single nozzle (325 × 320 × 325) and dual nozzle (300 × 320 × 325).
- **Nozzle 0.2** marks parts with module 0.8 teeth or 2 mm lettering.
- **Mesh** is lib3mf's check that the part meshes closed and manifold, as Bambu Studio expects.
- **Fits not final.** The press, slide and bearing fits wait for the tolerance coupons, so print `tolerance_coupons` first and regenerate after `FITS` is updated.

| File | Qty | Also used as | Material | Nozzle | Size on bed (mm) | Fits | Down-facing (mm²) | Mesh | Notes |
|---|---|---|---|---|---|---|---|---|---|
| `e6_crank.stl` | 1 | — | PETG | 0.2 | 13 × 13 × 8.3 | both | 34 | ok | on the D-shaft; crank pin r 2.4; flange with the home magnet |
| `e6_pawl.stl` | 1 | — | PETG | 0.2 | 19 × 6 × 2.2 | both | 0 | ok | slides over the fulcrum pin: hook down and forward, then up and back |
| `ring_jumper.stl` | 1 | — | PETG | 0.2 | 12 × 4 × 2.2 | both | 0 | ok | round nose on two tooth tips: holds the ring, settles each step |
| `e6_bracket.stl` | 1 | — | PETG | 0.4 | 70 × 21 × 14.5 | both | 2 | ok | variant pawl: gearmotor (2 x M1.6), fulcrum and jumper pins, wire post, Hall; 3 x M3 |
