paulforrester/horloge-astronomique/export/print/tolerance_coupons/README.md

# Print files: tolerance_coupons

Generated by `python -m cad.export_print`; do not edit by hand.

24 distinct parts, 24 prints in all. Each STL is already in its print pose, centred and standing on the bed (z = 0): drag it into Bambu Studio and it lands on the plate.

- **Down-facing** is the area (mm²) facing down more steeply than 45° and not on the bed: overhangs *and* bridges. Under about 100 mm² it is bridged holes, seats and slots that print without support; larger values are explained in the notes. Each part is posed to keep it small.
- **Fit** is checked against the H2D build volume, single nozzle (325 × 320 × 325) and dual nozzle (300 × 320 × 325).
- **Nozzle 0.2** marks parts with module 0.8 teeth or 2 mm lettering.
- **Mesh** is lib3mf's check that the part meshes closed and manifold, as Bambu Studio expects.
- **Fits not final.** The press, slide and bearing fits wait for the tolerance coupons, so print `tolerance_coupons` first and regenerate after `FITS` is updated.

| File | Qty | Also used as | Material | Nozzle | Size on bed (mm) | Fits | Down-facing (mm²) | Mesh | Notes |
|---|---|---|---|---|---|---|---|---|---|
| `fit_coupon.stl` | 1 | — | PLA | 0.4 | 106 × 50 × 6.0 | both | 0 | ok |  |
| `bearing_coupon.stl` | 1 | — | PLA | 0.4 | 140 × 56 × 7.0 | both | 0 | ok |  |
| `gear_board.stl` | 1 | — | PLA | 0.4 | 192 × 132 × 5.0 | both | 0 | ok |  |
| `gear_m1_b0p10_15.stl` | 1 | — | PLA | 0.4 | 17 × 17 × 4.0 | both | 0 | ok |  |
| `gear_m1_b0p10_30.stl` | 1 | — | PLA | 0.4 | 32 × 32 × 4.0 | both | 0 | ok |  |
| `gear_m1_b0p15_15.stl` | 1 | — | PLA | 0.4 | 17 × 17 × 4.0 | both | 0 | ok |  |
| `gear_m1_b0p15_30.stl` | 1 | — | PLA | 0.4 | 32 × 32 × 4.0 | both | 0 | ok |  |
| `gear_m1_b0p20_15.stl` | 1 | — | PLA | 0.4 | 17 × 17 × 4.0 | both | 0 | ok |  |
| `gear_m1_b0p20_30.stl` | 1 | — | PLA | 0.4 | 32 × 32 × 4.0 | both | 0 | ok |  |
| `gear_m0p8_b0p10_15.stl` | 1 | — | PLA | 0.4 | 14 × 14 × 4.0 | both | 0 | ok |  |
| `gear_m0p8_b0p10_30.stl` | 1 | — | PLA | 0.4 | 25 × 25 × 4.0 | both | 0 | ok |  |
| `gear_m0p8_b0p15_15.stl` | 1 | — | PLA | 0.4 | 14 × 14 × 4.0 | both | 0 | ok |  |
| `gear_m0p8_b0p15_30.stl` | 1 | — | PLA | 0.4 | 25 × 25 × 4.0 | both | 0 | ok |  |
| `gear_m0p8_b0p20_15.stl` | 1 | — | PLA | 0.4 | 14 × 14 × 4.0 | both | 0 | ok |  |
| `gear_m0p8_b0p20_30.stl` | 1 | — | PLA | 0.4 | 25 × 25 × 4.0 | both | 0 | ok |  |
| `gear_m0p6_b0p10_15.stl` | 1 | — | PLA | 0.4 | 10 × 10 × 4.0 | both | 0 | ok |  |
| `gear_m0p6_b0p10_30.stl` | 1 | — | PLA | 0.4 | 19 × 19 × 4.0 | both | 0 | ok |  |
| `gear_m0p6_b0p15_15.stl` | 1 | — | PLA | 0.4 | 10 × 10 × 4.0 | both | 0 | ok |  |
| `gear_m0p6_b0p15_30.stl` | 1 | — | PLA | 0.4 | 19 × 19 × 4.0 | both | 0 | ok |  |
| `gear_m0p6_b0p20_15.stl` | 1 | — | PLA | 0.4 | 10 × 10 × 4.0 | both | 0 | ok |  |
| `gear_m0p6_b0p20_30.stl` | 1 | — | PLA | 0.4 | 19 × 19 × 4.0 | both | 0 | ok |  |
| `worm_cradle.stl` | 1 | — | PETG | 0.4 | 48 × 35 × 18.0 | both | 32 | ok | Ø3 pin pressed in; Ø5 rod through the uprights |
| `worm_wheel_20.stl` | 1 | — | PLA | 0.4 | 19 × 19 × 6.0 | both | 0 | ok | turns on the Ø3 pin |
| `worm_test.stl` | 1 | — | PLA | 0.2 | 14 × 14 × 24.0 | both | 952 | ok | print axis vertical, 0.1 mm layers; glue or pin to the Ø5 rod |
