paulforrester/horloge-astronomique/export/print/test_rig/README.md

# Print files: test_rig

Generated by `python -m cad.export_print`; do not edit by hand.

23 distinct parts, 28 prints in all. Each STL is already in its print pose, centred and standing on the bed (z = 0): drag it into Bambu Studio and it lands on the plate.

- **Down-facing** is the area (mm²) facing down more steeply than 45° and not on the bed: overhangs *and* bridges. Under about 100 mm² it is bridged holes, seats and slots that print without support; larger values are explained in the notes. Each part is posed to keep it small.
- **Fit** is checked against the H2D build volume, single nozzle (325 × 320 × 325) and dual nozzle (300 × 320 × 325).
- **Nozzle 0.2** marks parts with module 0.8 teeth or 2 mm lettering.
- **Mesh** is lib3mf's check that the part meshes closed and manifold, as Bambu Studio expects.
- **Fits not final.** The press, slide and bearing fits wait for the tolerance coupons, so print `tolerance_coupons` first and regenerate after `FITS` is updated.

| File | Qty | Also used as | Material | Nozzle | Size on bed (mm) | Fits | Down-facing (mm²) | Mesh | Notes |
|---|---|---|---|---|---|---|---|---|---|
| `cannon_pinion_12.stl` | 1 | — | PLA | 0.4 | 15 × 15 × 3.0 | both | 0 | ok |  |
| `minute_wheel_48_15.stl` | 1 | — | PLA | 0.4 | 49 × 49 × 6.5 | both | 61 | ok |  |
| `hour_wheel_45.stl` | 1 | — | PLA | 0.4 | 47 × 47 × 3.0 | both | 0 | ok |  |
| `clutch_front_collet.stl` | 1 | — | PLA | 0.4 | 9 × 9 × 2.3 | both | 0 | ok | printed collet with an M3 grub screw in a heat-set insert; holds the stack |
| `noon_pinion_12_A.stl` | 1 | — | PLA | 0.4 | 15 × 15 × 7.0 | both | 0 | ok |  |
| `noon_wheel_54_12_X.stl` | 1 | — | PLA | 0.4 | 55 × 55 × 10.0 | both | 39 | ok |  |
| `day_wheel_64_B.stl` | 1 | — | PLA | 0.4 | 65 × 65 × 4.0 | both | 0 | ok |  |
| `sun_drive_48_B.stl` | 2 | shadow_drive_48_B | PLA | 0.4 | 50 × 50 × 6.0 | both | 0 | ok |  |
| `sun_wheel_48_C.stl` | 1 | — | PLA | 0.4 | 50 × 50 × 4.0 | both | 0 | ok |  |
| `shadow_wheel_48_C.stl` | 1 | — | PLA | 0.4 | 50 × 50 × 4.0 | both | 0 | ok |  |
| `index_flag_A.stl` | 1 | — | PLA | 0.4 | 22 × 22 × 2.5 | both | 0 | ok |  |
| `front_plate.stl` | 1 | — | PETG | 0.4 | 238 × 165 × 4.0 | both | 0 | ok |  |
| `back_plate.stl` | 1 | — | PETG | 0.4 | 238 × 165 × 4.0 | both | 0 | ok |  |
| `pillar_0.stl` | 4 | pillar_1, pillar_2, pillar_3 | PETG | 0.4 | 8 × 8 × 24.0 | both | 0 | ok |  |
| `foot_0.stl` | 2 | foot_1 | PETG | 0.4 | 14 × 6 × 90.0 | both | 0 | ok |  |
| `dial_12h.stl` | 1 | — | silver | 0.4 | 112 × 112 × 2.0 | both | 0 | ok |  |
| `dial_24h.stl` | 1 | — | dial | 0.4 | 100 × 100 × 2.0 | both | 0 | ok |  |
| `hand_hour.stl` | 1 | — | black | 0.4 | 24 × 36 × 1.5 | both | 0 | ok |  |
| `hand_minute.stl` | 1 | — | black | 0.4 | 50 × 31 × 1.5 | both | 0 | ok |  |
| `hand_sun.stl` | 1 | — | red | 0.4 | 29 × 46 × 1.5 | both | 0 | ok |  |
| `hand_middle.stl` | 1 | — | silver | 0.4 | 46 × 20 × 1.5 | both | 0 | ok |  |
| `arm_shadow.stl` | 1 | — | black | 0.4 | 28 × 46 × 1.5 | both | 0 | ok |  |
| `electronics_tray.stl` | 1 | — | PETG | 0.4 | 150 × 6 × 90.0 | both | 0 | ok | ESP32-S3 DevKitC-1, TMC2209 breakout, buck 24->5 V, terminals |
