paulforrester/horloge-astronomique/cad/modules/m1_time/dial.py

"""M1 mean-time dial: a two-colour print, gilt on black, after Paul's photographs of 30 Oct 2026.

What the original shows [S: Paul's photographs IMG_0766–0768; docs/reference-notes.md]:
- a 12-hour face: gilt Roman numerals on a black ground, four written IIII, standing on the radius
  (their tops point outwards);
- a minute track (a band of short bars between two circles) with small figures 5 … 60 outside it;
- "TEMPS MOYEN" on an arc above the centre, "HEURE PUBLIQUE" on an arc below it (reading left to
  right, tops towards the centre);
- a pearled gilt bezel.

Two bodies, printed together face down (one per filament), as the M2 dial:
- **field** (black): the disc with pockets 0.6 mm deep;
- **gilt**: the numerals, the track, the figures and the lettering, filling the pockets flush.

Sizes: the dial is Ø 104 [E: the pearled minute ring is ≈ 0.83 m on the original, scaled on the
calendar ring in Paul's photograph, ±15 %]; the bezel Ø 120 [E: ≈ 0.98 m on the original, the same way]. Numeral height ≈ 0.1 of the dial, as photographed [E].
The figures (2.2 mm) and the lettering need the 0.2 mm nozzle.
"""
from __future__ import annotations

import math

import build123d as bd

from cad.lib import lettering as T
from cad.lib import parts
from cad.modules.m2_main_dial.dial import _bar, numeral

DIAL_D = 104.0                      # [E] see above
FIELD_T, INLAY_T = 2.0, 0.6
BORE = 6.6                          # the OD 6 tube (gilt hour hand) passes with clearance
NUM_R, NUM_H, NUM_STROKE = 34.0, 10.0, 1.3
ROMAN = ["XII", "I", "II", "III", "IIII", "V", "VI", "VII", "VIII", "IX", "X", "XI"]
TRACK = (44.0, 47.0)                # the minute track's two circles (centre lines)
TRACK_LINE = 0.4
FIG_R, FIG_H, FIG_STROKE = 48.0, 2.2, 0.35
TEXT_H, TEXT_STROKE = 3.4, 0.55
TOP_TEXT, TOP_R = "TEMPS MOYEN", 18.5
BOTTOM_TEXT, BOTTOM_R = "HEURE PUBLIQUE", 21.5
BEZEL = dict(od=120.0, id_lip=101.0, id_seat=DIAL_D + 0.4, z0=-FIELD_T - 0.6, z1=1.2, pearls=72,
             pearl_r=1.0, pearl_ring=55.0)


def _ring(r, w, n=180):
    from shapely.geometry import Point
    return Point(0, 0).buffer(r + w / 2, quad_segs=n // 4).difference(Point(0, 0).buffer(r - w / 2, quad_segs=n // 4))
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
