paulforrester/horloge-astronomique/cad/modules/m1_time/hands.py

"""M1's four hands and the centre cap, after Paul's photographs of 30 Oct 2026 (IMG_0766).

- **gilt minute hand** (mean time): a slender blade with an ornate lozenge near the tip and a short
  counter-tail;
- **gilt hour hand** (mean time): an openwork fleur;
- **silver minute and hour hands** (legal time): plain spears.
A gilt cap covers the centre. Each hand is a flat print (0.2 mm nozzle), its boss pressed onto its
tube or arbor. Lengths [E]: the minute hands reach the minute track, the hour hands the numerals'
inner ends, as photographed.
"""
from __future__ import annotations

import build123d as bd

from cad.lib import parts

T = 1.0                                         # hand thickness
LEN = {"gilt_minute": 45.5, "silver_minute": 44.0, "silver_hour": 27.5, "gilt_hour": 27.0}


def _poly(points):
    from shapely.geometry import Polygon
    return Polygon(points)
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
