paulforrester/horloge-astronomique/(commit log)

2026-10-31 Phase 0: specification and decisions
    Add the Phase 0 specification set:
    - docs/mechanism-inventory.md: every indication and automaton, periods,
    original method (tagged by source), replica approach, difficulty,
    dependencies and version (v1 / v1.5 / v2)
    - docs/envelope.md: 1:8 case outline, stage order, sourced sizes, bed-fit
    checks, and a ready-to-run photo-scaling method (photo hosts were blocked)
    - docs/architecture.md: modules, stepper clockwork rates, inter-module
    links, event triggering, homing/witness sensing, setting mechanism,
    power-cut catch-up, time base, electronics I/O budget
    - docs/decisions.md: D1-D11 with options, trade-offs, recommendations,
    plus research blockers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
    [check_openscad.scad]
2026-10-31 Apply Paul's PR #1 feedback: fresh BOM, Strasbourg time, 1:8 confirmed
    - bom.md: rewritten as a fresh BOM (everything bought new, no parts from
    other projects); Batch 1 now includes the test-rig controller, drivers,
    stepper and PSU; Batch 2 quantities counted from the architecture
    - decisions.md D2: noon show kept on Strasbourg mean time (accepted);
    recommend Strasbourg sky as well, pending confirmation
    - decisions.md D3 / architecture.md: test rig uses the ESP32-S3 target
    platform instead of the Mega + RAMPS
    - decisions.md D5: question rephrased in plain terms
    - decisions.md D11: 1:8 scale accepted; width follows the source
    - decisions.md Blockers: note that only Paul can change net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
2026-10-31 Phase 0 research pass 2: Schwilgué's Description abrégée; Bordeaux sky
    Paul widened network access. Read in full the builder's son's own
    description (Ch. Schwilgué, Description abrégée, 2nd ed. 1844, public
    domain via archive.org), checking key numbers against the page images.
    Resolved from the primary source:
    - calendar ring: 25 cm wide, circumference over 9 m (so it must print in
    segments at 1:8); jumps one division at midnight; Apollo points;
    Gregorian century rule automatic
    - sunrise/sunset shown by a "mobile horizon"
    - hourglass turned hourly, alternating direction
    - weekday chariots move continuously on a circular rail
    - precession 25,804 years; sphere for Strasbourg latitud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
2026-10-31 Phase 0 research pass 3: Ungerer 1920, Lefort, CLEA; plate-scaled envelope
    Paul shared the Lefort, CLEA and ELS PDFs privately via Google Drive
    (copyrighted, so not committed). ELS turns out to be Alfred Ungerer's
    1920 lecture (L'Astronomie 1921). Ungerer was Schwilgué's successor and
    his lecture is full of measured dimensions and mechanism detail.
    Resolved:
    - case width 7.70 m (18 m high, crown included) is the current stone
    case, so the replica is 962.5 x 2250 mm, as CLAUDE.md assumed
    - main dial 2.30 m, Sun hand 1 m, planetary circle 2.20 m, Moon globe
    0.40 m, celestial sphere 0.84 m, calendar ring 2.73 m x 21 cm
    - year formula: the planetarium input turns once per hour (Lefort's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
2026-10-31 D5 accepted: steady speeds first, with a binding upgrade path
    Paul chose option (b) on condition that the design can be adapted later
    without scrapping. Adds principle P6 (upgrade-ready modules) and
    architecture section 13: differentials in place from day one with a
    removable locking key; a fixed M2/M3 correction-input interface with
    gain of at least 1 turn per degree; a reserved equations bay, harness
    and driver channel; cam stacks with spare positions; swappable gear-train
    cassettes; reserved main-dial positions for v1.5/v2 parts.
    Claude-Session: https://claude.ai/code/session_01Tndyw9tksT61hV2osW21zT
2026-11-01 Add README; propose a wooden case and frame (D12)
    - README.md: project overview, how the replica works, status by phase,
    document map, tools, repository layout, main sources, working method
    - decisions.md D12 (Proposed): Paul wants the frame in wood (sheet goods
    and hardwood). Recommends a birch-plywood carcass as the structure,
    hardwood framing, mouldings and doors, three-point adjustable module
    mounts, misalignment-tolerant couplings between modules, and ornament
    printed or carved. Four questions for Paul (tools, finish, species,
    hidden metal sub-frame). D6's structure part is marked as reopened.
    - CLAUDE.md: wood added as an accepted material; parametric case design
    is cloud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
2026-11-01 D12 accepted: wooden case (option B) with Paul's workshop, finish, species and metal answers
    - decisions.md D12: accepted. Records Paul's answers and adds revised rules:
    R1 joinery and mouldings for the actual tools (table saw, track saw,
    drill press, planer, drum sander, mitre saw, chisels; no router,
    jointer, bandsaw, CNC or lathe), with printed drilling templates for
    the module mounts; R2 painted finish (MDF for flat painted surfaces,
    priming rules); R3 species movement classes from sourced shrinkage
    data (Wood Database) with a one-species rule, tulipier, sapelli or sipo
    preferred, and beech, hornbeam, ash and black poplar avoided; R4 metal
    hidden except the computus's vis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
2026-11-01 Phase 1: ratio engineering (tools/ratios, spec/clock.yaml, docs/gear-trains.md)
    - tools/ratios: gear-ratio search and checking tool
    - exhaustive 1-3 stage compound search (numpy), exact Fraction ratios
    - 2-stage reverted (coaxial) search with optional fixed tooth sum
    - differential / epicyclic search (base + coef * X)
    - chooser: fewest stages, then smallest wheels, meeting an accuracy target
    - metrics: ratio, relative error, period error, drift per year/century,
    tip diameters, centre distances, bed fit
    - CLI: search / check / report (python -m tools.ratios)
    - tests (39, all passing): reproduce Schwilgué's published ratios exactly
    (year train = the year in hours, five plane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
    [clock.yaml]
2026-11-01 Phase 1 review: JPL planet targets, tooth strength and motor torque, M3 cam options
    Answers Paul's PR #3 review.
    - Planets: targets now come from NASA/JPL mean-longitude rates (Standish Table 2a) plus IAU 2006
    precession. Mercury -0.096 deg/century. Corrects the draft's claim that Schwilgue's Mars was off:
    the NASA fact-sheet tropical Mars value is not a mean period.
    - Strength: new tools/ratios/strength.py (Lewis, Shigley Y table). Every train is checked for a
    running safety factor and a slip-clutch window, with loads reflected through shared and
    epicyclic trains. Adds a motor torque budget per module. `check` now enforces strength.
    - M5.earth and M5.moon_arm get 8 mm faces; the Mo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
    [clock.yaml]
2026-11-01 Record Phase 1 decisions; re-run M3 for convention B with Schwilgué's half-turn rule
    Paul's second PR #3 comment: M5 at 1 rev/day accepted; M3 convention B planned; strength rules
    accepted; NASA/JPL targets for all five planets.
    - JPL targets change no tooth counts: the chooser returns the same five planet pairs; drift
    before/after table in gear-trains.md section 4F.
    - M3 for convention B: Ungerer 1921 (ELS) gives every equation arbor as a half turn per period.
    All six cams now turn once per two periods, held to 1 deg/century of cam angle. New train
    M3.solar_reduction (year train x 20/40); anomalistic year, lunar anomaly, evection, variation
    and node trains re-chosen. Cam sizing no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
    [clock.yaml]
2026-11-01 Phase 2a: CAD library (gears, parts, checks) and M2 main-dial feasibility study
    - cad/lib: involute gears with backlash, profile shift, internal gears and racks, validated against
    BOSL2; D4 hardware catalogue; shared parts; assemblies with interference, bed-fit, STL/3MF/STEP/DAE
    export and PNG renders.
    - cad/modules/m2_main_dial/feasibility.py: layout of everything on and behind the 287.5 mm dial,
    including the v1.5/v2 provisions. 0 interferences, 0 hand-sweep conflicts, only the calendar ring
    exceeds the bed (segments, as planned), 169 mm deep.
    - docs/main-dial-feasibility.md: the answer, the layout, the eclipse-display options (the latitude
    cam method reproduces Schwilgué's 37.5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
    [feasibility.py, test_gears.py, test_gears_bosl2.py, test_m2_feasibility.py, test_parts_assembly.py]
2026-11-01 PR #4 review: record decisions (k = 4, layout, shallow dome, test rig); SketchUp files for all CAD
    - docs/main-dial-feasibility.md: decisions accepted; the hemisphere is now a 5 mm shallow dome
    (painted disc as fallback), so the front of the dial is 23.8 mm deep and the total 171 mm.
    - cad/export_sketchup.py writes a COLLADA .dae (named nodes, mm, Z up) for every CAD model;
    cad/lib/samples.py is a showcase with real tooth geometry. Both .dae files are committed in
    export/sketchup/ at Paul's request; CLAUDE.md records the rule.
    - Tests: the samples mesh without interference; every model writes a DAE with named nodes.
    Claude-Sessio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
    [feasibility.py, test_sketchup_export.py]
2026-11-01 Phase 2 step 3: test rig and tolerance coupons
    - cad/modules/test_rig/rig.py: one NEMA 17 turning the minute arbor at 1 rev/h; the real M1 trains
    (motion work 12/48 x 15/45 under a 12 h dial, noon train 12/54 x 12/64 to a 24 h arbor); an
    adjustable friction-clutched cannon pinion; the main dial's two-tube Sun/shadow drive through
    equal 48/48 pairs; Hall index and witness sensing; MR85ZZ pockets with shoulders. 59 parts, no
    interference, every mesh engaged, all printed parts fit the bed.
    - cad/modules/test_rig/coupons.py: rod-fit, bearing-seat and gear-board coupons (module 1.0 / 0.8
    / 0.6 x backlash 0.10 / 0.15 / 0.20) to replace the FITS estimates and set the minimum module.
    - cad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
    [test_rig.3mf, tolerance_coupons.3mf]
2026-11-03 M2 main dial detailed design: trains, worm-input differentials, calendar ring, two-colour dial
    - cad/lib: self-locking worm and throated helical worm wheel; spur planet-pair differential.
    - cad/modules/m2_main_dial: mechanism (24:1 reduction, 84/84, 154/169, 88/83, 48/48 pairs, Sun
    and Moon differentials with 60:1 worm carriers, centre stack, plates, sensors), calendar ring
    and New Year station (368-tooth ratchet, E6 pawl, stop lever, sector lug, year counter wheel C
    and 400-year satellite, setter), calendar_logic (day-by-day check, 2026-2426: no wrong day),
    two-colour dial, full-module checks: 0 interference among 141 parts, ring sweep clear, all parts
    fit the bed.
    - spec: M2.node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
    [calendar.py, calendar_logic.py, clock.yaml, dial.py, mechanism.py, test_calendar_logic.py]
2026-11-03 Lighter SketchUp meshes: 9-point gear flanks, coarser worm sections, per-model DAE tolerance
    Gear flanks through 9 points (was 21) stay within 2 µm of BOSL2's outline and halve the triangle
    count of exported models; worm sections sample 96 points. write_dae takes a tessellation tolerance
    (0.3 mm for the whole M2 module) and rounds vertices to 1 µm.
    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
2026-11-03 M2 review round: pointer on the viewer's left, printed carrier frame, print files, exploded views
    Paul's PR #5 review (3 Nov 2026):
    - Calendar pointer moved to 9 o'clock. DA has "à la droite du calendrier" (the calendar's
    own right) and ELS i4 has "sur la gauche de l'anneau". The ring is mirrored and turns
    counter-clockwise. The readers pass through a window in the front plate.
    reference-notes and inventory I8 are corrected.
    - Noon at the top is now sourced (ELS i1), with "disque légèrement bombé".
    - The carrier is a printed PETG frame, independent of the case: 4 segments with an
    L-section rim, bolted to the front plate, 3 splice plates and 3 gusseted M5 tabs.
    The lower-right s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
    [E6_crank.stl, E6_pawl.stl, I_154.stl, I_72.stl, I_84.stl, J_169.stl, J_sleeve_88.stl, R1_12.stl]
2026-11-03 WIP: calendar dates (approved sizes) and sector lug/tab fix, follow-up to PR #5
    Work in progress after PR #5 merged; checks and exports still running.
    - Dates: 2.2 mm dominical letters and day numbers, 4 mm month names,
    "COMMENCEMENT / DE L'ANNÉE / COMMUNE", "29" on the recess floor. Flush
    two-colour inlays built in 2D (cad/lib/lettering.py, Shapely) and glued
    back onto the part.
    - Fix: the sector's lug now hangs on a foot and arm (outer half of the
    stop-lever track); the tab slot matches the tab's travel; the blanket
    ring-sector contact allowance is removed.
    - Item.inside: inlay bodies skip pairwise interference; their own test
    checks that they stay inside their part.
    Co-Autho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
    [calendar.py, test_calendar_ring.py]
2026-11-03 Calendar dates: merge every top face before the 2D rebuild (the ring's seam split one), and check two-colour prints on the filled part
    - with_inlay: segment 3 holds the ring's seam at the pointer and has two top faces; using only the
    largest lost 2342 mm² of its top layer. All top faces are now merged.
    - Item.filled: a part with inlays also keeps its pre-inlay shape; print checks and the print
    export use it for the overhang of the whole two-colour print instead of fusing thousands of glyphs.
    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
2026-11-03 Calendar: manifold meshes for every printed part (3MF check), cleaner lettering outlines
    - _wedge: a full turn is now a true annulus. The out-and-back polygon left a zero-width slit
    at the pointer: two coincident faces, a non-manifold seam in ring segment 3 and carrier
    segment 1 (already the case in the PR #5 files; STL export never checks).
    - Lettering outlines are simplified to 3 µm and snapped to a 1 µm grid. The buffered arcs
    left 224 sub-micron edges that meshed into non-manifold fans.
    - export_print records lib3mf's manifold check per part (manifest "Mesh" column). The
    calendar test requires every printed part to pass it.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
    [calendar.py, test_calendar_ring.py, test_export_print.py]
2026-11-03 m2-design: print manifest now records the manifold mesh check
    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
2026-11-03 Calendar dates follow-up: regenerated print and SketchUp files; multi-colour sets ship as 3MF only
    - export_print: a multi-colour body is written only inside its set's 3MF (dial, ring_0..3,
    sector); separate STLs would duplicate it. M2 print folder 13.4 MB (32.7 with duplicates).
    - export_sketchup: inlaid parts are shown filled and the inlay bodies left out (viewing only;
    thousands of glyphs tripled the DAE). The dates are in the print files and in
    docs/img/m2/calendar_dates.png.
    - Every printed part passes the manifold mesh check (manifest "Mesh" column).
    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
    [S_bump_0.stl, carrier_segment_0.stl, carrier_segment_1.stl, carrier_segment_2.stl, carrier_segment_3.stl, dial.3mf, dial_field.stl, dial_hour_ring.stl]
2026-11-03 Calendar: 29 February carries F, as on the original (Paul, PR #6)
    - The recess floor at d = 61 reads "F 29", letter then number like every other day.
    F is the Roman bissextile day's letter (doubled 24 Feb), so 1 March on is unchanged.
    - reference-notes records it, with the ELS quotation on the letter sequence.
    - m2-design §6: the ring-direction note now says what a reversal would really involve:
    mirror the ring, and move the New Year station or re-verify its offset.
    - ring_0.3mf regenerated; a test checks the letter.
    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
    [dial.3mf, ring_0.3mf, ring_1.3mf, ring_2.3mf, ring_3.3mf, sector.3mf]
2026-11-03 Print and SketchUp files for the clockwise ring (pattern B) and the original's layout
    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
    [S_bump_0.stl, apollo_arrow.stl, carrier_segment_0.stl, carrier_segment_1.stl, carrier_segment_2.stl, carrier_segment_3.stl, dial.3mf, ring_0.3mf]
2026-11-03 Calendar: dominical letters gold in a black column, as on the original (Paul, PR #6)
    The letter column is now a black stripe (r 155.9-158.4, 0.4 mm wider than the letters,
    0.5 mm clear of the day numbers) with the letters cut out of it, so they show the gold
    base: light letters on a dark column, as in Paul's photograph of the original. It runs
    over 1 Mar-31 Dec on the ring, 1 Jan-28 Feb on the sector and 29 Feb on the recess floor.
    It is part of the same black inlay, so there are no extra parts. Ring and sector 3MFs
    regenerated; a test checks for black beside each letter, with the letters as holes.
    Claude-Session: https://claude.ai/cod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
    [dial.3mf, ring_0.3mf, ring_1.3mf, ring_2.3mf, ring_3.3mf, sector.3mf]
2026-11-03 M2 setter and follower: concept approved by Paul (flip-flop rocker, reset and set ramps, follower on wheel C)
    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
2026-11-03 M2 setter and year counter: flip-flop rocker, reset and set ramps, counting lever, wheel C with Ungerer's satellite
    Detail design of the concept Paul approved (3 Nov 2026), in cad/modules/m2_main_dial/setter.py:
    - On the ring: a rocker beside the sector holds the sector's tab (now a Ø2.2 pin) in its fork.
    Its two positions are the sector's two, one division apart (checked: 2.740 mm). Two tip
    pins hang into the bottom layer behind the ring; a printed leaf detent holds either state.
    - At the station: a fixed reset ramp (inner lane) puts the sector in common, about 14 Oct.
    The set ramp rides on a spring plunger following wheel C's bumps; only for a leap year
    does it stand in the outer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
    [calendar.py, calendar_logic.py, setter.py, test_calendar_logic.py, test_setter.py]
2026-11-03 M2 year counter: fix the counting lever (ratchet direction, 1.5-pitch stroke, flexible hook, return spring and stop); setter detail design in docs
    - wheel C: radial, slightly undercut drive faces facing the hook; 1.0 mm teeth
    - counting lever in C's layer (one flat print): steel pin at r 156.55, hook on a
    pulled flexible finger, extension-spring return onto a stop pin
    - C's jumper: longer leaf, nose seated in the gap
    - rocker: open fork, so it stays outside r 158.8, clear of the lever pin
    - tests: direction chain, stroke window, hook path, return torque
    - docs/m2-design.md section 6: detail tables, loads [E], tracks table, the change from
    the approved sketch; BOM rows for the Ø1.5 rod,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
    [calendar.py, setter.py, test_setter.py]
2026-11-03 M2 exports: print files and SketchUp DAEs with the setter and year counter
    - new prints: setter rocker, detent spring, reset and set ramps, station bracket, counting
    lever, wheel C jumper; all mesh closed and manifold (lib3mf)
    - removed: the 10-point counter star, its pinion, the leap follower and setter-switch blocks
    - m2-design section 8: 54 STLs and 6 two-colour 3MFs for 98 prints
    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
    [carrier_segment_2.stl, counter_star_10.stl, counting_lever.stl, dial.3mf, leap_follower.stl, pinion_10.stl, ring_0.3mf, ring_1.3mf]
2026-11-03 WIP M2 setter: steel springs (Paul, PR #8) and a working follower
    - rocker detent: Ø0.4 steel wire in two hub notches (replaces the printed leaf)
    - wheel C: pivoted printed click with a Ø0.5 steel wire spring (replaces the printed jumper)
    - satellite: square hub held by a Ø0.4 steel wire on C (it had no detent)
    - follower: separate plunger with a ball tip; its spring now sits between the pocket's
    ceiling and a collar, so it presses the plunger onto C (the first spring could not)
    - leap bumps: ramp on the arriving side and a sheer drop (the first ones were sheer
    cylinders the plunger could not climb); stroke 1.4
    - tests for all of the above; the wire-strength check waits on the sourced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
    [calendar.py, setter.py, test_setter.py]
2026-11-03 M2 setter: sourced steel springs and the spring schedule (Paul, PR #8)
    - plunger: Sodemann C01800120500S (stainless, d 0.30 x De 4.57, L0 12.70, R 0.25), installed
    12.2 mm: 0.13 N at rest, 0.48 N lifted
    - lever return: Sodemann E00940110500S (stainless, d 0.28 x De 2.39, L0 12.70, F0 0.22,
    R 0.17), stretched 3.0 mm: 5.1 N.mm at rest; anchor pin moved to suit
    - wire springs (EN 10270-1 DH, Ø0.4 and Ø0.5): stresses checked against 0.7 Rm, Rm from EN
    10270-1 Table 3 less 10 % for straightened rods
    - docs/m2-design.md section 6: steel spring schedule, sources, wire mounting, loads (counter
    pin about 1.9 N in leap steps), Paul's approval of the lever; BOM rows with exact parts
    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
2026-11-03 M2 exports and drawing: steel springs, new plunger, click and detent block
    - new prints: setter_plunger, wheel_C_click, setter_detent_anchor (all mesh closed and manifold)
    - removed: the printed detent leaf and wheel C's printed jumper
    - docs/img/m2/setter_station.png redrawn from the model (bracket see-through)
    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
    [dial.3mf, ring_0.3mf, ring_1.3mf, ring_2.3mf, ring_3.3mf, satellite_4.stl, sector.3mf, setter_detent_anchor.stl]
2026-11-03 M2 docs: part and print counts (165 parts, 99 prints) and renders after the steel springs
    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
2026-11-03 Decisions D13: steel springs, and the Sodemann inch-based springs accepted (Paul, PR #8)
    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
2026-11-04 M2 E6, the ring's nightly drive: finger and star (built) and crank and pawl (fallback)
    Paul, 4 Nov 2026: D (finger, 12-point star, jumper, 12-tooth pinion meshed with gear teeth on the
    ring; 298:1 gearmotor), with A (crank and pawl on the same ring) kept as a designed fallback.
    - ring: 368 involute teeth on the lip (module 0.9216, tips r 170.5), one per division
    - D: finger (one point per turn, simulated 1.08-1.39 over tolerances), star and pinion on a Ø3
    stud, star jumper with a Ø0.5 wire, Hall home, bracket on the gearbox face
    - A: crank, slotted pawl over a fixed fulcrum (no pawl spring; 1.22 teeth per turn), ring jumper
    with a Ø0.5 wire; selected with e6.E6_DRIVE = "pawl"
    - stop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
    [calendar.py, e6.py, setter.py, test_e6.py, test_m2_design.py]
2026-11-04 M2 E6: print and SketchUp exports, the E6 drawing, and the print counts (102 prints)
    - export/print/m2_main_dial: regenerated (59 STLs and 6 two-colour 3MFs, 102 prints;
    every part meshes closed and manifold). New: e6_star, e6_pinion, e6_finger, e6_jumper,
    e6_bracket, stop_bridge. Removed: the placeholder E6_crank and E6_pawl.
    - export/print/m2_e6_fallback_pawl (new): the fallback's 4 printed parts.
    - export/sketchup: regenerated, with m2_e6_fallback_pawl.dae and its exploded view.
    - docs/img/m2/e6_drive.png: the drive, the stop lever and the fallback, from the model.
    - docs/m2-design.md §8: the print counts.
    Claude-Session: https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
    [E6_crank.stl, E6_pawl.stl, carrier_segment_2.stl, dial.3mf, e6_bracket.stl, e6_crank.stl, e6_finger.stl, e6_jumper.stl]
2026-11-04 M2 E6: the pinion's leap-year safety factor of 2.65 accepted (Paul, PR #9)
    Recorded in m2-design §6 (E6 loads) and §11, as an exception to the running minimum of 4 in
    gear-trains decision 5, and in the pinion strength test. The pinion stays PLA.
    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
2026-11-04 M2 E6: TCST1202 at the stop lever, E6 loads with friction and a bench check, wire holders fixed
    - Stop lever: a Vishay TCST1202 (3.1 mm gap, 0.5 mm slit; Vishay doc. 83764) beside the tail,
    its beam radial; a vane on the tail blocks it at rest and clears it with the lever back
    (0.42 / 0.41 mm margins), so a sensor fault stops E6. The bridge is redesigned to hold it.
    Fixed: the lever slot ran the bridge's full height (the wire's glued end was in a void) and
    the pin's hole was blind at both ends.
    - E6 loads: every friction-dependent term is re-evaluated with mu (mesh_loads(mu)); the
    leap-year factor is 2.65 at mu 0.3, 2.24 at 0.4, 1.85 at 0.5. A bench check with pass limits
    (bench_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
    [calendar.py, e6.py, mechanism.py, setter.py, test_e6.py]
2026-11-04 M2: notch the front plate for E6's star-jumper wire holder; test both variants against the plate
    The holder now sits behind its anchor (previous commit) and its glued length runs back across
    the M2 front plate's lower edge: the full model found 13.4 mm³ of overlap with the bracket and
    0.18 mm³ with the wire. The plate gets a 6 x 2.7 mm notch from the holder's outline. A new test
    checks both E6 variants' station and pointer parts against the plate (the full model only
    carries the built variant).
    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
2026-11-04 M2: print and SketchUp exports and renders after the TCST1202, the wire holders and the plate notch
    - export/print/m2_main_dial: regenerated parts that changed: stop_lever (vane), stop_bridge
    (opto pocket, wire hole and channel, through pin holes), front_plate (notch), e6_bracket,
    station_bracket, setter_detent_anchor, wheel_C_100 (wire holders behind their anchors).
    Every part meshes closed and manifold; the two-colour 3MFs are unchanged in geometry and
    kept as they were.
    - export/print/m2_e6_fallback_pawl: e6_bracket (ring jumper's holder).
    - export/sketchup: m2_main_dial and m2_e6_fallback_pawl, with their exploded views.
    - docs/img/m2: the M2 renders.
    Checks on this code: full M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
    [e6_bracket.stl, front_plate.stl, setter_detent_anchor.stl, station_bracket.stl, stop_bridge.stl, stop_lever.stl, wheel_C_100.stl]
2026-11-04 M1 time and release: concept gate
    docs/m1-design.md (Proposed): what M1 does (sourced), what is known and what is not (12 h or
    24 h face, hand order: from a photo), its boundary, the proposed concept (one gallery cassette
    with M1b; four hands on a Ø3 arbor and OD 4/5/6 tubes; two test-rig motion works; Hall release
    flags ahead of the hands' clutch; 24 h noon wheel), and decision 1: how E2 gets its state
    (A: a position shaft, B: E2's own 1 rev/h stepper (recommended), C: state in the event train).
    Schematic in docs/img/m1/m1_concept.png. README status.
    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
2026-11-04 M1 gate: the mean-time dial is 12 h with four hands (Paul's photographs of 30 Oct 2026)
    From IMG_0767/0768 (10:10 CET): a 12-hour face, Roman I-XII gilt on dark, pearled rings; minute
    hands at :10 (legal) and :41 (mean), as mean time = CET - 29 min; size about 0.83 m (98-104 mm at
    1:8) [E, scaled on the calendar ring]. The hands' order and colours still need a close-up.
    reference-notes: the photographs, including Death's two bells and Christ's banner.
    Crop: docs/img/m1/original_mean_time_dial.jpg.
    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
2026-11-04 M1 gate: the gallery from Paul's second set of photographs (hand colours, order, genies)
    IMG_0766: silver hands show legal time (10:10), gilt hands mean time (9:41); the silver hour
    hand lies over the gilt one; "TEMPS MOYEN" / "HEURE PUBLIQUE", IIII, a minute track 5-60;
    the genies (bell left, hourglass right) about 78 mm at 1:8 [E]. The proposed stack puts the
    silver hands in front (M1b direct on the Ø3 arbor, M1 through a 1:1 pair to the OD 4 tube).
    reference-notes: the second set, including the main dial's hemisphere (about 0.75 m, on its
    own stand: a follow-up for M2), the globe, the equations vitrine and the computus (2026).
    The gallery crop replaces the earlier dial crop.
    Co-Authored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
2026-11-04 Automata behaviour from Paul's observation of the shows (30 Oct 2026); M1 gate refined
    - mechanism-inventory A1-A6: n pairs at the n-th quarter (genie, age, ...); the ages strike
    the bell at the viewer's right of Death and walk on; Death strikes the bell at the viewer's
    left (its own right, as DA says); the hourglass after the fourth quarter (DA: hourly);
    each Apostle turns to Christ, who lowers his arm slightly in blessing as each passes (DA's
    final cross blessing not observed [?]); the rooster after the 4th, 8th and 12th Apostle.
    - m1-design: the release sequence; decision 1 restated as where the quarter snail (which age,
    how many pairs) and the hour snail (Death's count) live; E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
2026-11-04 D14: the shows run on legal time (noon at 12:00); D15: a personal procession (Paul)
    - decisions: D14 accepted (Paul, PR #11): quarters at :15/:30/:45/:00 and the noon show at
    12:00 CET/CEST; it revises D2 item 2; consequences: the releases sit on M1b, E2's state
    follows legal time, the autumn change runs +23 h so the 24 h noon wheel stays right.
    D15 accepted in principle: twelve figures of Paul's choosing replace the Apostles and
    Christ on the same mechanism; options with a recommendation (astronomy and time, with
    Urania as the central figure) for Paul to choose.
    - architecture §4-§6, mechanism-inventory A5, m1-design: releases on the legal-time train.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
2026-11-04 M1 concept accepted: E2's own state stepper (B), cassettes, hand order; D15 astronomy and time
    Paul's answers on PR #11 (4 Nov 2026):
    - decision 1: B, E2 gets its own 1 rev/h state stepper on legal time with the quarter and
    hour snails (architecture §2-§5; BOM 6 steppers + 1 spare);
    - M1 and M1b in one cassette, the genies separate;
    - hand order as makes sense: gilt minute in front (the gilt centre cap), then silver minute,
    silver hour (over the gilt one, as photographed), gilt hour; so M1 drives the Ø3 arbor and
    M1b the OD 4 tube, with the release flags on M1b's driving shaft;
    - D15 accepted: astronomy and time, twelve figures passing Urania; Death, the ages and the
    genies stay.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
2026-11-04 M1 concept schematic: the hand order and drives as decided; option B chosen
    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
2026-11-04 M1 concept schematic: the procession (D15) and the genies' size
    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
2026-11-04 M2: the Earth hemisphere at the original's size, Ø 94 mm (Paul, option B); 1844 colours kept
    From Paul's photographs of 30 Oct 2026 the original disc is about 0.75 m (±20 %), so 94 mm at
    1:8 [E]. It replaces the feasibility study's Ø 46.5 (sized only to cover the latitude cam),
    stays on the fixed arbor in front of every hand, and still covers the cam (asserted). The map
    finish is TBD. The dial keeps Schwilgué's 1844 colours (Paul, 4 Nov 2026).
    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
    [mechanism.py]
2026-11-04 M2: hemisphere_dome print and SketchUp files, and renders, at Ø 94
    Checks: full M2 174 parts, 0 interference, 0 ring-sweep conflicts, bed fit OK;
    test_m2_design and test_export_print 12 passed. Untouched exports (timestamp-only DAEs,
    reordered 3MFs) left as they were.
    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
    [hemisphere_dome.stl]
2026-11-04 M1 detail design: mean-time dial, legal-time hands, releases, dial and hands
    - cad/modules/m1_time: one cassette with two NEMA 17s at 1:1 (45/45), four
    hands on one centre (gilt minute Ø3, silver minute OD4, silver hour OD5,
    gilt hour OD6), two motion works 12/48 x 15/45 on arbors through the front
    plate, both clutches between the plates, a 24 h noon wheel 12/54 x 12/64,
    six Hall sensors with the releases on M1b (legal time, D14).
    - Endshake: every moving part runs against designed stops with 0.3 mm play;
    the drive gears sit 0.4 mm behind their cannons with a raised friction face;
    MR63ZZ in a back-plate boss; Starlocks on the noon studs.
    - Dial: two-colour print (IIII, minute fi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
2026-11-04 M1: print files, SketchUp files (with exploded view) and renders
    - export/print/m1_time: 27 STL/3MF files for 31 prints, all manifold; the dial
    is a two-colour 3MF (field + gilt inlay).
    - export/sketchup/m1_time.dae and m1_time_exploded.dae.
    - docs/img/m1: front, three-quarter and rear renders.
    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
    [M1_drive_45.stl, M1_index_disc.stl, M1b_drive_45_noon_12.stl, M1b_flag_disc.stl, back_plate.stl, bezel.stl, centre_cap.stl, dial.3mf]
2026-11-05 M1: motors plug in from behind (option A, Paul, PR #13; D16)
    - Each NEMA 17 on a printed adapter plate (motor screwed on at the bench,
    heads in counterbores); a Ø26 boss locates it in a back-plate pocket; 2 x M3
    from behind into heat-set inserts.
    - Drive parts slide on the D-shaft; their Ø8 spigots pass through the back
    plate and stop on the adapter's boss; front-plate posts stop them in front
    (0.3 mm endshake).
    - Hour magnet moved to r 19 (its Hall pocket clears the spigot hole); the hour
    window is now ±2.0 min.
    - Tests: each motor withdraws backwards touching nothing; endshake for both
    drive parts; pillar nuts clear the adapters (21 tests).
    - D16 recorded; architecture §11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
2026-11-05 M1: print files, SketchUp files and renders with the plug-in motors (D16)
    - export/print/m1_time: 30 files for 35 prints, all manifold (adds the two
    motor adapters and the two stop posts).
    - export/sketchup/m1_time.dae and m1_time_exploded.dae; renders.
    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
    [M1_drive_45.stl, M1b_drive_45_noon_12.stl, M1b_flag_disc.stl, adapter_M1.stl, back_plate.stl, dial.3mf, front_plate.stl, stop_post_TA.stl]
2026-11-05 M2: the motor plugs in from behind (D16)
    - cad/lib/motor_mount.py: the D16 adapter plate, NEMA 17 body, D-shaft, D-key
    and insert holes, shared by the stepper modules still to come.
    - M2's NEMA 17 on an adapter: its Ø22.2 boss locates in the back plate's Ø22.5
    hole; 2 x M3 x 8 from behind into heat-set inserts. The 12-tooth pinion
    (Ø18.2) is pressed on the D-shaft and comes back through the hole with the
    motor, so nothing in the module moves.
    - Test: motor, shaft, adapter and pinion withdraw backwards touching nothing.
    - m2-design §2 levels and note (depth 189 mm), D16 status, BOM row.
    Claude-Session: https://claude.ai/code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
2026-11-05 M2: print files, SketchUp files and renders with the plug-in motor (D16)
    - export/print/m2_main_dial: motor_adapter.stl and motor_pinion_12.stl (its own
    print now: a hub and a D-key), back_plate.stl (insert holes), manifest and
    README. 73 files for 103 prints. Unchanged 3MFs kept as they were.
    - export/sketchup/m2_main_dial.dae and m2_main_dial_exploded.dae.
    - docs/img/m2: rear, three-quarter and exploded renders.
    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
    [back_plate.stl, motor_adapter.stl, motor_pinion_12.stl]
2026-11-05 E2 concept gate: the four ages and Death
    - docs/e2-design.md: what E2 does (DA p. 56-58, 64-66; Paul's observations
    and photographs), what is known and not, interfaces, the proposed concept
    (state stepper with the quarter and hour snails; the quarter rack's fall
    counts the pairs and picks the age; a turntable that corrects itself after
    skipped shows; rack-and-snail hours for Death), two decisions (how the ages
    move; how many event motors) and three smaller questions.
    - docs/img/e2/e2_concept.png: schematic of the hall, the trains, one show.
    - README index and status; reference-notes: no age in view between quarters,
    the bells' size estimate.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
2026-11-06 E2 concept: what the 2011 photograph of the lower hall shows
    Paul found a public-domain photograph (Tangopaso, Wikimedia Commons, 7 Dec
    2011, 12:24 CET = 11:55 mean time) of the hall at rest.
    - Two ages are in view between shows: the last at the left doorway, the next
    waiting at the right. They walk right to left: in from the right doorway,
    strike the right-hand bell, on past Death, out by the left doorway.
    - So the waiting age must be right between shows: the turntable's stop is now
    set by an age cam on the state arbor (the due age waits at the right), and
    the controller runs the walk train alone after quiet hours or a power cut.
    - Death ≈ 0.62 m (0.52-0.74), so ≈ 78 mm at 1:8;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
2026-11-06 E2 concept accepted: turntable (A), three event motors, 78 mm figures
    Paul, PR #15, 6 Nov 2026: "For the rest, go with A and three motors; 78mm is
    fine", and the cadence from his video: the genie strikes, the age 1 s later,
    then a 2 s pause, repeated n times (four for the old man).
    - e2-design: status accepted; §5 and §6 decided; §7 answered (cadence, depth
    carried into the detail design, the attribute strikes); §9 decisions.
    - architecture: E2 row (three event motors, age cam), the A3/A4 event rows,
    event motors 8-9 and 9 PWM channels.
    - BOM: DC gearmotors 8 + 1, H-bridges 4.
    - mechanism-inventory A3/A4: the turntable, the age cam, the cadence.
    - reference-notes: Paul's cadence obs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
2026-11-06 E2: the walk takes about 10 s, and Death starts as soon as it ends
    Paul, from his video (PR #15, 6 Nov 2026): after the old man's fourth stroke he
    walks on past Death in about 10 s, while the next age comes into view (the
    child, confirmed); Death starts tolling the hour immediately.
    - e2-design §2, §4.3, §7.2, §9: walk on ≈ 10 s (≈ 12 mm/s at 1:8 [D]); the
    walk out untimed, ≈ 6 s at the same speed [E]; the walk's lock starts the
    hour train; the hourglass runs during the walk (DA p. 51).
    - architecture §5: the order on the hour.
    - reference-notes: the walk and the hand-off to Death; the child is next.
    - schematic: the show's steps and timings; "decided: three event motors".
    C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
2026-11-06 E2: the child is about 3/4 of the old man's height (Paul's estimate)
    Paul, from his video (PR #15, 6 Nov 2026): the child is about 3/4 the height
    of the old man; otherwise the figures are not very different in size and are
    told apart by their appearance. So the child is ≈ 58 mm at 1:8, and the youth,
    the man and the old man ≈ 78 mm, all parametric.
    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
2026-11-06 E2 detail design, part 1: the layout, the ring and the selection
    - cad/modules/e2_ages/layout.py: the hall, the ring and the stations from the
    2011 photograph; the walk program's selection, simulated over every pair of
    waiting age and due age; the walk's timing from Paul's 10 s.
    - cad/modules/e2_ages/mechanism.py: floors, back wall, piers, pedestal, bells
    and brackets; the ring (Ø268, 264 teeth, four pegs at their own heights) on
    4 support and 3 guide 688ZZ rollers; the walk pinion; the bell finger (its
    height set by the age cam) and the waiting finger; placeholders for the
    walk drive, the state module and the figures (parts 2 and 3).
    - cad/tests/test_e2.py: 26 tests (the walk o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
2026-11-06 E2 part 1: print and SketchUp files; the ring's inner skirt reaches the surface
    - export/print/e2_ages: 15 files for 25 prints, all manifold. The ring prints
    face down in one piece (Ø268); its only down-facing area is now the four
    pegs (31 mm²): the inner skirt starts at the walking surface instead of a
    hair below it, which had left a 2 mm ledge all round (1386 mm²).
    - export/sketchup/e2_ages.dae and e2_ages_exploded.dae.
    - Renders refreshed; e2-design §10.2 updated (surface R 108-134).
    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
    [age_cam.stl, ages_bell_bracket.stl, back_wall.stl, bell_finger.stl, deck.stl, floor_front.stl, floor_island.stl, floor_post_0.stl]
2026-11-06 E2: the stop fingers are swung by a program cam on the walk train (Paul, option A)
    Recorded in e2-design §9.7 and §10.7: one cam turn per show through a 1:5
    pair, a rocker and two rods to the fingers, two lock notches; a Hall at the
    bell station with a magnet in each age's base says whether an age was caught.
    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
2026-11-06 E2 part 2a (WIP): one stop shaft with two arms, waiting pegs, the program's phases
    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
2026-11-06 E2 part 2a (WIP): two geared stop shafts, the walk drive and the state module in CAD
    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
2026-11-06 E2 part 2a (WIP): tests, print poses, renders
    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
2026-11-06 E2 part 2a (WIP): design doc §11, BOM rows, timing
    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
2026-11-06 E2 part 2a: print files, SketchUp models and renders
    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
    [age_cam.stl, bell_arm.stl, bell_collar.stl, bell_finger.stl, bell_hall_post.stl, bell_sleeve.stl, deck.stl, floor_post_0.stl]
2026-11-06 E2 part 2a: record Paul's decisions (two geared stop shafts, 45° changes, depth left for the case)
    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
2026-11-07 E1 genies: concept gate (design doc, schematic, README row)
    The bell genie (A1) and the hourglass genie (A2): what is known, sizes
    scaled on Paul's photograph, interfaces with E2, M1b and the controller,
    a proposed concept (two cassettes; a spring-flicked sceptre on a hand
    bell; a Scotch yoke, rack and pinion for the alternating half turn),
    and the decisions needed from Paul.
    Claude-Session: https://claude.ai/code/session_01TndywAteD24bxG9fYAHRYd
2026-11-07 Phase 3 gate: firmware and simulator design (docs/firmware-design.md)
    - Controller hardware: ESP32-S3 resources and pin plan, carrier-PCB options,
    TMC2209 on two UART buses, event motors via PCA9685 + DRV8833, three
    MCP23017, RTC/FRAM, power rails and hold-up, connectors per module.
    - Firmware structure: tasks and timing, one integer time law for every
    stepper, forward-only follower, event-motor state machines, the show
    chain in DA's order, E6, quiet hours, summer time, setting, homing,
    catch-up, motor-phase restore, faults, MQTT/Home Assistant, OTA.
    - Simulator plan and ephemeris checks with error budgets; host test
    strategy; decisions F1-F10 for Paul.
    - sim/probe_v1_deviations.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
2026-11-07 M5, M6, M7: concept gates for review
    Three concept docs (planetary dial and Moon globe, celestial globe,
    weekday carousel) with schematics, interfaces, options and the
    decisions needed. Finds that the accepted planetarium Moon epicyclic
    turns backwards as written; an idler fixes it without changing the
    ratio. README documents table updated.
    Claude-Session: https://claude.ai/code/session_01TndywAvWa4UGm2xiTEJetG
2026-11-07 E2 part 2b (WIP): strike shafts, cams, gears, gearmotors, plates, guards, switches and home optos
    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
2026-11-07 E2 part 2b (WIP): rack springs, weighted hooks and pawls, tests, design doc and BOM rows
    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
2026-11-07 E2 part 2b (WIP): print poses; racks, hooks and pawls on the 0.2 mm nozzle
    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
2026-11-07 E2 part 2b: print files, SketchUp models and renders
    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
    [age_cam.stl, hour_feed_lever.stl, hour_lifter_cam.stl, hour_motor_plate.stl, hour_rack.stl, hour_release_lever.stl, hour_snail.stl, hour_spring_anchor.stl]
2026-11-08 E1: record Paul's first-round decisions; one-motor concept and two new questions
    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
2026-11-08 Phase 3 gate: record Paul's decisions (F2-F10 accepted, F1 open)
    - firmware-design.md §14: statuses; F1 left open (PCB or perfboard,
    bench prototype first).
    - decisions.md: one "D-next (firmware)" record and summary row.
    - bom.md: Batch 2 controller rows (MCP23017 x3, PCA9685, DRV8833 x5,
    6 V buck, RV-3028-C7, FRAM, DRV5032FC, power-fail parts, connectors).
    - README: Phase 3 status.
    Claude-Session: https://claude.ai/code/session_01TndywB4JtJipQa56SG1kqm
2026-11-08 Phase 3 gate: F1 accepted (KiCad carrier PCB); E2 part 2b changes
    - F1: a carrier PCB drawn in KiCad after the bench prototype (Paul, chat).
    §3.2 now explains what making it involves and compares small-batch
    makers (Aisler recommended; to verify when ordering).
    - E2 (PR #21): two rack home optos (inputs 31 in v1, 37 by v2); the
    counting trains stop on home opto then lock; racks left down after a
    silent walk need nothing; Death is silent whenever the ages are, so
    quiet hours treat E2 as one class.
    - decisions.md, bom.md, README follow.
    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
2026-11-08 Firmware core and host tests (Phase 3, step 1)
    - firmware/core: the time law (integer, mean and legal time, J), EU
    summer time with a freeze setting, the forward-only follower, the
    event-motor state machine (counting trains: home opto then lock),
    E6's night with the cap at four, the legal-time quarter schedule,
    quiet hours, the E2 ring ages, the show chain in DA's order, and the
    FRAM record with CRC-32 and two slots.
    - firmware/hal: the interfaces the core is driven through.
    - firmware/tests: a minimal harness, fake trains and 33 host test cases;
    test_host.py builds them with g++/clang++, checks the C++ law against
    sim/timelaw.py and the summer-time rule against zoneinfo to 210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
2026-11-08 M5, M6, M7: measurements from Paul's photographs; Bordeaux mean time decision
    - decisions.md: D-next (M5-M7), Bordeaux mean time for the whole clock (revises D2 items 1, 5)
    - M7: chariot sizes and carousel radius (R about 100 mm) from IMG_0766; phase offset now zero
    - M5: planets identified by their mean longitudes on the photo date; orbit radii, Sun, central
    disc; proposes A', the central disc as the Earth's drum, since the measured radii put Mercury
    and Venus inside the accepted fixed wheel
    - M6: ring and column sizes; proposes the meridian square to the facade, as the original
    - reference-notes: summary of the photographs; small crops in docs/img/m5, m6, m7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
2026-11-08 E1: second-round decisions (count wheel, rigid cross shaft); count-wheel concept; merge main
    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
2026-11-08 E2 part 2b: the walk train releases the racks (Paul, PR #21, decision 1)
    - The state-arbor release cams and release levers are gone.
    - A grooved release disc under the walk's program shaft rocks a new
    quarter release shaft in phase A (program 30-115 deg, pressure angle
    25 deg); its arm pushes the quarter hook's weighted tail out.
    - A pin in the quarter rack lifts the new hour trip shaft only past three
    pairs; its arm B pushes a tab on the hour hook. Death is silent
    whenever the ages are.
    - Tests: the release window inside phase A, each hook turned clear, the
    trip only at the fourth quarter and its rest bias, the moving parts
    clear of everything.
    - Docs: e2-design 4.5 and 12 (deci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
2026-11-08 E2 part 2b: check the hooks' release clearance over the riding range and when pushed out
    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
    [test_e2.py]
2026-11-08 E2 resync: one silent walk, whatever age waits (PR #21)
    - schedule.h: resync_turns() replaced by kResyncTurns = 1; the age cam
    stops the walk on the due age for all 16 waiting/due pairs
    (e2-design §10.3).
    - show_chain.h: the hour train and its home opto are used only at :00.
    - firmware-design.md §7.5, §9.4, §13 item 2 follow; FRAM's ring age is
    for the log only.
    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
    [persist.h, schedule.h, show_chain.h, test_time.cpp]
2026-11-08 E2 part 2b: a round Ø2 pin follows the release groove (a long nub rubbed its sloped walls)
    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
    [strikers.py, striking.py, test_e2.py]
2026-11-08 E2 part 2b: print files, SketchUp models and renders for the walk-train release
    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
    [hour_hook.stl, hour_release_lever.stl, hour_trip_arm_a.stl, hour_trip_arm_b.stl, quarter_motor_plate.stl, quarter_rack.stl, quarter_release_arm.stl, quarter_release_follower.stl]
2026-11-08 E1: record Paul's choice for the count wheel's make-up strokes (15.4 B)
    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
2026-11-08 E1 detail design part 1: count-wheel trains, the strike, the glass drive
    One forward-only gearmotor in the bell tower; a 1:20 count wheel gives the hour's
    ten strokes and then ten silent turns, in which a mutilated gear turns a cross
    shaft behind M1 and a Scotch yoke, rack and pinion turn the glass half a turn.
    Tests, print files, SketchUp files (with an exploded view), BOM rows, an
    architecture note and a D-next (E1) record.
    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
    [bell_lock_cam.stl, bell_pinion_12.stl, count_wheel_60.stl, coupling_bell.stl, coupling_left.stl, crank.stl, cross_gear_36.stl, detent_disc.stl]
2026-11-08 E1: fold the gearmotor inside the bell tower (Paul, PR #23)
    The gearmotor now lies along X above the plates' top edge, behind the plinth, in a
    saddle, and drives the bell shaft through a 20/20 pair. The module is 39 mm
    narrower and no deeper. Tests, exports, renders, doc and BOM rows updated.
    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
    [bell_drive_gear_20.stl, coupling_bell.stl, gearmotor_bracket.stl, motor_pinion_20.stl, tower_pillars.stl]
2026-11-08 E1: record Paul's §16.8 decision 2 (keep the glass tower's single plate)
    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
2026-11-08 Record Paul's approval: the sketch and board layer move to step 1b (PR #22)
    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
