paulforrester/horloge-astronomique/docs/img/photos/IMG_0762.jpeg

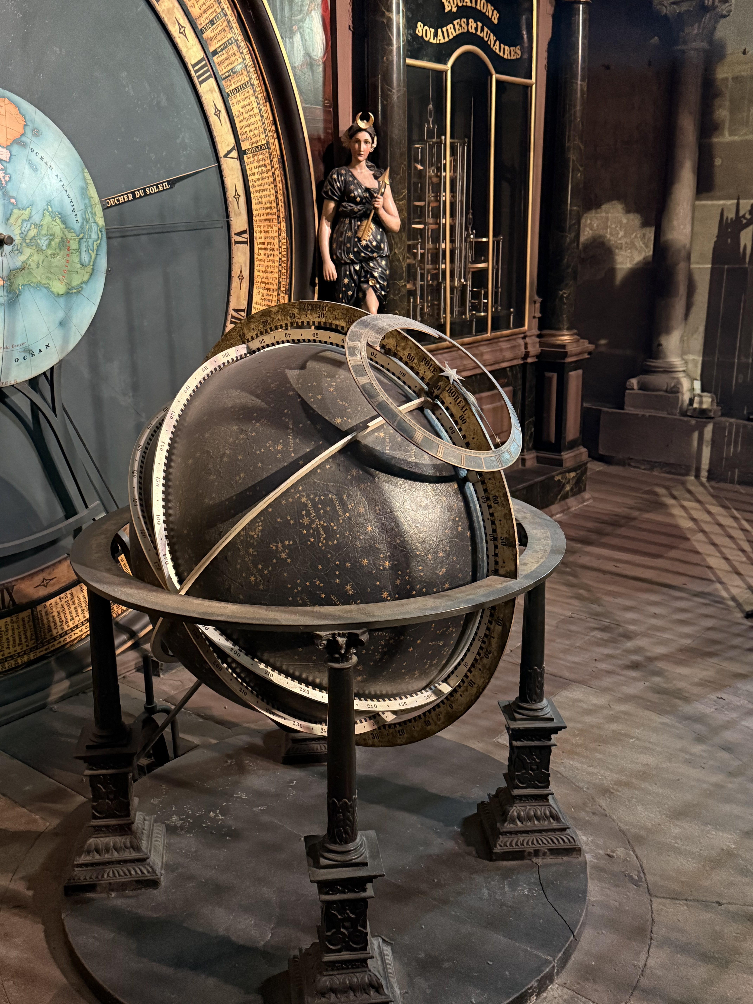
docs/img/photos/IMG_0762.jpeg
