paulforrester/horloge-astronomique/docs/img/photos/IMG_0763.jpeg

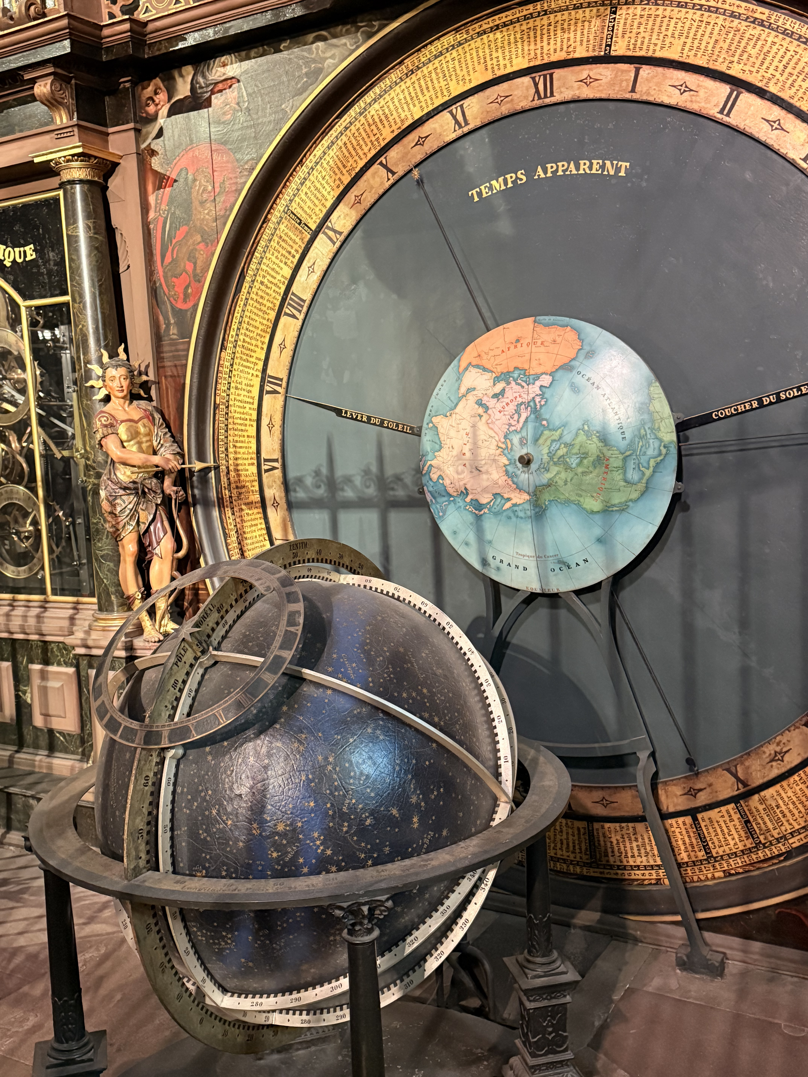
docs/img/photos/IMG_0763.jpeg
