paulforrester/horloge-astronomique/docs/img/photos/IMG_0764.jpeg

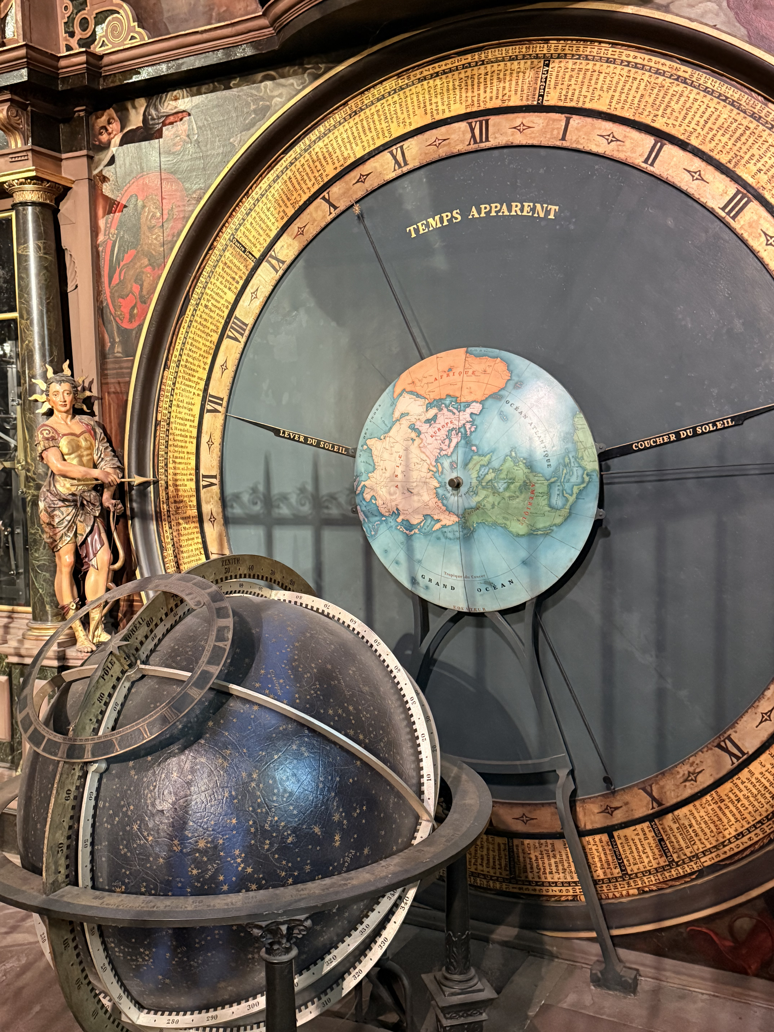
docs/img/photos/IMG_0764.jpeg
