paulforrester/horloge-astronomique/docs/img/photos/IMG_0766.jpeg

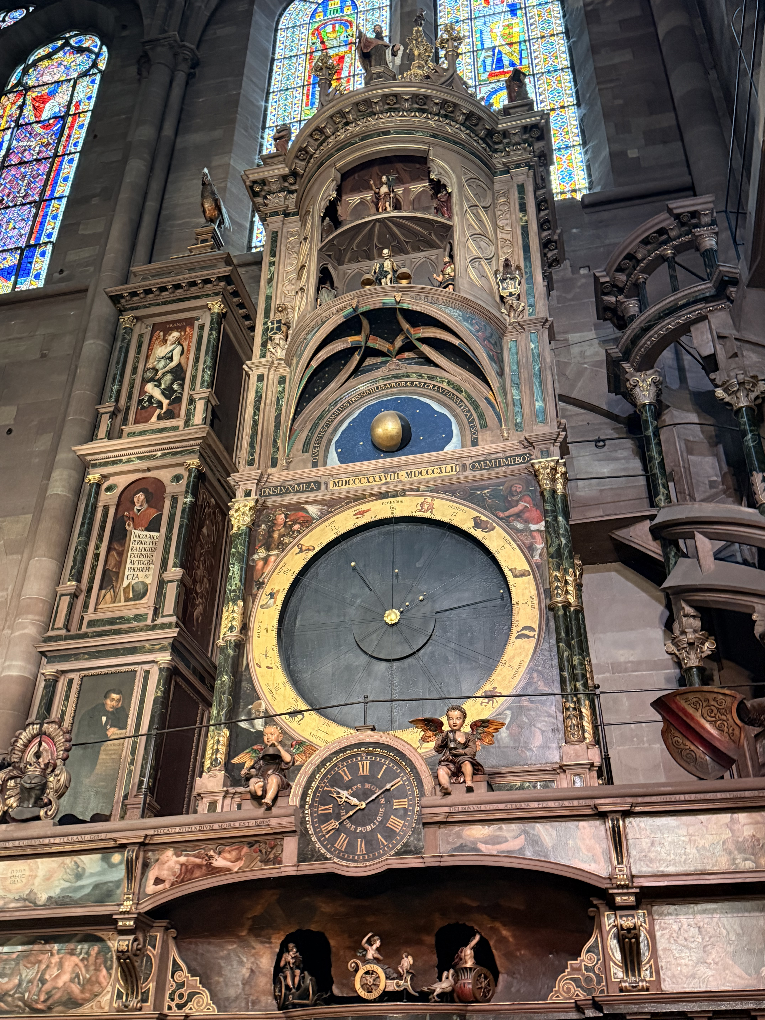
docs/img/photos/IMG_0766.jpeg
